camthink-ai/ne302/Docs/images/README.md

# Image Assets for README

Place the following images in this directory. See [../README.md](../README.md) for usage context.

## Required Images (12 files)

| # | Filename | README Section | Content |
|---|---|---|---|
| 1 | `mini_all_board_1.png` | Hero / Top | Product overview — Main Board + Interface Board |
| 2 | `mini_all_board_2.png` | Hardware Features | Two boards shown side-by-side |
| 3 | `mini_main_board_1.png` | Main Board | Main Board front |
| 4 | `mini_main_board_2.png` | Main Board | Main Board back |
| 5 | `mini_main_board_labeling_1.png` | Main Board | Main Board front with component callouts |
| 6 | `mini_main_board_labeling_2.png` | Main Board | Main Board back with component callouts |
| 7 | `mini_interface_board_1.png` | Interface Board | Interface Board front |
| 8 | `mini_interface_board_2.png` | Interface Board | Interface Board back |
| 9 | `mini_interface_board_labeling_1.png` | Development Interfaces | Interface Board pinout labels (N6-STLINK, U0-STLINK, U6-UART, N6-BOOT, U0-BOOT) |
| 10 | `mini_interface_board_labeling_2.png` | Storage | Interface Board TF Card, USB-C, Board Connector callouts |
| 11 | `mini_all_board_connect_3.png` | Board Assembly | Stacked boards — top view |
| 12 | `mini_all_board_connect_4.png` | Board Assembly | Stacked boards — 45° view |
