camthink-ai/ne302/Docs/NE302_v4.3.1_HTTP_API.md

# NE302 HTTP API Reference

| Item | Value |
|---|---|
| **Firmware version (APP)** | **v4.3.1.x** (build number increments per commit) |
| Document date | 2026-09-14 |
| Source | Verified against `Custom/Services/Web/` and related implementation in the current workspace; examples and latency figures taken from a reference device |

> If the firmware differs from this description, the firmware implementation prevails.

## 0. Software Version Information

| Component | Version | Notes |
|---|---|---|
| APP (main firmware) | 4.3.1.x | auto-generated in `Custom/Common/Inc/version.h` (build number = commit count since the `v4.3.1-base` tag) |
| FSBL (first-stage bootloader) | 1.0.3.1 (expected) | `EXPECTED_FSBL_VERSION_STRING`; actual compared at runtime |
| WiFi / Si91x firmware | 2.16.5.108 (expected) | `EXPECTED_WIFI_VERSION_STRING`; actual compared at runtime |
| Web assets (frontend) | 1.5.0.8 | shipped with the release bundle; query at runtime via `/device/firmware-versions` |
| AI model package | 4.0.0.0 | same |
| WakeCore | 0.2.7.5 | same |

At runtime, `GET /api/v1/device/firmware-versions` returns the **actual running versions** of every component, and `GET /api/v1/device/version-check` reports whether FSBL/WiFi firmware match what the APP expects.

---

## 1. General Conventions

### 1.1 Service & Base URL

| Item | Value |
|---|---|
| HTTP service | Mongoose, listening on **TCP port 80** |
| HTTPS | Disabled (`IS_HTTPS=0`) |
| API base path | **`/api/v1`** |
| Max request body | 5 MB (normal requests through the router) |
| Connection | `Connection: close`, one request per connection |
| Static assets | Web UI served from `/` (ETag/304/gzip supported) |

Device address:
- STA / Ethernet mode: the IP obtained by the device (check the router/AP)
- AP mode: the device hotspot gateway address (default `192.168.10.10`, subnet `192.168.10.0/24`; the built-in DHCP server allocates from `192.168.10.100`–`192.168.10.250`. Subject to actual device configuration)

**Typical latency** (reference values, reference unit at rest): ordinary read-only GETs **13–40 ms**; heavier endpoints such as `capture/queue` ≈ 0.4 s, `system/logs/export` ≈ 1.2 s (354 KB), `device/config/export` ≈ 0.1 s. The first request after an idle period may take several hundred milliseconds.

### 1.2 Authentication

- **HTTP Basic auth** per request; no sessions/cookies.
- Username is fixed to **`admin`** (`auth_mgr.h: AUTH_ADMIN_USERNAME`); the password is the device access password.
- The password can be verified via `POST /api/v1/login` and changed via `POST /api/v1/change-password`.

**Unauthenticated endpoints** (route table `require_auth=false`):

| Endpoint | Purpose |
|---|---|
| `POST /api/v1/login` | password verification |
| `POST /api/v1/preview/start` | start preview |
| `POST /api/v1/preview/stop` | stop preview |

> Note: `POST /api/v1/system/ota/upload` is intercepted by the stream processor before route dispatch and handles auth itself — see §16.2.

**Auth failure response** (normal endpoints): HTTP status is still **200** with envelope `error_code: "UNAUTHORIZED"`, `message: "Authentication required"`. The stream upload endpoints (`files/upload`, `ota/upload`) are exceptions and return a real `401`.

### 1.3 Unified Response Envelope

All endpoints routed through the router return **HTTP 200 regardless of success or failure**, with a JSON envelope:

```jsonc
// success
{
  "success": true,
  "message": "Device information retrieved successfully",   // optional
  "data": { ... }                                            // optional
}

// failure
{
  "success": false,
  "error_code": "INVALID_PASSWORD",   // present only on failure
  "message": "Invalid password"
}
```

| Field | Type | Notes |
|---|---|---|
| success | bool | business outcome |
| error_code | string | present only on failure; upper-snake-case name (see 1.5). The streamed endpoints (`files/upload`) also carry `"error_code": "NONE"` on success |
| message | string | human-readable description; may appear on success too |
| data | object/array/null | business payload; may be absent |

> **Clients must branch on the `success` field — never on the HTTP status code.**

### 1.4 Envelope Exceptions (real HTTP statuses / non-JSON)

| Endpoint | Response form |
|---|---|
| `GET /api/v1/files/download` | raw file bytes + `Content-Disposition: attachment; filename="…"`; missing file returns envelope JSON (`NOT_FOUND`) with HTTP 200 |
| `GET /api/v1/files/preview` | raw bytes for images (≤2 MB); any other file type returns a JSON envelope with the content embedded — there is no extension whitelist on preview (the whitelist applies only to `files/edit`) |
| `POST /api/v1/files/upload` | streamed; auth failure **401**, missing params 400, internal 500/503 (real statuses) |
| `POST /api/v1/system/ota/upload` | streamed; real statuses 400/401/500 |
| `POST /api/v1/system/ota/export` | raw firmware bytes + `Content-Disposition` |
| `/` static assets | SPA fallback: unknown paths return **200 + `index.html`** (no 404); re-request with the correct `ETag` returns 304 |
| `OPTIONS` preflight | 200 + CORS headers |

### 1.5 Error Codes

#### 1.5.1 Framework codes (web_server.h `api_error_code_t`)

| HTTP semantic | error_code string | Trigger |
|---|---|---|
| 400 | `INVALID_REQUEST` | missing/invalid parameters, JSON parse failure, wrong Content-Type |
| 401 | `UNAUTHORIZED` | Basic auth failure |
| 404 | `NOT_FOUND` | path not registered |
| 405 | `METHOD_NOT_ALLOWED` | method mismatch (method match is case-insensitive) |
| 500 | `INTERNAL_ERROR` | internal error |
| 503 | `SERVICE_UNAVAILABLE` | required service not running (e.g. `fs=sd` without an SD card, cellular endpoints without a modem) |

#### 1.5.2 Business codes (api_business_error.h, from 1001)

| Code | error_code string | Meaning |
|---|---|---|
| 1001 | `INVALID_PASSWORD` | invalid password |
| 1002 | `INVALID_CREDENTIALS` | invalid username or password |
| 1003 | `UNAUTHORIZED` | unauthorized |
| 1004 | `SESSION_EXPIRED` | session expired |
| 1005 | `TOKEN_INVALID` | invalid token |
| 1007 | `PERMISSION_DENIED` | permission denied |
| 1101 | `INVALID_PARAM` | invalid parameter |
| 1102 | `MISSING_PARAM` | missing required parameter |
| 1103 | `PARAM_OUT_OF_RANGE` | parameter out of range |
| 1104 | `INVALID_FORMAT` | invalid data format |
| 1201 | `DEVICE_OFFLINE` | device offline |
| 1202 | `DEVICE_BUSY` | device busy |
| 1204 | `CAMERA_ERROR` | camera error |
| 1206 | `HARDWARE_ERROR` | hardware error |
| 1301 | `NETWORK_ERROR` | network error |
| 1302 | `NETWORK_TIMEOUT` | network timeout |
| 1304 | `MQTT_NOT_CONNECTED` | MQTT not connected |
| 1305 | `WIFI_NOT_CONNECTED` | WiFi not connected |
| 1401 | `STORAGE_FULL` | storage full |
| 1403 | `FILE_NOT_FOUND` | file not found |
| 1407 | `INSUFFICIENT_SPACE` | insufficient storage space |
| 1408 | `DIR_NOT_EMPTY` | directory not empty (cannot delete) |
| 1501 | `MODEL_NOT_LOADED` | AI model not loaded |
| 1502 | `MODEL_INVALID` | invalid AI model |
| 1503 | `MODEL_RELOAD_FAILED` | model reload failed |
| 1505 | `INFERENCE_TIMEOUT` | inference timeout |
| 1601 | `CONFIG_INVALID` | invalid configuration |
| 1602 | `CONFIG_NOT_FOUND` | configuration not found |
| 1604 | `CONFIG_UPDATE_FAILED` | configuration update failed |
| 1701 | `OPERATION_TIMEOUT` | operation timeout |
| 1702 | `OPERATION_FAILED` | operation failed |
| 1705 | `OPERATION_IN_PROGRESS` | operation already in progress (busy) |
| 1706 | `AT_COMMAND_FAILED` | AT command failed (cellular modem) |
| 1801 | `FIRMWARE_INVALID` | invalid firmware |
| 1804 | `OTA_IN_PROGRESS` | OTA upgrade in progress |
| 1805 | `OTA_FAILED` | OTA upgrade failed |
| 1806 | `OTA_HEADER_VALIDATION_FAILED` | OTA/bundle header validation failed |
| 1901 | `RESOURCE_NOT_FOUND` | resource not found |
| 1902 | `RESOURCE_BUSY` | resource busy |
| 2001–2008 | `ISP_*` (see §17) | ISP business errors (2001 not initialized / 2002 invalid param / 2003 out of range / 2004 dependency / 2005 HAL / 2006 sensor / 2007 algorithm / 2008 busy) |
| 9999 | `UNKNOWN` | unknown error |

### 1.6 CORS & Preflight

All responses carry CORS headers; `OPTIONS` preflight is answered directly with 200 without entering business routing:

```
Access-Control-Allow-Origin: *
Access-Control-Allow-Methods: GET, POST, PUT, DELETE, OPTIONS
Access-Control-Allow-Headers: Content-Type, Authorization
Access-Control-Max-Age: 86400
```

### 1.7 Live Preview Stream (WebSocket, not part of the HTTP API)

The preview stream runs on a separate WebSocket service: **`ws://<device-ip>:8081/stream`** (default port 8081, path `/stream`). See [Appendix B](#appendix-b-websocket-preview-stream).

---

## 2. Endpoint Overview

15 modules, ~140 endpoints, all under `/api/v1`. All require Basic auth unless marked "no auth". All network-management endpoints are registered under the **`/api/v1/system/network/…`** prefix.

| # | Module | Prefix | Endpoints |
|---|---|---|---|
| 3 | Authentication | `/login`, `/change-password` | 2 |
| 4 | Device & system | `/device/*`, `/system/*` | 21 |
| 5 | Network | `/system/network/*` (wifi / halow / comm / cellular / poe) | 44 |
| 6 | Capture & upload | `/capture/*` | 6 |
| 7 | Live preview | `/preview/*` (no auth) | 2 |
| 8 | File management | `/files/*` | 8 |
| 9 | AI detection | `/ai/*` | 4 |
| 10 | Model management | `/model/*` | 2 |
| 11 | Work mode / power mode | `/work-mode/*`, `/power-mode/*` | 8 |
| 12 | MQTT | `/apps/mqtt/*`, `/device/capture` | 5 |
| 13 | RTMP streaming | `/apps/rtmp/*` | 5 |
| 14 | RTSP service | `/apps/rtsp/*` | 5 |
| 15 | Webhook | `/apps/webhook/*` | 6 |
| 16 | Firmware upgrade (OTA) | `/system/ota/*` | 7 |
| 17 | ISP image quality | `/isp/*` | 27 |
| — | Static assets / Web UI | `/` | — |

> The 12 HaLow endpoints are registered only when the firmware is built with HaLow enabled (`NETIF_WIFI_HALOW_IS_ENABLE`); this build has it enabled.

---

## 3. Authentication Module (auth)

### 3.1 POST /api/v1/login — verify device password

**No auth.** Used by the login page to verify the password (username is fixed `admin` and not sent).

**Request body**

| Field | Type | Required | Description |
|---|---|---|---|
| password | string | yes | device access password |

**Responses**

```jsonc
// correct password
{"success": true, "message": "Login successful"}
// wrong password, missing field or wrong JSON type
{"success": false, "error_code": "INVALID_PASSWORD", "message": "Login failed, invalid password"}
// wrong Content-Type
{"success": false, "error_code": "INVALID_REQUEST", "message": "Invalid Content-Type"}
```

### 3.2 POST /api/v1/change-password — change device password

**Request body**

| Field | Type | Required | Description |
|---|---|---|---|
| password | string | yes | new password, **8–32 characters** |

**Response data**: `null`, `message: "Password changed successfully"`.

**Notes**: takes effect immediately — subsequent requests (both login and Basic auth) must use the new password; the old password fails at once.

**Errors**: `INVALID_REQUEST` ("Invalid password length" for out-of-range length, "Missing required parameters" when absent).

---

## 4. Device & System Module (device / system)

### 4.1 GET /api/v1/device/info — device information

**Response data**

| Field | Type | Description |
|---|---|---|
| device_name | string | device name (1–63 characters, see 4.6) |
| mac_address | string | MAC address |
| serial_number | string | serial number |
| hardware_version | string | hardware version |
| software_version | string | software version (the APP firmware version) |
| camera_module | string | camera module |
| extension_modules | string | extension modules |
| power_supply_type | string | power supply type |
| battery_percent | number | battery percentage |
| communication_type | string | current communication type |
| storage_card_info | string | storage card info |
| storage_usage_percent | number | storage usage (%) |

**Example**

```json
{"success":true,"message":"Device information retrieved successfully","data":{
  "device_name":"NE302-278C51","mac_address":"44:9f:da:27:8c:51","serial_number":"SN202500001",
  "hardware_version":"1.3.0","software_version":"4.3.1.107","camera_module":"CMW_OS04C10",
  "extension_modules":"None","power_supply_type":"external_power","battery_percent":0,
  "communication_type":"wifi","storage_card_info":"No SD Card","storage_usage_percent":9}}
```

### 4.2 GET /api/v1/device/firmware-versions — component firmware versions

**Response data**

| Field | Type | Description |
|---|---|---|
| fsbl | string | actual running FSBL version |
| app | string | actual running APP version |
| web | string | web asset version |
| model | string | AI model package version |
| wakecore | string | WakeCore version |
| wifi | string | Si91x WiFi/HaLow firmware version |
| wifi_running | string | WiFi firmware running-state marker |
| expected_fsbl | string | FSBL version expected by the APP |
| expected_wifi | string | WiFi firmware version expected by the APP |

**Example**

```json
{"fsbl":"1.0.3.1","app":"4.3.1.107","web":"1.5.0.8","model":"4.0.0.0","wakecore":"0.2.7.5",
 "wifi":"2.16.5.108","wifi_running":"2.16.5.108","expected_fsbl":"1.0.3.1","expected_wifi":"2.16.5.108"}
```

### 4.3 GET /api/v1/device/version-check — FSBL/WiFi version consistency

**Response data**

| Field | Type | Description |
|---|---|---|
| fsbl_mismatch | bool | FSBL actual ≠ expected |
| wifi_mismatch | bool | WiFi firmware actual ≠ expected |
| expected_fsbl / current_fsbl | string | expected / actual FSBL version |
| expected_wifi / current_wifi | string | expected / actual WiFi firmware version |

### 4.4 GET /api/v1/device/storage — storage information

**Response data** (SD card + flash partitions)

| Field | Type | Description |
|---|---|---|
| sd_card_connected | bool | SD card present |
| total_capacity_mb / available_capacity_mb / used_capacity_mb | number | SD capacity (MB) |
| usage_percent | number | SD usage (%) |
| total_capacity_gb / available_capacity_gb / used_capacity_gb | number | SD capacity (GB) |
| cyclic_overwrite_enabled | bool | cyclic overwrite switch |
| overwrite_threshold_percent | number | overwrite threshold (%) |
| flash_fs_mounted | bool | flash filesystem mounted |
| flash_fs_error | bool | flash filesystem error |
| flash_error | string | flash error description |
| flash_total_capacity_mb / flash_available_capacity_mb / flash_used_capacity_mb | number | flash capacity (MB) |
| flash_usage_percent | number | flash usage (%) |
| flash_total_capacity_gb / flash_available_capacity_gb / flash_used_capacity_gb | number | flash capacity (GB) |
| flash_fs_type | string | flash filesystem type (littlefs) |
| status | string | storage status summary |
| primary_storage | string | primary storage (sd / flash) |

**Example** (no SD card):

```json
{"sd_card_connected":false,"total_capacity_mb":0,"available_capacity_mb":0,"used_capacity_mb":0,
 "usage_percent":0,"total_capacity_gb":0,"available_capacity_gb":0,"used_capacity_gb":0,
 "cyclic_overwrite_enabled":true,"overwrite_threshold_percent":80,"flash_fs_mounted":true,
 "flash_fs_error":false,"flash_error":"","flash_total_capacity_mb":32,"flash_available_capacity_mb":28,
 "flash_used_capacity_mb":4,"flash_usage_percent":12.5,"flash_total_capacity_gb":0.03,
 "flash_available_capacity_gb":0.03,"flash_used_capacity_gb":0.004,"flash_fs_type":"littlefs",
 "status":"normal","primary_storage":"flash"}
```

### 4.5 POST /api/v1/device/storage/format — format internal flash

**Request body**: none (any body is ignored; there is no target selection — the endpoint **always formats the internal flash LittleFS volume**).

**Response data**: `{success}` with message `"Flash formatted"` — the operation is synchronous (a few hundred ms). Formatting erases all flash files (logs, captures, uploaded assets); NVS device configuration is stored in a separate partition and is **not** affected. Afterwards the captures tree is rebuilt and record counters are reset; re-fetch `/device/storage` and `/capture/queue`.

### 4.6 POST /api/v1/device/name — rename device

**Request body**: `{device_name: string}` (**1–63 characters**; empty or oversized → `INVALID_REQUEST`).

**Response data**: `{message, device_name}`.

### 4.7 GET / POST /api/v1/device/image/config — image configuration

GET returns the current config; POST is a partial update (send only changed fields).

**Fields** (GET returns / POST optional)

| Field | Type | Range/values | Description |
|---|---|---|---|
| brightness | number | 0–100 | ⚠ **Deprecated** — accepted but not applied (see note below) |
| contrast | number | 0–100 | ⚠ **Deprecated** — accepted but not applied (see note below) |
| horizontal_flip | bool | — | horizontal flip |
| vertical_flip | bool | — | vertical flip |
| aec | number | 0–100 | ⚠ **Deprecated** — accepted but not applied (see note below) |
| isp_mode | number | 0 (outdoor) / 1 (indoor) / 255 (custom) | ISP scene mode |
| grayscale | bool | — | grayscale output |
| fast_capture_skip_frames | number | 0–300 | fast-capture skip frames |
| fast_capture_resolution | number | 0 (1280×720) / 1 (1920×1080) / 2 (2688×1520) | fast-capture resolution |
| fast_capture_jpeg_quality | number | 1–100 | fast-capture JPEG quality |
| capture_disable_comm | bool | — | pause communication during capture |
| capture_storage_ai | bool | — | store AI-overlay capture images |

**⚠ Deprecated fields**: `brightness`, `contrast` and `aec` are deprecated. Requests carrying them still succeed (the values are range-checked and echoed in the response), but the settings are **not applied and not retained** — adjusting them has no effect on the image. Use the ISP module (§17) to control exposure/contrast instead.

**Notes**: POST of `horizontal_flip`/`vertical_flip` automatically restarts the AI pipeline (stop then start); POST-then-GET to confirm the applied values is recommended.

### 4.8 GET / POST /api/v1/device/sys-clk/config — CPU clock profile

Persisted by FSBL; **takes effect after reboot**.

**GET response data**

| Field | Type | Description |
|---|---|---|
| valid | bool | whether the config read out validly |
| sys_clk_profile | number | current clock profile |

**POST request body**

| Field | Type | Required | Description |
|---|---|---|---|
| sys_clk_profile | number | yes | 1=HSE 200 MHz, 2=HSE 400 MHz, 3=HSI 800 MHz, 4=HSE 800 MHz (integer only) |

### 4.9 GET / POST /api/v1/device/light/config — fill light configuration

**GET response data**

| Field | Type | Description |
|---|---|---|
| connected | bool | fill light connected |
| mode | string | `off` / `on` / `auto` / `custom` |
| brightness_level | number | brightness 0–100 |
| fill_light_while_streaming | bool | work-time fill light mode (light on unconditionally per config while the device runs) |
| custom_schedule | object | timed-on schedule `{start_hour, start_minute, end_hour, end_minute}` |

**POST request body** (all optional)

| Field | Type | Description |
|---|---|---|
| mode | string | `off`/`on`/`auto`/`custom` |
| brightness_level | number | 0–100 |
| fill_light_while_streaming | bool | as above |
| custom_schedule | object | same as GET |

**Response data**: echoes the applied configuration.

### 4.10 POST /api/v1/system/time — set system time

**Request body**

| Field | Type | Required | Description |
|---|---|---|---|
| timestamp | number | no | UTC epoch seconds; when omitted, the current system time is retained |
| timezone | string | no | timezone name (`Asia/Shanghai`, `America/New_York`, `America/Los_Angeles`, `Europe/London`, `Europe/Paris`, `Asia/Tokyo`) or `UTC±N` |

**Response data**: `{message, utc_timestamp, local_timestamp, timezone_offset_hours, utc_time, local_time}`

**Example**

```json
{"message":"System time updated successfully","utc_timestamp":1789394898,
 "local_timestamp":1789423698,"timezone_offset_hours":8,
 "utc_time":"2026-09-14 14:08:18 UTC","local_time":"2026-09-14 22:08:18"}
```

**Notes**: the device also syncs time via SNTP/U0; the web path goes through the RTC scheduler (with step guards). Unsupported timezone names are rejected with `INVALID_REQUEST`. There is no GET on this path.

### 4.11 GET /api/v1/system/logs — read logs

**Query params**: `file` (log file name, optional, default main log `aicam.log`)

**Response data**: `{content (log text), size}`; for the file-level list see 4.12.

### 4.12 GET /api/v1/system/logs/export — export logs

**Response data**: `{log_files: [{filename, size, content}], total_files, total_size}` — the rotated set `aicam.log`, `aicam.log.1` … is returned in full (a multi-hundred-KB response; allow several seconds).

### 4.13 POST /api/v1/system/restart — restart device

**Request body**: `{delay_seconds?: number}` (default 3)

**Response data**: `{delay_seconds}` (executed asynchronously by a background task). The web service typically answers again **~25 s** after the restart (bootloader ~1 s, system bring-up ~5 s, service start thereafter).

### 4.14 GET /api/v1/device/config/export — export device configuration

**Response data**

| Field | Type | Description |
|---|---|---|
| export_version | string | export format version |
| export_timestamp | number | export timestamp |
| config | object | structured config (per module: network_service, mqtt_service, work_mode_config, power_mode_config, auth_mgr, …) |
| config_raw | string | raw config text |

`config.sys_clk_profile` (work frequency, 1–4) is attached only when the device has a real selection; a never-modified device (profile 0) omits the key.

**Example** (structure overview; `config` contains one section per service):

```json
{"export_version":"1.0","export_timestamp":1789440008,
 "config":{"config_version":1,"magic_number":"...","checksum":"...","timestamp":"...",
           "log_config":{...},"ai_debug":{...},"power_mode_config":{...},"device_info":{...}, ...}}
```

### 4.15 POST /api/v1/device/config/import — import device configuration

**Request body**: the `data` exported by 4.14 as-is (or just the `config` object).

**Response data**: `{message, config_version, timestamp, checksum, saved_to_file}` — applying and persisting a full config takes a few seconds.

**Errors**: body without `config`/`config_raw` → `INVALID_REQUEST`; `sys_clk_profile` present with anything other than an integer 0–4 (negative, fractional, out of range, or non-numeric) → `INVALID_REQUEST`.

`config.sys_clk_profile` absent or 0 keeps the device's current work frequency; 1–4 is applied through the same FSBL path as the dedicated setter (effective on next boot).

### 4.16 GET / POST /api/v1/device/preference/stream_tab — Web UI preference

**GET response data**: `{stream_tab: string}` (the stream tab remembered by the frontend)
**POST request body**: `{stream_tab: string}` — the POST response `data` is empty; verify via GET.

---

## 5. Network Module (network)

All endpoints are registered under **`/api/v1/system/network/…`**. The WiFi configuration endpoint additionally accepts the short alias `POST /system/network/wifi`.

### 5.1 GET /api/v1/system/network/status — communication overview

**Response data**

| Field | Type | Description |
|---|---|---|
| service_state | string | communication service state |
| service_version | string | service version |
| active_type | string | currently active comm type (wifi/cellular/poe/halow…) |
| selected_type | string | selected type |
| current_comm_type | string | current comm type |
| has_connection | bool | any usable connection |
| active_display_name / selected_display_name / current_comm_display_name | string | display names |
| available_comm_types | array | `[{type, display_name, is_selected, is_active, is_connected, is_current}]` |
| available_comm_count | number | number of available types |
| preferred_type | string | preferred type |
| auto_priority | bool | automatic priority selection |
| is_auto_selection | bool | automatic selection mode |
| selection_mode | string | selection mode |
| current_comm_info | object | `{status, ip_address, signal_strength, ssid?, isp?, message}` |

**Example** (abridged):

```json
{"service_state":"running","service_version":"1.0.0","active_type":"wifi","selected_type":"wifi",
 "current_comm_type":"wifi","has_connection":true,"active_display_name":"WiFi",
 "available_comm_types":[{"type":"wifi","display_name":"WiFi","is_selected":true,"is_active":true,
   "is_connected":true,"is_current":true},
  {"type":"halow","display_name":"Wi-Fi HaLow","is_selected":false,"is_active":false,
   "is_connected":false,"is_current":false}],
 "available_comm_count":2,"preferred_type":"none","auto_priority":true,"is_auto_selection":true,
 "selection_mode":"auto","current_comm_info":{"status":"Connected","ip_address":"192.168.93.95",
 "signal_strength":-45}}
```

### 5.2 GET /api/v1/system/network/wifi/sta — WiFi STA status

**Response data**: `{connected, ssid, bssid, rssi, channel, ip_address, mac_address, state, scan_results, scan_in_progress}` — the last two embed scan data with the same shape as 5.6.

**Example** (STA down): `{"connected":false,"ssid":"CAMTHINK_DEV","bssid":"00:00:00:00:00:00","rssi":0,"channel":0,"ip_address":"0.0.0.0","mac_address":"44:9F:DA:27:8C:50","state":"down","scan_results":{"known_networks":[],"known_count":0,"unknown_networks":[],"unknown_count":0},"scan_in_progress":false}`

### 5.3 GET /api/v1/system/network/wifi/info — WiFi STA link and IP details

Live link-layer data plus the full IP configuration, mirroring the PoE / cellular info endpoints. Link info comes from the wireless driver; IP values are read from the lwIP netif and resolver.

**Response data**

| Field | Type | Description |
|---|---|---|
| connected | bool | STA link up |
| ssid / bssid | string | current AP name / BSSID (`AA:BB:CC:DD:EE:FF`) |
| rssi | number | signal strength, dBm |
| channel | number | operating channel |
| security | string | e.g. `wpa2_psk` |
| ip_mode | string | `dhcp` / `static` |
| ip_address / netmask / gateway | string | live lwIP netif values |
| dns_primary / dns_secondary | string | resolver DNS servers (empty string when unset) |
| mac_address | string | STA MAC address |

> When the driver query fails only `{connected: false, error}` is returned.

**Example** (STA down): `{"connected":false,"ssid":"CAMTHINK_DEV","bssid":"00:00:00:00:00:00","rssi":0,"channel":0,"security":"wpa_wpa2_mixed","ip_mode":"dhcp","ip_address":"0.0.0.0","netmask":"0.0.0.0","gateway":"0.0.0.0","mac_address":"44:9F:DA:27:8C:50","dns_primary":"8.8.8.8","dns_secondary":"8.8.4.4"}`

### 5.4 GET /api/v1/system/network/wifi/ap — WiFi AP status

**Response data**: `{enabled, state, ip_address, mac_address, channel, ssid, password, ap_sleep_time, security}`

| Field | Description |
|---|---|
| enabled / state | AP switch / interface state (`up` / `down`) |
| ip_address | AP gateway address (default `192.168.10.10`) |
| channel | operating channel |
| ssid / password | hotspot name / password (a stored password is reported but **not applied** — see note) |
| ap_sleep_time | idle sleep time (seconds; fixed choices 0/600/1200/1800) |
| security | security type — always `open` in this firmware version |

**Example**: `{"enabled":true,"state":"up","ip_address":"192.168.10.10","mac_address":"44:9F:DA:27:8C:51","channel":6,"ssid":"NE302_278C51","password":"","ap_sleep_time":0,"security":"open"}`

> The AP password is returned in clear text (no masking on the device side).
>
> **The hotspot no longer supports a password in this firmware version** — it always runs open (WiFi-chip firmware limitation: with a password set on the AP, the STA can no longer connect to networks). A password saved on an older firmware is still stored and echoed here, but it is not applied; the web UI no longer exposes a hotspot password field.

### 5.5 POST /api/v1/system/network/wifi/config — configure and connect WiFi

Alias: `POST /system/network/wifi`.

**Request body**

| Field | Type | Required | Description |
|---|---|---|---|
| interface | string | no | `ap` (configure the hotspot) / `wl` (connect as STA), default STA |
| ssid | string | yes | SSID, 1–31 chars |
| password | string | yes | password, 8–63 chars. STA: connection credential. AP: accepted and stored but **not applied** — the hotspot always runs open in this firmware version |
| bssid | string | no | pin a specific BSSID |
| ap_sleep_time | number | no | AP idle sleep time: only 0 (never) / 600 / 1200 / 1800 s allowed (when interface=ap) |
| use_saved_password | bool | no | connect with the saved password |

**Response data**: `{message, interface, ssid, ap_sleep_time}` (connection is async; poll 5.1/5.2)

**Measured**: connecting to a router with an explicit password takes ~3.5 s and **saves the network**; afterwards `{ssid, use_saved_password: true}` reconnects directly (~3.5 s) without sending the password again.

**Errors**: when the STA cannot be brought up (e.g. no usable saved credential for that SSID) the call fails after ~6–7 s with `NETWORK_TIMEOUT` ("Failed to configure WiFi interface"). Connecting to another NE302's hotspot is discouraged — both devices default their AP subnet to `192.168.10.0/24` and will conflict.

### 5.6 POST /api/v1/system/network/wifi/scan — scan WiFi

**Request body**: empty JSON or `{}` (may include `force`)

**Response data**: acknowledgment of the scan trigger (message only). Scan results are **not** returned by this endpoint — poll `GET /system/network/wifi/sta` (5.2) and read its `scan_results` / `scan_in_progress` fields (complete a few seconds after the trigger).

| Field | Type | Description |
|---|---|---|
| scan_results | object | in the `wifi/sta` response: `{known_networks[], unknown_networks[], known_count, unknown_count}` |
| scan_in_progress | bool | in the `wifi/sta` response: scan running |

Scan entry fields:

| Field | Description |
|---|---|
| ssid / bssid | SSID / BSSID |
| rssi | signal strength |
| channel | channel |
| security | security type (open/wpa2…) |
| connected | currently connected |
| is_known / quick_connect | saved / quick-connect capable |
| last_connected_time | last connected timestamp |

### 5.7 POST /api/v1/system/network/wifi/disconnect — disconnect WiFi

**Request body**: `{interface: "wl"}`. Response `data:{message, interface, if_name, status}`

**Example**: `{"message":"WiFi interface disconnected successfully","interface":"wl","if_name":"wl","status":"disconnected"}`

### 5.8 POST /api/v1/system/network/wifi/delete — delete a saved network

**Request body**: `{ssid}` (interface optional). Response `data:{status, message}`

### 5.9 GET /api/v1/system/network/wifi/region — WiFi region code

**Response data**: `{region, active_region, supported_regions[]}` (only us/eu/jp/kr/cn are valid)

**Example**: `{"region":"us","active_region":"us","supported_regions":["us","eu","jp","kr","cn"]}`

### 5.10 PUT /api/v1/system/network/wifi/region — set WiFi region code

**Request body**: `{region}`. **Response data**: `{region, restart_required, message}`

**Example**: `{"region":"us","restart_required":true,"message":"WiFi region saved, applies on next restart"}`

### 5.11 HaLow group (`/api/v1/system/network/halow/*`, 12 endpoints)

| Endpoint | Method | Description |
|---|---|---|
| /api/v1/system/network/halow/sta | GET | HaLow STA state: `{connected, ssid, bssid, rssi, channel, ip_address, netmask, gateway, ip_mode, mac_address, state, region, supported_regions[], scan_results, scan_in_progress}` |
| /api/v1/system/network/halow/info | GET | link/IP details (as 5.3) |
| /api/v1/system/network/halow/region | GET | `{region, supported_regions[]}` |
| /api/v1/system/network/halow/region | PUT | `{region}` → `{region, message, scan_required}` |
| /api/v1/system/network/halow/scan | POST | trigger a scan — message `"HaLow scan started"`, async; results appear in the `scan_results` of `GET halow/sta`. Note: by design HaLow and PoE are mutually exclusive — bringing up the HaLow radio (even for a scan) deactivates the PoE data interface; after disconnecting HaLow, reboot the device to re-create the PoE interface |
| /api/v1/system/network/halow | POST | connect: `{ssid, password?, bssid?, security?, region?, use_saved_password?}` → `{message:"HaLow connected successfully", interface, ssid}` (~7 s measured; DHCP address, e.g. 192.168.12.x). With the password supplied the credentials are **saved and auto-reconnected on every boot** (keeping PoE muxed away while the HaLow AP is reachable). Without a password or usable saved credentials → `INVALID_REQUEST "Saved credentials not available for this network"` |
| /api/v1/system/network/halow/disconnect | POST | `{message, interface: "halow", status: "disconnected"}` (idempotent while idle). Disconnecting does **not** by itself restore PoE — a reboot is required |
| /api/v1/system/network/halow/delete | POST | `{ssid}` delete a saved network → `{status: "deleted", message: "HaLow network cleared"}` (reports success even for unknown SSIDs). Deleting the last saved network leaves the HaLow interface unconfigured — the driver logs `invalid wireless cfg (ssid='')` at boot and the interface stays down until a new network is configured (other services are unaffected) |
| /api/v1/system/network/halow/ip | GET/POST | IP configuration: `{ip_mode(dhcp/static), ip_address, netmask, gateway}`; POST echoes the config + `"HaLow IP configuration updated"` |
| /api/v1/system/network/halow/radio | GET/PUT | radio parameters (below) |

**`sta` response fields**

| Field | Type | Description |
|---|---|---|
| connected | bool | HaLow STA link up |
| ssid / bssid | string | AP name / BSSID (last associated while down) |
| rssi | number | signal strength (dBm); 0 while disconnected |
| channel | number | operating channel |
| ip_address / netmask / gateway | string | live IP configuration |
| ip_mode | string | `dhcp` / `static` |
| mac_address | string | HaLow interface MAC |
| state | string | driver state, e.g. `disconnected` |
| region | string | current region code (`us`, `eu`, …) |
| supported_regions | string[] | valid region codes |
| scan_results | object | `{known_networks[], unknown_networks[], known_count, unknown_count}` — entry fields as in 5.6 |
| scan_in_progress | bool | scan running |

**`radio` fields** (GET returns / PUT accepts, PUT fields all optional)

| Field | Type | Range | Description |
|---|---|---|---|
| tx_power_dbm | number | 0–36 | transmit power (dBm) |
| scan_dwell_ms | number | 15–300 (default 30) | per-channel scan dwell time (ms) |
| rate_mcs | number | −1–9 | MCS rate index; −1 = auto |
| rate_bw_mhz | number | −1 / 1 / 2 / 4 / 8 | channel bandwidth (MHz); −1 = auto |
| rate_gi | number | −1–1 | guard interval; −1 = auto |
| ps_mode | number | 0 / 1 | power-save switch |
| limits | object | — | read-only bounds: `{tx_power_dbm:{min,max}, scan_dwell_ms:{min,max,default}}` |

**Example** (`GET sta`, link down):

```json
{"connected":false,"ssid":"halowlink1-0be3","bssid":"60:FF:9E:5F:C7:1A","rssi":0,"channel":0,
 "ip_address":"192.168.12.199","netmask":"255.255.255.0","gateway":"192.168.12.1","ip_mode":"dhcp",
 "mac_address":"00:00:00:00:00:00","state":"disconnected","region":"us",
 "supported_regions":["au_2020","au_2024","au_revmf","ca","eu","in","jp","kr","nz","us"],
 "scan_results":{"known_networks":[...],"unknown_networks":[],"known_count":1,"unknown_count":0},
 "scan_in_progress":false}
```

**`info` response** — same field set as `wifi/info` (5.3), carrying the **last association's** values while disconnected (e.g. `security`, `ip_address` of the previous link; live values once connected). `region` GET returns `{region, supported_regions[]}` (no `active_region`, unlike `wifi/region`).

> `ps_mode` is the power-save switch. HaLow and PoE are hardware-mutually-exclusive (EXTI15); switching is coordinated automatically by the communication service — no need to down the other side manually. Switching the comm type to HaLow while it is unavailable is rejected immediately, and a connect attempt without credentials returns before touching the radio (no impact on an active PoE link).

### 5.12 Communication type group (`/api/v1/system/network/comm/*`, 2 endpoints)

| Endpoint | Method | Description |
|---|---|---|
| /api/v1/system/network/comm/types | GET | full type list — response fields and example below |
| /api/v1/system/network/comm/switch | POST | `{type}` (wifi/cellular/poe/halow) switch, **blocking up to 30 s** → `{success, from_type, to_type, switch_time_ms, error?}`; switching to an unavailable type is rejected immediately. ⚠ Switching **away from the active comm type takes down the interface the request arrived on** — expect the HTTP request itself to time out; issue the switch from another interface (e.g. the AP) or simply poll `/system/network/status` afterwards |

Examples:

```json
// poe -> poe (no-op)
{"success":true,"from_type":"poe","to_type":"poe","switch_time_ms":1}
// cellular -> poe (recovery path, issued via the AP interface)
{"success":true,"from_type":"cellular","to_type":"poe","switch_time_ms":1110}
```

**`comm/types` response fields**

| Field | Type | Description |
|---|---|---|
| current_type | string | active comm type |
| preferred_type | string | preferred type (`none` when unset) |
| auto_priority | bool | automatic priority selection |
| types | array | one entry per comm type — see below |
| available_types | string[] | names of the currently available types |
| type_count | number | total entries in `types` |
| current_type_info | object | `{type, status, ip_address, signal_strength}` (+ `ssid`/`isp`/`network_type`/`csq`/`signal_level` where applicable) |

**`types[]` entry fields**

| Field | Type | Description |
|---|---|---|
| type | string | `wifi` / `cellular` / `poe` / `halow` |
| status | string | display status (`Connected` / `Disconnected` / `Unavailable`) |
| available / connected / is_current | bool | hardware available / link up / currently active |
| can_switch | bool | switching to this type currently allowed |
| ip_address | string | current IP (empty while down) |
| signal_strength | number | signal strength |
| priority | number | selection priority |
| display_name | string | UI display name |
| detail | object | type-specific extras: wifi/halow `{ssid?, rssi?, channel?, interface?}`, cellular `{imei?, apn?, isp?}` |

**Example** (abridged):

```json
{"current_type":"poe","preferred_type":"none","auto_priority":true,
 "types":[
   {"type":"wifi","status":"Disconnected","available":true,"connected":false,"can_switch":true,
    "is_current":false,"ip_address":"","signal_strength":0,"priority":1,"display_name":"WiFi",
    "detail":{"ssid":"CAMTHINK_DEV","rssi":0,"channel":0}},
   {"type":"poe","status":"Connected","available":true,"connected":true,"can_switch":false,
    "is_current":true,"ip_address":"192.168.93.95","signal_strength":0,"priority":4,
    "display_name":"PoE/Ethernet","detail":{"interface":"wn"}}],
 "available_types":["wifi","poe"],"type_count":4,
 "current_type_info":{"type":"poe","status":"Connected","ip_address":"192.168.93.95","signal_strength":0}}
```

### 5.13 Cellular group (`/api/v1/system/network/cellular/*`, 8 endpoints)

| Endpoint | Method | Description |
|---|---|---|
| /api/v1/system/network/cellular/status | GET | `{available, status, message}`; with a modem present also `imei` and the `settings` object below |
| /api/v1/system/network/cellular/info | GET | modem details — `{network_status, sim_status, model, version, imei, imsi, iccid, isp, network_type, register_status, plmn_id, lac, cell_id, signal_level, csq, csq_level, rssi, ipv4_address, ipv4_gateway, ipv4_dns, ipv6_address, ipv6_gateway, ipv6_dns, connection_duration_sec, error?}`; without a modem → `SERVICE_UNAVAILABLE` |
| /api/v1/system/network/cellular/settings | GET/POST | the `settings` object below; POST fields all optional |
| /api/v1/system/network/cellular/connect | POST | dial up → `{success, status}` (returns the current modem data-call state) |
| /api/v1/system/network/cellular/disconnect | POST | disconnect → `{success, status}` |
| /api/v1/system/network/cellular/refresh | POST | refresh modem state → `{success, status}` |
| /api/v1/system/network/cellular/at | POST | send a raw AT command: `{command}` → `{success, response}`; ~5 s per command. ⚠ Requires the data call to be **disconnected** first (`cellular/disconnect`) — while connected the command fails. Failure returns `AT_COMMAND_FAILED` (1706). The `command` echo field in the response is unreliable |

**Example**: `POST {"command":"AT+CSQ"}` (data call disconnected) → `data:{"success":true,"command":"AT+CSQ","response":"+CSQ: 19,99\nOK"}`

**`settings` fields** (returned in `status`, exchanged via `settings`; POST fields all optional)

| Field | Type | Description |
|---|---|---|
| apn | string | APN |
| username / password | string | PDP authentication credentials |
| pin_code | string | SIM PIN |
| authentication | string | authentication method |
| enable_roaming | bool | allow roaming |
| operator | string | pinned operator name |
| plmn | string | PLMN id |

**Notes**: the modem is initialized lazily — a freshly booted device may report `available:false` until `POST .../cellular/refresh` is called once; after refresh, `status`/`info`/`settings` return the full data (modem model, SIM, registration, signal and IP). Switching the comm type to cellular does not disturb an active PoE link.

**Example** (`info`, LTE registered):

```json
{"network_status":"Unavailable","sim_status":" READY","model":"EG915Q-NA",
 "version":"EG915NALCR01A07M04","imei":"867507069225825","imsi":"460115211251037",
 "iccid":" 89860324245920230993","isp":"CHN-CT","network_type":"FDD LTE",
 "register_status":"Registered (Home network)","plmn_id":"46011","lac":"5F0C","cell_id":"E6D915",
 "signal_level":2,"csq":18,"csq_level":2,"rssi":-77,"ipv4_address":"10.84.97.121",
 "ipv4_gateway":"10.64.64.64","ipv4_dns":"8.8.8.8","ipv6_address":"","ipv6_gateway":"",
 "ipv6_dns":"","connection_duration_sec":0}
```

### 5.14 PoE group (`/api/v1/system/network/poe/*`, 8 endpoints)

| Endpoint | Method | Description |
|---|---|---|
| /api/v1/system/network/poe/status | GET | `{available, status, ip_address, connected}` |
| /api/v1/system/network/poe/info | GET | link details — field table and example below |
| /api/v1/system/network/poe/config | GET | configuration — field table and example below |
| /api/v1/system/network/poe/config | POST | same fields, all optional → `{message, ip_mode}` |
| /api/v1/system/network/poe/connect | POST | `{success, status}` |
| /api/v1/system/network/poe/disconnect | POST | `{success, status}` |
| /api/v1/system/network/poe/validate | POST | validate the current network config: `{ip_conflict, gateway_reachable, valid, errors[], warnings[]}` — note the checker can report `valid:false` with a generic "Invalid IP address" error on a working static link; treat it as advisory |
| /api/v1/system/network/poe/apply · /save | POST | apply/save config → `{success, status, ip_mode}` |

**Example** (`validate`, working static link): `{"ip_conflict":false,"gateway_reachable":true,"valid":false,"errors":["Invalid IP address"],"warnings":[]}`

> `poe/disconnect` tears down the interface the request arrives on, so the HTTP call itself typically times out — the device stays reachable on the AP interface (or via `poe/connect`, which returns `{success, status:"Connected"}` and restores the link within seconds). `poe/config` POST with unchanged values is non-disruptive.

**`poe/info` response fields**

| Field | Type | Description |
|---|---|---|
| available | bool | PoE interface present |
| network_status | string | display status |
| status_code | number | numeric link status |
| status_message | string | status text |
| ip_mode | string | `dhcp` / `static` |
| ip_address / netmask / gateway | string | live IP configuration |
| dns_primary / dns_secondary | string | DNS servers |
| hostname | string | DHCP hostname |
| mac_address | string | interface MAC |
| interface_name | string | internal interface name (`wn`) |
| link_up / poe_powered | bool | link state / PoE power present |
| connection_duration_sec / connection_start_time | number | current connection timing |
| dhcp_lease_time / dhcp_lease_remaining | number | DHCP lease (seconds) |
| connect_count / disconnect_count / dhcp_fail_count | number | event counters |
| last_error_code | number | last driver error code |

**Example**

```json
{"available":true,"network_status":"Connected","status_code":3,"status_message":"connected",
 "ip_mode":"static","ip_address":"192.168.93.95","netmask":"255.255.255.0","gateway":"192.168.93.1",
 "dns_primary":"8.8.8.8","dns_secondary":"8.8.4.4","hostname":"","mac_address":"D8:7A:72:0D:E5:55",
 "interface_name":"wn","link_up":true,"poe_powered":true,"connection_duration_sec":0,
 "connection_start_time":0,"dhcp_lease_time":0,"dhcp_lease_remaining":0,"connect_count":0,
 "disconnect_count":0,"dhcp_fail_count":0,"last_error_code":0}
```

**`poe/config` fields** (GET returns / POST accepts, POST fields all optional)

| Field | Type | Description |
|---|---|---|
| ip_mode | string | `dhcp` / `static` |
| ip_address / netmask / gateway | string | static IP settings (used when `ip_mode=static`) |
| dns_primary / dns_secondary | string | DNS servers |
| hostname | string | DHCP hostname |
| dhcp_timeout_ms | number | DHCP timeout (ms) |
| dhcp_retry_count | number | DHCP retry count |
| dhcp_retry_interval_ms | number | DHCP retry interval (ms) |
| power_recovery_delay_ms | number | delay before reconnect after a power event (ms) |
| auto_reconnect | bool | automatic link recovery |
| persist_last_ip | bool | reuse the last obtained IP |
| validate_gateway | bool | gateway reachability check |
| detect_ip_conflict | bool | IP conflict detection |

---

## 6. Capture & Upload Module (capture)

### 6.1 GET / POST /api/v1/capture/upload-config — capture/upload configuration

**GET response data / POST request body** (POST fields all optional, partial update)

| Field | Type | Values | Description |
|---|---|---|---|
| version | number | — | config version (read-only) |
| mode | string | `instant` / `batch` / `scheduled` / `local_only` | upload mode |
| storage | string | `auto` / `flash` / `sd` / `none` | capture storage location (`auto` resolves by card presence; see `actual_fs` in 6.2) |
| policy | string | `wrap` (cyclic overwrite) / `stop` (stop writing) | full-disk policy |
| upload_protocol | string | `mqtt` / `webhook` | upload channel |
| retry_enable | bool | — | enable automatic retries; when disabled, the first failure becomes terminal |
| retry_max_attempts | number | ≥0 | max upload retries; `0` means unlimited when retries are enabled |
| batch_count | number | — | batch size |
| schedule_minutes | number[] | 0–1439 | scheduled upload times as minutes after midnight |
| keep_sent_hours | number | — | retention of sent records (hours) |
| max_pending_records | number | — | pending record cap (SD) |
| flash_max_records | number | — | flash record cap |
| upload_network | string | — | restrict upload network |

**Constraint**: `storage=none` requires `mode=instant` (otherwise `INVALID_REQUEST`).

**POST response data**: `{success}`.

**Example** (GET)

```json
{"version":1,"mode":"instant","storage":"auto","policy":"wrap","upload_protocol":"mqtt",
 "retry_enable":false,"retry_max_attempts":0,"batch_count":2,"schedule_minutes":[],
 "keep_sent_hours":0,"max_pending_records":200,"flash_max_records":32,"upload_network":"default"}
```

### 6.2 GET /api/v1/capture/queue — upload queue status

**Response data**

| Field | Type | Description |
|---|---|---|
| mode / storage | string | current mode/storage |
| initialized / running | bool | queue service state |
| storage_full | bool | capacity flag |
| actual_fs | string | actually active filesystem |
| pending_count | number | pending count |
| sent_count | number | sent count |
| failed_count | number | failed count |
| local_count | number | local-only count |
| bytes_used_kb / bytes_available_kb | number | capacity |
| next_scheduled_at | number | next scheduled upload timestamp |

**Example**

```json
{"mode":"instant","storage":"auto","initialized":true,"running":true,"storage_full":false,
 "actual_fs":"flash","pending_count":0,"sent_count":45,"failed_count":0,"local_count":0,
 "bytes_used_kb":3240,"bytes_available_kb":95064,"next_scheduled_at":0}
```

### 6.3 GET /api/v1/capture/records — query capture records

**Query params**

| Param | Description |
|---|---|
| state | filter by state (pending/sent/failed/local); **defaults to `pending` when omitted** |
| offset / limit | pagination, limit ≤ 200 (default 50) |
| from / to | timestamp range |
| sort | sort order |

**Response data**: `{state, offset, limit, total, records:[{id, state, timestamp, size, retry_count, trigger, last_error, has_inference}]}`

**Example record**

```json
{"id":"cap_1789395766_00002","state":"sent","timestamp":1789395766,"size":231867,
 "retry_count":0,"trigger":"web","last_error":"","has_inference":false}
```

`trigger` values include `web` (API-initiated) and `rtc` (scheduled/triggered).

`total` is a pagination **lower bound**, not always a full filtered count. The implementation fetches one lookahead record: on the last page, `total = offset + records.length` and is exact; if more records exist, `total = offset + records.length + 1`. Clients should use it only to decide whether another page may exist.

`has_inference` means the record metadata contains a non-empty `inference_image` path. It does **not** stat or validate that file, so `true` does not guarantee that the inference image still exists or can be opened.

### 6.4 POST /api/v1/capture/records/retry — retry failed records

**Request body**: `{id}` (single), `{ids:[...]}` (batch), or `{all:true}` (all failed records)

**Response data**: `{reset_count}`

### 6.5 POST /api/v1/capture/records/delete — batch-delete records

**Request body**: `{ids:[...]}`

**Response data**: `{deleted_count}`

### 6.6 POST /api/v1/device/capture — manual capture (MQTT upload)

Implemented by the MQTT module — see §12.5.

---

## 7. Live Preview Module (preview, no auth)

### 7.1 POST /api/v1/preview/start — start preview

**Request body**: empty. Starts the video pipeline (the AI pipeline is pulled up automatically).

**Response data**: `{success, status, pipeline_running, hub_subscribers}`

### 7.2 POST /api/v1/preview/stop — stop preview

**Request body**: empty (the stream actually stops only when there are no subscribers).

**Response data**: `{success, status, pipeline_running}`

> The preview frames themselves are consumed via WebSocket `ws://<ip>:8081/stream` — see [Appendix B](#appendix-b-websocket-preview-stream).

---

## 8. File Management Module (files)

Every endpoint takes the query parameter **`fs`** (`flash` / `sd`, default `flash`). Without an SD card, `fs=sd` calls return `SERVICE_UNAVAILABLE` ("SD card not available").

### 8.1 GET /api/v1/files/list — list a directory

**Query params**: `fs`, `path` (directory path)

**Response data**: `{fs, path, entries:[{name, type(file/dir), size, mtime}], count}` — `mtime` is always 0 (littlefs keeps no mtime). When the directory cannot be opened, `entries` is empty and an `error` string is included.

**Examples**

```json
// existing directory
{"fs":"flash","path":"/api_test","count":2,
 "entries":[{"name":"blob10k.bin","type":"file","size":10240,"mtime":0},
            {"name":"hello.txt","type":"file","size":0,"mtime":0}]}
// directory that cannot be opened (soft success)
{"fs":"flash","path":"/api_test","entries":[],"error":"Failed to open directory"}
```

### 8.2 GET /api/v1/files/download — download a file (envelope exception)

**Query params**: `fs`, `path` (path including the file name, required)

**Response**: raw file bytes (streamed in 8 KB chunks) with `Content-Type: application/octet-stream` and `Content-Disposition: attachment; filename="…"`. Missing files return envelope JSON (`NOT_FOUND`) with HTTP 200.

### 8.3 GET /api/v1/files/preview — preview a file

**Query params**: `fs`, `path`

**Response**:
- Image (≤2 MB): raw bytes with an image Content-Type
- Other files (≤ size cap): envelope JSON `data:{filename, mime_type, size, content}` (no extension whitelist)
- Too large: `data:{too_large: true, file_size, max_preview_size}`

### 8.4 POST /api/v1/files/upload — upload a file (streamed, envelope exception)

**Note: the request body is raw bytes (not multipart).**

| Item | Description |
|---|---|
| Query params | `fs`, **`path` (target directory, required)**, **`filename` (file name, required)** — the target is given as directory + file name, two separate params |
| Request body | raw file bytes |
| Size cap | 16 MB |
| Auth | verified by the stream interceptor itself; **failure returns a real 401** |
| Other errors | 400 (params) / 500 / 503, real HTTP statuses |

**Response**: envelope JSON (success carries `"error_code":"NONE"`), `data:{path, size}`.

### 8.5 POST /api/v1/files/create — create a file/directory

**Request body**: `{fs?, path (directory), name, type: "file"|"dir"}` — `path` and `name` are separate required fields; the created file is **empty** (write content afterwards with 8.8 `files/edit`).

**Response data**: `{fs, path (full path incl. name), name, type}`.

### 8.6 DELETE /api/v1/files — delete a file/directory

**Query params**: `fs`, `path`, `recursive?("true")` — `recursive=true` deletes a non-empty directory tree.

**Response data**: `{fs, path, filename, deleted}` (deleting a non-empty directory without `recursive` returns `DIR_NOT_EMPTY` 1408)

### 8.7 PUT /api/v1/files/rename — rename/move

**Request body**: `{fs?, old_path, new_path}`
**Response data**: `{fs, old_path, new_path}`

### 8.8 PUT /api/v1/files/edit — edit a text file

**Request body**: `{fs?, path, content}` (extension must be in the text whitelist — `.bin` and similar are rejected with `INVALID_REQUEST "Only text-based files can be edited"`)
**Response data**: `{fs, path, size}`

---

## 9. AI Detection Module (ai)

### 9.1 GET /api/v1/ai/status — AI status

**Response data**

| Field | Type | Description |
|---|---|---|
| ai_enabled | bool | AI master switch |
| model | object | model metadata: `{name, description, author, postprocess_type, input_data_type, output_data_type, color_format, version, created_at, stedgeai_version, input_width, input_height, input_channels, model_size, status(loaded/not_loaded)}` — the default YOLOv8-nano model takes a 256×256×3 RGB input |
| pipeline | object | `{status: "running"/"stopped"}` |

**Example** (abridged):

```json
{"ai_enabled":true,
 "model":{"name":"YOLOv8 Nano Object Detection Model","author":"CamThink",
          "postprocess_type":"pp_od_yolo_v8_u1","input_data_type":"uint8","output_data_type":"float32",
          "color_format":"RGB888_YUV444_1","version":"1.0.0","stedgeai_version":"v4.0.1",
          "input_width":256,"input_height":256,"input_channels":3,"model_size":3247208,
          "status":"loaded"},
 "pipeline":{"status":"stopped"}}
```

### 9.2 POST /api/v1/ai/toggle — AI on/off

**Request body**

| Field | Type | Required | Description |
|---|---|---|---|
| ai_enabled | bool | yes | **must be an explicit boolean**; a missing or non-boolean value is treated as `true` |

**Response data**: `null`, `message: "AI inference status updated successfully"`

### 9.3 GET / POST /api/v1/ai/params — AI parameters

**GET response data**: `{nms_threshold, confidence_threshold, overlay_results, inference_interval_ms, descriptions:{...per-field descriptions}}` — thresholds are integer percentages **0–100**.

**Example**

```json
{"nms_threshold":50,"confidence_threshold":50,"overlay_results":true,"inference_interval_ms":0,
 "descriptions":{"nms_threshold":"Non-Maximum Suppression threshold (0-100)",
                 "confidence_threshold":"AI confidence threshold (0-100)",
                 "overlay_results":"Draw AI results onto encoded video frames",
                 "inference_interval_ms":"AI inference pacing interval in ms (0 = every frame, or a positive value)"}}
```

**POST request body** (all optional)

| Field | Type | Description |
|---|---|---|
| nms_threshold | number | NMS threshold, 0–100 |
| confidence_threshold | number | confidence threshold, 0–100 |
| overlay_results | bool | overlay results onto captured images |
| inference_interval_ms | number | inference interval (ms); `0` is rejected while telemetry is enabled |

**POST response data**: per-field status `{<field>: "updated"/"invalid_range", current_<field>: <value>, errors:[], updated:[...]}`; range violations produce envelope `success:false, INVALID_REQUEST` with the per-field detail still in `data`.

---

## 10. Model Management Module (model)

### 10.1 POST /api/v1/model/validation/upload — model dry-run validation (multipart)

Runs one inference on uploaded images and returns the annotated result. The request is `multipart/form-data` with **8 parts** — two files plus their metadata:

| Part | Kind | Description |
|---|---|---|
| ai_image | file (JPEG) | image fed to the AI model — **must match the model input size exactly** (256×256 for the default model; see `model.input_width/input_height` in 9.1) |
| ai_image_width | text | its width in pixels |
| ai_image_height | text | its height in pixels |
| ai_image_quality | text | its JPEG quality |
| draw_image | file (JPEG) | base image for overlay drawing |
| draw_image_width | text | its width in pixels |
| draw_image_height | text | its height in pixels |
| draw_image_quality | text | its JPEG quality |

Missing metadata parts or an `ai_image` that does not match the model input size fail the hardware JPEG decode → `INTERNAL_ERROR "AI inference failed"`.

**Response data**

```jsonc
{
  "processing_time_ms": 431,
  "output_image_size": 43059,
  "ai_result": {"type":1, "detections":[], "detection_count":0, "poses":[], "pose_count":0, "type_name":"object_detection"},
  "output_image": "<base64 JPEG with detections drawn>"
}
```

### 10.2 POST /api/v1/model/reload — reload the AI model

**Request body**: empty. Restarts the pipeline only if the stream hub has subscribers.

**Response**: success `message: "Model reload completed successfully"`; failure `MODEL_RELOAD_FAILED` (1503)

---

## 11. Work Mode / Power Mode (work-mode / power-mode)

### 11.1 GET /api/v1/work-mode/status — work-mode status

**Response data**: `{current_mode, configuration:{image_mode:{enable}, video_stream_mode:{enable, rtsp_server_url}}}` — trigger settings are exposed separately via `/work-mode/triggers` (11.3).

**Example**: `{"current_mode":"image","configuration":{"image_mode":{"enable":true},"video_stream_mode":{"enable":false,"rtsp_server_url":"rtsp://server.example.com/live"}}}`

### 11.2 POST /api/v1/work-mode/switch — switch work mode

**Request body**: `{mode: "image" | "video_stream"}`

**Response**: `{"success": true, "message": "Work mode switched successfully"}` (message only, no `data`).

### 11.3 GET /api/v1/work-mode/triggers — full trigger configuration

**Response data** — top-level groups `timer_trigger`, `pir_trigger`, `remote_trigger`:

| Field | Type | Description |
|---|---|---|
| timer_trigger | object | see the field table below |
| pir_trigger | object | `{enable, pin_number, trigger_type(rising_edge/falling_edge/both_edges/high_level/low_level), sensitivity_level(10–255), ignore_time_s(0–15), pulse_count(1–4), window_time_s(0–3), disable_in_preview}` |
| remote_trigger | object | `{enable}` |

**Example**

```json
{"timer_trigger":{"enable":false,"capture_mode":"interval","interval_sec":60,"time_node_count":0,
                  "time_node":[],"weekdays":[],"interval_mode":"normal","start_time":"00:00","end_time":"00:00"},
 "pir_trigger":{"enable":false,"trigger_type":"rising_edge","sensitivity_level":30,"ignore_time_s":7,
                "pulse_count":2,"window_time_s":0,"disable_in_preview":true},
 "remote_trigger":{"enable":false}}
```

**timer_trigger fields**:

| Field | Type | Description |
|---|---|---|
| interval_mode | string | `normal` = plain interval; `scheduled` = daily timetable |
| interval_sec | number | lattice step, `1..86399` (strictly under 24 h) when `enable` + `capture_mode=interval`; otherwise `400` |
| start_time | string (GET); string or number (POST) | scheduled mode daily-window start. GET emits `HH:MM` at minute precision; POST accepts `HH:MM` or seconds since local midnight (`0..86399`), and omission preserves the stored value (start/end belong to the scheduled window; a normal-mode save must not reset them) |
| end_time | string (GET); string or number (POST) | scheduled mode daily-window end. GET emits `HH:MM` at minute precision; POST accepts `HH:MM` or seconds since local midnight (`0..86399`), and omission preserves the stored value. The window is `[start_time, end_time]` (**end time included**: a node landing exactly on the end fires — e.g. 08:00–08:10 with a 5min interval yields 08:00, 08:05 and 08:10). Must differ from `start_time` (the equal pair is reserved for the normal-mode lattice). **A full-day window is any start T with end T−1min** (the grid is anchored at T and restarts there daily — e.g. 00:00–23:59, 01:00–00:59). `00:00` (with start > `00:00`) ends the window at midnight; an end earlier than the start wraps past midnight (e.g. 20:00→06:00). The window must hold at least two nodes (i.e. be longer than `interval_sec`); otherwise `400`. After the day's last node the next capture is the next window start |
| anchor | string (GET); string or number (POST) | normal interval-mode time-of-day grid anchor (no date component). GET emits `HH:MM` at minute precision and omits it while unset; POST accepts `HH:MM` or seconds since local midnight (`0..86399`), and omission preserves the stored value (first enable stamps the current time-of-day if still unset). Rolling window `[anchor, anchor+24h)`: nodes are `anchor + n × interval_sec` **flowing continuously past midnight** (anchor 11:00, interval 5 h → 11:00 16:00 21:00 02:00 07:00, all one window); the grid **restarts only at the next anchor instant** (never 12:00), midnight does not reset it; wakes/reboots never re-base the grid. `00:00` cannot be stored explicitly (it is the unset sentinel) |
| next_capture_at | number | GET-only and omitted when no next node exists; next capture node as Unix seconds, from the same grid math the scheduler uses. A POST value is ignored |
| capture_mode | string | `none` / `interval` / `once` |
| time_node / time_node_count | array / number | up to 10 × `HH:MM` timetable nodes |
| weekdays | array | active weekdays |

### 11.4 POST /api/v1/work-mode/triggers — configure triggers

**Request body**: trigger objects (`timer_trigger`/`pir_trigger`/`remote_trigger`) all optional, fields as in 11.3.

**Semantics**:
- a present object is partially updated by the fields it carries; **a present object without an `enable` field is DISABLED**
- absent objects are untouched
- POST then GET again to confirm the actually applied values

### 11.5 POST /api/v1/work-mode/video-stream/config — video-stream mode config

**Request body**: `{enable: bool, rtsp_server_url: string}`

### 11.6 GET /api/v1/power-mode/status — power-mode status

**Response data**: `{current_mode, configuration:{current_mode, default_mode, low_power_timeout_ms, last_activity_time, mode_switch_count}}`

**Example**: `{"current_mode":"full_speed","configuration":{"current_mode":"full_speed","default_mode":"low_power","low_power_timeout_ms":60000,"last_activity_time":1789395991780,"mode_switch_count":5}}`

### 11.7 POST /api/v1/power-mode/switch — switch power mode

**Request body**: `{mode: "low_power" | "full_speed"}`

**Response**: `{"success": true, "message": "Power mode switched successfully"}` (message only, no `data`). Always confirm the resulting mode via `GET /power-mode/status` — the handler does not validate unknown mode strings.

---

## 12. MQTT Application Module (apps/mqtt)

### 12.1 GET /api/v1/apps/mqtt/config — full MQTT configuration

**Response data** (nested structure; groups not yet configured may be absent)

| Group | Fields |
|---|---|
| connection | `{hostname, port, client_id, protocol_type, protocol_version, clean_session, keepalive}` |
| authentication | `{username, password, ca_cert_path, client_cert_path, client_key_path, ca_data, client_cert_data, client_key_data, sni}` |
| last_will | `{topic, message, qos, retain}` |
| network | `{auto_reconnect, reconnect_interval_ms, connection_timeout_ms, buffer_size, outbox_limit, outbox_resend_interval_ms, outbox_expired_timeout_ms}` |
| task | `{priority, stack_size}` |
| topics | `{data_receive_topic, data_report_topic, status_topic, command_topic}` |
| qos | `{data_receive_qos, data_report_qos, status_qos, command_qos}` |
| top level | `{report_content, telemetry_enabled, telemetry_topic, telemetry_qos, telemetry_format}` |
| auto_subscribe | `{auto_subscribe_receive, auto_subscribe_command}` |
| message_config | `{enable_status_report, status_report_interval_ms, enable_heartbeat, heartbeat_interval_ms}` |
| status | `{running, connected, state (numeric), version}` |

**Example** (default configuration; groups not yet configured are absent):

```json
{"connection":{"hostname":"mqtt.example.com","port":1883,"client_id":"NE302-278C51","protocol_type":"mqtt"},
 "authentication":{"username":"","password":"","ca_cert_path":"","client_cert_path":"","client_key_path":"",
                   "ca_data":"","client_cert_data":"","client_key_data":"","sni":false},
 "topics":{"data_receive_topic":"ne302/278C51/down/control","data_report_topic":"ne302/278C51/upload/report"},
 "qos":{"data_receive_qos":0,"data_report_qos":0},
 "report_content":"full","telemetry_enabled":false,
 "telemetry_topic":"ne302/278C51/upload/telemetry","telemetry_qos":0,"telemetry_format":"json",
 "status":{"running":true,"connected":false,"state":9,"version":"1.0.0"}}
```

### 12.2 POST /api/v1/apps/mqtt/config — update MQTT configuration

**Request body**: same structure; top-level group objects and inner fields all optional.

**⚠ Clearing semantics**: if a group object is present but an inner field is **absent, that field is CLEARED** (emptied) — it does not keep its previous value. To keep a field, send its current value explicitly; when updating a group, send the complete group.

**Response data**: `{message, success, connection_config_changed, action_taken, next_step}` (prompts a reconnect when connection parameters changed)

### 12.3 POST /api/v1/apps/mqtt/connect — connect MQTT

**Request body**: empty (uses the current config). Blocks until connected or failed — successful connections to a reachable broker typically return within ~12 s; an unreachable broker returns `status:"timeout"` after ~5 s.

**Response data**: `{message, success, connected, status(connected/timeout/failed), error_code?, statistics:{...}}`

**`statistics` fields**

| Field | Type | Description |
|---|---|---|
| total_connections / successful_connections / failed_connections | number | connection counters |
| messages_published / messages_received | number | message counters |
| outbox_size | number | messages queued in the outbox |

**Example** (connected):

```json
{"message":"MQTT connection successful","success":true,"connected":true,"status":"connected",
 "statistics":{"total_connections":11,"successful_connections":1,"failed_connections":19,
               "messages_published":0,"messages_received":0,"outbox_size":0}}
```

### 12.4 POST /api/v1/apps/mqtt/disconnect — disconnect MQTT

**Request body**: empty. **Response data**: as in 12.3; idempotent (`status:"already_disconnected"` when idle).

**Example** (disconnect while connected): `{"message":"MQTT disconnection successful","success":true,"connected":false,"status":"disconnected","statistics":{...as 12.3}}`

### 12.5 POST /api/v1/device/capture — manual capture uploaded via MQTT

**Request body** (all optional)

| Field | Type | Description |
|---|---|---|
| enable_ai | bool | run AI on the captured frame |
| store_to_sd | bool | store to SD |
| chunk_size | number | chunk size |

**Response data**: `{success, code, result, message, enable_ai, store_to_sd, chunk_size, duration_ms}` — a full capture+upload cycle takes on the order of 20 s; `duration_ms` reports the actual value.

**Example**

```json
{"success":true,"code":0,"result":0,"message":"Capture and MQTT upload completed",
 "enable_ai":false,"store_to_sd":false,"chunk_size":0,"duration_ms":20725}
```

**Notes**: failed uploads are queued and re-sent automatically once a connection is available (record `retry_count`/`last_error` reflect this).

**Errors**: busy `OPERATION_IN_PROGRESS` (1705); MQTT down `MQTT_NOT_CONNECTED` (1304); timeout `OPERATION_TIMEOUT` (1701)

---

## 13. RTMP Streaming Module (apps/rtmp)

### 13.1 GET /api/v1/apps/rtmp/config — RTMP configuration

**Response data**: nested — a `config` object plus a `status` object:

**`config` fields**

| Field | Type | Description |
|---|---|---|
| enable | bool | RTMP switch |
| url | string | RTMP server URL (e.g. `rtmp://server/live`) |
| stream_key | string | stream key |

**`status` fields**

| Field | Type | Description |
|---|---|---|
| initialized | bool | service initialized |
| streaming | bool | currently streaming |
| state | string | `idle` / `connecting` / `streaming` / `reconnecting` / `stopping` / `error` |

**Example**

```json
{"config":{"enable":false,"url":"","stream_key":""},
 "status":{"initialized":true,"streaming":false,"state":"idle"}}
```

### 13.2 POST /api/v1/apps/rtmp/config — update configuration

**Request body**: `{enable?, url?, stream_key?}` (all optional)

**Response data**: `{success, message}`

### 13.3 POST /api/v1/apps/rtmp/start — start streaming

**Request body**: empty. Soft failure: when the stream cannot be established the envelope is still `success:true` with `data.success=false`:

```json
{"success": true, "data": {"success": false, "status": "failed", "error_code": -2, "state": "idle"}}
```

### 13.4 POST /api/v1/apps/rtmp/stop — stop streaming

**Request body**: empty. **Response data**: `{success, status}` (`status:"already_stopped"` when idle).

### 13.5 GET /api/v1/apps/rtmp/status — streaming status

**`status` fields**

| Field | Type | Description |
|---|---|---|
| streaming | bool | currently streaming |
| state | string | `idle` / `connecting` / `streaming` / `reconnecting` / `stopping` / `error` |

**`statistics` fields**

| Field | Type | Description |
|---|---|---|
| frames_sent | number | frames sent since start |
| bytes_sent | number | bytes sent |
| keyframes_sent | number | keyframes sent |
| dropped_frames | number | frames dropped |
| reconnect_count | number | reconnections |
| stream_duration_sec | number | streaming duration (seconds) |

**Example**

```json
{"status":{"streaming":false,"state":"idle"},
 "statistics":{"frames_sent":0,"bytes_sent":0,"keyframes_sent":0,"dropped_frames":0,
               "reconnect_count":0,"stream_duration_sec":0}}
```

---

## 14. RTSP Service Module (apps/rtsp)

### 14.1 GET /api/v1/apps/rtsp/config — RTSP configuration

**Response data**: `{enabled, port, auth_mode, username, password}`
> The password is returned **in clear text** (no masking).

**Example** (defaults): `{"enabled":false,"port":554,"auth_mode":"none","username":"","password":""}`

### 14.2 PUT /api/v1/apps/rtsp/config — update configuration

**Request body**: `{enabled?, port?, auth_mode?, username?, password?}`

- `password` = `"******"` means **keep unchanged** (mask sentinel)
- `enabled` is mutually exclusive with RTMP: enabling RTSP disables RTMP; the reverse is asymmetric
- **Response data**: `{enabled, port, auth_mode, message}`

### 14.3 GET /api/v1/apps/rtsp/status — service status

**Response data**

| Field | Type | Description |
|---|---|---|
| running | bool | RTSP server running |
| stream_url | string | playback URL (e.g. `rtsp://<device-ip>:554/stream`); empty while the server is disabled |

**Example**: `{"running": false, "stream_url": ""}`

### 14.4 GET /api/v1/apps/rtsp/clients — client list

**Response data**: array (empty when no clients), each entry:

| Field | Type | Description |
|---|---|---|
| id | string | session identifier (used by 14.5) |
| ip | string | client IP |
| port | number | client port |
| connected_duration | number | connection duration (seconds) |

### 14.5 DELETE /api/v1/apps/rtsp/clients/&lt;session-id&gt; — kick a client

**Path**: `/api/v1/apps/rtsp/clients/<session-id>` (wildcard route)
**Response data**: `{success, message}` (succeeds whether or not the session exists)

---

## 15. Webhook Module (apps/webhook)

### 15.1 GET /api/v1/apps/webhook/config — configuration

**Response data**

| Field | Type | Description |
|---|---|---|
| enable | bool | webhook switch |
| url | string | target URL (empty = unconfigured) |
| auth_type | string | `none` / `basic` / `bearer` |
| secret | string | authentication secret/token |
| has_custom_ca | bool | custom CA certificate installed (see 15.4) |

**Example**: `{"enable":false,"url":"","auth_type":"none","secret":"","has_custom_ca":false}`

### 15.2 POST /api/v1/apps/webhook/config — update configuration

**Request body**: `{enable?, url?, auth_type?, secret?}`
**Response data**: `{success, message}`

### 15.3 POST /api/v1/apps/webhook/test — test push

**Request body**: empty (sends a test message per the current config).
**Response data**: `{success, message}` (soft failure)

The push is an HTTP POST with a `multipart/form-data` body (`User-Agent: HttpClient/1.0`):

```
------NE302WebhookBoundary
Content-Disposition: form-data; name="metadata"
Content-Type: application/json

{"device_info":{"device_name":"NE302-278C51","serial_number":"SN202500001"},"ai_result":null}
------NE302WebhookBoundary
Content-Disposition: form-data; name="image"; filename="capture.jpg"
Content-Type: image/jpeg

<JPEG bytes: live camera frame>
------NE302WebhookBoundary--
```

### 15.4 GET / POST / DELETE /api/v1/apps/webhook/ca-cert — custom CA certificate

- **GET** `data`: `{ca_cert_data (PEM text), ca_cert_length}`; with no certificate configured → `INVALID_REQUEST` ("No CA certificate configured")
- **POST**: `{ca_cert_data}`; must start with `-----BEGIN`, **≤ 8 KB**; malformed → `INVALID_REQUEST` ("Invalid PEM format")
- **DELETE**: clears the custom CA, restoring the default (idempotent)

**Response data**: `{success, message}`

---

## 16. Firmware Upgrade Module (system/ota)

**Shared conventions**

- `firmwareType` values: `fsbl` / `app` / `web` / `ai_default` (AI slot 1) / `ai` (actually active AI slot) / `wifi` / `reserved2`; default `app`
- Package header is 1 KB (`ota_header_t`, magic `"UATO"`); AI types carry an extra 1 KB model header (2048 B total)
- Device-model stamp: a package/bundle stamped `device_model ≠ 0 and ≠ 0x3010` is rejected (0 = unstamped legacy, allowed)
- Timeouts: single-upload idle 3 min, bundle-session idle 10 min — auto-terminated, services restarted; late residual data after the timeout is discarded and the connection closed
- During upload the service automatically stops MQTT, the AI pipeline and the camera (waits ≤30 s for an in-flight capture) and restores them afterwards; **no path auto-reboots**

### 16.1 POST /api/v1/system/ota/precheck — firmware header precheck

**Request**: raw binary body = the first 1024 B of the package (2048 B for AI types); `Content-Type` not enforced.
**Query params**: `firmwareType` (default app), `contentLength` (full package size; if given it must equal the header's `total_package_size`)

**Response data**: `{valid: true, message, firmware_size, firmware_version, firmware_crc32, part_table_changed, device_table_crc, package_table_crc}`

**Example**

```json
{"success":true,"data":{"valid":true,"message":"Header validation passed","firmware_size":3846816,
 "firmware_version":"4.3.1.107","firmware_crc32":3559581218,"part_table_changed":false,
 "device_table_crc":1513948246,"package_table_crc":1513948246}}
```

**Failure**: `OTA_HEADER_VALIDATION_FAILED` (1806) with `data:{valid:false, reason:"Header validation failed"}` — corrupted magic, CRC mismatch, `contentLength` mismatch; an empty body returns `INVALID_REQUEST`.

### 16.2 POST /api/v1/system/ota/upload — streamed firmware upload

**⚠ Envelope exception**: this endpoint is intercepted by the stream processor before route dispatch (auth handled there; **real HTTP statuses** returned).

| Item | Description |
|---|---|
| Request body | **raw firmware bytes** (not multipart/JSON), 1 KB header + payload |
| Content-Length | **required**, 1024 B – 100 MB |
| Query params | `firmwareType` (default app) |
| Direct-burn mode | `direct=1&addr=0x<addr>`; valid only during a bundle session (`bundle/begin`); `addr` must exactly equal the device-resolved plan address |
| Mutual exclusion | normal upload and bundle sessions are mutually exclusive (an active one rejects the other) |

**Processing**: header verification (magic/CRC/model/type/size) → flash writes in 1 KB chunks with a running CRC32 → final whole-package CRC check. FSBL payloads are staged in PSRAM and flashed only after the CRC passes. WEB uploads reload the web assets immediately; AI uploads set the NVS active-slot flag; WiFi uploads stage the `.rps` at `WIFI_FW_BASE`, pushed at the next reboot.

**Response**: envelope JSON; success `message: "Upgrade successful"`. Reference throughput (real burns, same-version packages): **APP ≈ 3.8 MB in ≈ 31 s (≈ 125 KB/s)**; web assets ≈ 284 KB in ≈ 2.3 s. An upload issued immediately after a reboot may be refused with a connection reset — retry once the web service has fully initialized. Failures use real statuses 400 (header verification failed / OTA in progress / params) / 500 (memory/flash/CRC errors).

### 16.3 POST /api/v1/system/ota/upgrade-local — upgrade confirmation (arms WiFi push)

**Request body**: `{firmware_type: "wifi"}` (any other value or an empty body is a no-op)
**Behavior**: for `wifi`, sets the NVS update flag so the next reboot pushes the staged `.rps` to the 917 host.
**Response data**: `null`, `message: "OK"`

### 16.4 POST /api/v1/system/ota/export — export firmware (envelope exception)

**Request body** (JSON; Content-Type must be application/json)

| Field | Type | Required | Description |
|---|---|---|---|
| firmware_type | string | yes | `app` / `web` / `ai_default` / `ai` (exportable); `fsbl` / `wifi` are **not exportable** (`INTERNAL_ERROR "Firmware size is 0"`); any other value falls back to `app` |
| filename | string | yes | export file name (used in `Content-Disposition: attachment; filename="…"`) |

**Response**: raw firmware bytes (`application/octet-stream`), streamed in 1 KB chunks. Reference throughput ≈ 720 KB/s (APP ≈ 3.8 MB in ≈ 5 s; web assets ≈ 284 KB in ≈ 0.4 s; AI package ≈ 3.2 MB in ≈ 4.5 s).

### 16.5 POST /api/v1/system/ota/bundle/precheck — full-reflash bundle precheck

One-click full-reflash bundle (4 KB header + sub-packages). **Request body = the first 4096 bytes of the bundle file** (raw binary).

**Validation**: header magic/size/CRC; device-model stamp; entry table; partition layout physically valid (no overlap, within flash, FSBL must not move); legal types without duplicates; required partitions present; entries fit their partitions; a layout-changing bundle must contain FSBL.

**Response data**

```jsonc
{
  "layout_changed": false,
  "layout_diff": [ { "part": "...", "device_base": 0, "device_size": 0,
                     "bundle_base": 0, "bundle_size": 0 } ],   // only when layout_changed
  "total_bytes": 0,
  "entries": [ {
      "type": "app",            // fsbl|app|web|ai|wifi
      "fw_type": 2,             // raw code: 0x01 fsbl / 0x02 app / 0x03 web / 0x04,0x05 AI / 0x08 wifi
      "skippable": true,        // same version AND unmoved partition (FSBL additionally needs unchanged layout)
      "cur_version": "…", "new_version": "…",
      "size": 0,                // sub-package bytes
      "offset": 4096,           // byte offset within the bundle file
      "addr": 0                 // device-resolved absolute flash burn address
  } ]
}
```

**Side effects**: the validated header + plan is stored as the global bundle session (`prechecked=true`); expires after 10 idle minutes.

**Failure**: invalid header → `OTA_HEADER_VALIDATION_FAILED` ("Invalid bundle header (magic/size/CRC)").

### 16.6 POST /api/v1/system/ota/bundle/begin — start the bundle forced-reflash session

**Request body**: `{skip?: ["wifi", "fsbl", ...]}` — skip list; names must be in the plan and `skippable=true`; **skipping everything is rejected**.

**Response data**: `{burn_count}`, `message: "Bundle session started"`. Without a prior successful `bundle/precheck`: `INVALID_REQUEST "No prechecked bundle (POST bundle/precheck first)"`.

**⚠ Side effect**: every begin **erases the OTA info partition**; the next boot rebuilds SystemState from the new layout (slot A / APP1 / AI_1 active). Skipping `wifi` clears the pending-WiFi-push flag.

### 16.7 POST /api/v1/system/ota/bundle/finish — finish/abort the bundle session

**Request body**: `{result: "ok" | "abort"}` (anything other than "ok" is treated as abort)
**Behavior**: on `"ok"` with a WiFi update still in the plan, calls `wifi_mark_update_pending()`; the session is cleared either way, **no auto-reboot** (the frontend then calls `/system/restart`). Already-burned firmware is not rolled back; abort is idempotent.
**Response data**: `{wifi_pending}`, `message: "Bundle finished"/"Bundle aborted"`. Without an active session: `INVALID_REQUEST "No bundle session to finish"`.

---

## 17. ISP Image Quality Module (isp)

**Shared error codes** (business codes 2001–2008, see 1.5.2): 2001 not initialized / 2002 invalid param (JSON) / 2003 out of range / 2004 dependency / 2005 HAL / 2006 sensor / 2007 algorithm / 2008 busy.

**General semantics**: GET returns current values; PUT **applies live to the ISP hardware** and updates the IQ-parameter cache but **does not write NVS by itself** — persist via `POST /isp/config/save`. GETs additionally carry `_meta` (field metadata).

**`_meta` structure** — one entry per settable field:

| Key | Description |
|---|---|
| type | `bool` / `number` / `enum` / … |
| unit | unit string where applicable |
| min / max / default | numeric bounds and factory default |
| values / labels | for `enum` fields: allowed values and their display labels |
| dependencies | fields that must be in a given state for this one to apply (e.g. manual exposure requires AEC disabled) |
| description | human-readable field description |

```json
// _meta excerpt from GET /isp/aec
"_meta": {
  "exposure_compensation": {"type":"enum","values":[-4,-3,-2,-1,0,1,2,3,4],
    "labels":["-2.0EV","-1.5EV","-1.0EV","-0.5EV","0EV","+0.5EV","+1.0EV","+1.5EV","+2.0EV"],
    "default":0,"description":"Exposure compensation in EV"},
  "anti_flicker_freq": {"type":"enum","values":[0,50,60],
    "description":"Anti-flicker frequency (0=Off, 50=50Hz, 60=60Hz)"}
}
```

### 17.1 GET /api/v1/isp/params — all parameters

**Response data**: `{sensor_info:{name,bayer_pattern,color_depth,width,height}, aec, awb, demosaicing, stat_removal, black_level, bad_pixel, isp_gain, color_conv, contrast, gamma, stat_area, sensor_delay}` (group fields as in the corresponding endpoints below)

### 17.2 GET /api/v1/isp/sensor — sensor information

**Response data**: `{name, bayer_pattern(RGGB/GRBG/GBRG/BGGR/MONO), color_depth, width, height, gain_range:{min,max}, exposure_range:{min,max}}` (gain in mB, exposure in µs)

**Example**: `{"name":"OS04C10","bayer_pattern":"RGGB","color_depth":10,"width":2688,"height":1520,"gain_range":{"min":0,"max":72000},"exposure_range":{"min":0,"max":33266}}`

### 17.3 GET /api/v1/isp/statistics — ISP statistics

**Response data**: `{down:{average_r,average_g,average_b,average_l,histogram[12]}, up:{average_r,average_g,average_b,average_l}, estimated_lux, frame_id}` (down = after ISP processing, up = before)

**Example**: `{"down":{"average_r":57,"average_g":59,"average_b":61,"average_l":58,"histogram":[0,0,0,0,0,0,0,0,0,0,0,0]},"up":{"average_r":0,"average_g":0,"average_b":0,"average_l":0},"estimated_lux":83,"frame_id":1318670}`

### 17.4 GET / PUT /api/v1/isp/aec — auto exposure

**Example** (live values + `_meta` excerpt):

```json
{"enable":true,"exposure_compensation":0,"exposure_target":56,"anti_flicker_freq":50,
 "current_state":{"sensor_gain":13480,"sensor_exposure":30000,"estimated_lux":83},
 "_meta":{...}}
```

| Field | Type | Range | PUT |
|---|---|---|---|
| enable | bool | — | ✅ |
| exposure_compensation | number | −4…+4 (0.5 EV steps, i.e. ±2.0 EV) | ✅ |
| exposure_target | number | 0–100 | ✅ |
| anti_flicker_freq | number | 0 / 50 / 60 | ❌ (read-only here; settable only via import) |

GET also carries `current_state:{sensor_gain, sensor_exposure, estimated_lux}`.

### 17.5 GET / PUT /api/v1/isp/aec/manual — manual exposure

| Field | Type | Range | Description |
|---|---|---|---|
| gain | number | sensor.gain_min…max | unit mB |
| exposure | number | sensor.exposure_min…max | unit µs |

> Manual exposure takes effect only while AEC is **disabled** (see GET `_meta.dependencies`).

### 17.6 GET / PUT /api/v1/isp/awb — auto white balance

| Field | Type | Description |
|---|---|---|
| enable | bool | AWB switch |
| mode | string | `auto` (profile by scene) / `manual` (by color_temp) |
| color_temp | number | manual-mode color temp (PUT consumes it together with `mode`) |
| profiles | array | exactly 5: `{index(0–4), label(≤31 chars), reference_color_temp, isp_gain:{r,g,b}, ccm[3][3](±4.0×), reference_rgb:{r,g,b}}` |

GET also carries `current_color_temp, current_gains:{r,g,b}, current_ccm:{enable, matrix}`. Profile numbers have no range validation and are written straight into the IQ cache.

### 17.7 GET / PUT /api/v1/isp/demosaicing — demosaicing

`{enable, peak, line_v, line_h, edge}` (strengths all 0–7, default 4); `bayer_type` read-only (sensor-determined).

### 17.8 GET / PUT /api/v1/isp/stat_removal — statistics line removal

`{enable, head_lines(0–7), valid_lines(0–4094)}`

### 17.9 GET / PUT /api/v1/isp/black_level — black level

`{enable, r, g, b}` (each 0–255, default 12)

### 17.10 GET / PUT /api/v1/isp/bad_pixel — bad-pixel correction

`{enable, strength(0–7), detected_count(read-only, runtime-detected), algo_enable, algo_threshold(≥0)}`

### 17.11 GET / PUT /api/v1/isp/gain — ISP digital gain

`{enable, r, g, b}`, unit **100000000 = 1.0×**, max 16.0× (1,600,000,000).
> ISP gain is auto-controlled while AWB is enabled.

### 17.12 GET / PUT /api/v1/isp/color_conv — color conversion matrix

`{enable, matrix[3][3]}`, coefficients ±399,000,000 (1e8 = 1.0×); must be exactly 3×3.

### 17.13 GET / PUT /api/v1/isp/contrast — contrast LUT

`{enable, lut[9]}`, each 0–394 (luma anchors [0,32,…,256], 100 = 1.0×); must be exactly 9 items.

### 17.14 GET / PUT /api/v1/isp/gamma — gamma correction

`{enable}` (the only field)

### 17.15 GET / PUT /api/v1/isp/stat_area — statistics window

`{x, y, width, height}`, width/height ≥ 4 and ≤ 4094; must satisfy `x+width ≤ sensor_width`, `y+height ≤ sensor_height`. PUT merges with current values.

### 17.16 GET / PUT /api/v1/isp/lux_ref — lux reference (AEC estimation input)

`{high_lux:{lux_ref,expo1,lum1,expo2,lum2}, low_lux:{…same…}, calib_factor(float)}`; lum1/lum2 are 0–255. IQ cache only.

### 17.17 GET / PUT /api/v1/isp/sensor_delay — sensor delay

`{delay}` (int ≥ 0, stored as uint8). IQ cache only.

### 17.18 POST /api/v1/isp/config/save — persist IQ parameters to NVS

**Request body**: empty. Saves all current live IQ parameters. **Response**: `message: "ISP configuration saved successfully"`.

### 17.19 POST /api/v1/isp/config/load — load from NVS

**Request body**: empty. Without a saved config returns 2001 (`No saved ISP configuration found`).

### 17.20 GET /api/v1/isp/config/export — export IQ configuration

**Response data**: `{export_version:"1.0", export_timestamp, config:{stat_removal, demosaicing{+type}, contrast, stat_area, bad_pixel{algo_*, static_*}, black_level, aec, awb{profiles[{label,color_temp,gain_r,gain_g,gain_b,ccm[9 flat]}]}, isp_gain, color_conv{matrix[9 flat]}, gamma, sensor{gain,exposure,delay}, lux_ref{hl_*,ll_*,calib_factor}}}`

> Export field names differ slightly from the per-parameter API (`color_temp`/`gain_r|g|b`/flat 9-element arrays).

### 17.21 POST /api/v1/isp/config/import — import IQ configuration

**Request body**: `{config: {…same structure as export…}}` (`config` required; inner sections optional; `ccm`/`matrix` accept flat arrays of ≥9 items)

**Behavior**: applies live + persists to NVS + refreshes the device cache. **No range validation** (unlike the individual PUTs).
**Response**: `message: "ISP configuration imported and applied successfully"`

---

## Appendix A. curl Quick Start

```bash
# Every request carries Basic auth (username admin)
curl -u admin:<password> http://<device-ip>/api/v1/device/info

# Branch on the success field, not the HTTP status
curl -s -u admin:<password> http://<device-ip>/api/v1/ai/status | jq .success

# File upload (raw byte stream, not multipart): path = target DIRECTORY, filename = file name
curl -u admin:<password> -X POST --data-binary @frame.jpg \
  "http://<device-ip>/api/v1/files/upload?fs=flash&path=/photos&filename=frame.jpg"

# Model validation: 8 multipart parts (2 files + 6 metadata text fields);
# ai_image must match the model input size (256x256 for the default model)
curl -u admin:<password> -X POST \
  -F "ai_image=@a256.jpg" -F "ai_image_width=256" -F "ai_image_height=256" -F "ai_image_quality=85" \
  -F "draw_image=@d256.jpg" -F "draw_image_width=256" -F "draw_image_height=256" -F "draw_image_quality=85" \
  "http://<device-ip>/api/v1/model/validation/upload"

# OTA precheck: first 1024 bytes of the package + full size
curl -u admin:<password> -X POST --data-binary @header.bin \
  "http://<device-ip>/api/v1/system/ota/precheck?firmwareType=app&contentLength=3846816"

# OTA upload (streamed, real status codes)
curl -u admin:<password> -X POST --data-binary @app_v4.3.1.x.bin \
  "http://<device-ip>/api/v1/system/ota/upload?firmwareType=app"
```

## Appendix B. WebSocket Preview Stream

| Item | Value |
|---|---|
| URL | `ws://<device-ip>:8081/stream` (separate listener, default port 8081) |
| Payload | H.264 video frames; GOP ≈ 1 s |
| Typical throughput | ≈ 190 KB/s sustained, fps ≈ 28 |
| Frame sizes | keyframe ≈ 14 KB, P-frames ≈ 7.4–8.3 KB |
| Keyframe sync | the server performs per-subscriber keyframe join-sync: on each keyframe it sends a single `[SPS][PPS][IDR]` composite frame, so late-joining clients never see a black screen |
| Lifecycle | `POST /api/v1/preview/start` starts the pipeline; after the last client disconnects, `POST /api/v1/preview/stop` actually stops the stream |

> Players should use a decoder that accepts Annex-B start codes (e.g. jmuxer); the first frame already includes the parameter sets — no separate SPS/PPS request is needed.

## Appendix C. Version & Document Maintenance

- The APP firmware version is **4.3.1.x** (build number = commit count since the `v4.3.1-base` tag); version macros live in `Custom/Common/Inc/version.h` (auto-generated at build time); expected companion versions in `EXPECTED_FSBL_VERSION_STRING` and `EXPECTED_WIFI_VERSION_STRING`.
- Module routes are registered in `Custom/Services/Web/web_service.c`; route tables and error codes are in `web_server.h`, `api_business_error.h` and `api_isp_module.h`.
- After a firmware upgrade, re-check the API surface against `git diff` and update this document accordingly.
