camthink-ai/ne302/Docs/NE302_v4.3.1_Config_File_Reference.md

# NE302 Device Configuration File Reference (v4.3.1 / Config Schema v2)

> Applies to the device configuration JSON downloaded from the web page "Firmware Upgrade → Export" (endpoints: `GET /api/v1/device/config/export` and `POST /api/v1/device/config/import`).
> Field meanings, defaults, and ranges follow the firmware code (structs in `Custom/Core/System/json_config_mgr.h`, defaults and normalization in `json_config_mgr.c`, enums in the service layers); web page entries follow the actual frontend.

## Import semantics (read this first)

- **Merge, not rebuild**: import overlays only the keys actually present in the file; keys missing (or deliberately deleted) keep the **device's current values** — they do not revert to factory defaults.
- **Version gate**: files whose `config_version` is newer than the firmware's current version (2) are rejected wholesale; v1 files still import, and the persisted version marker is pinned back to 2 after import.
- **Network params always persist**: importing network fields writes RAM+NVS immediately, whether or not the device is connected — no field is skipped or rejected because a link is up. Each field then takes effect when its consumer next reads it (mostly at next restart / next connect — see the note under `network_service`).
- Import column markers used in the tables:
  - ✅ imported and applied
  - 📄 export-only documentation, **ignored on import** (device-bound info or source-device runtime snapshot)
  - 🔧 imported, but normalized/clamped first (see each table)
- Sensitive data: the file carries the WiFi password, MQTT password, RTSP password, RTMP stream key, webhook secret, and admin password **in plaintext** — handle with care.

## ⚠️ Fields not actually used by the current firmware

The following fields are **stored, exported, and round-tripped on import**, but **nothing in the firmware reads them** — setting them changes no behavior (importing them is harmless too). Most are legacy or reserved; verified by grepping the v4.3.1 code:

| Field | Notes |
|---|---|
| `device_service.image_config.brightness` / `contrast` | No consumer (the web UI does not expose them in this release either) |
| `device_service.image_config.aec` | Auto-exposure switch: no consumer |
| `device_service.image_config.capture_disable_comm` | Copied/logged inside the device service only; the capture-upload path never reads it — no effect observed |
| `work_mode_config.work_mode` / `image_mode.enable` | The firmware has a single work mode (image/capture); neither field is consumed |
| `work_mode_config.video_stream_mode.enable` | Legacy work-mode parent switch: streaming is gated by rtmp_enable / rtsp_enable independently — this switch has no consumer |
| `work_mode_config.io_trigger[]` entire group (`pin_number`/`enable`/`input_enable`/`output_enable`/`input_trigger_type`/`output_trigger_type`) | The registration API exists but has no callers; the web serialization code is commented out — not wired up |
| `capture_upload_config.max_pending_records` | Stored and shown on the web only; the upload pipeline never reads this cap |
| `network_service.poe.dhcp_retry_interval_ms` | Not read by the PoE driver |
| `network_service.cellular.authentication` / `operator` | Not used by the cellular modem configuration |
| `auth_mgr.session_timeout_ms` / `enable_session_timeout` | No session-timeout logic on login — not consumed |

For contrast, fields that look unused but **are** used: the whole `ai_debug` group (`ai_enabled`/`ai_1_active`/`confidence_threshold`/`nms_threshold`/`overlay_results`/`inference_interval_ms` are pushed through the AI service into the video nodes and model post-processing; `ai_1_active` also selects the model slot for wake captures), `light_config.light_threshold` (light-control check on the wake path), and the MQTT buffer/timeout parameters (`tx_buf_size`/`rx_buf_size`/`outbox_expired_timeout_ms` etc. are consumed by the MQTT client library).

---

## Top-level wrapper

| Field | Type | Description |
|---|---|---|
| `export_version` | string | Export format version, currently `"1.0"` |
| `export_timestamp` | number | Unix timestamp (seconds) at export time |
| `config` | object | The actual configuration body; all sections below describe fields inside `config` |

## config metadata

| Field | Default | Description | Import |
|---|---|---|---|
| `config_version` | 2 | Config schema version. Files with a newer value are rejected; the firmware pins it back to 2 on import | 📄 (gate only) |
| `magic_number` | 0x41494341 | Magic `"AICA"` (1095320385), integrity marker | 📄 |
| `checksum` / `timestamp` | — | Checksum and last-save time; the device recomputes both on import | 📄 |

## log_config (logging)

Web entry: System Settings.

| Field | Default | Description | Range/enum | Import |
|---|---|---|---|---|
| `log_level` | 2 | File log level | 0=DEBUG, 1=INFO, 2=WARNING, 3=ERROR, 4=FATAL, 5=SIMPLE (factory comment says "INFO" but per the enum 2 maps to WARNING; the enum wins) | ✅ |
| `log_file_size_kb` | 60 | Per-file log size cap (KB) | positive integer | ✅ |
| `log_file_count` | 5 | Number of rotated log files kept | positive integer | ✅ |

## ai_debug (AI inference)

Web entry: Function Debug.

| Field | Default | Description | Range | Import |
|---|---|---|---|---|
| `ai_enabled` | false | AI inference master switch | bool | ✅ |
| `ai_1_active` | false | AI_1 (current model slot) enabled; also selects the model slot for wake-time captures | bool | ✅ |
| `confidence_threshold` | 50 | Confidence threshold; lower-scoring detections are dropped | 0–100 | ✅ |
| `nms_threshold` | 50 | NMS threshold | 0–100 | ✅ |
| `overlay_results` | true | Draw inference results onto encoded frames / captures | bool | ✅ |
| `inference_interval_ms` | 0 | Inference pacing interval; 0 = every frame | ≥0, ms | ✅ |

## power_mode_config (power mode)

Web entry: Function Debug (power mode); `current_mode` is switched via `POST /api/v1/power-mode/switch`.

| Field | Default | Description | Range/enum | Import |
|---|---|---|---|---|
| `current_mode` | 0 | Current power mode. The switch API persists it and **boot runs in it**, so it round-trips; applied on next boot (a running device does not switch immediately) | 0=low power, 1=full speed; out-of-domain values are ignored (device value kept) | ✅ |
| `default_mode` | 0 | Default power mode (fallback when no valid current_mode) | 0/1; out-of-domain ignored | ✅ |
| `low_power_timeout_ms` | 60000 | Idle time before entering low power | ms | ✅ |
| `last_activity_time` | 0 | Last-activity timestamp (ms) | — | 📄 **re-stamped with the local time on import** (prevents a foreign stale stamp from causing a bogus timeout) |
| `mode_switch_count` | 0 | Mode switch counter | — | 📄 |

## device_info (device information) — export-only section

Web entry: Device Information. **Every field is ignored on import**: these are device-bound or runtime-derived values; importing another unit's file never overwrites this device's identity.

| Field | Description |
|---|---|
| `device_name` | Device name. Generated from the MAC as `NE302-XXXXXX` (last 3 bytes) by default; follows the burned factory MAC when present |
| `mac_address` | Device MAC (burned value when a factory MAC is burned, else the chip-reported one) |
| `serial_number` | Serial number (factory-written, default `SN202500001`) |
| `hardware_version` / `software_version` | Hardware/software versions (software version updates with the firmware; import has no effect) |
| `camera_module` / `extension_modules` | Camera module / extension module descriptions |
| `storage_card_info` / `storage_usage_percent` | SD card status and usage (runtime snapshot) |
| `power_supply_type` / `battery_percent` | Power supply type and battery level (runtime snapshot) |
| `communication_type` | The live active link (runtime snapshot) |

## device_service (device service)

### image_config (image & capture parameters)

Web entries: Image Settings / Capture Settings (part of the parameters).

| Field | Default | Description | Range/enum | Import |
|---|---|---|---|---|
| `brightness` / `contrast` | 50 | Brightness / contrast | 0–100 | ✅ ⚠️ unused |
| `horizontal_flip` / `vertical_flip` | false | Horizontal / vertical flip | bool | ✅ |
| `aec` | 1 | Auto exposure control | 0=manual, 1=auto | ✅ ⚠️ unused |
| `isp_mode` | 0 | ISP scene mode | 0=outdoor, 1=indoor, 255=custom (custom uses the `isp_config` below) | ✅ |
| `grayscale` | false | Grayscale mode | bool | ✅ |
| `fast_capture_skip_frames` | 10 | Frames skipped before a fast capture (exposure settling) | 1–300 | ✅ |
| `fast_capture_resolution` | 0 | Fast capture resolution | 0=1280×720, 1=1920×1080, 2=2688×1520 | ✅ |
| `fast_capture_jpeg_quality` | 60 | Fast capture JPEG quality | 0–100 | ✅ |
| `capture_disable_comm` | false | Store locally only after capture (no comm upload) | bool | ✅ ⚠️ unused (no effect path found) |
| `capture_storage_ai` | false | Additionally save a capture with the AI results drawn | bool | ✅ |

### light_config (fill light)

Web entry: Hardware Management → Light.

| Field | Default | Description | Range/enum | Import |
|---|---|---|---|---|
| `connected` | false | Light-hardware presence probe result (runtime state) | — | 📄 |
| `mode` | 0 | Work mode | 0=off, 1=on, 2=auto, 3=custom schedule | ✅ |
| `start_hour`/`start_minute`/`end_hour`/`end_minute` | 18:00–06:00 | Custom schedule start/end (may cross midnight) | hour 0–23, minute 0–59 | ✅ |
| `brightness_level` | 50 | Brightness | 0–100 | ✅ |
| `auto_trigger_enabled` | true | Auto mode triggers on ambient light | bool | ✅ |
| `light_threshold` | 30 | Auto-trigger light threshold | 0–100 | ✅ |
| `fill_light_while_streaming` | false | Light stays on for the whole runtime (wake captures still use the flash behavior) | bool | ✅ |

### isp_config (custom ISP IQ parameters)

Machine-generated parameter block mapping the STM32 ISP library IQ structure 1:1. **Effective only when `image_config.isp_mode=255` and this section's `valid=true`**; maintained by the web ISP custom-mode export/import — **hand-editing is not recommended**. Round-trips with the config file. Field list (`valid` is the section validity flag):

| Group | Fields | Description / range |
|---|---|---|
| Stat removal | `stat_removal_enable`, `stat_removal_head_lines`(0–7), `stat_removal_valid_lines`(0–4094) | Trim invalid statistics rows at the top of the frame |
| Demosaicing | `demosaic_enable`, `demosaic_type`(Bayer pattern 0–4), `demosaic_peak`/`demosaic_line_v`/`demosaic_line_h`/`demosaic_edge`(0–7) | Interpolation parameters |
| Contrast | `contrast_enable`, `contrast_lut[9]` | LUT (LUM_0–LUM_256, each 0–394) |
| Stat area | `stat_area_x/y/width/height` | AEC/AWB statistics window (pixels) |
| Manual sensor gain/exposure | `sensor_gain`(mdB), `sensor_exposure`(µs) | Static values when AEC is off |
| Bad-pixel algorithm | `bad_pixel_algo_enable`, `bad_pixel_algo_threshold` | Dynamic bad-pixel detection |
| Bad-pixel static strength | `bad_pixel_enable`, `bad_pixel_strength`(0–7) | Static bad-pixel correction strength |
| Black level | `black_level_enable`, `black_level_r/g/b`(0–255) | Per-channel black level |
| AEC | `aec_enable`, `aec_exposure_compensation`(−4~+4 EV), `aec_anti_flicker_freq`(0=off, 50, 60) | Auto-exposure algorithm |
| AWB (5 profiles) | `awb_enable`, `awb_label[5]`, `awb_ref_color_temp[5]`, `awb_gain_r/g/b[5]`, `awb_ccm[5][3][3]`, `awb_ref_rgb[5][3]` | White-balance profiles: label / reference color temperature / gains / color matrix / reference RGB |
| Manual ISP gain | `isp_gain_enable`, `isp_gain_r/g/b` | Static gain when AWB is off (100000000 = 1.0×) |
| Static color conversion | `color_conv_enable`, `color_conv_matrix[3][3]` | Matrix elements, 100000000 = 1.0 |
| Gamma | `gamma_enable` | Gamma enable |
| Sensor delay | `sensor_delay` | Frames |
| Lux calibration | `lux_hl_ref`/`lux_hl_expo1`/`lux_hl_lum1`/`lux_hl_expo2`/`lux_hl_lum2` (high-light reference), `lux_ll_*` (low-light reference), `lux_calib_factor` | Ambient-light estimation calibration |

## network_service (network)

Web entries: System Settings (comm type / WiFi / hotspot), Hardware Management.

| Field | Default | Description | Range/enum | Import |
|---|---|---|---|---|
| `ap_sleep_time` | 0 | Hotspot idle sleep time | seconds; only 0 (never) / 600 / 1200 / 1800 (10/20/30 min) — out-of-set values are treated as absent and keep the device's own setting (the web setter rejects them explicitly) | 🔧 |
| `ssid` / `password` | `"AICAM-AP"` / empty | This device's hotspot name and password. When empty/default, the runtime generates `NE302_XXXXXX` (from the identity MAC). ⚠️ The password is stored on import but **not applied** — the hotspot always runs open in this firmware version (chip limitation: with a password set on the AP, the STA cannot connect to networks) | string | ✅ |
| `wifi_country_code` | empty | WiFi country code (case-insensitive, stored canonical lowercase; unsupported values are treated as absent and keep the device's own setting) | empty=firmware default region; us/eu/jp/kr/cn | ✅ |
| `known_network_count` | 0 | Known-network entry count | 0–16; clamped to the actual array length on import | 🔧 |
| `known_networks[]` | [] | Known WiFi list. **Only credentials are imported**: `ssid`/`bssid`/`password`/`security`; `rssi`/`channel`/`connected`/`is_known`/`last_connected_time` are the source device's scan cache — exported for documentation, ignored on import | `security`: see the wireless security enum below | 🔧 |
| `preferred_comm_type` | 0 | Preferred comm type | 0=auto (no preference), 1=WiFi, 2=HaLow, 3=4G cellular, 4=PoE | ✅ |
| `enable_auto_priority` | true | Auto-select by link quality when no preference is set | bool | ✅ |

`security` (wireless security type, also used by the HaLow `security` field): 0=OPEN, 1=WPA, 2=WPA2, 3=WEP, 4=WPA Enterprise, 5=WPA2 Enterprise, 6=WPA/WPA2 Mixed, 7=WPA3, 8=WPA3 Transition, 9=WPA3 Enterprise, 10=WPA3 Transition Enterprise, 11=OWE, 12=SAE, 0xFFFF=Unknown.

### cellular (4G)

| Field | Default | Description | Import |
|---|---|---|---|
| `apn`/`username`/`password`/`pin_code` | empty | APN and auth credentials | ✅ |
| `authentication` | 0 | Auth method (0=none) | ✅ ⚠️ unused |
| `enable_roaming` | false | Allow roaming | ✅ |
| `operator` | 0 | Operator selection | ✅ ⚠️ unused |

### poe (PoE / Ethernet)

| Field | Default | Description | Range | Import |
|---|---|---|---|---|
| `ip_mode` | 0 | Addressing mode | 0=DHCP, 1=static | ✅ |
| `ip_addr`/`netmask`/`gateway`/`dns_primary`/`dns_secondary` | 192.168.1.100/24, gateway .1, DNS 8.8.8.8/8.8.4.4 | Static-mode network parameters (4-byte arrays) | — | ✅ |
| `hostname` | empty | DHCP hostname | — | ✅ |
| `dhcp_timeout_ms` / `dhcp_retry_count` / `dhcp_retry_interval_ms` | 30000 / 3 / 5000 | DHCP timeout and retries | — | ✅ (`dhcp_retry_interval_ms` ⚠️ unused) |
| `power_recovery_delay_ms` | 5000 | Wait after PoE power-up for stability | — | ✅ |
| `auto_reconnect` | true | Auto-reconnect on link loss | bool | ✅ |
| `persist_last_ip` | true | Remember the last IP (faster reconnect) | bool | ✅ |
| `validate_gateway` / `detect_ip_conflict` | false | Gateway reachability check / IP conflict detection | bool | ✅ |

Import semantics for network parameters: importing **always writes RAM+NVS immediately, regardless of whether the device is connected** — no network field is skipped or rejected because a link is up (the PoE config page reflects the imported values right after import, before any restart). What differs per field is when its consumer re-reads it:

| Field group | Takes effect at |
|---|---|
| `poe.*` | Next restart (boot applies the config while bringing the interface up), the next connect attempt, or a web re-save; a link already up at import time is not reconfigured live |
| `wifi_country_code` | Next restart (applied during comm init) |
| `ap_sleep_time` | Next restart (read when the web server starts) |
| `ssid` / `password` | Next hotspot start (incl. restart) |
| `halow.*` | Next connection attempt (incl. boot auto-join) |
| `known_networks[]` | Next join attempt |
| `preferred_comm_type` / `enable_auto_priority` | Subsequent link-selection decisions (incl. boot auto-start) |

### halow (HaLow 802.11ah)

| Field | Default | Description | Range | Import |
|---|---|---|---|---|
| `ssid`/`password`/`security`/`country_code`/`bssid` | empty | HaLow join parameters | security: see the enum above | ✅ |
| `ip_mode`/`ip_addr`/`netmask`/`gateway` | DHCP, 192.168.12.199/24 | Static network parameters | — | ✅ |
| `tx_power_dbm` | 0 | TX power (0=default) | dBm | ✅ |
| `scan_dwell_ms` | 30 | Scan dwell time | ms | ✅ |
| `rc_mcs` / `rc_bw_mhz` / `rc_gi` | -1 | Rate-control MCS / bandwidth / guard interval, **-1=auto** | — | ✅ |
| `ps_mode` | 0 | HaLow chip power save | 0=off, 1=on | ✅ |

## mqtt_service (MQTT)

Web entry: Application Management → MQTT.

### base_config

| Field | Default | Description | Range | Import |
|---|---|---|---|---|
| `protocol_ver` | 4 | Protocol version | 3=MQTT 3.1, 4=3.1.1 | ✅ |
| `hostname` / `port` | mqtt.example.com / 1883 | Server address and port | port 1–65535 | ✅ |
| `client_id` | `AICAM-000000` | Client ID. The default sentinel is rewritten to `NE302-XXXXXX` (MAC suffix) at connection build time | ≤64 chars | ✅ |
| `clean_session` | 1 | Clean session flag | 0/1 | ✅ |
| `keepalive` | 180 | Keepalive interval | seconds | ✅ |
| `username` / `password` | empty | Login credentials (stored in plaintext) | — | ✅ |
| `ca_cert_path`/`client_cert_path`/`client_key_path` + `*_len` | empty/0 | Certificate file paths and lengths | — | ✅ |
| `ca_cert_data`/`client_cert_data`/`client_key_data` | null | Embedded certificate contents. **The Flash certificate files are rewritten only when the file carries these keys**; missing/null keys keep the device's existing certificates | — | 🔧 |
| `verify_hostname` | 0 | TLS hostname verification | 0/1 | ✅ |
| `lwt_topic`/`lwt_message`/`lwt_msg_len` | aicam/status/offline, "offline" | Last will and testament | — | ✅ |
| `lwt_qos` / `lwt_retain` | 1 / 1 | Will QoS / retain | QoS 0–2 | ✅ |
| `task_priority` / `task_stack_size` | 32 / 4096 | MQTT task priority / stack size | — | ✅ |
| `disable_auto_reconnect` | 0 | Disable auto reconnect | 0/1 | ✅ |
| `outbox_limit` / `outbox_resend_interval_ms` / `outbox_expired_timeout_ms` | 10 / 1000 / 30000 | Outbox capacity / resend interval / expiry timeout | — | ✅ |
| `reconnect_interval_ms` / `timeout_ms` | 10000 / 3000 | Reconnect interval / network timeout | — | ✅ |
| `buffer_size` / `tx_buf_size` / `rx_buf_size` | 0 / 1572864 / 102400 | Buffer sizes (0 = use buffer_size) | bytes | ✅ |

### Topics & reporting

| Field | Default | Description | Import |
|---|---|---|---|
| `data_receive_topic` | `ne302/XXXXXX/down/control` | Downlink control topic (MAC-derived, editable) | ✅ |
| `data_report_topic` | `ne302/XXXXXX/upload/report` | Data report topic | ✅ |
| `status_topic` | `aicam/status` | Status topic | ✅ |
| `command_topic` | `aicam/command` | Command topic | ✅ |
| `data_receive_qos` / `data_report_qos` / `status_qos` / `command_qos` | 0 | Per-topic QoS (0–2) | ✅ |
| `auto_subscribe_receive` / `auto_subscribe_command` | true | Auto-subscribe after connect | ✅ |
| `enable_status_report` / `status_report_interval_ms` | true / 60000 | Status reporting | ✅ |
| `enable_heartbeat` / `heartbeat_interval_ms` | true / 30000 | Heartbeat | ✅ |
| `report_content` | 0 | Report content: 0=image+metadata+AI result, 1=metadata+AI result only | ✅ |
| `telemetry_enabled` / `telemetry_topic` / `telemetry_qos` | false / MAC-derived / 0 | Telemetry | ✅ |
| `telemetry_format` | 0 | Telemetry format: 0=JSON, 1=CBOR | ✅ |

## work_mode_config (work mode & triggers)

Web entries: Function Debug (trigger config), streaming panel.

| Field | Default | Description | Enum | Import |
|---|---|---|---|---|
| `work_mode` | 0 | Work mode | 0=image mode | ✅ ⚠️ unused (image is the only mode) |
| `image_mode.enable` | true | Image mode (capture) enable | bool | ✅ ⚠️ unused |

### video_stream_mode (streaming)

| Field | Default | Description | Range | Import |
|---|---|---|---|---|
| `enable` | false | Video stream mode master switch | bool | ✅ ⚠️ unused (RTMP/RTSP are each gated by their own rtmp_enable / rtsp_enable; this parent switch has no consumer) |
| `rtmp_enable` | false | RTMP push switch | bool | ✅ |
| `rtmp_url` / `rtmp_stream_key` | empty | RTMP URL and stream key (stored in plaintext) | — | ✅ |
| `rtsp_enable` | false | RTSP server switch | bool | ✅ |
| `rtsp_port` | 554 | RTSP port | 1–65535 | ✅ |
| `rtsp_auth_mode` | "none" | RTSP authentication | none / digest (any other value is treated as no auth) | ✅ |
| `rtsp_username` / `rtsp_password` | empty | RTSP credentials (stored in plaintext) | — | ✅ |

### pir_trigger (PIR motion)

| Field | Default | Description | Range | Import |
|---|---|---|---|---|
| `enable` | false | PIR trigger switch | bool | ✅ |
| `pin_number` | 2 | PIR pin number | — | ✅ |
| `trigger_type` | 0 | Trigger edge | 0=rising, 1=falling, 2=both edges, 3=high level, 4=low level | ✅ |
| `sensitivity_level` | 30 | Sensitivity — **smaller is more sensitive** (recommended >30) | 0–255 | ✅ |
| `ignore_time_s` | 7 | Post-trigger ignore time; actual seconds = 0.5 + 0.5×value | 0–15 | ✅ |
| `pulse_count` | 1 | Qualifying pulse count; actual count = value + 1 | 1–4 | ✅ |
| `window_time_s` | 0 | Qualification window; actual seconds = 2 + 2×value | 0–3 | ✅ |
| `disable_in_preview` | true | Pause PIR captures during preview | bool | ✅ |

### timer_trigger (timer capture)

| Field | Default | Description | Range/enum | Import |
|---|---|---|---|---|
| `enable` | false | Timer trigger switch | bool | ✅ |
| `capture_mode` | 1 | Capture mode | 0=off, 1=interval, 2=absolute times | ✅ |
| `interval_sec` | 60 | Interval-mode capture interval | seconds | ✅ |
| `time_node_count` | 0 | Time-node count | 0–10; clamped on import (>10 or beyond the array length) | 🔧 |
| `time_node[10]` | 0 | Absolute-mode time points, **seconds since midnight** (e.g. 7:30 = 27000) | 0–86399 | ✅ |
| `weekdays[10]` | 0 | Weekday filter: 0=every day, 1–7=Mon…Sun; multiple entries allowed | 0–7 | ✅ |
| `interval_mode` | 0 | Interval-grid alignment | 0=normal (starts immediately), 1=scheduled (from daily start_time); out-of-domain ignored | 🔧 |
| `start_time` / `end_time` | 0 | Daily window start/end, seconds since midnight; the window **may cross midnight** (end < start wraps past 00:00); values ≥86400 are ignored | 0–86399 | 🔧 |
| `anchor_time` | 0 | Interval-grid anchor (seconds since midnight). The rolling window flows continuously across midnight; **0 = not-yet-stamped sentinel** (apply stamps it with the current time of day) and round-trips as-is | 0–86399 | 🔧 |

### io_trigger[] (IO triggers, fixed 2 entries)

⚠️ **The whole group is not wired up**: the registration API exists but has no callers — no effect in the current firmware. Each entry: `pin_number` (0/1), `enable`, `input_enable`, `output_enable`, `input_trigger_type`, `output_trigger_type` (enum same as the PIR `trigger_type`). Fields round-trip on export/import.

### remote_trigger

`enable`: remote-wake trigger switch, ✅ imported. Available only when the device is online via its own WiFi (the WiFi chip keeps the MQTT connection alive during sleep).

## webhook_config (webhook notifications)

Web entry: Application Management → Webhook.

| Field | Default | Description | Enum | Import |
|---|---|---|---|---|
| `enable` | false | Webhook switch | bool | ✅ |
| `url` | empty | Callback URL | — | ✅ |
| `auth_type` | empty | Auth method | empty=none, bearer, basic, custom | ✅ |
| `secret` | empty | Auth secret (stored in plaintext) | — | ✅ |

Note: the webhook **custom CA certificate is a separate file and does not round-trip** with the config — re-upload it on the target device.

## capture_upload_config (capture upload policy)

Web entry: Capture Settings. **The whole section passes through the same normalization as the web setter on import** (the "Import" column below lists the applied rules).

| Field | Default | Description | Range/enum | Import |
|---|---|---|---|---|
| `version` | 1 | Policy structure version | — | 🔧 0 → 1 |
| `mode` | 0 | Upload mode | 0=instant, 1=batch, 2=scheduled, 3=local-only | 🔧 out-of-range → 0 |
| `storage` | 0 | Storage target | 0=auto (SD preferred, flash fallback), 1=internal flash, 2=SD card, 3=none (instant mode only) | 🔧 out-of-range → 0; downgraded to 0 when =3 with mode≠0 |
| `policy` | 0 | Full-storage policy | 0=wrap (delete oldest), 1=stop | 🔧 out-of-range → 0 |
| `upload_protocol` | 0 | Upload protocol | 0=MQTT, 1=webhook | 🔧 out-of-range → 0 |
| `retry_enable` | true | Retry on failure | bool | 🔧 forced false when mode=3 or storage=3 |
| `retry_max_attempts` | 5 | Max retries per record | 0=unlimited, 1–20 | 🔧 >20 clamped to 20 |
| `batch_count` | 10 | Batch-mode records per flush | 2–20 | 🔧 <2 → 2, >20 → 20 |
| `schedule_node_count` | 0 | Scheduled-upload time count | 0–8 | 🔧 clamped to 8; shrinks when the array shrinks |
| `schedule_minutes[]` | [] | Scheduled upload times (**minutes of the day**, e.g. 7:30 = 450) | 0–1439 | 🔧 >1439 → 0 |
| `keep_sent_hours` | 72000 | Sent-record retention | hours; 72000 (≈8.2 years) = forever (deleted only on full/count cap) | 🔧 >72000 clamped to 72000 |
| `max_pending_records` | 200 | Pending-upload queue cap | 200–1000 | 🔧 0→200, >1000→1000; ⚠️ unused (the pipeline never reads this cap) |
| `flash_max_records` | 32 | Total flash record cap across all states | 16–256 | 🔧 0/out-of-range → 32, <16 → 16 |
| `upload_comm_type` | 0 | Upload network (**effective only for wake-time captures**) | 0=default logic, 1=WiFi, 2=HaLow, 3=4G, 4=PoE | ✅ |

## auth_mgr (login & sessions)

| Field | Default | Description | Import |
|---|---|---|---|
| `session_timeout_ms` | 3600000 | Session timeout (1 hour) | ✅ ⚠️ unused |
| `enable_session_timeout` | false | Enable session timeout | ✅ ⚠️ unused |
| `admin_password` | hicamthink | Admin password (**plaintext** in the file) | ✅ |

## sys_clk_profile (work frequency)

Web entry: Function Debug (work frequency). Stored in the FSBL config area, outside the json_config structure; attached separately by the export/import endpoints.

| Field | Default | Description | Range/enum | Import |
|---|---|---|---|---|
| `sys_clk_profile` | 4 (HSE 800) | Work frequency profile | 1=HSE 200MHz, 2=HSE 400MHz, 3=HSI 800MHz, 4=HSE 800MHz | 🔧 invalid values (0/5/non-numeric) reject the whole import; **an absent key keeps the current profile**; effective after reboot; factory reset clears it to the default; profile 3 is the FSBL boot clock, so storing 3 produces no switching action by design |

---

## Appendix: import behavior quick reference

| Category | Fields |
|---|---|
| Never imported (export-only) | The whole `device_info`; `light_config.connected`; `power_mode_config.last_activity_time / mode_switch_count`; the known-networks `rssi / channel / connected / is_known / last_connected_time`; `checksum / timestamp` (recomputed by the device) |
| Imported with special handling | `current_mode / default_mode` (out-of-domain ignored); `last_activity_time` (re-stamped locally); MQTT `*_cert_data` (Flash rewritten only when carried); the count fields (clamped); `capture_upload_config` normalized as a whole; `ap_sleep_time / wifi_country_code` out-of-set → treated as absent, device value kept; `sys_clk_profile` (validated, reboot-applied); `config_version` (gated + pinned) |
| Hand-edited file protection | Counts shrink when arrays shrink (time nodes / known networks / upload schedule); `time_node_count` capped at 10; `interval_mode / start_time / end_time / anchor_time` out-of-domain ignored; files with a version newer than the firmware rejected wholesale |
