camthink-ai/ne302/docs/web-api/endpoints/device.md

---
title: Device Management Endpoints
---

<!-- GENERATED FILE - do not edit manually. Regenerate with Script/gen_web_api_docs.py -->

# Device Management Endpoints

Device info, time, logs and maintenance

Source: [`Custom/Services/Web/api/api_device_module.c`](https://github.com/camthink-ai/ne302/blob/main/Custom/Services/Web/api/api_device_module.c)

**24** endpoints. The ✅ marker in the Auth column means the request must carry [credentials](../authentication.md).

| Method | Path | Auth | Handler |
|---|---|:----:|---|
| `GET` | `/api/v1/device/info` | ✅ | `device_info_handler` |
| `GET` | `/api/v1/device/firmware-versions` | ✅ | `firmware_versions_handler` |
| `GET` | `/api/v1/device/version-check` | ✅ | `version_check_handler` |
| `GET` | `/api/v1/device/storage` | ✅ | `device_storage_handler` |
| `POST` | `/api/v1/device/storage/config` | ✅ | `device_storage_config_handler` |
| `POST` | `/api/v1/device/storage/format` | ✅ | `device_storage_format_handler` |
| `GET` | `/api/v1/device/image/config` | ✅ | `device_image_config_handler` |
| `POST` | `/api/v1/device/image/config` | ✅ | `device_image_config_handler` |
| `GET` | `/api/v1/device/sys-clk/config` | ✅ | `device_sys_clk_config_handler` |
| `POST` | `/api/v1/device/sys-clk/config` | ✅ | `device_sys_clk_config_handler` |
| `GET` | `/api/v1/device/light/config` | ✅ | `device_light_config_handler` |
| `POST` | `/api/v1/device/light/config` | ✅ | `device_light_config_handler` |
| `GET` | `/api/v1/device/camera/config` | ✅ | `device_camera_config_handler` |
| `POST` | `/api/v1/device/camera/config` | ✅ | `device_camera_config_handler` |
| `POST` | `/api/v1/system/time` | ✅ | `system_time_handler` |
| `POST` | `/api/v1/device/name` | ✅ | `device_name_handler` |
| `GET` | `/api/v1/system/logs` | ✅ | `system_logs_handler` |
| `GET` | `/api/v1/system/logs/export` | ✅ | `system_logs_export_handler` |
| `POST` | `/api/v1/system/restart` | ✅ | `system_restart_handler` |
| `POST` | `/api/v1/system/factory-reset` | ✅ | `system_factory_reset_handler` |
| `GET` | `/api/v1/device/config/export` | ✅ | `device_config_export_handler` |
| `POST` | `/api/v1/device/config/import` | ✅ | `device_config_import_handler` |
| `GET` | `/api/v1/device/preference/stream_tab` | ✅ | `device_pref_stream_tab_handler` |
| `POST` | `/api/v1/device/preference/stream_tab` | ✅ | `device_pref_stream_tab_handler` |
