camthink-ai/ne302/Docs/NE302_v4.3.1_HTTP_API_cn.md

# NE302 HTTP API 参考文档

| 项目 | 内容 |
|---|---|
| **适用固件版本(APP)** | **v4.3.1.x**(BUILD 号随提交递增) |
| 文档日期 | 2026-09-14 |
| 文档来源 | 已按当前工作区 `Custom/Services/Web/` 及相关实现核对;示例与耗时数据取自参考设备 |

> 若固件与本文描述不一致,以固件实现为准。

## 0. 软件版本信息

| 组件 | 版本 | 说明 |
|---|---|---|
| APP(主应用固件) | 4.3.1.x | `Custom/Common/Inc/version.h` 自动生成(BUILD 号 = 自 `v4.3.1-base` 标签的提交计数) |
| FSBL(一级引导) | 1.0.3.1(期望值) | `EXPECTED_FSBL_VERSION_STRING`,实际版本运行时比对 |
| WiFi/Si91x 固件 | 2.16.5.108(期望值) | `EXPECTED_WIFI_VERSION_STRING`,实际版本运行时比对 |
| Web 资源(前端) | 1.5.0.8 | 随版本包发布,运行时经 `/device/firmware-versions` 查询 |
| AI 模型包 | 4.0.0.0 | 同上 |
| WakeCore | 0.2.7.5 | 同上 |

运行时通过 `GET /api/v1/device/firmware-versions` 可查询各组件**实际运行版本**,通过 `GET /api/v1/device/version-check` 可比对 FSBL/WiFi 固件是否与 APP 期望一致。

---

## 1. 通用约定

### 1.1 服务与基础地址

| 项目 | 值 |
|---|---|
| HTTP 服务 | Mongoose,监听 **TCP 80** 端口 |
| HTTPS | 未启用(`IS_HTTPS=0`) |
| API 基础路径 | **`/api/v1`** |
| 单请求体上限 | 5 MB(经路由器的普通请求) |
| 连接模式 | `Connection: close`,一连接一请求 |
| 静态资源 | Web UI 由根路径 `/` 直接提供(支持 ETag/304/gzip) |

设备地址:
- STA/以太网模式:设备获得的 IP(见路由器/AP,或经配置工具查询)
- AP 模式:设备热点网关地址(默认 `192.168.10.10`,网段 `192.168.10.0/24`;内置 DHCP 服务器自 `192.168.10.100`–`192.168.10.250` 分配地址。以设备实际配置为准)

**典型耗时**(参考值,参考设备静置状态):常规只读 GET **13–40 ms**;较重端点如 `capture/queue` ≈ 0.4 s、`system/logs/export` ≈ 1.2 s(354 KB)、`device/config/export` ≈ 0.1 s。空闲一段时间后的首个请求可能达数百毫秒。

### 1.2 认证

- 采用 **HTTP Basic 认证**,每个请求独立校验,无会话/Cookie。
- 用户名固定 **`admin`**(`auth_mgr.h: AUTH_ADMIN_USERNAME`),密码为设备访问密码。
- 密码可经 `POST /api/v1/login` 校验、经 `POST /api/v1/change-password` 修改。

**免认证端点**(路由表中 `require_auth=false`):

| 端点 | 说明 |
|---|---|
| `POST /api/v1/login` | 密码校验 |
| `POST /api/v1/preview/start` | 启动预览 |
| `POST /api/v1/preview/stop` | 停止预览 |

> 注:`POST /api/v1/system/ota/upload` 在路由分发之前被流式拦截器接管,自行校验,详见 16.2 节。

**认证失败响应**(普通接口):HTTP 状态码仍为 **200**,信封内 `error_code: "UNAUTHORIZED"`、`message: "Authentication required"`。流式上传接口(`files/upload`、`ota/upload`)例外,返回真实 `401`。

### 1.3 统一响应信封

所有经路由器的接口,无论成功失败,**HTTP 状态码恒为 200**,正文为 JSON 信封:

```jsonc
// 成功
{
  "success": true,
  "message": "Device information retrieved successfully",   // 可选
  "data": { ... }                                            // 可选
}

// 失败
{
  "success": false,
  "error_code": "INVALID_PASSWORD",   // 仅失败时出现,字符串名
  "message": "Invalid password"
}
```

| 字段 | 类型 | 说明 |
|---|---|---|
| success | bool | 业务成败 |
| error_code | string | 仅失败时出现,大写下划线字符串(见 1.5);流式端点(`files/upload`)成功时带 `"error_code":"NONE"` |
| message | string | 人读描述,成功/失败均可能出现 |
| data | object/array/null | 业务数据,可能缺省 |

> **客户端务必以 `success` 字段判错,不能依赖 HTTP 状态码。**

### 1.4 信封例外(返回真实 HTTP 状态码/非 JSON 的接口)

| 接口 | 响应形式 |
|---|---|
| `GET /api/v1/files/download` | 原始文件字节流 + `Content-Disposition: attachment; filename="…"`;文件不存在时为信封 JSON(`NOT_FOUND`,HTTP 200) |
| `GET /api/v1/files/preview` | 图片(≤2 MB)返回原始字节;**其余任意类型文件**返回内嵌 content 的 JSON 信封——preview **无扩展名白名单**(白名单只约束 `files/edit`) |
| `POST /api/v1/files/upload` | 流式直写,认证失败 **401**、缺参数 400、内部错 500/503(真实状态码) |
| `POST /api/v1/system/ota/upload` | 流式直写,真实状态码 400/401/500 |
| `POST /api/v1/system/ota/export` | 原始固件字节流 + `Content-Disposition` |
| `GET /` 静态资源 | SPA 回退:未知路径一律 **200 + `index.html`**(不存在 404);带正确 `ETag` 重发返回 304 |
| `OPTIONS` 预检 | 200 + CORS 头 |

### 1.5 错误码

#### 1.5.1 框架错误码(web_server.h `api_error_code_t`)

| HTTP 语义 | error_code 字符串 | 触发场景 |
|---|---|---|
| 400 | `INVALID_REQUEST` | 参数缺失/非法、JSON 解析失败、Content-Type 错 |
| 401 | `UNAUTHORIZED` | Basic 认证失败 |
| 404 | `NOT_FOUND` | 路径未注册 |
| 405 | `METHOD_NOT_ALLOWED` | 方法不匹配(方法匹配不区分大小写) |
| 500 | `INTERNAL_ERROR` | 内部错误 |
| 503 | `SERVICE_UNAVAILABLE` | 依赖服务未运行(如无 SD 卡时的 `fs=sd`、无蜂窝模组时的 cellular 查询) |

#### 1.5.2 业务错误码(api_business_error.h,1001 起)

| 码 | error_code 字符串 | 含义 |
|---|---|---|
| 1001 | `INVALID_PASSWORD` | 密码错误 |
| 1002 | `INVALID_CREDENTIALS` | 用户名或密码错误 |
| 1003 | `UNAUTHORIZED` | 未授权 |
| 1004 | `SESSION_EXPIRED` | 会话过期 |
| 1005 | `TOKEN_INVALID` | 令牌无效 |
| 1007 | `PERMISSION_DENIED` | 权限不足 |
| 1101 | `INVALID_PARAM` | 参数无效 |
| 1102 | `MISSING_PARAM` | 缺少必填参数 |
| 1103 | `PARAM_OUT_OF_RANGE` | 参数超范围 |
| 1104 | `INVALID_FORMAT` | 数据格式错误 |
| 1201 | `DEVICE_OFFLINE` | 设备离线 |
| 1202 | `DEVICE_BUSY` | 设备忙 |
| 1204 | `CAMERA_ERROR` | 相机错误 |
| 1206 | `HARDWARE_ERROR` | 硬件错误 |
| 1301 | `NETWORK_ERROR` | 网络错误 |
| 1302 | `NETWORK_TIMEOUT` | 网络超时 |
| 1304 | `MQTT_NOT_CONNECTED` | MQTT 未连接 |
| 1305 | `WIFI_NOT_CONNECTED` | WiFi 未连接 |
| 1401 | `STORAGE_FULL` | 存储已满 |
| 1403 | `FILE_NOT_FOUND` | 文件未找到 |
| 1407 | `INSUFFICIENT_SPACE` | 存储空间不足 |
| 1408 | `DIR_NOT_EMPTY` | 目录非空不可删 |
| 1501 | `MODEL_NOT_LOADED` | AI 模型未加载 |
| 1502 | `MODEL_INVALID` | AI 模型无效 |
| 1503 | `MODEL_RELOAD_FAILED` | 模型重载失败 |
| 1505 | `INFERENCE_TIMEOUT` | 推理超时 |
| 1601 | `CONFIG_INVALID` | 配置无效 |
| 1602 | `CONFIG_NOT_FOUND` | 配置未找到 |
| 1604 | `CONFIG_UPDATE_FAILED` | 配置更新失败 |
| 1701 | `OPERATION_TIMEOUT` | 操作超时 |
| 1702 | `OPERATION_FAILED` | 操作失败 |
| 1705 | `OPERATION_IN_PROGRESS` | 操作进行中(忙) |
| 1706 | `AT_COMMAND_FAILED` | AT 命令失败(蜂窝模组) |
| 1801 | `FIRMWARE_INVALID` | 固件无效 |
| 1804 | `OTA_IN_PROGRESS` | OTA 升级进行中 |
| 1805 | `OTA_FAILED` | OTA 升级失败 |
| 1806 | `OTA_HEADER_VALIDATION_FAILED` | OTA/捆绑包头校验失败 |
| 1901 | `RESOURCE_NOT_FOUND` | 资源未找到 |
| 1902 | `RESOURCE_BUSY` | 资源忙 |
| 2001–2008 | `ISP_*`(见 17 节) | ISP 业务错(2001 未初始化 / 2002 参数错 / 2003 超范围 / 2004 依赖 / 2005 HAL / 2006 传感器 / 2007 算法 / 2008 忙) |
| 9999 | `UNKNOWN` | 未知错误 |

### 1.6 CORS 与预检

所有响应带 CORS 头;`OPTIONS` 预检直接以 200 应答,不进业务路由:

```
Access-Control-Allow-Origin: *
Access-Control-Allow-Methods: GET, POST, PUT, DELETE, OPTIONS
Access-Control-Allow-Headers: Content-Type, Authorization
Access-Control-Max-Age: 86400
```

### 1.7 实时预览流(WebSocket,不属于 HTTP API)

预览流运行在独立 WebSocket 服务:**`ws://<设备IP>:8081/stream`**(默认端口 8081,路径 `/stream`)。详见[附录 B](#附录-bwebsocket-预览流)。

---

## 2. 端点总览

15 个模块、约 140 个端点,全部位于 `/api/v1` 下,除标注「免认证」外均需 Basic 认证。**所有网络管理端点注册于 `/api/v1/system/network/…` 前缀下。**

| # | 模块 | 前缀 | 端点数 |
|---|---|---|---|
| 3 | 认证 | `/login`、`/change-password` | 2 |
| 4 | 设备与系统 | `/device/*`、`/system/*` | 21 |
| 5 | 网络 | `/system/network/*`(wifi / halow / comm / cellular / poe) | 44 |
| 6 | 抓拍与上传 | `/capture/*` | 6 |
| 7 | 实时预览 | `/preview/*`(免认证) | 2 |
| 8 | 文件管理 | `/files/*` | 8 |
| 9 | AI 检测 | `/ai/*` | 4 |
| 10 | 模型管理 | `/model/*` | 2 |
| 11 | 工作模式/电源模式 | `/work-mode/*`、`/power-mode/*` | 8 |
| 12 | MQTT | `/apps/mqtt/*`、`/device/capture` | 5 |
| 13 | RTMP 推流 | `/apps/rtmp/*` | 5 |
| 14 | RTSP 服务 | `/apps/rtsp/*` | 5 |
| 15 | Webhook | `/apps/webhook/*` | 6 |
| 16 | 固件升级(OTA) | `/system/ota/*` | 7 |
| 17 | ISP 图像质量 | `/isp/*` | 27 |
| — | 静态资源/Web UI | `/` | — |

> 12 个 HaLow 端点仅在固件启用 HaLow 时注册(`NETIF_WIFI_HALOW_IS_ENABLE`),本构建已启用。

---

## 3. 认证模块(auth)

### 3.1 POST /api/v1/login — 校验设备密码

**免认证。** 供登录页校验密码(用户名固定 `admin`,不上送)。

**请求体**

| 字段 | 类型 | 必填 | 说明 |
|---|---|---|---|
| password | string | 是 | 设备访问密码 |

**响应示例**

```jsonc
// 密码正确
{"success": true, "message": "Login successful"}
// 密码错误、缺字段或 JSON 类型错
{"success": false, "error_code": "INVALID_PASSWORD", "message": "Login failed, invalid password"}
// Content-Type 错
{"success": false, "error_code": "INVALID_REQUEST", "message": "Invalid Content-Type"}
```

### 3.2 POST /api/v1/change-password — 修改设备密码

**请求体**

| 字段 | 类型 | 必填 | 说明 |
|---|---|---|---|
| password | string | 是 | 新密码,**8–32 字符** |

**响应 data**:`null`,`message: "Password changed successfully"`。

**说明**:立即生效——之后的请求(login 与 Basic 认证同步)必须用新密码,旧密码立刻失效。

**错误**:长度越界 → `INVALID_REQUEST`("Invalid password length");缺字段 → `INVALID_REQUEST`("Missing required parameters")。

---

## 4. 设备与系统模块(device / system)

### 4.1 GET /api/v1/device/info — 设备信息

**响应 data**

| 字段 | 类型 | 说明 |
|---|---|---|
| device_name | string | 设备名(1–63 字符,见 4.6) |
| mac_address | string | MAC 地址 |
| serial_number | string | 序列号 |
| hardware_version | string | 硬件版本 |
| software_version | string | 软件版本(APP 固件版本) |
| camera_module | string | 相机模组 |
| extension_modules | string | 扩展模块 |
| power_supply_type | string | 供电类型 |
| battery_percent | number | 电池百分比 |
| communication_type | string | 当前通信方式 |
| storage_card_info | string | 存储卡信息 |
| storage_usage_percent | number | 存储使用率(%) |

**示例**

```json
{"success":true,"message":"Device information retrieved successfully","data":{
  "device_name":"NE302-278C51","mac_address":"44:9f:da:27:8c:51","serial_number":"SN202500001",
  "hardware_version":"1.3.0","software_version":"4.3.1.107","camera_module":"CMW_OS04C10",
  "extension_modules":"None","power_supply_type":"external_power","battery_percent":0,
  "communication_type":"wifi","storage_card_info":"No SD Card","storage_usage_percent":9}}
```

### 4.2 GET /api/v1/device/firmware-versions — 各组件固件版本

**响应 data**

| 字段 | 类型 | 说明 |
|---|---|---|
| fsbl | string | 实际运行 FSBL 版本 |
| app | string | 实际运行 APP 版本 |
| web | string | Web 资源版本 |
| model | string | AI 模型包版本 |
| wakecore | string | WakeCore 版本 |
| wifi | string | Si91x WiFi/HaLow 固件版本 |
| wifi_running | string | WiFi 固件运行态标记 |
| expected_fsbl | string | APP 期望的 FSBL 版本 |
| expected_wifi | string | APP 期望的 WiFi 固件版本 |

**示例**

```json
{"fsbl":"1.0.3.1","app":"4.3.1.107","web":"1.5.0.8","model":"4.0.0.0","wakecore":"0.2.7.5",
 "wifi":"2.16.5.108","wifi_running":"2.16.5.108","expected_fsbl":"1.0.3.1","expected_wifi":"2.16.5.108"}
```

### 4.3 GET /api/v1/device/version-check — FSBL/WiFi 版本一致性

**响应 data**

| 字段 | 类型 | 说明 |
|---|---|---|
| fsbl_mismatch | bool | FSBL 实际 ≠ 期望 |
| wifi_mismatch | bool | WiFi 固件实际 ≠ 期望 |
| expected_fsbl / current_fsbl | string | 期望 / 实际 FSBL 版本 |
| expected_wifi / current_wifi | string | 期望 / 实际 WiFi 固件版本 |

### 4.4 GET /api/v1/device/storage — 存储信息

**响应 data**(SD 卡 + flash 分区)

| 字段 | 类型 | 说明 |
|---|---|---|
| sd_card_connected | bool | 是否插有 SD 卡 |
| total_capacity_mb / available_capacity_mb / used_capacity_mb | number | SD 容量(MB) |
| usage_percent | number | SD 使用率(%) |
| total_capacity_gb / available_capacity_gb / used_capacity_gb | number | SD 容量(GB) |
| cyclic_overwrite_enabled | bool | 循环覆盖开关 |
| overwrite_threshold_percent | number | 覆盖阈值(%) |
| flash_fs_mounted | bool | flash 文件系统已挂载 |
| flash_fs_error | bool | flash 文件系统错误 |
| flash_error | string | flash 错误描述 |
| flash_total_capacity_mb / flash_available_capacity_mb / flash_used_capacity_mb | number | flash 容量(MB) |
| flash_usage_percent | number | flash 使用率(%) |
| flash_total_capacity_gb / flash_available_capacity_gb / flash_used_capacity_gb | number | flash 容量(GB) |
| flash_fs_type | string | flash 文件系统类型(littlefs) |
| status | string | 存储状态概述 |
| primary_storage | string | 主存储(sd / flash) |

**示例**(无 SD 卡):

```json
{"sd_card_connected":false,"total_capacity_mb":0,"available_capacity_mb":0,"used_capacity_mb":0,
 "usage_percent":0,"total_capacity_gb":0,"available_capacity_gb":0,"used_capacity_gb":0,
 "cyclic_overwrite_enabled":true,"overwrite_threshold_percent":80,"flash_fs_mounted":true,
 "flash_fs_error":false,"flash_error":"","flash_total_capacity_mb":32,"flash_available_capacity_mb":28,
 "flash_used_capacity_mb":4,"flash_usage_percent":12.5,"flash_total_capacity_gb":0.03,
 "flash_available_capacity_gb":0.03,"flash_used_capacity_gb":0.004,"flash_fs_type":"littlefs",
 "status":"normal","primary_storage":"flash"}
```

### 4.5 POST /api/v1/device/storage/format — 格式化内部 flash

**请求体**:无(任何 body 均被忽略;没有目标选择——该端点**一律格式化内部 flash LittleFS 卷**)。

**响应 data**:`{success}`,message `"Flash formatted"`——操作为同步完成(数百毫秒)。格式化会清除 flash 上全部文件(日志、抓拍、上传资源);NVS 设备配置在独立分区,**不受影响**。完成后抓拍目录树重建、记录计数清零;请重新获取 `/device/storage` 与 `/capture/queue`。

### 4.6 POST /api/v1/device/name — 设备改名

**请求体**:`{device_name: string}`(**1–63 字符**;空串或超长 → `INVALID_REQUEST`)。

**响应 data**:`{message, device_name}`。

### 4.7 GET / POST /api/v1/device/image/config — 图像配置

GET 返回当前配置;POST 为部分更新(只发需要变更的字段)。

**字段**(GET 返回 / POST 可选)

| 字段 | 类型 | 取值 | 说明 |
|---|---|---|---|
| brightness | number | 0–100 | ⚠ **已废弃**——接受但不生效(见下文说明) |
| contrast | number | 0–100 | ⚠ **已废弃**——接受但不生效(见下文说明) |
| horizontal_flip | bool | — | 水平翻转 |
| vertical_flip | bool | — | 垂直翻转 |
| aec | number | 0–100 | ⚠ **已废弃**——接受但不生效(见下文说明) |
| isp_mode | number | 0(室外)/ 1(室内)/ 255(自定义) | ISP 场景模式 |
| grayscale | bool | — | 灰度输出 |
| fast_capture_skip_frames | number | 0–300 | 快拍跳帧 |
| fast_capture_resolution | number | 0(1280×720)/ 1(1920×1080)/ 2(2688×1520) | 快拍分辨率 |
| fast_capture_jpeg_quality | number | 1–100 | 快拍 JPEG 质量 |
| capture_disable_comm | bool | — | 抓拍期间暂停通信 |
| capture_storage_ai | bool | — | 存储 AI 叠加图 |

**⚠ 废弃字段**:`brightness`、`contrast`、`aec` 已废弃。携带这些字段的请求仍会成功(值会被范围校验并在响应中回显),但设置**不生效、不保留**——调整它们对图像没有任何影响。曝光/对比度等图像质量请改经 ISP 模块(见 17 节)控制。

**说明**:POST `horizontal_flip`/`vertical_flip` 会自动重启 AI 流水线(先停后启);建议 POST 后再 GET 复核生效值。

### 4.8 GET / POST /api/v1/device/sys-clk/config — CPU 主频配置

由 FSBL 持久化,**重启后生效**。

**GET 响应 data**

| 字段 | 类型 | 说明 |
|---|---|---|
| valid | bool | 配置读取是否有效 |
| sys_clk_profile | number | 当前主频档位 |

**POST 请求体**

| 字段 | 类型 | 必填 | 说明 |
|---|---|---|---|
| sys_clk_profile | number | 是 | 1=HSE 200 MHz,2=HSE 400 MHz,3=HSI 800 MHz,4=HSE 800 MHz(仅接受整数) |

### 4.9 GET / POST /api/v1/device/light/config — 补光灯配置

**GET 响应 data**

| 字段 | 类型 | 说明 |
|---|---|---|
| connected | bool | 补光灯已连接 |
| mode | string | `off` / `on` / `auto` / `custom` |
| brightness_level | number | 亮度 0–100 |
| fill_light_while_streaming | bool | 工作期间补光模式(设备运行期间按配置无条件开灯) |
| custom_schedule | object | 定时开灯计划 `{start_hour, start_minute, end_hour, end_minute}` |

**POST 请求体**(全部可选)

| 字段 | 类型 | 说明 |
|---|---|---|
| mode | string | `off`/`on`/`auto`/`custom` |
| brightness_level | number | 0–100 |
| fill_light_while_streaming | bool | 同上 |
| custom_schedule | object | 同 GET |

**响应 data**:回显生效配置。

### 4.10 POST /api/v1/system/time — 设置系统时间

**请求体**

| 字段 | 类型 | 必填 | 说明 |
|---|---|---|---|
| timestamp | number | 否 | UTC epoch 秒;缺省时保留当前系统时间 |
| timezone | string | 否 | 时区名(`Asia/Shanghai`、`America/New_York`、`America/Los_Angeles`、`Europe/London`、`Europe/Paris`、`Asia/Tokyo`)或 `UTC±N` |

**响应 data**:`{message, utc_timestamp, local_timestamp, timezone_offset_hours, utc_time, local_time}`

**示例**

```json
{"message":"System time updated successfully","utc_timestamp":1789394898,
 "local_timestamp":1789423698,"timezone_offset_hours":8,
 "utc_time":"2026-09-14 14:08:18 UTC","local_time":"2026-09-14 22:08:18"}
```

**说明**:设备也会经 SNTP/U0 对时;web 路径走 RTC 调度器(带步进保护)。不支持的时区名 → `INVALID_REQUEST`。该路径无 GET。

### 4.11 GET /api/v1/system/logs — 读取日志

**查询参数**:`file`(日志文件名,可选,默认主日志 `aicam.log`)

**响应 data**:`{content(日志文本), size}`;文件级清单见 4.12。

### 4.12 GET /api/v1/system/logs/export — 导出日志

**响应 data**:`{log_files: [{filename, size, content}], total_files, total_size}`——完整返回 `aicam.log`、`aicam.log.1`… 轮转集(数百 KB 响应,需数秒)。

### 4.13 POST /api/v1/system/restart — 重启设备

**请求体**:`{delay_seconds?: number}`(默认 3)

**响应 data**:`{delay_seconds}`(由后台任务异步执行)。重启后 web 服务一般在 **约 25 秒**内恢复应答(引导 ~1 s、系统拉起 ~5 s、随后服务启动)。

### 4.14 GET /api/v1/device/config/export — 导出设备配置

**响应 data**

| 字段 | 类型 | 说明 |
|---|---|---|
| export_version | string | 导出格式版本 |
| export_timestamp | number | 导出时间戳 |
| config | object | 结构化配置(按模块:network_service、mqtt_service、work_mode_config、power_mode_config、auth_mgr…) |
| config_raw | string | 原始配置文本 |

`config.sys_clk_profile`(工作主频,1–4)仅在设备有实际档位时挂接;从未修改过的设备(档位 0)省略该键。

**示例**(结构概览;`config` 内每个服务一段):

```json
{"export_version":"1.0","export_timestamp":1789440008,
 "config":{"config_version":1,"magic_number":"...","checksum":"...","timestamp":"...",
           "log_config":{...},"ai_debug":{...},"power_mode_config":{...},"device_info":{...}, ...}}
```

### 4.15 POST /api/v1/device/config/import — 导入设备配置

**请求体**:4.14 导出的 `data` 原样(或仅其中的 `config` 对象)。

**响应 data**:`{message, config_version, timestamp, checksum, saved_to_file}`——全量配置的应用与持久化需数秒。

**错误**:缺 `config`/`config_raw` → `INVALID_REQUEST`;`sys_clk_profile` 携带且不是 0–4 的整数(负数/小数/超范围/非数字)→ `INVALID_REQUEST`。

`config.sys_clk_profile` 缺失或为 0 时保持设备当前工作主频;1–4 经与专用设置接口相同的 FSBL 路径应用(重启后生效)。

### 4.16 GET / POST /api/v1/device/preference/stream_tab — Web UI 偏好

**GET 响应 data**:`{stream_tab: string}`(前端记忆的流标签页)
**POST 请求体**:`{stream_tab: string}`——POST 响应 `data` 为空,请经 GET 复核。

---

## 5. 网络模块(network)

所有端点注册于 **`/api/v1/system/network/…`** 前缀下。WiFi 配置端点另接受短别名 `POST /system/network/wifi`。

### 5.1 GET /api/v1/system/network/status — 通信总览

**响应 data**

| 字段 | 类型 | 说明 |
|---|---|---|
| service_state | string | 通信服务状态 |
| service_version | string | 服务版本 |
| active_type | string | 当前激活通信方式(wifi/cellular/poe/halow…) |
| selected_type | string | 选定方式 |
| current_comm_type | string | 当前通信方式 |
| has_connection | bool | 是否有可用连接 |
| active_display_name / selected_display_name / current_comm_display_name | string | 显示名 |
| available_comm_types | array | `[{type, display_name, is_selected, is_active, is_connected, is_current}]` |
| available_comm_count | number | 可用方式数 |
| preferred_type | string | 优选方式 |
| auto_priority | bool | 自动优先级选择 |
| is_auto_selection | bool | 自动选择模式 |
| selection_mode | string | 选择模式 |
| current_comm_info | object | `{status, ip_address, signal_strength, ssid?, isp?, message}` |

**示例**(节选):

```json
{"service_state":"running","service_version":"1.0.0","active_type":"wifi","selected_type":"wifi",
 "current_comm_type":"wifi","has_connection":true,"active_display_name":"WiFi",
 "available_comm_types":[{"type":"wifi","display_name":"WiFi","is_selected":true,"is_active":true,
   "is_connected":true,"is_current":true},
  {"type":"halow","display_name":"Wi-Fi HaLow","is_selected":false,"is_active":false,
   "is_connected":false,"is_current":false}],
 "available_comm_count":2,"preferred_type":"none","auto_priority":true,"is_auto_selection":true,
 "selection_mode":"auto","current_comm_info":{"status":"Connected","ip_address":"192.168.93.95",
 "signal_strength":-45}}
```

### 5.2 GET /api/v1/system/network/wifi/sta — WiFi STA 状态

**响应 data**:`{connected, ssid, bssid, rssi, channel, ip_address, mac_address, state, scan_results, scan_in_progress}`——末两个字段内嵌扫描数据,结构同 5.6。

**示例**(STA 未连接):`{"connected":false,"ssid":"CAMTHINK_DEV","bssid":"00:00:00:00:00:00","rssi":0,"channel":0,"ip_address":"0.0.0.0","mac_address":"44:9F:DA:27:8C:50","state":"down","scan_results":{"known_networks":[],"known_count":0,"unknown_networks":[],"unknown_count":0},"scan_in_progress":false}`

### 5.3 GET /api/v1/system/network/wifi/info — WiFi STA 链路与 IP 详情

实时链路层数据 + 完整 IP 配置,与 PoE / cellular 的 info 端点对齐。链路信息来自无线驱动;IP 值取自 lwIP netif 与解析器。

**响应 data**

| 字段 | 类型 | 说明 |
|---|---|---|
| connected | bool | STA 链路已连接 |
| ssid / bssid | string | 当前 AP 名 / BSSID(`AA:BB:CC:DD:EE:FF`) |
| rssi | number | 信号强度,dBm |
| channel | number | 工作信道 |
| security | string | 如 `wpa2_psk` |
| ip_mode | string | `dhcp` / `static` |
| ip_address / netmask / gateway | string | 实时 lwIP netif 值 |
| dns_primary / dns_secondary | string | 解析器 DNS(未设置时为空串) |
| mac_address | string | STA MAC 地址 |

> 驱动查询失败时仅返回 `{connected: false, error}`。

**示例**(STA 未连接):`{"connected":false,"ssid":"CAMTHINK_DEV","bssid":"00:00:00:00:00:00","rssi":0,"channel":0,"security":"wpa_wpa2_mixed","ip_mode":"dhcp","ip_address":"0.0.0.0","netmask":"0.0.0.0","gateway":"0.0.0.0","mac_address":"44:9F:DA:27:8C:50","dns_primary":"8.8.8.8","dns_secondary":"8.8.4.4"}`

### 5.4 GET /api/v1/system/network/wifi/ap — WiFi AP 状态

**响应 data**:`{enabled, state, ip_address, mac_address, channel, ssid, password, ap_sleep_time, security}`

| 字段 | 说明 |
|---|---|
| enabled / state | AP 开关 / 接口状态(`up` / `down`) |
| ip_address | AP 网关地址(默认 `192.168.10.10`) |
| channel | 工作信道 |
| ssid / password | 热点名 / 密码（存有密码时会回显但**不生效**——见下方说明） |
| ap_sleep_time | 空闲休眠时间(秒；固定档 0/600/1200/1800) |
| security | 安全类型——本固件版本恒为 `open` |

**示例**:`{"enabled":true,"state":"up","ip_address":"192.168.10.10","mac_address":"44:9F:DA:27:8C:51","channel":6,"ssid":"NE302_278C51","password":"","ap_sleep_time":0,"security":"open"}`

> AP 密码**明文返回**(设备端不掩码)。
>
> **本固件版本热点不再支持设置密码**——始终以开放方式运行（WiFi 芯片固件限制：AP 设置密码后，STA 无法连接网络）。旧固件上保存过的密码仍会存储并在此回显，但不会生效；网页端已隐藏热点密码输入框。

### 5.5 POST /api/v1/system/network/wifi/config — 配置并连接 WiFi

别名:`POST /system/network/wifi`。

**请求体**

| 字段 | 类型 | 必填 | 说明 |
|---|---|---|---|
| interface | string | 否 | `ap`(配置热点)/ `wl`(以 STA 连接),默认 STA |
| ssid | string | 是 | SSID,1–31 字符 |
| password | string | 是 | 密码,8–63 字符。STA：连接凭据。AP：接受并存储但**不生效**——本固件版本热点始终以开放方式运行 |
| bssid | string | 否 | 锁定特定 BSSID |
| ap_sleep_time | number | 否 | AP 空闲休眠时间：仅允许 0（永不）/ 600 / 1200 / 1800 s（interface=ap 时） |
| use_saved_password | bool | 否 | 用已保存密码连接 |

**响应 data**:`{message, interface, ssid, ap_sleep_time}`(连接为异步;轮询 5.1/5.2)

**实测**:带显式密码连接路由器约 3.5 秒成功,并**保存该网络**;此后 `{ssid, use_saved_password: true}` 可**不送密码直接重连**(约 3.5 秒)。

**错误**:STA 无法拉起时(如该 SSID 无可用保存凭据)约 6–7 秒后失败,`NETWORK_TIMEOUT`("Failed to configure WiFi interface")。**不建议连接另一台 NE302 的热点**——两台设备的 AP 网段默认均为 `192.168.10.0/24`,会互相冲突。

### 5.6 POST /api/v1/system/network/wifi/scan — 扫描 WiFi

**请求体**:空 JSON 或 `{}`(可含 `force`)

**响应 data**:扫描触发的确认(仅 message)。**扫描结果不在本端点返回**——请轮询 `GET /system/network/wifi/sta`(5.2),读取其 `scan_results` / `scan_in_progress` 字段(触发数秒后填充完整)。

| 字段 | 类型 | 说明 |
|---|---|---|
| scan_results | object | 位于 `wifi/sta` 响应中:`{known_networks[], unknown_networks[], known_count, unknown_count}` |
| scan_in_progress | bool | 位于 `wifi/sta` 响应中:扫描进行中 |

扫描条目字段:

| 字段 | 说明 |
|---|---|
| ssid / bssid | SSID / BSSID |
| rssi | 信号强度 |
| channel | 信道 |
| security | 安全类型(open/wpa2…) |
| connected | 当前已连接 |
| is_known / quick_connect | 已保存 / 支持快连 |
| last_connected_time | 上次连接时间戳 |

### 5.7 POST /api/v1/system/network/wifi/disconnect — 断开 WiFi

**请求体**:`{interface: "wl"}`。响应 `data:{message, interface, if_name, status}`

**示例**:`{"message":"WiFi interface disconnected successfully","interface":"wl","if_name":"wl","status":"disconnected"}`

### 5.8 POST /api/v1/system/network/wifi/delete — 删除已保存网络

**请求体**:`{ssid}`(interface 可选)。响应 `data:{status, message}`

### 5.9 GET /api/v1/system/network/wifi/region — WiFi 区域码

**响应 data**:`{region, active_region, supported_regions[]}`(仅 us/eu/jp/kr/cn 合法)

**示例**:`{"region":"us","active_region":"us","supported_regions":["us","eu","jp","kr","cn"]}`

### 5.10 PUT /api/v1/system/network/wifi/region — 设置 WiFi 区域码

**请求体**:`{region}`。**响应 data**:`{region, restart_required, message}`

**示例**:`{"region":"us","restart_required":true,"message":"WiFi region saved, applies on next restart"}`

### 5.11 HaLow 组(`/api/v1/system/network/halow/*`,12 个端点)

| 端点 | 方法 | 说明 |
|---|---|---|
| /api/v1/system/network/halow/sta | GET | HaLow STA 状态:`{connected, ssid, bssid, rssi, channel, ip_address, netmask, gateway, ip_mode, mac_address, state, region, supported_regions[], scan_results, scan_in_progress}` |
| /api/v1/system/network/halow/info | GET | 链路/IP 详情(同 5.3) |
| /api/v1/system/network/halow/region | GET | `{region, supported_regions[]}` |
| /api/v1/system/network/halow/region | PUT | `{region}` → `{region, message, scan_required}` |
| /api/v1/system/network/halow/scan | POST | 触发扫描——message `"HaLow scan started"`,异步;结果出现在 `GET halow/sta` 的 `scan_results` 中。注:HaLow 与 PoE 互斥为**设计行为**——拉起 HaLow 射频(仅为扫描也算)会使 PoE 数据接口失效;断开 HaLow 后需重启设备以重建 PoE 接口 |
| /api/v1/system/network/halow | POST | 连接:`{ssid, password?, bssid?, security?, region?, use_saved_password?}` → `{message:"HaLow connected successfully", interface, ssid}`(实测约 7 s;DHCP 取址,如 192.168.12.x)。携带密码时凭据**被保存并在每次开机自动重连**(只要 HaLow 基站在覆盖内,PoE 将一直被复用挤占)。无密码且无可用保存凭据 → `INVALID_REQUEST "Saved credentials not available for this network"` |
| /api/v1/system/network/halow/disconnect | POST | `{message, interface: "halow", status: "disconnected"}`(空闲时幂等)。断开**不会**自动恢复 PoE——需要重启设备 |
| /api/v1/system/network/halow/delete | POST | `{ssid}` 删除已保存网络 → `{status: "deleted", message: "HaLow network cleared"}`(未知 SSID 也报成功)。删除最后一个保存网络后 HaLow 接口处于未配置状态——开机时驱动记录 `invalid wireless cfg (ssid='')`,接口保持 down 直到配置新网络(其他服务不受影响) |
| /api/v1/system/network/halow/ip | GET/POST | IP 配置:`{ip_mode(dhcp/static), ip_address, netmask, gateway}`;POST 回显配置 + `"HaLow IP configuration updated"` |
| /api/v1/system/network/halow/radio | GET/PUT | 射频参数(见下) |

**`sta` 响应字段**

| 字段 | 类型 | 说明 |
|---|---|---|
| connected | bool | HaLow STA 链路已连接 |
| ssid / bssid | string | AP 名 / BSSID(未连接时为最近关联值) |
| rssi | number | 信号强度(dBm);未连接时为 0 |
| channel | number | 工作信道 |
| ip_address / netmask / gateway | string | 实时 IP 配置 |
| ip_mode | string | `dhcp` / `static` |
| mac_address | string | HaLow 接口 MAC |
| state | string | 驱动状态,如 `disconnected` |
| region | string | 当前区域码(`us`、`eu`…) |
| supported_regions | string[] | 合法区域码 |
| scan_results | object | `{known_networks[], unknown_networks[], known_count, unknown_count}`——条目字段同 5.6 |
| scan_in_progress | bool | 扫描进行中 |

**`radio` 字段**(GET 返回 / PUT 可选)

| 字段 | 类型 | 范围 | 说明 |
|---|---|---|---|
| tx_power_dbm | number | 0–36 | 发射功率(dBm) |
| scan_dwell_ms | number | 15–300(默认 30) | 单信道扫描驻留时间(ms) |
| rate_mcs | number | −1–9 | MCS 速率索引;−1 = 自动 |
| rate_bw_mhz | number | −1 / 1 / 2 / 4 / 8 | 信道带宽(MHz);−1 = 自动 |
| rate_gi | number | −1–1 | 保护间隔;−1 = 自动 |
| ps_mode | number | 0 / 1 | 省电开关 |
| limits | object | — | 只读边界:`{tx_power_dbm:{min,max}, scan_dwell_ms:{min,max,default}}` |

**示例**(`GET sta`,链路断开):

```json
{"connected":false,"ssid":"halowlink1-0be3","bssid":"60:FF:9E:5F:C7:1A","rssi":0,"channel":0,
 "ip_address":"192.168.12.199","netmask":"255.255.255.0","gateway":"192.168.12.1","ip_mode":"dhcp",
 "mac_address":"00:00:00:00:00:00","state":"disconnected","region":"us",
 "supported_regions":["au_2020","au_2024","au_revmf","ca","eu","in","jp","kr","nz","us"],
 "scan_results":{"known_networks":[...],"unknown_networks":[],"known_count":1,"unknown_count":0},
 "scan_in_progress":false}
```

**`info` 响应**——字段集与 `wifi/info`(5.3)相同,未连接时携带的是**上次关联**的值(如 `security`、上次链路的 `ip_address`;连接后为实时值)。`region` GET 返回 `{region, supported_regions[]}`(无 `active_region`,区别于 `wifi/region`)。

> `ps_mode` 为省电开关。HaLow 与 PoE 硬件互斥(EXTI15),切换由通信服务自动协调——无需手动先断另一侧。HaLow 不可用时 comm 切换到它会即时拒绝;无凭据的连接请求在触碰射频前即返回(不影响进行中的 PoE 链路)。

### 5.12 通信方式组(`/api/v1/system/network/comm/*`,2 个端点)

| 端点 | 方法 | 说明 |
|---|---|---|
| /api/v1/system/network/comm/types | GET | 类型全表——响应字段与示例见下 |
| /api/v1/system/network/comm/switch | POST | `{type}`(wifi/cellular/poe/halow)切换,**阻塞至 30 s** → `{success, from_type, to_type, switch_time_ms, error?}`;切换到不可用类型立即拒绝。⚠ **从当前激活方式切走会断掉请求所经接口**——HTTP 请求本身往往超时;请改从另一接口(如 AP)下发切换,或事后轮询 `/system/network/status` 确认 |

示例:

```json
// poe -> poe(空切换)
{"success":true,"from_type":"poe","to_type":"poe","switch_time_ms":1}
// cellular -> poe(恢复路径,经 AP 接口下发)
{"success":true,"from_type":"cellular","to_type":"poe","switch_time_ms":1110}
```

**`comm/types` 响应字段**

| 字段 | 类型 | 说明 |
|---|---|---|
| current_type | string | 当前激活通信方式 |
| preferred_type | string | 优选方式(未设置时为 `none`) |
| auto_priority | bool | 自动优先级选择 |
| types | array | 每种通信方式一条——见下表 |
| available_types | string[] | 当前可用方式名列表 |
| type_count | number | `types` 总条数 |
| current_type_info | object | `{type, status, ip_address, signal_strength}`(按方式另含 `ssid`/`isp`/`network_type`/`csq`/`signal_level`) |

**`types[]` 条目字段**

| 字段 | 类型 | 说明 |
|---|---|---|
| type | string | `wifi` / `cellular` / `poe` / `halow` |
| status | string | 显示状态(`Connected` / `Disconnected` / `Unavailable`) |
| available / connected / is_current | bool | 硬件可用 / 链路已连接 / 当前激活 |
| can_switch | bool | 当前是否允许切换到该方式 |
| ip_address | string | 当前 IP(未连接时为空) |
| signal_strength | number | 信号强度 |
| priority | number | 选择优先级 |
| display_name | string | UI 显示名 |
| detail | object | 按方式补充:wifi/halow `{ssid?, rssi?, channel?, interface?}`,cellular `{imei?, apn?, isp?}` |

**示例**(节选):

```json
{"current_type":"poe","preferred_type":"none","auto_priority":true,
 "types":[
   {"type":"wifi","status":"Disconnected","available":true,"connected":false,"can_switch":true,
    "is_current":false,"ip_address":"","signal_strength":0,"priority":1,"display_name":"WiFi",
    "detail":{"ssid":"CAMTHINK_DEV","rssi":0,"channel":0}},
   {"type":"poe","status":"Connected","available":true,"connected":true,"can_switch":false,
    "is_current":true,"ip_address":"192.168.93.95","signal_strength":0,"priority":4,
    "display_name":"PoE/Ethernet","detail":{"interface":"wn"}}],
 "available_types":["wifi","poe"],"type_count":4,
 "current_type_info":{"type":"poe","status":"Connected","ip_address":"192.168.93.95","signal_strength":0}}
```

### 5.13 蜂窝组(`/api/v1/system/network/cellular/*`,8 个端点)

| 端点 | 方法 | 说明 |
|---|---|---|
| /api/v1/system/network/cellular/status | GET | `{available, status, message}`;有模组时另含 `imei` 与下列 `settings` 对象 |
| /api/v1/system/network/cellular/info | GET | 模组详情——`{network_status, sim_status, model, version, imei, imsi, iccid, isp, network_type, register_status, plmn_id, lac, cell_id, signal_level, csq, csq_level, rssi, ipv4_address, ipv4_gateway, ipv4_dns, ipv6_address, ipv6_gateway, ipv6_dns, connection_duration_sec, error?}`;无模组 → `SERVICE_UNAVAILABLE` |
| /api/v1/system/network/cellular/settings | GET/POST | 下列 `settings` 对象;POST 字段全部可选 |
| /api/v1/system/network/cellular/connect | POST | 拨号 → `{success, status}`(返回模组数据业务的当前状态) |
| /api/v1/system/network/cellular/disconnect | POST | 挂断 → `{success, status}` |
| /api/v1/system/network/cellular/refresh | POST | 刷新模组状态 → `{success, status}` |
| /api/v1/system/network/cellular/at | POST | 发送原始 AT 命令:`{command}` → `{success, response}`;单条约 5 s。⚠ 须先**断开数据业务**(`cellular/disconnect`)——连接态下命令会失败。失败返回 `AT_COMMAND_FAILED`(1706)。响应中的 `command` 回显字段不可靠 |

**示例**:数据业务断开时 `POST {"command":"AT+CSQ"}` → `data:{"success":true,"command":"AT+CSQ","response":"+CSQ: 19,99\nOK"}`

**`settings` 字段**(status 中返回、settings 端点交换;POST 字段全部可选)

| 字段 | 类型 | 说明 |
|---|---|---|
| apn | string | APN |
| username / password | string | PDP 认证凭据 |
| pin_code | string | SIM PIN 码 |
| authentication | string | 认证方式 |
| enable_roaming | bool | 允许漫游 |
| operator | string | 锁定运营商名 |
| plmn | string | PLMN id |

**说明**:模组为惰性初始化——刚开机的设备在调用一次 `POST .../cellular/refresh` 之前可能报 `available:false`;refresh 之后 `status`/`info`/`settings` 返回完整数据(模组型号、SIM、注册状态、信号与 IP)。将通信方式切到 cellular 不会影响进行中的 PoE 链路。

**示例**(`info`,LTE 已注册):

```json
{"network_status":"Unavailable","sim_status":" READY","model":"EG915Q-NA",
 "version":"EG915NALCR01A07M04","imei":"867507069225825","imsi":"460115211251037",
 "iccid":" 89860324245920230993","isp":"CHN-CT","network_type":"FDD LTE",
 "register_status":"Registered (Home network)","plmn_id":"46011","lac":"5F0C","cell_id":"E6D915",
 "signal_level":2,"csq":18,"csq_level":2,"rssi":-77,"ipv4_address":"10.84.97.121",
 "ipv4_gateway":"10.64.64.64","ipv4_dns":"8.8.8.8","ipv6_address":"","ipv6_gateway":"",
 "ipv6_dns":"","connection_duration_sec":0}
```

### 5.14 PoE 组(`/api/v1/system/network/poe/*`,8 个端点)

| 端点 | 方法 | 说明 |
|---|---|---|
| /api/v1/system/network/poe/status | GET | `{available, status, ip_address, connected}` |
| /api/v1/system/network/poe/info | GET | 链路详情——字段表与示例见下 |
| /api/v1/system/network/poe/config | GET | 配置——字段表与示例见下 |
| /api/v1/system/network/poe/config | POST | 同字段,全部可选 → `{message, ip_mode}` |
| /api/v1/system/network/poe/connect | POST | `{success, status}` |
| /api/v1/system/network/poe/disconnect | POST | `{success, status}` |
| /api/v1/system/network/poe/validate | POST | 校验当前网络配置:`{ip_conflict, gateway_reachable, valid, errors[], warnings[]}`——注意校验器在静态链路正常工作时也可能报 `valid:false` 附笼统的 "Invalid IP address",结果仅供参考 |
| /api/v1/system/network/poe/apply · /save | POST | 应用/保存配置 → `{success, status, ip_mode}` |

**示例**(`validate`,静态链路正常):`{"ip_conflict":false,"gateway_reachable":true,"valid":false,"errors":["Invalid IP address"],"warnings":[]}`

> `poe/disconnect` 会断掉请求所经接口,HTTP 调用本身通常超时——设备仍可经 AP 接口访问(或用 `poe/connect`,返回 `{success, status:"Connected"}` 并在数秒内恢复链路)。`poe/config` 以原值回写不会中断链路。

**`poe/info` 响应字段**

| 字段 | 类型 | 说明 |
|---|---|---|
| available | bool | PoE 接口存在 |
| network_status | string | 显示状态 |
| status_code | number | 数值链路状态 |
| status_message | string | 状态文本 |
| ip_mode | string | `dhcp` / `static` |
| ip_address / netmask / gateway | string | 实时 IP 配置 |
| dns_primary / dns_secondary | string | DNS 服务器 |
| hostname | string | DHCP 主机名 |
| mac_address | string | 接口 MAC |
| interface_name | string | 内部接口名(`wn`) |
| link_up / poe_powered | bool | 链路状态 / PoE 供电在场 |
| connection_duration_sec / connection_start_time | number | 当前连接计时 |
| dhcp_lease_time / dhcp_lease_remaining | number | DHCP 租约(秒) |
| connect_count / disconnect_count / dhcp_fail_count | number | 事件计数器 |
| last_error_code | number | 最近驱动错误码 |

**示例**

```json
{"available":true,"network_status":"Connected","status_code":3,"status_message":"connected",
 "ip_mode":"static","ip_address":"192.168.93.95","netmask":"255.255.255.0","gateway":"192.168.93.1",
 "dns_primary":"8.8.8.8","dns_secondary":"8.8.4.4","hostname":"","mac_address":"D8:7A:72:0D:E5:55",
 "interface_name":"wn","link_up":true,"poe_powered":true,"connection_duration_sec":0,
 "connection_start_time":0,"dhcp_lease_time":0,"dhcp_lease_remaining":0,"connect_count":0,
 "disconnect_count":0,"dhcp_fail_count":0,"last_error_code":0}
```

**`poe/config` 字段**(GET 返回 / POST 可选)

| 字段 | 类型 | 说明 |
|---|---|---|
| ip_mode | string | `dhcp` / `static` |
| ip_address / netmask / gateway | string | 静态 IP 设置(`ip_mode=static` 时使用) |
| dns_primary / dns_secondary | string | DNS 服务器 |
| hostname | string | DHCP 主机名 |
| dhcp_timeout_ms | number | DHCP 超时(ms) |
| dhcp_retry_count | number | DHCP 重试次数 |
| dhcp_retry_interval_ms | number | DHCP 重试间隔(ms) |
| power_recovery_delay_ms | number | 供电事件后重连前延时(ms) |
| auto_reconnect | bool | 自动链路恢复 |
| persist_last_ip | bool | 复用上次获取的 IP |
| validate_gateway | bool | 网关可达性检查 |
| detect_ip_conflict | bool | IP 冲突检测 |

---

## 6. 抓拍与上传模块(capture)

### 6.1 GET / POST /api/v1/capture/upload-config — 抓拍/上传配置

**GET 响应 data / POST 请求体**(POST 字段全部可选,部分更新)

| 字段 | 类型 | 取值 | 说明 |
|---|---|---|---|
| version | number | — | 配置版本(只读) |
| mode | string | `instant` / `batch` / `scheduled` / `local_only` | 上传模式 |
| storage | string | `auto` / `flash` / `sd` / `none` | 抓拍存储位置(`auto` 按卡有无解析,见 6.2 的 `actual_fs`) |
| policy | string | `wrap`(循环覆盖)/ `stop`(停写) | 满盘策略 |
| upload_protocol | string | `mqtt` / `webhook` | 上传通道 |
| retry_enable | bool | — | 启用自动重试;关闭时首次失败即终止 |
| retry_max_attempts | number | ≥0 | 最大重试次数;启用时 `0` 表示不限 |
| batch_count | number | — | 批量大小 |
| schedule_minutes | number[] | 0–1439 | 定时上传时刻(午夜后分钟数) |
| keep_sent_hours | number | — | 已发送记录保留时长(小时) |
| max_pending_records | number | — | 待传记录上限(SD) |
| flash_max_records | number | — | flash 记录上限 |
| upload_network | string | — | 限制上传网络 |

**约束**:`storage=none` 须搭配 `mode=instant`(否则 `INVALID_REQUEST`)。

**POST 响应 data**:`{success}`。

**示例**(GET)

```json
{"version":1,"mode":"instant","storage":"auto","policy":"wrap","upload_protocol":"mqtt",
 "retry_enable":false,"retry_max_attempts":0,"batch_count":2,"schedule_minutes":[],
 "keep_sent_hours":0,"max_pending_records":200,"flash_max_records":32,"upload_network":"default"}
```

### 6.2 GET /api/v1/capture/queue — 上传队列状态

**响应 data**

| 字段 | 类型 | 说明 |
|---|---|---|
| mode / storage | string | 当前模式/存储 |
| initialized / running | bool | 队列服务状态 |
| storage_full | bool | 容量标志 |
| actual_fs | string | 实际生效文件系统 |
| pending_count | number | 待传数 |
| sent_count | number | 已发送数 |
| failed_count | number | 失败数 |
| local_count | number | 仅本地数 |
| bytes_used_kb / bytes_available_kb | number | 容量 |
| next_scheduled_at | number | 下次定时上传时间戳 |

**示例**

```json
{"mode":"instant","storage":"auto","initialized":true,"running":true,"storage_full":false,
 "actual_fs":"flash","pending_count":0,"sent_count":45,"failed_count":0,"local_count":0,
 "bytes_used_kb":3240,"bytes_available_kb":95064,"next_scheduled_at":0}
```

### 6.3 GET /api/v1/capture/records — 查询抓拍记录

**查询参数**

| 参数 | 说明 |
|---|---|
| state | 状态过滤(pending/sent/failed/local);**缺省时默认按 `pending` 过滤** |
| offset / limit | 分页,limit ≤ 200(默认 50) |
| from / to | 时间戳范围 |
| sort | 排序 |

**响应 data**:`{state, offset, limit, total, records:[{id, state, timestamp, size, retry_count, trigger, last_error, has_inference}]}`

**记录示例**

```json
{"id":"cap_1789395766_00002","state":"sent","timestamp":1789395766,"size":231867,
 "retry_count":0,"trigger":"web","last_error":"","has_inference":false}
```

`trigger` 取值含 `web`(API 发起)与 `rtc`(定时/触发)。

`total` 为分页**下界**,不一定是过滤后的完整计数。实现向前多取一条:末页 `total = offset + records.length`(精确);还有更多记录时 `total = offset + records.length + 1`。客户端只应据此判断是否可能还有下一页。

`has_inference` 仅表示记录元数据含非空 `inference_image` 路径,**不会**校验该文件,`true` 不保证推理图仍存在或可打开。

### 6.4 POST /api/v1/capture/records/retry — 重试失败记录

**请求体**:`{id}`(单条)、`{ids:[…]}`(批量)或 `{all:true}`(全部失败记录)

**响应 data**:`{reset_count}`

### 6.5 POST /api/v1/capture/records/delete — 批量删除记录

**请求体**:`{ids:[…]}`

**响应 data**:`{deleted_count}`

### 6.6 POST /api/v1/device/capture — 手动抓拍(MQTT 上传)

由 MQTT 模块实现——见 12.5。

---

## 7. 实时预览模块(preview,免认证)

### 7.1 POST /api/v1/preview/start — 启动预览

**请求体**:空。启动视频流水线(AI 流水线自动拉起)。

**响应 data**:`{success, status, pipeline_running, hub_subscribers}`

### 7.2 POST /api/v1/preview/stop — 停止预览

**请求体**:空(仅当无订阅者时真正停流)。

**响应 data**:`{success, status, pipeline_running}`

> 预览帧经 WebSocket `ws://<设备IP>:8081/stream` 消费——见[附录 B](#附录-bwebsocket-预览流)。

---

## 8. 文件管理模块(files)

所有端点带查询参数 **`fs`**(`flash` / `sd`,默认 `flash`)。无 SD 卡时 `fs=sd` 调用返回 `SERVICE_UNAVAILABLE`("SD card not available")。

### 8.1 GET /api/v1/files/list — 列目录

**查询参数**:`fs`、`path`(目录路径)

**响应 data**:`{fs, path, entries:[{name, type(file/dir), size, mtime}], count}`——`mtime` 恒为 0(littlefs 不记录 mtime)。目录无法打开时 `entries` 为空并附 `error` 字符串。

**示例**

```json
// 目录存在
{"fs":"flash","path":"/api_test","count":2,
 "entries":[{"name":"blob10k.bin","type":"file","size":10240,"mtime":0},
            {"name":"hello.txt","type":"file","size":0,"mtime":0}]}
// 目录无法打开(软成功)
{"fs":"flash","path":"/api_test","entries":[],"error":"Failed to open directory"}
```

### 8.2 GET /api/v1/files/download — 下载文件(信封例外)

**查询参数**:`fs`、`path`(含文件名路径,必填)

**响应**:原始文件字节(8 KB 块流式),`Content-Type: application/octet-stream`、`Content-Disposition: attachment; filename="…"`。文件不存在时返回信封 JSON(`NOT_FOUND`,HTTP 200)。

### 8.3 GET /api/v1/files/preview — 预览文件

**查询参数**:`fs`、`path`

**响应**:
- 图片(≤2 MB):原始字节 + 图片 Content-Type
- 其他文件(≤上限):信封 JSON `data:{filename, mime_type, size, content}`(无扩展名白名单)
- 超限:`data:{too_large:true, file_size, max_preview_size}`

### 8.4 POST /api/v1/files/upload — 上传文件(流式,信封例外)

**注意:请求体为原始字节(非 multipart)。**

| 项目 | 说明 |
|---|---|
| 查询参数 | `fs`、**`path`(目标目录,必填)**、**`filename`(文件名,必填)**——目标位置由「目录 + 文件名」两个参数给出 |
| 请求体 | 原始文件字节 |
| 大小上限 | 16 MB |
| 认证 | 由流式拦截器自行校验;**失败返回真实 401** |
| 其他错误 | 400(参数)/ 500 / 503,真实 HTTP 状态码 |

**响应**:信封 JSON(成功时带 `"error_code":"NONE"`),`data:{path, size}`。

### 8.5 POST /api/v1/files/create — 创建文件/目录

**请求体**:`{fs?, path(目录), name, type: "file"|"dir"}`——`path` 与 `name` 是分开的必填字段;创建的文件为**空文件**(内容请随后用 8.8 `files/edit` 写入)。

**响应 data**:`{fs, path(含文件名的完整路径), name, type}`。

### 8.6 DELETE /api/v1/files — 删除文件/目录

**查询参数**:`fs`、`path`、`recursive?("true")`——`recursive=true` 递归删除非空目录树。

**响应 data**:`{fs, path, filename, deleted}`(不带 `recursive` 删非空目录 → `DIR_NOT_EMPTY` 1408)

### 8.7 PUT /api/v1/files/rename — 重命名/移动

**请求体**:`{fs?, old_path, new_path}`
**响应 data**:`{fs, old_path, new_path}`

### 8.8 PUT /api/v1/files/edit — 编辑文本文件

**请求体**:`{fs?, path, content}`(扩展名须在文本白名单内——`.bin` 等被拒:`INVALID_REQUEST "Only text-based files can be edited"`)
**响应 data**:`{fs, path, size}`

---

## 9. AI 检测模块(ai)

### 9.1 GET /api/v1/ai/status — AI 状态

**响应 data**

| 字段 | 类型 | 说明 |
|---|---|---|
| ai_enabled | bool | AI 总开关 |
| model | object | 模型元数据:`{name, description, author, postprocess_type, input_data_type, output_data_type, color_format, version, created_at, stedgeai_version, input_width, input_height, input_channels, model_size, status(loaded/not_loaded)}`——默认 YOLOv8-nano 模型输入为 256×256×3 RGB |
| pipeline | object | `{status: "running"/"stopped"}` |

**示例**(节选):

```json
{"ai_enabled":true,
 "model":{"name":"YOLOv8 Nano Object Detection Model","author":"CamThink",
          "postprocess_type":"pp_od_yolo_v8_u1","input_data_type":"uint8","output_data_type":"float32",
          "color_format":"RGB888_YUV444_1","version":"1.0.0","stedgeai_version":"v4.0.1",
          "input_width":256,"input_height":256,"input_channels":3,"model_size":3247208,
          "status":"loaded"},
 "pipeline":{"status":"stopped"}}
```

### 9.2 POST /api/v1/ai/toggle — AI 开关

**请求体**

| 字段 | 类型 | 必填 | 说明 |
|---|---|---|---|
| ai_enabled | bool | 是 | **必须为显式布尔值**;缺失或非布尔值按 `true` 处理 |

**响应 data**:`null`,`message: "AI inference status updated successfully"`

### 9.3 GET / POST /api/v1/ai/params — AI 参数

**GET 响应 data**:`{nms_threshold, confidence_threshold, overlay_results, inference_interval_ms, descriptions:{…逐字段描述}}`——阈值为 **0–100 整数百分比**。

**示例**

```json
{"nms_threshold":50,"confidence_threshold":50,"overlay_results":true,"inference_interval_ms":0,
 "descriptions":{"nms_threshold":"Non-Maximum Suppression threshold (0-100)",
                 "confidence_threshold":"AI confidence threshold (0-100)",
                 "overlay_results":"Draw AI results onto encoded video frames",
                 "inference_interval_ms":"AI inference pacing interval in ms (0 = every frame, or a positive value)"}}
```

**POST 请求体**(全部可选)

| 字段 | 类型 | 说明 |
|---|---|---|
| nms_threshold | number | NMS 阈值,0–100 |
| confidence_threshold | number | 置信度阈值,0–100 |
| overlay_results | bool | 叠加检测结果到抓拍图 |
| inference_interval_ms | number | 推理间隔(ms);**遥测开启时 0 被拒绝** |

**POST 响应 data**:按字段状态 `{<field>: "updated"/"invalid_range", current_<field>: <value>, errors:[], updated:[…]}`;范围违规时信封为 `success:false, INVALID_REQUEST`,data 内仍带逐字段详情。

---

## 10. 模型管理模块(model)

### 10.1 POST /api/v1/model/validation/upload — 模型试算验证(multipart)

对上传图片执行一次推理并返回标注结果。请求为 `multipart/form-data`,共 **8 个 part**——两个文件 + 各自元数据:

| Part | 类型 | 说明 |
|---|---|---|
| ai_image | 文件(JPEG) | 送入 AI 模型的图——**必须与模型输入尺寸完全一致**(默认模型 256×256;见 9.1 的 `model.input_width/input_height`) |
| ai_image_width | 文本 | 其宽度(像素) |
| ai_image_height | 文本 | 其高度(像素) |
| ai_image_quality | 文本 | 其 JPEG 质量 |
| draw_image | 文件(JPEG) | 叠加绘制的底图 |
| draw_image_width | 文本 | 其宽度(像素) |
| draw_image_height | 文本 | 其高度(像素) |
| draw_image_quality | 文本 | 其 JPEG 质量 |

缺失元数据 part 或 `ai_image` 与模型输入尺寸不符都会导致硬件 JPEG 解码失败 → `INTERNAL_ERROR "AI inference failed"`。

**响应 data**

```jsonc
{
  "processing_time_ms": 431,
  "output_image_size": 43059,
  "ai_result": {"type":1, "detections":[], "detection_count":0, "poses":[], "pose_count":0, "type_name":"object_detection"},
  "output_image": "<base64 JPEG,已绘制检测框>"
}
```

### 10.2 POST /api/v1/model/reload — 重载 AI 模型

**请求体**:空。仅在流 hub 有订阅者时重启流水线。

**响应**:成功 `message: "Model reload completed successfully"`;失败 `MODEL_RELOAD_FAILED`(1503)

---

## 11. 工作模式/电源模式(work-mode / power-mode)

### 11.1 GET /api/v1/work-mode/status — 工作模式状态

**响应 data**:`{current_mode, configuration:{image_mode:{enable}, video_stream_mode:{enable, rtsp_server_url}}}`——触发器配置经 `/work-mode/triggers` 单独提供(见 11.3)。

**示例**:`{"current_mode":"image","configuration":{"image_mode":{"enable":true},"video_stream_mode":{"enable":false,"rtsp_server_url":"rtsp://server.example.com/live"}}}`

### 11.2 POST /api/v1/work-mode/switch — 切换工作模式

**请求体**:`{mode: "image" | "video_stream"}`

**响应**:`{"success": true, "message": "Work mode switched successfully"}`(仅 message,无 `data`)。

### 11.3 GET /api/v1/work-mode/triggers — 触发器全量配置

**响应 data**——顶层分组 `timer_trigger`、`pir_trigger`、`remote_trigger`:

| 字段 | 类型 | 说明 |
|---|---|---|
| timer_trigger | object | 见下表 |
| pir_trigger | object | `{enable, pin_number, trigger_type(rising_edge/falling_edge/both_edges/high_level/low_level), sensitivity_level(10–255), ignore_time_s(0–15), pulse_count(1–4), window_time_s(0–3), disable_in_preview}` |
| remote_trigger | object | `{enable}` |

**示例**

```json
{"timer_trigger":{"enable":false,"capture_mode":"interval","interval_sec":60,"time_node_count":0,
                  "time_node":[],"weekdays":[],"interval_mode":"normal","start_time":"00:00","end_time":"00:00"},
 "pir_trigger":{"enable":false,"trigger_type":"rising_edge","sensitivity_level":30,"ignore_time_s":7,
                "pulse_count":2,"window_time_s":0,"disable_in_preview":true},
 "remote_trigger":{"enable":false}}
```

**timer_trigger 字段**:

| 字段 | 类型 | 说明 |
|---|---|---|
| interval_mode | string | `normal` = 纯间隔;`scheduled` = 每日时间表 |
| interval_sec | number | 栅格步长,`enable` + `capture_mode=interval` 时 `1..86399`(严格小于 24 h);否则 `400` |
| start_time | string(GET);string 或 number(POST) | scheduled 模式每日窗口起点。GET 以 `HH:MM` 分钟精度输出;POST 接受 `HH:MM` 或自本地午夜起的秒数(`0..86399`),缺省保留已存值(start/end 属于定时间隔的窗口配置,普通模式的保存不应重置它们) |
| end_time | string(GET);string 或 number(POST) | scheduled 模式每日窗口终点。GET 以 `HH:MM` 输出;POST 接受 `HH:MM` 或自本地午夜起的秒数(`0..86399`),缺省保留已存值。窗口为 `[start_time, end_time]`(**含端点**:恰落在终点的节点会触发——如 08:00–08:10、5 分钟间隔产生 08:00、08:05、08:10)。必须与 `start_time` 不同(相等值保留给 normal 模式栅格)。**全天窗口 = 任意起点 T 配终点 T−1min**(栅格锚定于 T 并每日重启——如 00:00–23:59、01:00–00:59)。`00:00`(且 start > `00:00`)表示窗口止于午夜;终点早于起点则跨午夜回绕(如 20:00→06:00)。窗口须容纳至少两个节点(即长于 `interval_sec`),否则 `400`。当日最后节点之后,下一次抓拍为次日窗口起点 |
| anchor | string(GET);string 或 number(POST) | normal 间隔模式的当日时间栅格锚点(无日期分量)。GET 以 `HH:MM` 输出,未设置时省略;POST 接受 `HH:MM` 或自本地午夜起的秒数(`0..86399`),缺省保留已存值(首次启用时若未设置则盖当前时刻)。滚动窗口 `[anchor, anchor+24h)`:节点为 `anchor + n × interval_sec`,**连续跨午夜**(锚 11:00、间隔 5 h → 11:00、16:00、21:00、02:00、07:00 同属一个窗口);栅格**仅在下一个 anchor 时刻重启**(绝不在 12:00),午夜不重置;唤醒/重启不重定栅格。`00:00` 无法显式存储(它是未设置哨兵) |
| next_capture_at | number | 仅 GET,无下一节点时省略;下一抓拍节点(Unix 秒),与调度器同一套栅格运算。POST 值被忽略 |
| capture_mode | string | `none` / `interval` / `once` |
| time_node / time_node_count | array / number | 最多 10 × `HH:MM` 时刻表节点 |
| weekdays | array | 生效星期 |

### 11.4 POST /api/v1/work-mode/triggers — 配置触发器

**请求体**:触发器对象(`timer_trigger`/`pir_trigger`/`remote_trigger`)全部可选,字段同 11.3。

**语义**:
- 传了的对象按携带字段部分更新;**传了对象但缺 `enable` 字段 = 禁用**
- 未传的对象不受影响
- POST 后再 GET 复核实际生效值

### 11.5 POST /api/v1/work-mode/video-stream/config — 视频流模式配置

**请求体**:`{enable: bool, rtsp_server_url: string}`

### 11.6 GET /api/v1/power-mode/status — 电源模式状态

**响应 data**:`{current_mode, configuration:{current_mode, default_mode, low_power_timeout_ms, last_activity_time, mode_switch_count}}`

**示例**:`{"current_mode":"full_speed","configuration":{"current_mode":"full_speed","default_mode":"low_power","low_power_timeout_ms":60000,"last_activity_time":1789395991780,"mode_switch_count":5}}`

### 11.7 POST /api/v1/power-mode/switch — 切换电源模式

**请求体**:`{mode: "low_power" | "full_speed"}`

**响应**:`{"success": true, "message": "Power mode switched successfully"}`(仅 message,无 `data`)。请务必经 `GET /power-mode/status` 复核结果模式——处理器不校验未知的 mode 字符串。

---

## 12. MQTT 应用模块(apps/mqtt)

### 12.1 GET /api/v1/apps/mqtt/config — MQTT 完整配置

**响应 data**(嵌套结构;未配置过的分组可能缺省)

| 分组 | 字段 |
|---|---|
| connection | `{hostname, port, client_id, protocol_type, protocol_version, clean_session, keepalive}` |
| authentication | `{username, password, ca_cert_path, client_cert_path, client_key_path, ca_data, client_cert_data, client_key_data, sni}` |
| last_will | `{topic, message, qos, retain}` |
| network | `{auto_reconnect, reconnect_interval_ms, connection_timeout_ms, buffer_size, outbox_limit, outbox_resend_interval_ms, outbox_expired_timeout_ms}` |
| task | `{priority, stack_size}` |
| topics | `{data_receive_topic, data_report_topic, status_topic, command_topic}` |
| qos | `{data_receive_qos, data_report_qos, status_qos, command_qos}` |
| 顶层 | `{report_content, telemetry_enabled, telemetry_topic, telemetry_qos, telemetry_format}` |
| auto_subscribe | `{auto_subscribe_receive, auto_subscribe_command}` |
| message_config | `{enable_status_report, status_report_interval_ms, enable_heartbeat, heartbeat_interval_ms}` |
| status | `{running, connected, state(数值), version}` |

**示例**(默认配置;未配置过的分组缺省):

```json
{"connection":{"hostname":"mqtt.example.com","port":1883,"client_id":"NE302-278C51","protocol_type":"mqtt"},
 "authentication":{"username":"","password":"","ca_cert_path":"","client_cert_path":"","client_key_path":"",
                   "ca_data":"","client_cert_data":"","client_key_data":"","sni":false},
 "topics":{"data_receive_topic":"ne302/278C51/down/control","data_report_topic":"ne302/278C51/upload/report"},
 "qos":{"data_receive_qos":0,"data_report_qos":0},
 "report_content":"full","telemetry_enabled":false,
 "telemetry_topic":"ne302/278C51/upload/telemetry","telemetry_qos":0,"telemetry_format":"json",
 "status":{"running":true,"connected":false,"state":9,"version":"1.0.0"}}
```

### 12.2 POST /api/v1/apps/mqtt/config — 更新 MQTT 配置

**请求体**:同结构;顶层分组对象与内部字段全部可选。

**⚠ 清空语义**:分组对象存在而内部字段**缺失时,该字段被清空**——不会保留旧值。想保留某字段,必须显式携带其当前值;更新一个分组时请发送完整分组。

**响应 data**:`{message, success, connection_config_changed, action_taken, next_step}`(连接参数变化时提示重连)

### 12.3 POST /api/v1/apps/mqtt/connect — 连接 MQTT

**请求体**:空(使用当前配置)。阻塞至连接成功或失败——可达 broker 的成功路径一般在 ~12 s 内返回;不可达 broker 约 5 s 后返回 `status:"timeout"`。

**响应 data**:`{message, success, connected, status(connected/timeout/failed), error_code?, statistics:{…}}`

**`statistics` 字段**

| 字段 | 类型 | 说明 |
|---|---|---|
| total_connections / successful_connections / failed_connections | number | 连接计数器 |
| messages_published / messages_received | number | 消息计数器 |
| outbox_size | number | 发件箱中排队的消息数 |

**示例**(已连接):

```json
{"message":"MQTT connection successful","success":true,"connected":true,"status":"connected",
 "statistics":{"total_connections":11,"successful_connections":1,"failed_connections":19,
               "messages_published":0,"messages_received":0,"outbox_size":0}}
```

### 12.4 POST /api/v1/apps/mqtt/disconnect — 断开 MQTT

**请求体**:空。**响应 data**:同 12.3;幂等(空闲时 `status:"already_disconnected"`)。

**示例**(已连接时断开):`{"message":"MQTT disconnection successful","success":true,"connected":false,"status":"disconnected","statistics":{…同 12.3}}`

### 12.5 POST /api/v1/device/capture — 手动抓拍并经 MQTT 上传

**请求体**(全部可选)

| 字段 | 类型 | 说明 |
|---|---|---|
| enable_ai | bool | 对抓拍帧执行 AI |
| store_to_sd | bool | 存 SD |
| chunk_size | number | 分块大小 |

**响应 data**:`{success, code, result, message, enable_ai, store_to_sd, chunk_size, duration_ms}`——完整抓拍+上传周期约 20 s 量级,`duration_ms` 返回实际值。

**示例**

```json
{"success":true,"code":0,"result":0,"message":"Capture and MQTT upload completed",
 "enable_ai":false,"store_to_sd":false,"chunk_size":0,"duration_ms":20725}
```

**说明**:上传失败的抓拍会入队,连接恢复后自动补发(记录的 `retry_count`/`last_error` 反映此事)。

**错误**:忙 `OPERATION_IN_PROGRESS`(1705);MQTT 未连接 `MQTT_NOT_CONNECTED`(1304);超时 `OPERATION_TIMEOUT`(1701)

---

## 13. RTMP 推流模块(apps/rtmp)

### 13.1 GET /api/v1/apps/rtmp/config — RTMP 配置

**响应 data**:嵌套结构——`config` 对象 + `status` 对象:

**`config` 字段**

| 字段 | 类型 | 说明 |
|---|---|---|
| enable | bool | RTMP 开关 |
| url | string | RTMP 服务器地址(如 `rtmp://server/live`) |
| stream_key | string | 推流密钥 |

**`status` 字段**

| 字段 | 类型 | 说明 |
|---|---|---|
| initialized | bool | 服务已初始化 |
| streaming | bool | 正在推流 |
| state | string | `idle` / `connecting` / `streaming` / `reconnecting` / `stopping` / `error` |

**示例**

```json
{"config":{"enable":false,"url":"","stream_key":""},
 "status":{"initialized":true,"streaming":false,"state":"idle"}}
```

### 13.2 POST /api/v1/apps/rtmp/config — 更新配置

**请求体**:`{enable?, url?, stream_key?}`(全部可选)

**响应 data**:`{success, message}`

### 13.3 POST /api/v1/apps/rtmp/start — 开始推流

**请求体**:空。软失败:推流无法建立时信封仍为 `success:true`、`data.success=false`:

```json
{"success": true, "data": {"success": false, "status": "failed", "error_code": -2, "state": "idle"}}
```

### 13.4 POST /api/v1/apps/rtmp/stop — 停止推流

**请求体**:空。**响应 data**:`{success, status}`(空闲时 `status:"already_stopped"`)。

### 13.5 GET /api/v1/apps/rtmp/status — 推流状态

**`status` 字段**

| 字段 | 类型 | 说明 |
|---|---|---|
| streaming | bool | 正在推流 |
| state | string | `idle` / `connecting` / `streaming` / `reconnecting` / `stopping` / `error` |

**`statistics` 字段**

| 字段 | 类型 | 说明 |
|---|---|---|
| frames_sent | number | 已发送帧数 |
| bytes_sent | number | 已发送字节数 |
| keyframes_sent | number | 已发送关键帧数 |
| dropped_frames | number | 丢帧数 |
| reconnect_count | number | 重连次数 |
| stream_duration_sec | number | 推流时长(秒) |

**示例**

```json
{"status":{"streaming":false,"state":"idle"},
 "statistics":{"frames_sent":0,"bytes_sent":0,"keyframes_sent":0,"dropped_frames":0,
               "reconnect_count":0,"stream_duration_sec":0}}
```

---

## 14. RTSP 服务模块(apps/rtsp)

### 14.1 GET /api/v1/apps/rtsp/config — RTSP 配置

**响应 data**:`{enabled, port, auth_mode, username, password}`
> 密码**明文返回**(无掩码)。

**示例**(默认值):`{"enabled":false,"port":554,"auth_mode":"none","username":"","password":""}`

### 14.2 PUT /api/v1/apps/rtsp/config — 更新配置

**请求体**:`{enabled?, port?, auth_mode?, username?, password?}`

- `password` = `"******"` 表示**保持不变**(掩码哨兵)
- `enabled` 与 RTMP 互斥:启用 RTSP 会关 RTMP;反向不对称
- **响应 data**:`{enabled, port, auth_mode, message}`

### 14.3 GET /api/v1/apps/rtsp/status — 服务状态

**响应 data**

| 字段 | 类型 | 说明 |
|---|---|---|
| running | bool | RTSP 服务运行中 |
| stream_url | string | 播放地址(如 `rtsp://<设备IP>:554/stream`);服务禁用时为空 |

**示例**:`{"running": false, "stream_url": ""}`

### 14.4 GET /api/v1/apps/rtsp/clients — 客户端列表

**响应 data**:数组(无客户端时为空),每个条目:

| 字段 | 类型 | 说明 |
|---|---|---|
| id | string | 会话标识(供 14.5 使用) |
| ip | string | 客户端 IP |
| port | number | 客户端端口 |
| connected_duration | number | 连接时长(秒) |

### 14.5 DELETE /api/v1/apps/rtsp/clients/&lt;会话id&gt; — 踢出客户端

**路径**:`/api/v1/apps/rtsp/clients/<session-id>`(通配路由)
**响应 data**:`{success, message}`(无论会话是否存在均成功)

---

## 15. Webhook 模块(apps/webhook)

### 15.1 GET /api/v1/apps/webhook/config — 配置

**响应 data**

| 字段 | 类型 | 说明 |
|---|---|---|
| enable | bool | webhook 开关 |
| url | string | 目标 URL(空 = 未配置) |
| auth_type | string | `none` / `basic` / `bearer` |
| secret | string | 认证密钥/令牌 |
| has_custom_ca | bool | 已安装自定义 CA 证书(见 15.4) |

**示例**:`{"enable":false,"url":"","auth_type":"none","secret":"","has_custom_ca":false}`

### 15.2 POST /api/v1/apps/webhook/config — 更新配置

**请求体**:`{enable?, url?, auth_type?, secret?}`
**响应 data**:`{success, message}`

### 15.3 POST /api/v1/apps/webhook/test — 测试推送

**请求体**:空(按当前配置发送一条测试消息)。
**响应 data**:`{success, message}`(软失败)

推送为 HTTP POST,`multipart/form-data` 正文(`User-Agent: HttpClient/1.0`):

```
------NE302WebhookBoundary
Content-Disposition: form-data; name="metadata"
Content-Type: application/json

{"device_info":{"device_name":"NE302-278C51","serial_number":"SN202500001"},"ai_result":null}
------NE302WebhookBoundary
Content-Disposition: form-data; name="image"; filename="capture.jpg"
Content-Type: image/jpeg

<JPEG 字节:相机实时画面>
------NE302WebhookBoundary--
```

### 15.4 GET / POST / DELETE /api/v1/apps/webhook/ca-cert — 自定义 CA 证书

- **GET** `data`:`{ca_cert_data(PEM 文本), ca_cert_length}`;未配置证书 → `INVALID_REQUEST`("No CA certificate configured")
- **POST**:`{ca_cert_data}`;须以 `-----BEGIN` 开头,**≤ 8 KB**;格式错 → `INVALID_REQUEST`("Invalid PEM format")
- **DELETE**:清除自定义 CA,恢复默认(幂等)

**响应 data**:`{success, message}`

---

## 16. 固件升级模块(system/ota)

**公共约定**

- `firmwareType` 取值:`fsbl` / `app` / `web` / `ai_default`(AI 槽 1)/ `ai`(实际激活 AI 槽)/ `wifi` / `reserved2`;默认 `app`
- 包头 1 KB(`ota_header_t`,魔数 `"UATO"`);AI 类型另有 1 KB 模型头(共 2048 B)
- 机型戳:包/捆绑包 `device_model ≠ 0 且 ≠ 0x3010` 时拒绝(0 = 无戳旧包,放行)
- 超时:单次上传空闲 3 分钟、捆绑会话空闲 10 分钟——自动终止并恢复服务;超时后迟到的残留数据会被丢弃并关闭连接
- 上传期间自动停 MQTT、AI 流水线与相机(在途抓拍最多等 30 s),完成后恢复;**任何路径都不自动重启**

### 16.1 POST /api/v1/system/ota/precheck — 固件头预检

**请求**:原始二进制 body = 包前 1024 B(AI 类型 2048 B);不强校验 Content-Type。
**查询参数**:`firmwareType`(默认 app)、`contentLength`(完整包大小;给出时必须等于头内 `total_package_size`)

**响应 data**:`{valid: true, message, firmware_size, firmware_version, firmware_crc32, part_table_changed, device_table_crc, package_table_crc}`

**示例**

```json
{"success":true,"data":{"valid":true,"message":"Header validation passed","firmware_size":3846816,
 "firmware_version":"4.3.1.107","firmware_crc32":3559581218,"part_table_changed":false,
 "device_table_crc":1513948246,"package_table_crc":1513948246}}
```

**失败**:`OTA_HEADER_VALIDATION_FAILED`(1806),`data:{valid:false, reason:"Header validation failed"}`——魔数损坏、CRC 不符、`contentLength` 不匹配;空 body 返回 `INVALID_REQUEST`。

### 16.2 POST /api/v1/system/ota/upload — 流式固件上传

**⚠ 信封例外**:该端点在路由分发之前被流式拦截器接管(自行认证;返回**真实 HTTP 状态码**)。

| 项目 | 说明 |
|---|---|
| 请求体 | **原始固件字节**(非 multipart/JSON),1 KB 头 + 载荷 |
| Content-Length | **必填**,1024 B – 100 MB |
| 查询参数 | `firmwareType`(默认 app) |
| 直烧模式 | `direct=1&addr=0x<addr>`;仅在捆绑会话(`bundle/begin`)中合法;`addr` 必须与设备解析的计划地址完全一致 |
| 互斥 | 普通上传与捆绑会话互斥(一方激活时拒绝另一方) |

**处理流程**:头校验(魔数/CRC/机型/类型/尺寸)→ 按 1 KB 块写 flash 并滚动 CRC32 → 整包 CRC 终检。FSBL 载荷先暂存 PSRAM、CRC 通过后才烧写。WEB 上传立即重载前端资源;AI 上传设置 NVS 激活槽标志;WiFi 上传将 `.rps` 暂存至 `WIFI_FW_BASE`,下次重启推送。

**响应**:信封 JSON;成功 `message: "Upgrade successful"`。参考吞吐(同版本固件真实烧写):**APP ≈ 3.8 MB / ≈ 31 s(≈ 125 KB/s)**;web 资源 ≈ 284 KB / ≈ 2.3 s。重启后立即发起上传可能被连接重置拒绝——待 web 服务完全初始化后重试。失败用真实状态码 400(头校验失败 / OTA 进行中 / 参数)/ 500(内存/flash/CRC 错误)。

### 16.3 POST /api/v1/system/ota/upgrade-local — 升级确认(布防 WiFi 推送)

**请求体**:`{firmware_type: "wifi"}`(其他值或空 body 均为空转)
**行为**:`wifi` 时设置 NVS 更新标志,下次重启把暂存的 `.rps` 推给 917 主机。
**响应 data**:`null`,`message: "OK"`

### 16.4 POST /api/v1/system/ota/export — 导出固件(信封例外)

**请求体**(JSON;Content-Type 须为 application/json)

| 字段 | 类型 | 必填 | 说明 |
|---|---|---|---|
| firmware_type | string | 是 | `app` / `web` / `ai_default` / `ai`(可导出);`fsbl` / `wifi` **不可导出**(`INTERNAL_ERROR "Firmware size is 0"`);其他值回落为 `app` |
| filename | string | 是 | 导出文件名(用于 `Content-Disposition: attachment; filename="…"`) |

**响应**:原始固件字节(`application/octet-stream`),按 1 KB 块流式。参考吞吐 ≈ 720 KB/s(APP ≈ 3.8 MB / ≈ 5 s;web 资源 ≈ 284 KB / ≈ 0.4 s;AI 包 ≈ 3.2 MB / ≈ 4.5 s)。

### 16.5 POST /api/v1/system/ota/bundle/precheck — 整机重刷捆绑包预检

一键整机重刷捆绑包(4 KB 头 + 子包)。**请求 body = 捆绑包文件前 4096 字节**(原始二进制)。

**校验**:头魔数/尺寸/CRC;机型戳;条目表;分区布局物理合法(无重叠、在 flash 内、FSBL 不可移动);类型合法且无重复;必需分区在场;条目不超所属分区;改布局的包必须含 FSBL。

**响应 data**

```jsonc
{
  "layout_changed": false,
  "layout_diff": [ { "part": "...", "device_base": 0, "device_size": 0,
                     "bundle_base": 0, "bundle_size": 0 } ],   // 仅 layout_changed 时
  "total_bytes": 0,
  "entries": [ {
      "type": "app",            // fsbl|app|web|ai|wifi
      "fw_type": 2,             // 原始码:0x01 fsbl / 0x02 app / 0x03 web / 0x04,0x05 AI / 0x08 wifi
      "skippable": true,        // 版本相同且分区未动(FSBL 另需布局未变)
      "cur_version": "…", "new_version": "…",
      "size": 0,                // 子包字节
      "offset": 4096,           // 捆绑包内字节偏移
      "addr": 0                 // 设备解析的绝对烧写地址
  } ]
}
```

**副作用**:校验通过的头 + 计划存为全局捆绑会话(`prechecked=true`);空闲 10 分钟后过期。

**失败**:头无效 → `OTA_HEADER_VALIDATION_FAILED`("Invalid bundle header (magic/size/CRC)")。

### 16.6 POST /api/v1/system/ota/bundle/begin — 启动捆绑强制重刷会话

**请求体**:`{skip?: ["wifi", "fsbl", …]}`——跳过清单;名称须在计划内且 `skippable=true`;**全部跳过被拒绝**。

**响应 data**:`{burn_count}`,`message: "Bundle session started"`。未先做 `bundle/precheck`:`INVALID_REQUEST "No prechecked bundle (POST bundle/precheck first)"`。

**⚠ 副作用**:每次 begin 都**擦除 OTA info 分区**;下次开机按新布局重建 SystemState(槽 A / APP1 / AI_1 激活)。跳过 `wifi` 会清除待推送 WiFi 标志。

### 16.7 POST /api/v1/system/ota/bundle/finish — 结束/中止捆绑会话

**请求体**:`{result: "ok" | "abort"}`(非 "ok" 一律视为 abort)
**行为**:`"ok"` 且计划中仍有 WiFi 更新时调用 `wifi_mark_update_pending()`;会话 Either way 清除,**不自动重启**(前端随后调用 `/system/restart`)。已烧写固件不回滚;abort 幂等。
**响应 data**:`{wifi_pending}`,`message: "Bundle finished"/"Bundle aborted"`。无活动会话:`INVALID_REQUEST "No bundle session to finish"`。

---

## 17. ISP 图像质量模块(isp)

**公共错误码**(业务码 2001–2008,见 1.5.2):2001 未初始化 / 2002 参数错(JSON)/ 2003 超范围 / 2004 依赖 / 2005 HAL / 2006 传感器 / 2007 算法 / 2008 忙。

**通用语义**:GET 返回当前值;PUT **实时作用于 ISP 硬件**并更新 IQ 参数缓存,但**本身不写 NVS**——经 `POST /isp/config/save` 持久化。GET 另带 `_meta`(字段元数据)。

**`_meta` 结构**——每个可设置字段一条:

| 键 | 说明 |
|---|---|
| type | `bool` / `number` / `enum` / … |
| unit | 适用时的单位字符串 |
| min / max / default | 数值边界与出厂默认 |
| values / labels | `enum` 字段的合法取值与显示标签 |
| dependencies | 该字段生效所依赖的其他字段状态(如手动曝光需 AEC 关闭) |
| description | 人读字段描述 |

```json
// GET /isp/aec 的 _meta 节选
"_meta": {
  "exposure_compensation": {"type":"enum","values":[-4,-3,-2,-1,0,1,2,3,4],
    "labels":["-2.0EV","-1.5EV","-1.0EV","-0.5EV","0EV","+0.5EV","+1.0EV","+1.5EV","+2.0EV"],
    "default":0,"description":"Exposure compensation in EV"},
  "anti_flicker_freq": {"type":"enum","values":[0,50,60],
    "description":"Anti-flicker frequency (0=Off, 50=50Hz, 60=60Hz)"}
}
```

### 17.1 GET /api/v1/isp/params — 全量参数

**响应 data**:`{sensor_info:{name,bayer_pattern,color_depth,width,height}, aec, awb, demosaicing, stat_removal, black_level, bad_pixel, isp_gain, color_conv, contrast, gamma, stat_area, sensor_delay}`(各分组字段同下列对应端点)

### 17.2 GET /api/v1/isp/sensor — 传感器信息

**响应 data**:`{name, bayer_pattern(RGGB/GRBG/GBRG/BGGR/MONO), color_depth, width, height, gain_range:{min,max}, exposure_range:{min,max}}`(增益 mB,曝光 µs)

**示例**:`{"name":"OS04C10","bayer_pattern":"RGGB","color_depth":10,"width":2688,"height":1520,"gain_range":{"min":0,"max":72000},"exposure_range":{"min":0,"max":33266}}`

### 17.3 GET /api/v1/isp/statistics — ISP 统计

**响应 data**:`{down:{average_r,average_g,average_b,average_l,histogram[12]}, up:{average_r,average_g,average_b,average_l}, estimated_lux, frame_id}`(down = ISP 处理后,up = 处理前)

**示例**:`{"down":{"average_r":57,"average_g":59,"average_b":61,"average_l":58,"histogram":[0,0,0,0,0,0,0,0,0,0,0,0]},"up":{"average_r":0,"average_g":0,"average_b":0,"average_l":0},"estimated_lux":83,"frame_id":1318670}`

### 17.4 GET / PUT /api/v1/isp/aec — 自动曝光

**示例**(实测值 + `_meta` 节选):

```json
{"enable":true,"exposure_compensation":0,"exposure_target":56,"anti_flicker_freq":50,
 "current_state":{"sensor_gain":13480,"sensor_exposure":30000,"estimated_lux":83},
 "_meta":{...}}
```

| 字段 | 类型 | 范围 | PUT |
|---|---|---|---|
| enable | bool | — | ✅ |
| exposure_compensation | number | −4…+4(0.5 EV 步进,即 ±2.0 EV) | ✅ |
| exposure_target | number | 0–100 | ✅ |
| anti_flicker_freq | number | 0 / 50 / 60 | ❌(此处只读;仅经 import 可改) |

GET 另带 `current_state:{sensor_gain, sensor_exposure, estimated_lux}`。

### 17.5 GET / PUT /api/v1/isp/aec/manual — 手动曝光

| 字段 | 类型 | 范围 | 说明 |
|---|---|---|---|
| gain | number | sensor.gain_min…max | 单位 mB |
| exposure | number | sensor.exposure_min…max | 单位 µs |

> 仅在 AEC **关闭**时生效(见 GET `_meta.dependencies`)。

### 17.6 GET / PUT /api/v1/isp/awb — 自动白平衡

| 字段 | 类型 | 说明 |
|---|---|---|
| enable | bool | AWB 开关 |
| mode | string | `auto`(按场景选 profile)/ `manual`(按 color_temp) |
| color_temp | number | 手动模式色温(PUT 与 `mode` 一起消费) |
| profiles | array | 恰好 5 个:`{index(0–4), label(≤31 字符), reference_color_temp, isp_gain:{r,g,b}, ccm[3][3](±4.0×), reference_rgb:{r,g,b}}` |

GET 另带 `current_color_temp, current_gains:{r,g,b}, current_ccm:{enable, matrix}`。profile 数值无范围校验,直接写入 IQ 缓存。

### 17.7 GET / PUT /api/v1/isp/demosaicing — 去马赛克

`{enable, peak, line_v, line_h, edge}`(强度均 0–7,默认 4);`bayer_type` 只读(由传感器决定)。

### 17.8 GET / PUT /api/v1/isp/stat_removal — 统计行剔除

`{enable, head_lines(0–7), valid_lines(0–4094)}`

### 17.9 GET / PUT /api/v1/isp/black_level — 黑电平

`{enable, r, g, b}`(各 0–255,默认 12)

### 17.10 GET / PUT /api/v1/isp/bad_pixel — 坏点校正

`{enable, strength(0–7), detected_count(只读,运行时检测), algo_enable, algo_threshold(≥0)}`

### 17.11 GET / PUT /api/v1/isp/gain — ISP 数字增益

`{enable, r, g, b}`,单位 **100000000 = 1.0×**,上限 16.0×(1,600,000,000)。
> AWB 开启时 ISP 增益自动控制。

### 17.12 GET / PUT /api/v1/isp/color_conv — 颜色转换矩阵

`{enable, matrix[3][3]}`,系数 ±399,000,000(1e8 = 1.0×);必须恰为 3×3。

### 17.13 GET / PUT /api/v1/isp/contrast — 对比度 LUT

`{enable, lut[9]}`,各项 0–394(亮度锚点 [0,32,…,256],100 = 1.0×);必须恰为 9 项。

### 17.14 GET / PUT /api/v1/isp/gamma — 伽马校正

`{enable}`(唯一字段)

### 17.15 GET / PUT /api/v1/isp/stat_area — 统计窗口

`{x, y, width, height}`,width/height ≥ 4 且 ≤ 4094;须满足 `x+width ≤ sensor_width`、`y+height ≤ sensor_height`。PUT 与当前值合并。

### 17.16 GET / PUT /api/v1/isp/lux_ref — 照度基准(AEC 估算输入)

`{high_lux:{lux_ref,expo1,lum1,expo2,lum2}, low_lux:{…同…}, calib_factor(float)}`;lum1/lum2 为 0–255。仅 IQ 缓存。

### 17.17 GET / PUT /api/v1/isp/sensor_delay — 传感器延时

`{delay}`(整数 ≥ 0,按 uint8 存储)。仅 IQ 缓存。

### 17.18 POST /api/v1/isp/config/save — IQ 参数持久化到 NVS

**请求体**:空。保存全部当前生效 IQ 参数。**响应**:`message: "ISP configuration saved successfully"`。

### 17.19 POST /api/v1/isp/config/load — 从 NVS 加载

**请求体**:空。无已存配置时返回 2001(`No saved ISP configuration found`)。

### 17.20 GET /api/v1/isp/config/export — 导出 IQ 配置

**响应 data**:`{export_version:"1.0", export_timestamp, config:{stat_removal, demosaicing{+type}, contrast, stat_area, bad_pixel{algo_*, static_*}, black_level, aec, awb{profiles[{label,color_temp,gain_r,gain_g,gain_b,ccm[9 扁平]}]}, isp_gain, color_conv{matrix[9 扁平]}, gamma, sensor{gain,exposure,delay}, lux_ref{hl_*,ll_*,calib_factor}}}`

> 导出字段命名与逐参数 API 略有差异(`color_temp`/`gain_r|g|b`/9 元扁平数组)。

### 17.21 POST /api/v1/isp/config/import — 导入 IQ 配置

**请求体**:`{config: {…同 export 结构…}}`(`config` 必填;内部分组可选;`ccm`/`matrix` 接受 ≥9 项扁平数组)

**行为**:实时生效 + 持久化到 NVS + 刷新设备缓存。**无范围校验**(不同于逐参数 PUT)。
**响应**:`message: "ISP configuration imported and applied successfully"`

---

## 附录 A. curl 速查

```bash
# 每个请求带 Basic 认证(用户名 admin)
curl -u admin:<password> http://<设备IP>/api/v1/device/info

# 以 success 字段判错,不看 HTTP 状态码
curl -s -u admin:<password> http://<设备IP>/api/v1/ai/status | jq .success

# 文件上传(原始字节流,非 multipart):path = 目标目录,filename = 文件名
curl -u admin:<password> -X POST --data-binary @frame.jpg \
  "http://<设备IP>/api/v1/files/upload?fs=flash&path=/photos&filename=frame.jpg"

# 模型验证:8 个 multipart part(2 个文件 + 6 个元数据文本字段);
# ai_image 必须与模型输入尺寸一致(默认模型 256×256)
curl -u admin:<password> -X POST \
  -F "ai_image=@a256.jpg" -F "ai_image_width=256" -F "ai_image_height=256" -F "ai_image_quality=85" \
  -F "draw_image=@d256.jpg" -F "draw_image_width=256" -F "draw_image_height=256" -F "draw_image_quality=85" \
  "http://<设备IP>/api/v1/model/validation/upload"

# OTA 预检:包前 1024 字节 + 完整大小
curl -u admin:<password> -X POST --data-binary @header.bin \
  "http://<设备IP>/api/v1/system/ota/precheck?firmwareType=app&contentLength=3846816"

# OTA 上传(流式,真实状态码)
curl -u admin:<password> -X POST --data-binary @app_v4.3.1.x.bin \
  "http://<设备IP>/api/v1/system/ota/upload?firmwareType=app"
```

## 附录 B. WebSocket 预览流

| 项目 | 值 |
|---|---|
| URL | `ws://<设备IP>:8081/stream`(独立监听,默认端口 8081) |
| 载荷 | H.264 视频帧;GOP ≈ 1 s |
| 典型吞吐 | 持续 ≈ 190 KB/s,fps ≈ 28 |
| 帧大小 | 关键帧 ≈ 14 KB,P 帧 ≈ 7.4–8.3 KB |
| 关键帧同步 | 服务端按订阅者做关键帧对齐:每个关键帧发送单个 `[SPS][PPS][IDR]` 合成帧,中途加入的客户端不会黑屏 |
| 生命周期 | `POST /api/v1/preview/start` 启动流水线;最后一个客户端断开后,`POST /api/v1/preview/stop` 才真正停流 |

> 播放器应使用支持 Annex-B 起始码的解码器(如 jmuxer);首帧已含参数集——无需单独请求 SPS/PPS。

## 附录 C. 版本与文档维护

- APP 固件版本为 **4.3.1.x**(BUILD 号 = 自 `v4.3.1-base` 标签的提交计数);版本宏位于 `Custom/Common/Inc/version.h`(构建时自动生成);期望伴随版本见 `EXPECTED_FSBL_VERSION_STRING` 与 `EXPECTED_WIFI_VERSION_STRING`。
- 模块路由注册于 `Custom/Services/Web/web_service.c`;路由表与错误码见 `web_server.h`、`api_business_error.h`、`api_isp_module.h`。
- 固件升级后请以 `git diff` 复核 API 面,并同步更新本文。
