camthink-ai/ne302/Docs/NE302_v4.3.1_Config_File_Reference_cn.md

# NE302 设备配置文件字段说明（v4.3.1 / 配置模式 v2）

> 适用对象：网页「固件升级 → 导出」下载的设备配置 JSON（对应接口 `GET /api/v1/device/config/export` 与导入接口 `POST /api/v1/device/config/import`）。
> 字段含义、默认值与取值范围以固件代码为准（`Custom/Core/System/json_config_mgr.h` 结构体定义、`json_config_mgr.c` 默认值与归一化、各服务枚举）；网页设置入口以实际页面为准。

## 导入语义（先读这个）

- **合并不是重建**：导入只叠加文件里实际存在的键；文件里缺失（或被你删掉）的键**保持设备当前值**，不会回退出厂默认。
- **版本门**：`config_version` 大于固件当前版本（现为 2）的文件被整份拒绝；v1 旧文件正常导入，导入后版本标记钉回 2。
- **网络参数恒写入**：导入网络字段会立即写入 RAM+NVS，与设备是否已连接无关——不会因链路在连而跳过或拒绝写入；生效点=各消费方下次读取的时机（多为下次重启/下次连接，详见 `network_service` 一节的说明）。
- 各字段「导入」列标记：
  - ✅ 随导入生效
  - 📄 仅导出留档，**导入时忽略**（设备绑定信息或源设备运行快照）
  - 🔧 随导入生效，但先经归一化/钳位（见各表）
- 敏感字段说明：文件**明文**携带 WiFi 密码、MQTT 密码、RTSP 密码、RTMP 流密钥、Webhook 密钥、管理密码，注意保管。

## ⚠️ 当前固件未实际使用的字段

以下字段会正常**存储、导出、随导入往返**，但固件里**没有任何功能读取**它们——设置后不会改变设备行为（导入它们也无副作用）。多数是历史遗留或为后续版本预留；标注以 v4.3.1 代码 grep 核查为准：

| 字段 | 说明 |
|---|---|
| `device_service.image_config.brightness` / `contrast` | 亮度/对比度：无消费方（网页本版也未开放调节） |
| `device_service.image_config.aec` | 自动曝光开关：无消费方 |
| `device_service.image_config.capture_disable_comm` | 仅在设备服务内拷贝/记日志，抓拍上传路径未读取，未见生效 |
| `work_mode_config.work_mode` / `image_mode.enable` | 固件只有图像（抓拍）一种工作模式，两个字段无消费方 |
| `work_mode_config.video_stream_mode.enable` | 遗留的工作模式父级开关：推/拉流由 rtmp_enable / rtsp_enable 各自独立控制，此开关无消费方 |
| `work_mode_config.io_trigger[]` 整组（`pin_number`/`enable`/`input_enable`/`output_enable`/`input_trigger_type`/`output_trigger_type`） | IO 触发注册 API 存在但无调用方，网页序列化代码也已注释——未接线 |
| `capture_upload_config.max_pending_records` | 仅存储与网页展示，上传管线未读取该上限 |
| `network_service.poe.dhcp_retry_interval_ms` | PoE 驱动未读取 |
| `network_service.cellular.authentication` / `operator` | 蜂窝模组配置未使用这两个字段 |
| `auth_mgr.session_timeout_ms` / `enable_session_timeout` | 登录会话无超时控制逻辑，未消费 |

对照：同段里容易误以为没用的字段**实际在用**——`ai_debug` 全组（`ai_enabled`/`ai_1_active`/`confidence_threshold`/`nms_threshold`/`overlay_results`/`inference_interval_ms` 经 AI 服务下发到视频节点与模型后处理，`ai_1_active` 还决定唤醒抓拍的模型槽）、`light_config.light_threshold`（唤醒路径的光控判定）、`mqtt_service` 的缓冲/超时参数（`tx_buf_size`/`rx_buf_size`/`outbox_expired_timeout_ms` 等由 MQTT 客户端库消费）。

---

## 顶层包装

| 字段 | 类型 | 说明 |
|---|---|---|
| `export_version` | string | 导出格式版本，当前 `"1.0"` |
| `export_timestamp` | number | 导出时刻的 Unix 时间戳（秒） |
| `config` | object | 实际配置体，以下各节均指 `config` 内部字段 |

## config 元数据

| 字段 | 默认 | 说明 | 导入 |
|---|---|---|---|
| `config_version` | 2 | 配置模式版本。大于固件版本的文件被拒；导入后固件将其钉回 2 | 📄（门控用，不落盘为文件值） |
| `magic_number` | 0x41494341 | 魔数 `"AICA"`（1095320385），完整性标识 | 📄 |
| `checksum` / `timestamp` | — | 校验和与最后保存时间；导入时设备会重新计算并盖上当前时间 | 📄 |

## log_config（日志）

网页入口：系统设置。

| 字段 | 默认 | 说明 | 范围/枚举 | 导入 |
|---|---|---|---|---|
| `log_level` | 2 | 文件日志级别 | 0=DEBUG, 1=INFO, 2=WARNING, 3=ERROR, 4=FATAL, 5=SIMPLE（出厂默认 2；代码注释标 "INFO"，按枚举 2 对应 WARNING，以枚举为准） | ✅ |
| `log_file_size_kb` | 60 | 单个日志文件大小上限（KB） | 正整数 | ✅ |
| `log_file_count` | 5 | 轮转保留的日志文件数 | 正整数 | ✅ |

## ai_debug（AI 识别）

网页入口：功能调试。

| 字段 | 默认 | 说明 | 范围 | 导入 |
|---|---|---|---|---|
| `ai_enabled` | false | AI 推理总开关 | bool | ✅ |
| `ai_1_active` | false | AI_1（当前模型槽位）启用 | bool | ✅ |
| `confidence_threshold` | 50 | 置信度阈值，低于该值的目标被丢弃 | 0–100 | ✅ |
| `nms_threshold` | 50 | NMS 非极大值抑制阈值 | 0–100 | ✅ |
| `overlay_results` | true | 把识别结果绘制到编码帧/抓拍图上 | bool | ✅ |
| `inference_interval_ms` | 0 | 推理节流间隔；0 = 每帧都推理 | ≥0，毫秒 | ✅ |

## power_mode_config（功耗模式）

网页入口：功能调试（功耗模式）；`current_mode` 由 `POST /api/v1/power-mode/switch` 切换。

| 字段 | 默认 | 说明 | 范围/枚举 | 导入 |
|---|---|---|---|---|
| `current_mode` | 0 | 当前功耗档。切换接口会持久化它，**开机按它运行**，所以随导入迁移；导入后重启生效（运行中不立即切档） | 0=低功耗, 1=全速；越界值忽略、保持设备现值 | ✅ |
| `default_mode` | 0 | 默认功耗档（如开机无有效 current_mode 时的落档） | 0/1，越界忽略 | ✅ |
| `low_power_timeout_ms` | 60000 | 空闲多久进入低功耗 | 毫秒 | ✅ |
| `last_activity_time` | 0 | 最近活动时间戳（毫秒） | — | 📄 导入时被**本机当前时间重盖**（防外来过期戳导致误超时） |
| `mode_switch_count` | 0 | 模式切换计数 | — | 📄 |

## device_info（设备信息）——整段仅导出

网页入口：设备信息页。**全部字段导入时忽略**：这些是设备绑定或运行派生值，导入他机文件不会覆盖本机身份。

| 字段 | 说明 |
|---|---|
| `device_name` | 设备名。默认按 MAC 生成 `NE302-XXXXXX`（后 3 字节）；出厂 MAC 烧录后跟随烧录值 |
| `mac_address` | 设备 MAC（烧录了出厂 MAC 时为烧录值，否则芯片报告值） |
| `serial_number` | 序列号（产线写入，默认 `SN202500001`） |
| `hardware_version` / `software_version` | 硬件/软件版本（软件版本随固件自动更新，导入无效） |
| `camera_module` / `extension_modules` | 摄像头模块 / 扩展模块描述 |
| `storage_card_info` / `storage_usage_percent` | 存储卡状态与占用（运行时快照） |
| `power_supply_type` / `battery_percent` | 供电类型与电量（运行时快照） |
| `communication_type` | 当前实际活跃链路（运行时快照） |

## device_service（设备服务）

### image_config（图像与抓拍参数）

网页入口：图像设置 / 抓拍设置（部分参数）。

| 字段 | 默认 | 说明 | 范围/枚举 | 导入 |
|---|---|---|---|---|
| `brightness` / `contrast` | 50 | 亮度/对比度 | 0–100 | ✅ ⚠️ 未使用 |
| `horizontal_flip` / `vertical_flip` | false | 水平/垂直翻转 | bool | ✅ |
| `aec` | 1 | 自动曝光 | 0=手动, 1=自动 | ✅ ⚠️ 未使用 |
| `isp_mode` | 0 | ISP 场景模式 | 0=室外, 1=室内, 255=自定义（自定义时使用下述 isp_config） | ✅ |
| `grayscale` | false | 灰度模式 | bool | ✅ |
| `fast_capture_skip_frames` | 10 | 快速抓拍前跳过的帧数（曝光稳定用） | 1–300 | ✅ |
| `fast_capture_resolution` | 0 | 快速抓拍分辨率 | 0=1280×720, 1=1920×1080, 2=2688×1520 | ✅ |
| `fast_capture_jpeg_quality` | 60 | 快速抓拍 JPEG 质量 | 0–100 | ✅ |
| `capture_disable_comm` | false | 抓拍后仅存本地、不走通信上传 | bool | ✅ ⚠️ 未使用（未见生效路径） |
| `capture_storage_ai` | false | 抓拍额外保存一张绘制了 AI 结果的图片 | bool | ✅ |

### light_config（补光灯）

网页入口：硬件管理 → 补光灯。

| 字段 | 默认 | 说明 | 范围/枚举 | 导入 |
|---|---|---|---|---|
| `connected` | false | 灯硬件在位探测结果（运行时状态） | — | 📄 |
| `mode` | 0 | 工作模式 | 0=关闭, 1=常亮, 2=自动, 3=自定义时段 | ✅ |
| `start_hour`/`start_minute`/`end_hour`/`end_minute` | 18:00–06:00 | 自定义时段起止（可跨午夜） | 时 0–23，分 0–59 | ✅ |
| `brightness_level` | 50 | 亮度 | 0–100 | ✅ |
| `auto_trigger_enabled` | true | 自动模式下按环境光触发 | bool | ✅ |
| `light_threshold` | 30 | 自动触发光敏阈值 | 0–100 | ✅ |
| `fill_light_while_streaming` | false | 运行期间补光灯常亮（唤醒抓拍仍走闪光逻辑） | bool | ✅ |

### isp_config（自定义 ISP IQ 参数）

机器生成的参数段，完整映射 STM32 ISP 库的 IQ 结构。**仅在 `image_config.isp_mode=255` 且本段 `valid=true` 时生效**；由网页 ISP 自定义模式的导出/导入功能维护，**不建议手工编辑**。随配置文件导出/导入。字段清单（`valid` 为整段有效性标志）：

| 分组 | 字段 | 说明 / 范围 |
|---|---|---|
| 统计行剔除 | `stat_removal_enable`, `stat_removal_head_lines`(0–7), `stat_removal_valid_lines`(0–4094) | 剔除图像顶部无效统计行 |
| 去马赛克 | `demosaic_enable`, `demosaic_type`(Bayer 图案 0–4), `demosaic_peak`/`demosaic_line_v`/`demosaic_line_h`/`demosaic_edge`(均 0–7) | 插值参数 |
| 对比度 | `contrast_enable`, `contrast_lut[9]` | LUT（LUM_0–LUM_256，各 0–394） |
| 统计区域 | `stat_area_x/y/width/height` | AEC/AWB 统计窗口（像素） |
| 传感器手动增益/曝光 | `sensor_gain`(mdB), `sensor_exposure`(µs) | AEC 关闭时的静态值 |
| 坏点算法 | `bad_pixel_algo_enable`, `bad_pixel_algo_threshold` | 动态坏点检测 |
| 坏点静态强度 | `bad_pixel_enable`, `bad_pixel_strength`(0–7) | 静态坏点修补强度 |
| 黑电平 | `black_level_enable`, `black_level_r/g/b`(各 0–255) | 逐通道黑电平 |
| AEC | `aec_enable`, `aec_exposure_compensation`(−4~+4 EV), `aec_anti_flicker_freq`(0=关, 50, 60) | 自动曝光算法 |
| AWB（5 组档案） | `awb_enable`, `awb_label[5]`, `awb_ref_color_temp[5]`, `awb_gain_r/g/b[5]`, `awb_ccm[5][3][3]`, `awb_ref_rgb[5][3]` | 白平衡档案：标签/参考色温/增益/色彩矩阵/参考 RGB |
| ISP 手动增益 | `isp_gain_enable`, `isp_gain_r/g/b` | AWB 关闭时静态增益（100000000 = 1.0×） |
| 静态色彩转换 | `color_conv_enable`, `color_conv_matrix[3][3]` | 矩阵元素 100000000 = 1.0 |
| Gamma | `gamma_enable` | Gamma 使能 |
| 传感器延迟 | `sensor_delay` | 帧数 |
| Lux 标定 | `lux_hl_ref`/`lux_hl_expo1`/`lux_hl_lum1`/`lux_hl_expo2`/`lux_hl_lum2`（高亮参考）, `lux_ll_*`（低亮参考）, `lux_calib_factor` | 环境光估计标定 |

## network_service（网络）

网页入口：系统设置（通讯方式 / WiFi / 热点）、硬件管理。

| 字段 | 默认 | 说明 | 范围/枚举 | 导入 |
|---|---|---|---|---|
| `ap_sleep_time` | 0 | 热点空闲休眠时间 | 秒；仅允许 0（永不）/ 600 / 1200 / 1800（10/20/30 分钟），非法值视为缺省、保留本机设置（网页设置接口则显式报错拒绝） | 🔧 |
| `ssid` / `password` | `"AICAM-AP"` / 空 | 设备自身热点的名称与密码。留空/默认时，运行期自动生成 `NE302_XXXXXX`（按身份 MAC）。⚠️ 密码随导入存储但**不生效**——本固件版本热点始终开放运行（芯片限制：AP 设置密码后 STA 无法连接网络） | 字符串 | ✅ |
| `wifi_country_code` | 空 | WiFi 国家码（大小写不敏感，入库统一为小写；不支持的取值视为缺省、保留本机设置） | 空=固件默认区域；us/eu/jp/kr/cn | ✅ |
| `known_network_count` | 0 | 已知网络条数 | 0–16；导入时钳位到数组实际长度 | 🔧 |
| `known_networks[]` | [] | 已知 WiFi 列表。**仅凭据随导入**：`ssid`/`bssid`/`password`/`security`；`rssi`/`channel`/`connected`/`is_known`/`last_connected_time` 是源设备扫描缓存，导出留档、导入忽略 | `security`：见下方无线安全枚举 | 🔧 |
| `preferred_comm_type` | 0 | 优先通讯方式 | 0=自动(无偏好), 1=WiFi, 2=HaLow, 3=4G蜂窝, 4=PoE | ✅ |
| `enable_auto_priority` | true | 无首选时按链路质量自动选网 | bool | ✅ |

`security`（无线安全类型，同样适用于 HaLow `security`）：0=OPEN, 1=WPA, 2=WPA2, 3=WEP, 4=WPA企业, 5=WPA2企业, 6=WPA/WPA2混合, 7=WPA3, 8=WPA3过渡, 9=WPA3企业, 10=WPA3过渡企业, 11=OWE, 12=SAE, 0xFFFF=未知。

### cellular（4G 蜂窝）

| 字段 | 默认 | 说明 | 导入 |
|---|---|---|---|
| `apn`/`username`/`password`/`pin_code` | 空 | 接入点与鉴权凭据 | ✅ |
| `authentication` | 0 | 鉴权方式（0=无） | ✅ ⚠️ 未使用 |
| `enable_roaming` | false | 允许漫游 | ✅ |
| `operator` | 0 | 运营商选择 | ✅ ⚠️ 未使用 |

### poe（PoE / 以太网）

| 字段 | 默认 | 说明 | 范围 | 导入 |
|---|---|---|---|---|
| `ip_mode` | 0 | 取址方式 | 0=DHCP, 1=静态 | ✅ |
| `ip_addr`/`netmask`/`gateway`/`dns_primary`/`dns_secondary` | 192.168.1.100/24, 网关 .1, DNS 8.8.8.8/8.8.4.4 | 静态模式网络参数（4 字节数组） | — | ✅ |
| `hostname` | 空 | DHCP 主机名 | — | ✅ |
| `dhcp_timeout_ms` / `dhcp_retry_count` / `dhcp_retry_interval_ms` | 30000 / 3 / 5000 | DHCP 超时与重试 | — | ✅（`dhcp_retry_interval_ms` ⚠️ 未使用） |
| `power_recovery_delay_ms` | 5000 | PoE 上电后等待稳定的时间 | — | ✅ |
| `auto_reconnect` | true | 断线自动重连 | bool | ✅ |
| `persist_last_ip` | true | 记住上次 IP（加速重连） | bool | ✅ |
| `validate_gateway` / `detect_ip_conflict` | false | 网关可达性检查 / IP 冲突检测 | bool | ✅ |

导入的 PoE 参数在**下次重启**（或下次发起连接/网页重新保存触发 `nm_set_netif_cfg`）时生效；导入时已建立的链路不会被在线重配——与 WiFi 区域码的"重启后生效"语义一致。

### halow（HaLow 802.11ah）

| 字段 | 默认 | 说明 | 范围 | 导入 |
|---|---|---|---|---|
| `ssid`/`password`/`security`/`country_code`/`bssid` | 空 | HaLow 连接参数 | security 同上表 | ✅ |
| `ip_mode`/`ip_addr`/`netmask`/`gateway` | DHCP, 192.168.12.199/24 | 静态网络参数 | — | ✅ |
| `tx_power_dbm` | 0 | 发射功率（0=默认） | dBm | ✅ |
| `scan_dwell_ms` | 30 | 扫描驻留时间 | 毫秒 | ✅ |
| `rc_mcs` / `rc_bw_mhz` / `rc_gi` | -1 | 速率控制 MCS / 带宽 / 保护间隔，**-1=自动** | — | ✅ |
| `ps_mode` | 0 | HaLow 芯片省电 | 0=关, 1=开 | ✅ |

## mqtt_service（MQTT）

网页入口：应用管理 → MQTT。

### base_config

| 字段 | 默认 | 说明 | 范围 | 导入 |
|---|---|---|---|---|
| `protocol_ver` | 4 | 协议版本 | 3=MQTT 3.1, 4=3.1.1 | ✅ |
| `hostname` / `port` | mqtt.example.com / 1883 | 服务器地址与端口 | 端口 1–65535 | ✅ |
| `client_id` | `AICAM-000000` | 客户端 ID。默认哨兵会在连接构建时按 MAC 改写为 `NE302-XXXXXX` | ≤64 字符 | ✅ |
| `clean_session` | 1 | 清除会话 | 0/1 | ✅ |
| `keepalive` | 180 | 保活间隔 | 秒 | ✅ |
| `username` / `password` | 空 | 登录凭据（明文存储） | — | ✅ |
| `ca_cert_path`/`client_cert_path`/`client_key_path` + `*_len` | 空/0 | 证书文件路径与长度 | — | ✅ |
| `ca_cert_data`/`client_cert_data`/`client_key_data` | null | 证书内容（内嵌）。**仅文件携带时才重写 Flash 里的证书文件**；键缺失/为 null 保留设备现有证书 | — | 🔧 |
| `verify_hostname` | 0 | TLS 校验主机名 | 0/1 | ✅ |
| `lwt_topic`/`lwt_message`/`lwt_msg_len` | aicam/status/offline, "offline" | 遗嘱消息 | — | ✅ |
| `lwt_qos` / `lwt_retain` | 1 / 1 | 遗嘱 QoS / 保留 | QoS 0–2 | ✅ |
| `task_priority` / `task_stack_size` | 32 / 4096 | MQTT 任务优先级 / 栈大小 | — | ✅ |
| `disable_auto_reconnect` | 0 | 关闭自动重连 | 0/1 | ✅ |
| `outbox_limit` / `outbox_resend_interval_ms` / `outbox_expired_timeout_ms` | 10 / 1000 / 30000 | 发件箱容量 / 重发间隔 / 过期时间 | — | ✅ |
| `reconnect_interval_ms` / `timeout_ms` | 10000 / 3000 | 重连间隔 / 网络超时 | — | ✅ |
| `buffer_size` / `tx_buf_size` / `rx_buf_size` | 0 / 1572864 / 102400 | 缓冲区大小（0=用 buffer_size） | 字节 | ✅ |

### 主题与上报

| 字段 | 默认 | 说明 | 导入 |
|---|---|---|---|
| `data_receive_topic` | `ne302/XXXXXX/down/control` | 下行控制主题（按设备 MAC 派生，可改） | ✅ |
| `data_report_topic` | `ne302/XXXXXX/upload/report` | 数据上报主题 | ✅ |
| `status_topic` | `aicam/status` | 状态主题 | ✅ |
| `command_topic` | `aicam/command` | 命令主题 | ✅ |
| `data_receive_qos` / `data_report_qos` / `status_qos` / `command_qos` | 0 | 各主题 QoS（0–2） | ✅ |
| `auto_subscribe_receive` / `auto_subscribe_command` | true | 连接后自动订阅 | ✅ |
| `enable_status_report` / `status_report_interval_ms` | true / 60000 | 状态上报 | ✅ |
| `enable_heartbeat` / `heartbeat_interval_ms` | true / 30000 | 心跳 | ✅ |
| `report_content` | 0 | 上报内容：0=图+元数据+AI 结果, 1=仅元数据+AI 结果 | ✅ |
| `telemetry_enabled` / `telemetry_topic` / `telemetry_qos` | false / 按 MAC 派生 / 0 | 遥测 | ✅ |
| `telemetry_format` | 0 | 遥测格式：0=JSON, 1=CBOR | ✅ |

## work_mode_config（工作模式与触发）

网页入口：功能调试（触发配置）、推流面板。

| 字段 | 默认 | 说明 | 枚举 | 导入 |
|---|---|---|---|---|
| `work_mode` | 0 | 工作模式 | 0=图像模式 | ✅ ⚠️ 未使用（固件仅图像模式） |
| `image_mode.enable` | true | 图像模式（抓拍）使能 | bool | ✅ ⚠️ 未使用 |

### video_stream_mode（推流）

| 字段 | 默认 | 说明 | 范围 | 导入 |
|---|---|---|---|---|
| `enable` | false | 视频流模式总开关 | bool | ✅ ⚠️ 未使用（推/拉流由 rtmp_enable / rtsp_enable 各自独立控制，此父级开关无消费方） |
| `rtmp_enable` | false | RTMP 推流开关 | bool | ✅ |
| `rtmp_url` / `rtmp_stream_key` | 空 | RTMP 地址与流密钥（明文存储） | — | ✅ |
| `rtsp_enable` | false | RTSP 服务开关 | bool | ✅ |
| `rtsp_port` | 554 | RTSP 端口 | 1–65535 | ✅ |
| `rtsp_auth_mode` | "none" | RTSP 鉴权 | none / digest（其他值按无鉴权处理） | ✅ |
| `rtsp_username` / `rtsp_password` | 空 | RTSP 账号（明文存储） | — | ✅ |

### pir_trigger（人体感应）

| 字段 | 默认 | 说明 | 范围 | 导入 |
|---|---|---|---|---|
| `enable` | false | PIR 触发开关 | bool | ✅ |
| `pin_number` | 2 | PIR 引脚号 | — | ✅ |
| `trigger_type` | 0 | 触发边沿 | 0=上升, 1=下降, 2=双沿, 3=高电平, 4=低电平 | ✅ |
| `sensitivity_level` | 30 | 灵敏度，**值越小越灵敏**（建议 >30） | 0–255 | ✅ |
| `ignore_time_s` | 7 | 触发后忽略时长；实际秒数 = 0.5 + 0.5×值 | 0–15 | ✅ |
| `pulse_count` | 1 | 判定脉冲数；实际个数 = 值 + 1 | 1–4 | ✅ |
| `window_time_s` | 0 | 判定窗口；实际秒数 = 2 + 2×值 | 0–3 | ✅ |
| `disable_in_preview` | true | 预览期间暂停 PIR 抓拍 | bool | ✅ |

### timer_trigger（定时抓拍）

| 字段 | 默认 | 说明 | 范围/枚举 | 导入 |
|---|---|---|---|---|
| `enable` | false | 定时触发开关 | bool | ✅ |
| `capture_mode` | 1 | 抓拍模式 | 0=关闭, 1=普通间隔, 2=绝对时刻 | ✅ |
| `interval_sec` | 60 | 普通间隔模式的抓拍间隔 | 秒 | ✅ |
| `time_node_count` | 0 | 时刻点个数 | 0–10；导入时钳位（>10 或大于数组实际长度都收缩） | 🔧 |
| `time_node[10]` | 0 | 绝对时刻模式的时刻点，**自午夜秒数**（如 7:30 = 27000） | 0–86399 | ✅ |
| `weekdays[10]` | 0 | 星期过滤：0=每天，1–7=周一…周日；可多选 | 0–7 | ✅ |
| `interval_mode` | 0 | 间隔模式：网格对齐方式 | 0=普通（保存即起算）, 1=定时间隔（每日窗口）；越界忽略 | 🔧 |
| `start_time` / `end_time` | 0 | 每日窗口起止，自午夜秒数；窗口**可跨午夜**（end < start 表示过零点）；越界（≥86400）忽略 | 0–86399 | 🔧 |
| `anchor_time` | 0 | 间隔网格锚点（自午夜秒数）。滚动窗口跨午夜连续流动；**0=未盖章哨兵**，应用时以当前时刻盖章，原样往返 | 0–86399 | 🔧 |

### io_trigger[]（IO 触发，固定 2 路）

⚠️ **整组未接线**：注册 API 存在但无调用方，当前固件不生效。每路含：`pin_number`（0/1）、`enable`、`input_enable`、`output_enable`、`input_trigger_type`、`output_trigger_type`（枚举同 PIR `trigger_type`）。字段随导出/导入往返。

### remote_trigger

`enable`：远程唤醒触发开关，✅ 导入。仅设备用本机 WiFi 联网时可用（休眠期间靠 WiFi 芯片保活 MQTT 连接）。

## webhook_config（Webhook 通知）

网页入口：应用管理 → Webhook。

| 字段 | 默认 | 说明 | 枚举 | 导入 |
|---|---|---|---|---|
| `enable` | false | Webhook 开关 | bool | ✅ |
| `url` | 空 | 回调地址 | — | ✅ |
| `auth_type` | 空 | 鉴权方式 | 留空=无, bearer, basic, custom | ✅ |
| `secret` | 空 | 鉴权密钥（明文存储） | — | ✅ |

注意：Webhook 的**自定义 CA 证书是独立文件，不随配置导出**，换机需在网页重新上传。

## capture_upload_config（抓拍上传策略）

网页入口：抓拍设置。**整段导入时走与网页相同的归一化**（下表「归一化」列即落盘前规则）。

| 字段 | 默认 | 说明 | 范围/枚举 | 导入 |
|---|---|---|---|---|
| `version` | 1 | 策略结构版本 | — | 🔧 0 自动补 1 |
| `mode` | 0 | 上传模式 | 0=即拍即传, 1=批量, 2=定时, 3=仅本地 | 🔧 越界回 0 |
| `storage` | 0 | 存储位置 | 0=自动(SD 优先回落机身), 1=机身 Flash, 2=SD 卡, 3=不落盘(仅即拍即传) | 🔧 越界回 0；=3 且 mode≠0 时降为 0 |
| `policy` | 0 | 存满策略 | 0=循环覆盖, 1=存满即停 | 🔧 越界回 0 |
| `upload_protocol` | 0 | 上传协议 | 0=MQTT, 1=Webhook | 🔧 越界回 0 |
| `retry_enable` | true | 失败重试 | bool | 🔧 mode=3 或 storage=3 时强制 false |
| `retry_max_attempts` | 5 | 单条最大重试次数 | 0=无限, 1–20 | 🔧 >20 钳 20 |
| `batch_count` | 10 | 批量模式每批条数 | 2–20 | 🔧 <2 钳 2，>20 钳 20 |
| `schedule_node_count` | 0 | 定时上传时刻个数 | 0–8 | 🔧 越界钳 8；数组缩短时同步收缩 |
| `schedule_minutes[]` | [] | 定时上传时刻（**当天分钟数**，如 7:30 = 450） | 0–1439 | 🔧 >1439 归 0 |
| `keep_sent_hours` | 72000 | 已发送记录保留时长 | 小时；72000（≈8.2 年）=永久（仅满/超条数时清理） | 🔧 >72000 钳 72000 |
| `max_pending_records` | 200 | 待上传队列上限 | 200–1000 | 🔧 0→200，>1000→1000；⚠️ 未使用（管线未读取该上限） |
| `flash_max_records` | 32 | 机身 Flash 记录总数上限 | 16–256 | 🔧 0/越界→32，<16→16 |
| `upload_comm_type` | 0 | 上传网络（**仅对休眠唤醒后的上传生效**） | 0=默认逻辑, 1=WiFi, 2=HaLow, 3=4G, 4=PoE | ✅ |

## auth_mgr（登录与会话）

| 字段 | 默认 | 说明 | 导入 |
|---|---|---|---|
| `session_timeout_ms` | 3600000 | 会话超时（1 小时） | ✅ ⚠️ 未使用 |
| `enable_session_timeout` | false | 启用会话超时 | ✅ ⚠️ 未使用 |
| `admin_password` | hicamthink | 管理密码（**明文**存储在文件里） | ✅ |

## sys_clk_profile（工作主频）

网页入口：功能调试（工作主频）。存于 FSBL 配置区，不属 json_config 结构，由导出/导入接口单独挂接。

| 字段 | 默认 | 说明 | 范围/枚举 | 导入 |
|---|---|---|---|---|
| `sys_clk_profile` | 4（HSE 800） | 工作主频档 | 1=HSE 200MHz, 2=HSE 400MHz, 3=HSI 800MHz, 4=HSE 800MHz | 🔧 非法值（负数/小数/超范围/非数字）整份导入被拒；**键缺失或 0（未修改设备导出）保持当前档**；重启后生效；恢复出厂清回默认档；档位 3 为 FSBL 启动时钟，存 3 无切换动作属正常 |

---

## 附：导入行为速查

| 类别 | 字段 |
|---|---|
| 完全不导入（仅导出留档） | 整个 `device_info`；`light_config.connected`；`power_mode_config.last_activity_time / mode_switch_count`；已知网络的 `rssi / channel / connected / is_known / last_connected_time`；`checksum / timestamp`（设备重算） |
| 导入但有特殊处理 | `current_mode / default_mode`（越界忽略）；`last_activity_time`（本机重盖）；MQTT `*_cert_data`（仅携带时重写 Flash）；各计数类（钳位）；`capture_upload_config` 整段归一化；`sys_clk_profile`（校验、缺失/0 保持当前、重启生效）；`config_version`（门控+钉回） |
| 手改文件防护 | 数组缩短时计数收缩（时间节点/已知网络/上传时刻）；`time_node_count` 上限 10；`interval_mode / start_time / end_time / anchor_time` 越界忽略；版本号大于固件拒收整份文件 |
