camthink-ai/ne302/docs/zh/index.md

---
layout: home

hero:
  name: NE302
  text: AI 摄像头固件与 Web API 文档
  tagline: STM32N6 边缘 AI 摄像头 · 固件构建、Web API 与前端集成参考
  actions:
    - theme: brand
      text: 浏览 Web API 文档
      link: /zh/web-api/
    - theme: alt
      text: GitHub
      link: https://github.com/camthink-ai/ne302

features:
  - icon: 📡
    title: RESTful Web API
    details: 网络、抓拍、推流、OTA、MQTT 等模块的完整端点参考由固件源码自动生成，与代码保持同步。
    link: /zh/web-api/
    linkText: 查看端点总览
  - icon: 🔐
    title: 统一认证与响应格式
    details: HTTP Basic Auth + 统一 { code, message, data } 响应结构与业务错误码。
    link: /zh/web-api/authentication
    linkText: 快速开始
  - icon: 🔄
    title: 文档随代码更新
    details: 修改 Custom/Services/Web 下的 API 代码后，CI 自动重新生成端点参考并部署到 GitHub Pages，PR 中强制检查文档同步。
    link: /zh/misc/
    linkText: 了解同步机制
---
