camthink-ai/ne302/docs/web-api/endpoints/network.md

---
title: Network Management Endpoints
---

<!-- GENERATED FILE - do not edit manually. Regenerate with Script/gen_web_api_docs.py -->

# Network Management Endpoints

WiFi / cellular / PoE configuration and status

Source: [`Custom/Services/Web/api/api_network_module.c`](https://github.com/camthink-ai/ne302/blob/main/Custom/Services/Web/api/api_network_module.c)

**49** endpoints. The ✅ marker in the Auth column means the request must carry [credentials](../authentication.md).

| Method | Path | Auth | Handler |
|---|---|:----:|---|
| `GET` | `/api/v1/system/network/status` | ✅ | `network_status_handler` |
| `GET` | `/api/v1/system/network/wifi/sta` | ✅ | `network_wifi_sta_handler` |
| `GET` | `/api/v1/system/network/wifi/info` | ✅ | `network_wifi_info_handler` |
| `GET` | `/api/v1/system/network/wifi/ap` | ✅ | `network_wifi_ap_handler` |
| `POST` | `/api/v1/system/network/wifi/config` | ✅ | `network_wifi_config_handler` |
| `POST` | `/api/v1/system/network/wifi/scan` | ✅ | `network_scan_refresh_handler` |
| `POST` | `/api/v1/system/network/wifi/disconnect` | ✅ | `network_disconnect_handler` |
| `POST` | `/api/v1/system/network/wifi/delete` | ✅ | `network_delete_known_handler` |
| `GET` | `/api/v1/system/network/wifi/region` | ✅ | `network_wifi_region_get_handler` |
| `PUT` | `/api/v1/system/network/wifi/region` | ✅ | `network_wifi_region_set_handler` |
| `GET` | `/api/v1/system/network/halow/sta` | ✅ | `network_halow_sta_handler` |
| `GET` | `/api/v1/system/network/halow/info` | ✅ | `network_halow_info_handler` |
| `GET` | `/api/v1/system/network/halow/region` | ✅ | `network_halow_region_get_handler` |
| `PUT` | `/api/v1/system/network/halow/region` | ✅ | `network_halow_region_set_handler` |
| `POST` | `/api/v1/system/network/halow/scan` | ✅ | `network_halow_scan_handler` |
| `POST` | `/api/v1/system/network/halow` | ✅ | `network_halow_connect_handler` |
| `POST` | `/api/v1/system/network/halow/disconnect` | ✅ | `network_halow_disconnect_handler` |
| `POST` | `/api/v1/system/network/halow/delete` | ✅ | `network_halow_delete_handler` |
| `GET` | `/api/v1/system/network/halow/ip` | ✅ | `network_halow_ip_handler` |
| `POST` | `/api/v1/system/network/halow/ip` | ✅ | `network_halow_ip_handler` |
| `GET` | `/api/v1/system/network/halow/radio` | ✅ | `network_halow_radio_handler` |
| `PUT` | `/api/v1/system/network/halow/radio` | ✅ | `network_halow_radio_handler` |
| `POST` | `/api/v1/system/network/wifi` | ✅ | `network_wifi_config_handler` |
| `POST` | `/api/v1/system/network/scan` | ✅ | `network_scan_refresh_handler` |
| `POST` | `/api/v1/system/network/disconnect` | ✅ | `network_disconnect_handler` |
| `POST` | `/api/v1/system/network/delete` | ✅ | `network_delete_known_handler` |
| `GET` | `/api/v1/system/network/comm/types` | ✅ | `network_comm_types_handler` |
| `POST` | `/api/v1/system/network/comm/switch` | ✅ | `network_comm_switch_handler` |
| `GET` | `/api/v1/system/network/comm/prefer` | ✅ | `network_comm_prefer_handler` |
| `POST` | `/api/v1/system/network/comm/prefer` | ✅ | `network_comm_prefer_handler` |
| `POST` | `/api/v1/system/network/comm/priority` | ✅ | `network_comm_priority_handler` |
| `GET` | `/api/v1/system/network/cellular/status` | ✅ | `network_cellular_status_handler` |
| `GET` | `/api/v1/system/network/cellular/settings` | ✅ | `network_cellular_settings_handler` |
| `POST` | `/api/v1/system/network/cellular/settings` | ✅ | `network_cellular_settings_handler` |
| `POST` | `/api/v1/system/network/cellular/save` | ✅ | `network_cellular_save_handler` |
| `POST` | `/api/v1/system/network/cellular/connect` | ✅ | `network_cellular_connect_handler` |
| `POST` | `/api/v1/system/network/cellular/disconnect` | ✅ | `network_cellular_disconnect_handler` |
| `GET` | `/api/v1/system/network/cellular/info` | ✅ | `network_cellular_info_handler` |
| `POST` | `/api/v1/system/network/cellular/refresh` | ✅ | `network_cellular_refresh_handler` |
| `POST` | `/api/v1/system/network/cellular/at` | ✅ | `network_cellular_at_handler` |
| `GET` | `/api/v1/system/network/poe/status` | ✅ | `network_poe_status_handler` |
| `POST` | `/api/v1/system/network/poe/connect` | ✅ | `network_poe_connect_handler` |
| `POST` | `/api/v1/system/network/poe/disconnect` | ✅ | `network_poe_disconnect_handler` |
| `GET` | `/api/v1/system/network/poe/info` | ✅ | `network_poe_info_handler` |
| `GET` | `/api/v1/system/network/poe/config` | ✅ | `network_poe_config_handler` |
| `POST` | `/api/v1/system/network/poe/config` | ✅ | `network_poe_config_handler` |
| `POST` | `/api/v1/system/network/poe/validate` | ✅ | `network_poe_validate_handler` |
| `POST` | `/api/v1/system/network/poe/apply` | ✅ | `network_poe_apply_handler` |
| `POST` | `/api/v1/system/network/poe/save` | ✅ | `network_poe_save_handler` |
