camthink-ai/ne302/Docs/images/mini_all_board_connect_4.png

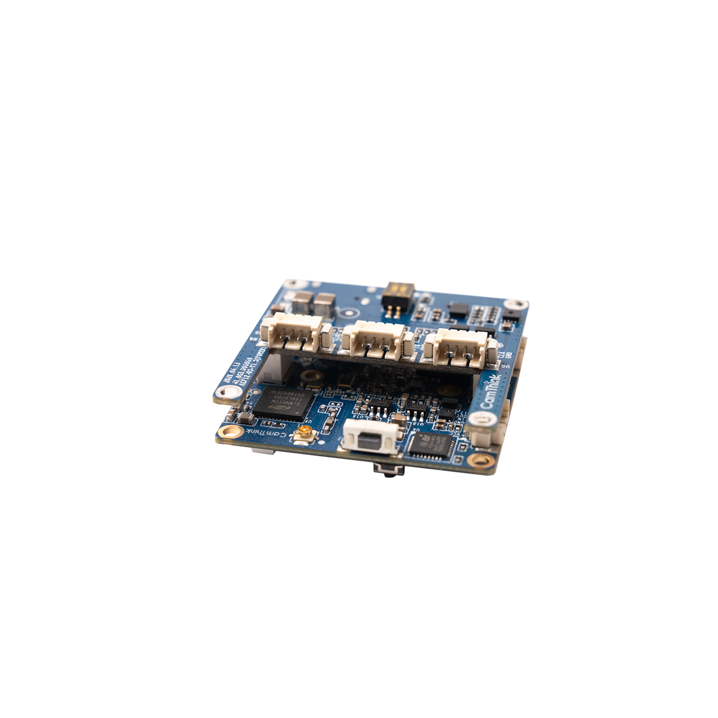
Docs/images/mini_all_board_connect_4.png
