camthink-ai/ne302/Docs/images/mini_interface_board_2.png

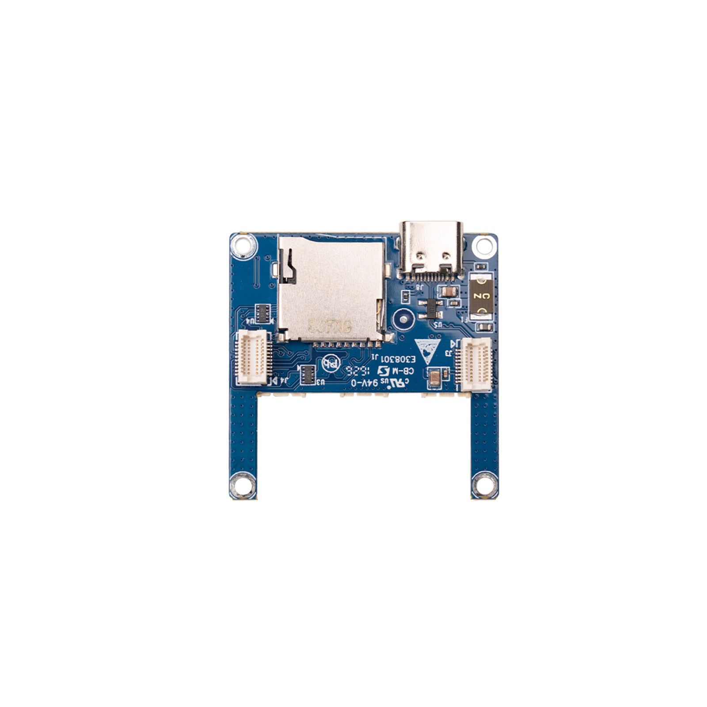
Docs/images/mini_interface_board_2.png
