camthink-ai/ne302/Docs/images/mini_interface_board_labeling_2.png

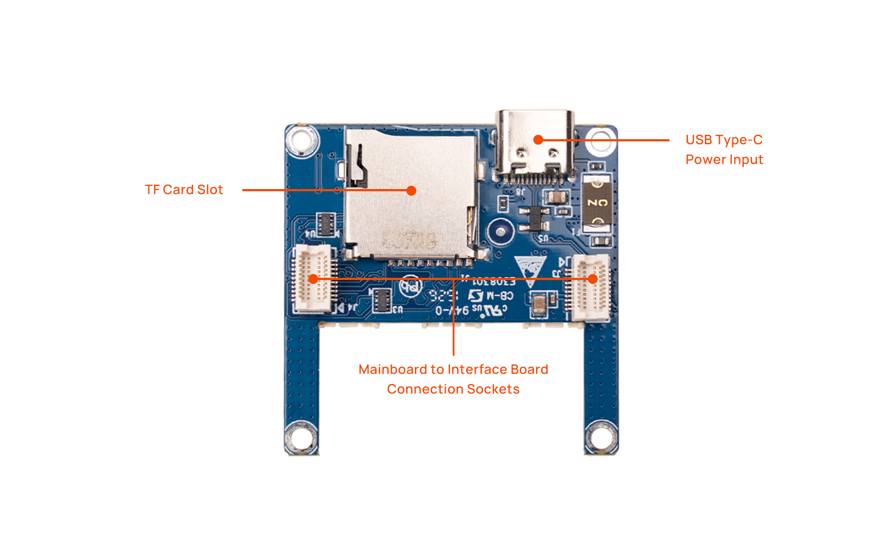
Docs/images/mini_interface_board_labeling_2.png
