camthink-ai/ne302/Docs/images/mini_main_board_1.png

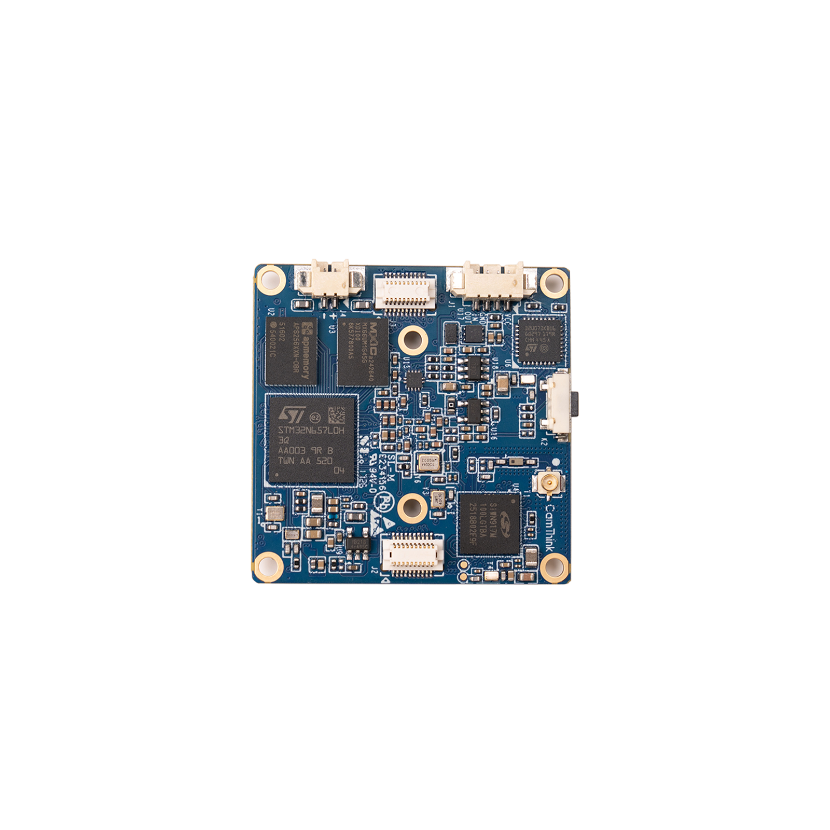
Docs/images/mini_main_board_1.png
