camthink-ai/ne302/Docs/images/mini_main_board_labeling_1.png

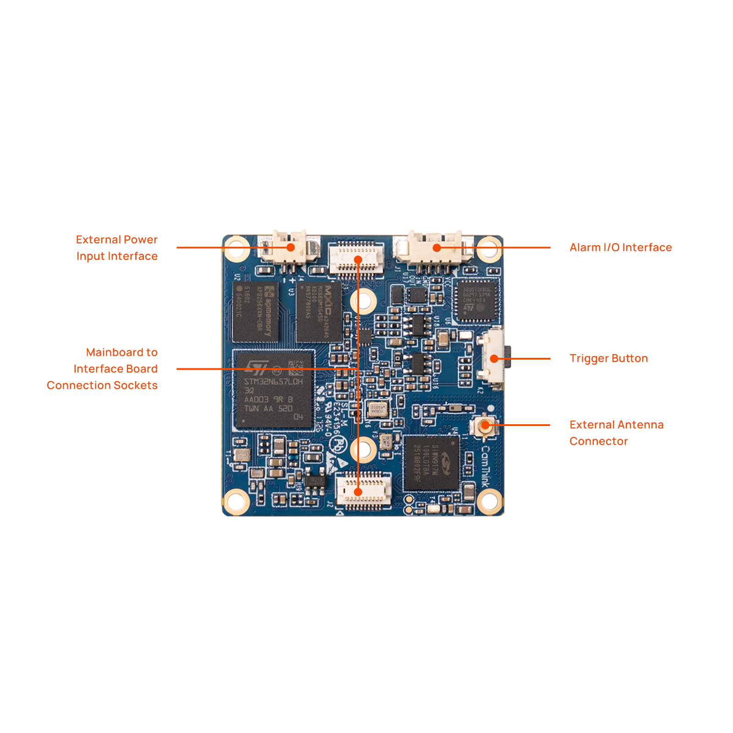
Docs/images/mini_main_board_labeling_1.png
