camthink-ai/ne302/Web/src/assets/images/camthink_Vision_AI_camera_small.webp

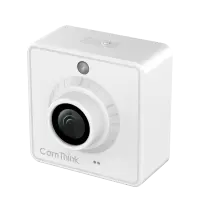
Web/src/assets/images/camthink_Vision_AI_camera_small.webp
