camthink-ai/ne302/Docs/NE302_v4.3.1_ChangeLog.md

# NE302 Firmware v4.3.1 Change Log

> **English** | [中文](./NE302_v4.3.1_ChangeLog_cn.md)

> **Release Range**: all changes since the previous release **v2.1.0** (commit `0198d97`)
> **Release Line**: STEdgeAI 4.x generation (APP major version 2 → 4)
> **HEAD**: `a4fb9fd` (2026-09-14)

---

## Version Information

| Component | Version | Notes |
|---|---|---|
| APP | 4.3.1.x | Main application (BUILD number varies per commit) |
| FSBL | 1.0.3.1 | First Stage Boot Loader (dual-chip NOR Flash auto-detection) |
| WEB | 1.5.0.8 | Web frontend assets |
| WiFi | 2.16.5.108  | SiWG917 wireless firmware (`SiWG917-B.2.16.5.1.0.8`) |
| Model | 4.0.0.0 | AI model package (STEdgeAI 4.x) |
| WakeCore | 0.2.7.5 | Co-processor firmware |

---

## Change Summary

v4.3.1 is the largest release since v2.1.0: the Flash partition and memory layouts were restructured, the WiFi host stack was fully migrated, and a new capture-upload pipeline plus one-click bundle upgrade were introduced, along with extensive field-stability fixes. The most important changes are listed below; see the later sections for details.

### Highlights — New Features

1. **One-click bundle upgrade (OTA Bundle)** — `make pkg-bundle` packs all firmware images into a single file that upgrades the whole device in one web upload: the bundle carries its own partition table (layout migration), same-version entries can be skipped by choice, cross-model packages are hard-rejected, and the FSBL payload is staged and verified before it is written. Future full-device upgrades (including partition-table changes) no longer require handling each firmware one by one.
2. **WiFi subsystem overhaul** — host driver ported to the WiseConnect 4.1.1 SDK; new WiFi firmware OTA upgrade (paired firmware `2.16.5.108` with automatic mismatch guidance); WiFi region code (us / eu / jp / kr / cn); host-side AP DHCP server with sticky leases; plus a series of Si91x SPI-bus and host-stack hardening fixes.
3. **Capture-upload pipeline** — a new end-to-end capture-upload system: four upload modes (instant / batch / scheduled / local-only), MQTT batch publishing and webhook delivery, power-aware wake scheduling, SD hot-plug auto-switching, and a web management UI.
4. **Full HaLow (802.11ah) support** — mm6108 / mm8108 build-time chip switch, web configuration for radio parameters and extended country codes, and a web power-save switch (default off, paired dynamic-PS timeout).
5. **Web management UI overhaul** — a dedicated Web partition with automatic fallback into the built-in Web Recovery; new file management (Flash / SD) and a firmware-upgrade center (APP / Web / Model / FSBL / WiFi / bundle + expected-version checks); a major connection & stream-stability rework.
6. **AI & models** — unified build-time selection of the STEdgeAI 2.2 / 3.0 / 4.0 runtimes (this release line is 4.x); AI partitions enlarged to 8MB A/B slots; new capabilities including pose estimation, pointer-meter reading, instance segmentation, and BlazeFace face detection.

### Highlights — Fixes

1. **Black screen for late-joining live-preview clients** — the encoder emits SPS/PPS only once per session, leaving late joiners permanently black; clients are now keyframe-synced individually.
2. **Video-pipeline stop deadlock** — `video_pipeline_stop()` waited unbounded for a blocked node thread while holding the mutex, wedging the HTTP task; now bounded by 3 s with force-termination.
3. **Web connection & stream-stability overhaul** — one-request connections, static-asset etag/304 caching, FIFO-copied video frames, and a per-client WS send-buffer cap, eliminating `err_network` popups and smearing on the phone link.
4. **Startup-decision timer-thread stack overflow** — the startup-timeout callback ran on the tiny ThreadX timer thread where any printf/LOG overflowed into a HardFault; the decision now runs on a dedicated large-stack thread.
5. **JPEG tail truncation** — fixed DMA padding / EOI truncation causing bottom-mosaic and incomplete rendering in browser previews.
6. **XSPI erase busy-poll watchdog starvation** — a 4K NOR erase spun 45–200 ms in a tight ready-poll with no yield; under the realtime-priority web task this starved the watchdog past its 16 s IWDG window — silent resets with no log. The ready-poll now yields periodically.
7. **RTMP last-NAL truncation** — a start-code scan bound left the final NAL of every pushed frame three bytes short (~0.4% of frames showed bottom-row macroblock errors); after the fix, 0 decoder errors vs 4,027 lines on the concurrent unpatched control.
8. **RTMP push never auto-started** — `rtmp_enable` was persisted but never acted on, so the push sat idle after every reboot until an external `start` call (~6 minutes of lost footage each time); the push now starts on its own once the station link comes up.
9. **Camera buffer races and the encoder's cold-start all-INTRA latch** — the DCMIPP could still be DMA-writing a published buffer (torn frames); an encoder failing its first frame forced every later frame to full INTRA until a costly escape (now automatic via a QP-floor step-up).

---

## ⚠️ BREAKING CHANGES

### 1. Flash Partition Table Redesign

The Flash partition layout has been restructured. **The new Web firmware must be re-uploaded**, and the system prompts when FSBL or WiFi firmware versions are mismatched.

| Partition  | Old (v2.1.0) | New (v4.3.1) | Change |
|---|---|---|---|
| AI_1 | 5MB @ 0x70E00000 | 8MB @ 0x70900000 | Address moved forward, size doubled (merged AI_DEFAULT) |
| AI_2 | 5MB @ 0x71300000 | 8MB @ 0x71100000 | Address moved forward, size doubled (merged AI_3) |
| AI_DEFAULT | 5MB @ 0x70900000 | — Removed — | Merged into AI_1 |
| AI_3 | 8MB @ 0x71800000 | — Removed — | Merged into AI_2 |
| WEB | — N/A — | 1MB @ 0x71900000 | **New** independent Web partition |
| WiFi FW | 4MB @ 0x77C00000 | 3MB @ 0x71A00000 | Address moved forward, size adjusted |
| LittleFS  | 64MB @ 0x72000000 | 32MB/96MB @ 0x71D00000  | Address changed for 64MB/128MB Flash support; first boot reformats it. Ordinary snapshots were not stored here, but MQTT TLS CA/client-certificate/private-key files are lost; NVS and SD data remain intact |
| Reserve2  | 28MB @ 0x76000000 | 3MB @ 0x73D00000/0x77D00000 | Address and size changed |

### 2. PSRAM Memory Layout Changes

- **APP PSRAM boot**: PSRAM execution is now the only mode (conditional compilation removed). APP available space increased from 4032K to 4096K.
- **PSRAM SWAP region removed**: the 64KB PSRAM SWAP region at `0x903F0000` has been removed.
- **New SRAM_POOL region**: `0x34000000-0x341B1FFF` (1736K). The former SRAM APP space is now a general-purpose memory pool.
- **UNCACHED region adjusted**: start address moved from `0x341A0000` to `0x341B2000`.

### 3. WiFi Firmware Upgrade (Required)

- SiWG917 wireless firmware upgraded to **`SiWG917-B.2.16.5.1.0.8`** (encoded `2.16.5.108`), bundled with the new SDK.
- Older WiFi firmware (e.g., `2.14.5.x`) remains functional, but the device shows an upgrade prompt until the expected version is reached.
- New `EXPECTED_WIFI_VERSION` / `EXPECTED_FSBL_VERSION` compile-time version-check mechanism.

---

## New Features (Details)

### One-Click Bundle Upgrade (OTA Bundle)

Upgrade the entire device in a single upload, explicitly covering the "partition table changed" scenario (where old firmware cannot burn new firmware at the new addresses).

- **Packaging**: `make pkg-bundle` produces `ne302_Full_v<version>_bundle.bin` — a 4KB outer header (sub-firmware manifest + new partition table) followed by the existing `_pkg.bin` files in burn order (Model → Web → WiFi → APP → FSBL). Inner package formats are unchanged; CI produces the bundle artifact as well.
- **Entry point**: System Settings → Firmware Upgrade → Import Firmware → Advanced Options → **Bundle Upgrade** (`/import-bundle`).
- **Precheck burn plan**: after the file is selected, the device parses the bundle header, compares its own partition table and versions, and returns a burn plan (type / version / target address). **Same-version entries on unmoved partitions can be skipped by choice** (re-validated on the device; not all entries may be skipped; skipping WiFi also withdraws the push flag so a stale `.rps` is not pushed). FSBL may additionally be skipped only when the layout is completely unchanged; a **layout-changing bundle must contain an FSBL entry**, otherwise precheck rejects it.
- **Unified forced direct burn**: entries burn directly at the addresses from the bundle's own partition table (no AB slots); the OTA info partition is erased when the session starts, and SystemState is rebuilt from the new layout on the next boot.
- **Partition-drift warning**: every single-firmware package records a CRC of its build-time partition table in the OTA header; on mismatch with the running firmware's table, all single-firmware upgrade pages show a warning dialog (continue anyway, or switch to the bundle path which migrates layouts).
- **Device model gate**: OTA headers carry a `device_model` field (NE302 = 0x3020; unstamped legacy packages are allowed through), checked at both precheck and upload — cross-model firmware (e.g., an NE301 package on an NE302) is hard-rejected. The root Makefile's `DEVICE_MODEL` is the single source of truth.
- **Burn protections**: the FSBL payload is staged in PSRAM and only written after its CRC verifies; OTA uploads refresh the AP sleep timer so low-power mode cannot sleep mid-burn.
- **Frontend burn shield**: route blocker + `beforeunload` + a full-viewport mask prevent accidentally leaving during the burn; a stall of >4s shows an "erasing partition" hint (an 8MB AI partition erase takes seconds); a completion screen follows, with `/upgrade-waiting` guidance when the device is unreachable.
- Design document: `Script/docs/NE302_OTA_Bundle_Design_EN.md`.

### WiFi Firmware OTA Upgrade

- New OTA upgrade support for the SiWG917 WiFi firmware via the Web UI or system settings.
- **Two-stage upgrade flow**:
  1. **Upload stage**: streaming write to Flash (`WIFI_FW_BASE`), writing `flash_header_t` + `.rps` firmware binary. The OTA header is used for Web-side validation only and is NOT written to Flash.
  2. **Confirm stage**: sets NVS `wifi_mode=update` flag. On next reboot, `firmware_upgrade_from_flash()` pushes the `.rps` to the SiWG917 chip.
- **WiFi version detection**: the system reads both the Flash-stored WiFi firmware version and the chip's current running version, displaying both on the firmware upgrade page with automatic mismatch detection.
- **Expected version check**: when the Flash and running versions match but differ from the expected version, the Web UI shows an upgrade prompt dialog.
- **Upgrade waiting page**: pushing the WiFi firmware to the chip takes ~1–3 minutes. The frontend polls the device after reboot and redirects to an LED-guided waiting page (`/upgrade-waiting`) on timeout.
- `firmware_upgrade_from_flash()` and the WiFi firmware flash-header reads all hold the storage lock, avoiding concurrent-filesystem conflicts (including the XIP memory-mapped disable window); all error paths release resources properly.
- Firmware source is selected by trigger: **Web OTA uses Flash, recovery/CLI uses the SD file** (so a stray firmware on the SD card can no longer hijack a Web-uploaded one).
- New `wifi_mark_update_pending()` / `wifi_get_running_version()` / `wifi_get_flash_version()` APIs.

### WiFi Host SDK Upgrade (WiseConnect 4.1.1)

- WiFi host driver ported to the vendor **WiseConnect 4.1.1 SDK** (`SiliconLabs_SDK_4_1_1`; the previous 4.0.2 tree is retained for rollback). The SiWG917 chip firmware is unchanged at `2.16.5.1.0.8` — this is a host-side API migration, not a firmware upgrade.
- HAL adapted to the new SDK: `sli_si91x_driver_send_command` → `sli_wifi_send_command`, `sli_si91x_host_free_buffer` → `sli_buffer_manager_free_buffer`; the NCP host moved to an `rx_irq`/`rx_done` bus model with plain GPIO wake-read (the old `sem_sta` acquire stalled every SPI transaction).
- **EXTENDED scan HardFault fixed**: the firmware delivers each AP as a beacon (`result != NULL`, auto-accumulated into the SDK DB); only the empty-payload event means scan-done. A guard now skips intermediate beacons so AP/STA restore runs once — previously mid-scan re-ups triggered `0x19` busy → HardFault.
- **TWT auto-select** via the public v2 API (sync + async AP-negotiation wait); `low_power_mode_ctrl` now takes a full config (profile/dtim/monitor/beacon-miss), with new CLI `twt` and `lpwr` commands.
- **Host-bus & driver-layer hardening** (done together with the migration): `ulp_wakeup_init` moved from an infinite loop to bounded retry, desynced polls yield via periodic `osDelay`, host SPI transfers all go through the mutex + DMA-safe static buffers, chip-select is driven by peripheral NSS, 30 consecutive 0x19 TX failures auto-escalate into firmware-error recovery, and SDK asserts feed fault-safe recovery paths — a bus desync or firmware pipe wedge no longer hangs the device silently.
- An empty AP SSID after a config reset now auto-generates a `NE302_<mac>` default.

### WiFi Region Code

- New `sl_net_wifi_set/get_region_code` plus index/count helper APIs, supporting **us / eu / jp / kr / cn**.
- Applied on the next `sl_wifi_init`; both netifs must be DEINIT before setting; `wifi_country_code` persists to NVS.
- Exposed via Web API + WiFi region settings UI.
- `WORLD_DOMAIN` explicitly excluded (it breaks AP init with 0xF in CONCURRENT_MODE).

### Host-side AP DHCP Server with Sticky Leases

- Replaced the Si91x firmware DHCP server with a host-side lwIP implementation, giving the AP stable addressing.
- **Sticky leases**: MAC→IP bindings are cached after a station disconnects, so the station regains its original address on reconnect; when the lease table is full the oldest entry is evicted by LRU, and active clients are never evicted.
- Lease table protected by a mutex (tcpip thread vs WiFi event context); robust option parsing (PAD handling, bounds checks), replies padded to the RFC 300-byte minimum.
- netif (dual stack): NWP firmware DHCP feature bit disabled, host dhcpserver started on AP up; registered/unregistered on station join/leave.
- **Old-firmware compatibility (< 2.16.5)**: a one-shot firmware-version check falls back to the firmware DHCP server when the old firmware lacks host DHCP and the `IP_ADDRESS_INFO` notify.

### HaLow (802.11ah) Support

- Full HaLow Wi-Fi integration: quick connect, runtime radio sync, reconnect IP fix.
- Extended RegDomain country code support (end-to-end); PKA crypto hardware offload; IP configuration persistence; SPI6 clock auto-adaptation, relaxed EU duty cycle.
- **mm6108 / mm8108 dual-chip support**: build-time `HALOW_CHIP` selects the target silicon (default `mm8108`): `make` (mm8108) or `make HALOW_CHIP=mm6108`. Chip structure, firmware blob, and BCF configuration are gated by macros; both firmware sets coexist, with the unselected one stripped by `--gc-sections`.
- **Hardware mutual exclusion with PoE / 4G**: PoE (W5500 INT=PD15) and HaLow (BUSY=PA15) share the EXTI15 interrupt line and are hardware-exclusive; HaLow also conflicts with 4G, while PoE and 4G can coexist. Software enforces the exclusion — switching to or starting a link automatically stops the conflicting ones, startup inits only one of PoE/HaLow (PoE wins unless HaLow is preferred), and deinit clears the shim IRQ handlers so edges don't leak into the other stack.
- **Web-configurable power save**: HaLow chip PS is exposed as a radio settings switch (**default off**), persisted to NVS, applied at boot, and covered by JSON export/import; every power-save setting pairs `mmwlan_set_dynamic_ps_timeout` (the timeout is a standalone firmware parameter — without pairing, enabling PS at runtime would appear not to work); the SDK side is back to official power-save defaults, with runtime behavior fully controlled by the app-layer config.
- Web UI HaLow network configuration (radio parameters / country code / power-save switch, zh/en).

### Web Recovery System

- New `web_recovery` module: automatically enters a built-in recovery page when the Web firmware partition is empty or corrupted.
- The recovery page is a self-contained HTML page compiled into the APP firmware (no external resource dependencies), providing Web firmware upload functionality.
- After a successful Web firmware upload, `web_recovery_reload_assets()` is called automatically to reload assets from Flash and exit recovery mode — **no device reboot required**.

### Web Firmware Version Management

- Firmware upgrade page overhaul:
  - Import firmware dialog supports APP / Web / AI Model / Device configuration files.
  - Advanced options menu provides dedicated FSBL upgrade, WiFi upgrade, and **bundle upgrade** entry points.
  - New dedicated WiFi firmware upgrade page (`/import-wifi`) and bundle upgrade page (`/import-bundle`).
  - Firmware info page displays all component versions: APP / Web / AI Model / FSBL / WakeCore / WiFi.
- **FSBL / WiFi expected version check**: set at compile time; Web UI auto-detects mismatches and offers guided upgrade.
- FSBL import & burn flow improvements, with reboot feedback once the burn completes.

### AI Partition Restructuring & STEdgeAI 4.x Runtime

- `FIRMWARE_DEFAULT_AI` renamed to `FIRMWARE_AI_2`, with `FIRMWARE_AI_1` retained for AI model A/B dual-slot switching; AI partition sizes increased from 5MB to 8MB.
- **Unified STEdgeAI 2.2 / 3.0 / 4.0 runtime selection at build time**: application code is shared; select the version via `STEDGEAI_VARIANT`. `stedgeai.mk` automatically picks the matching NPU runtime library, device, and extra sources. Firmware and model packages must use the same variant.
- **Generated `stedgeai_version.h`**: `MODEL_STEDGEAI_VERSION_SUPPORTED` is now a generated header instead of a `-D` compiler flag, so dependency tracking catches STEdgeAI variant changes — no `make clean` required when switching variants.

### AI & Models

- YOLOv8-Nano / YOLO11n-Nano human pose estimation (4 keypoints).
- Pointer meter reading: YOLOv8-pose 4 keypoints → percentage reading conversion.
- Instance Segmentation (ISEG): YOLOv8 model integration.
- BlazeFace face detection: 128×128 resolution.
- Configurable AI inference cadence.
- Continuous AI result telemetry: CBOR compact format and metadata-only mode.
- SPE result handling: `overlay_results` gating.

### Capture-Upload Pipeline

A new end-to-end capture-upload system with date-partitioned record storage (`/captures/{meta,data,index}/<date>/`) on Flash or SD card (auto / flash / sd / none selectable).
- **Four upload modes**:
  - **Instant** — snap and upload synchronously; on failure the record stays in `pending/` for automatic retry.
  - **Batch** — persist and flush when the pending count reaches a configurable threshold, or on the next wake tick.
  - **Scheduled** — flush at configured times of day.
  - **Local-only** — store locally and never upload.
- **Interval capture runs a config-anchored daily lattice**: capture nodes are `start + k × interval_sec` inside a **closed** `[start, end]` window (a node landing exactly on the end fires). The normal interval mode anchors the grid at a time-of-day anchor and covers the full day, flowing past midnight; the scheduled mode runs from `start_time` to `end_time` (an end earlier than the start wraps past midnight, a full day is any start `T` with end `T−1min`, and `end_time == start_time` is rejected). Wakes, upload flushes and reboots never re-base the grid, and sleep durations align exactly to the next node, so closed-window nights sleep through to the next day's start instead of waking every interval. Legacy configs that never stored an `end_time` are migrated once on the first boot to a full-day window (logged).
- **MQTT batch-publish pipeline + Webhook** delivery support; MQTT publish payloads over 1800 B are rejected outright, avoiding the chip-side CE_TX buffer overflow that corrupts the shared heap.
- **Retry with configurable max attempts**; failed records can be retried individually or all at once from the Web UI.
- **Storage policies (WRAP / STOP)** with automatic cleanup; the Flash record cap is user-configurable **16–256 records, default 32** (NVS `cu_fl_max`, surfaced through the web upload-config API; 0 / out-of-range falls back to the default) — the cap counts all states, and a lower default bounds the cold-boot full-tree scan latency and average power on fresh units. SD card has no count cap.
- **Power-aware wake scheduling**: capture and upload-flush share a single scheduler with alarm override; on wake only the configured upload netif is brought up (saves multi-second bring-up and battery); the sleep path waits for any in-progress upload to finish before cutting power.
- **Network fail-fast**: skips the full network stack entirely when a wake cycle won't upload anything.
- **Web management UI**: capture settings page (config + records tabs), batch select / delete / retry, time-range filter, newest/oldest sort, record image download (primary / inference), and an upload-network selector (default or a specific netif).
- **NVS-persisted settings** + REST API for upload configuration, queue status, record queries, deletion/retry, and batch operations.
- Storage-performance work to keep the capture/upload hot path fast: `lfs_fs_size` result cache, stat-before-mkdir, and a lightweight mount check.
- **SD hot-plug auto-switch (auto mode)**: the capture and status paths track SD insertion/removal in real time, so the storage target switches headless without any Web request; `storage_full` is now per-volume and reality-checked against live free space, so deleting files clears the stale storage-full banner.
- **`keep_sent_hours` keep-forever retention**: cap raised to **72000 (= keep forever)**, which is now the default — records are deleted only on storage-full or the record-count cap; `0` keeps its original meaning (delete on upload success).
- **Count cache + day-index compaction**: record counts share one RAM cache across count/status/flush-budget paths (invalidate-on-mutation, one sweep when cold); a day index with ≥64 raw entries and ≥4× dead weight is rewritten with only live entries on load (or removed when nothing is live), guarded by a dedicated idx mutex.
- **Large record-set correctness and records API pagination**: date enumeration now grows dynamically beyond 128 days; the per-day ID hash expands for manifests with more than 4096 unique records; state transitions replace metadata atomically and report failure if the manifest append fails, while malformed or mixed-format manifests are rejected rather than read as valid records; records pagination uses one-record lookahead. Consequently, `total` is exact on the last page but otherwise a lower bound of `offset + records.length + 1`, rather than an expensive full-tree count.
- **Batch needs-network is a pure threshold** (`pending+1 ≥ batch_count`): failed records never bring up the network on wake and are web-manual-retry only. `retry_enable`: off promotes the first failure straight to the terminal failed state; on with `retry_max_attempts = 0` retries indefinitely.

### Storage & File Management

- Web-based file management: browse, upload, and delete files on Flash and SD card.
- **The file browser is read-only inside the captures directory**: capture records under `/captures` are owned by the upload service — deleting or renaming them from the file browser corrupts the record/manifest tree. Upload / new-file / new-folder / batch-delete / format actions are hidden while browsing inside `/captures` (browse, preview and download stay available), the volume-root `captures` folder locks delete/rename too, and beyond the hidden controls the web UI's action handlers reject any remaining attempt with a toast (the device-side file APIs themselves are unchanged; manage records from the Capture Records page).
- **Unicode filenames on SD cards (FAT and exFAT)**: non-ASCII names (e.g. Chinese) are created through FileX's unicode API on FAT media, so entries carry a real UTF-16 long name readable on a PC; exFAT media bridge `char*` paths to on-disk UTF-16 (FileX patched: entry reads re-encode names to UTF-8, entry writes convert valid UTF-8 to UTF-16 and reject names too long to round-trip, directory search falls back to a UTF-16 compare). Rename no longer deletes the destination up front — an existing destination is parked under a backup name and restored if the swap fails; swapping the card makes the upload coordinator re-create the captures tree on the replacement.
- Recursive folder deletion (including non-empty folders); blocking overlay + progress during deletion.
- File operation registration decoupled from LFS mount for improved boot robustness.
- **Format Flash from the file browser**; record-count cap enforced.

### SD Card Speed Mode Tools & High-Speed Boot

- New speed query / set / benchmark interfaces and CLI commands `sdspeed`, `sdswitch`, `sdrwtest` for speed diagnostics and performance evaluation.
- **50 MHz high-speed boot by default**: `HAL_SD_Init` no longer leaves UHS cards (without a 1.8 V transceiver) running at the out-of-spec Default Speed (~100 MHz at CLKDIV=0); the 50 MHz cap + CMD6 HS is enforced on every (re)insertion.
- `sdswitch` provides an overclock test mode (~100 MHz); the card is first switched back to Default Speed because HS+100 MHz is unstable on UHS cards.
- `MEM_FAST` internal memory pool enlarged from 184 KB → **512 KB**.

### Oversized Image Preview (Web)

- Image size is validated against the backend preview limit (`MAX_PREVIEW_SIZE_IMAGE = 2MB`) before serving the preview — the backend returns a `too_large` JSON for over-limit images, which previously rendered as a broken image.
- File manager shows a hint in place of the preview button; capture records replace the main preview button with a hint and apply `too_large` detection to inference-result previews.

### Fill Light

- **Work-time fill light mode** (`fill_light_while_streaming`, NVS / JSON / API / web, default off): when enabled, the light follows the flash-light configuration for the whole runtime and runtime captures stop flashing it; wake captures keep the flash behavior. Driven by a dedicated 4 KB task (an osTimer callback would run on the 1 KB timer thread).
- The manual light-control service API and the `/device/light/control` endpoint were removed along with the web test switch.

### Crash & Camera Diagnostics

- **HardFault register dump**: on a hard fault the device prints CFSR/BFAR/MMFAR/HFSR plus PC/LR/SP to help triage crashes.
- **HardFault dump enhancements**: HardFault/MemManage now use naked-handler wrappers passing the real EXC_RETURN + entry SP (every after-the-fact C-level way of getting them was disproven); a shared `fault_dump_frames` dumps both the main frame and the other stack's `[alt]` frame, including R0–R3 registers and an OCTOSPI-region return-address BT walk so addr2line can resolve frames above the stacked PC/LR.
- **MPU MSP stack-overflow sentinel**: new MPU region 1 = a 256 B `PRIV_RO` guard at the stack bottom (`&_sstack`). An MSP overflow into the newlib heap below now trips MemManage instead of silently corrupting heap metadata; `MemManage_Handler` decodes CFSR/MMFAR and tags the guard-band trips.
- **`camdiag` CLI command**: reports camera pipe / buffer / frame state and DCMIPP error flags (pipe overflow, AXI transfer error) for camera debugging.
- **Full RCC reset-cause dump at boot**: the whole RSR (software / pin / BOR / POR / IWDG / WWDG / low-power / lockup) is printed before clearing — a silent spontaneous reset now identifies its source from the boot log alone (NRST also pulses internally on software and power-on resets, so PINRST is read in combination).
- **`wifi_ap_clients` debug command**: prints the firmware-associated stations and the DHCP lease table side by side.

### Hardware Support

- Auto-adaptive dual-chip NOR Flash driver: auto-detects MX66 (1Gb) and GD55 (1Gb/512Mb).
- 64MB and 128MB Flash capacity support (`BOARD_FLASH_SIZE`).
- ISP grayscale mode with live IQ hot-swap on mode/grayscale change (no reboot).

### Networking

- 4G manual PLMN operator selection.
- **Connected-station details for WiFi**: new `GET /api/v1/system/network/wifi/info` (mirroring the PoE / cellular info endpoints) returning live link info (SSID / BSSID / RSSI / channel / security) plus the full IP configuration (mode, address, netmask, gateway, DNS, MAC) read from the lwIP netif and resolver; the web connected-network menu gains a matching details dialog.
- **eth_wan default interface selection**: default-uplink selection when no cellular module is present.
- Netif DHCP / connect timeouts shortened (WiFi STA & PoE DHCP 30 s → 15 s; 4G connect 30 s → 20 s) for faster startup and failover.

---

## Bug Fixes (Details)

### Network / PoE

- **Startup connection decision moved to a dedicated thread**: the startup-timeout timer callback ran on the tiny ThreadX timer thread, where any printf/log overflowed the stack and caused a HardFault. The decision now runs on a dedicated large-stack thread; the timer only sets an event flag.
- **AP startup no longer gated on cellular**: dropped the cellular-active ap-skip branch so AP bring-up is not blocked by 4G state.
- **DNS servers reset when an uplink goes down**: the lwIP DHCP client (WiFi / PoE / HaLow) and the PoE static config write network-local DNS servers into the global resolver and never cleared them, so switching networks kept the previous network's DNS active — unreachable from the new one. Uplink teardown now restores the boot defaults; every uplink re-establishes DNS on connect (DHCP re-learns it, PoE re-applies its NVS config).
- **iperf hangs**: TCP blocking sends capped by `so_sndtimeo` so a vanished peer cannot wedge the task past `-t`/`-x`; ETIMEDOUT treated as retryable; the `-t` deadline enforced inside the partial-write loop; `-x` stop idempotent from any non-idle state.
- **Modem init & power management**: modem init now forces a full power cycle (off → delay → on) instead of relying on leftover module state; CME errors are logged and the QNWINFO timeout is raised to 1 s; the power manager tolerates a release when ref_count is already 0.

### Wireless (WiFi)

- **Hotspot no longer supports a password** (always open): a WiFi-chip firmware limitation — with a password set on the AP, the STA can no longer connect to networks. The stored password and the API field are kept (round-trip unchanged) but not applied; the web UI hides the hotspot password field. A password saved on older firmware stops taking effect after the upgrade.
- **Hotspot idle sleep reduced to fixed choices** (never / 10 / 20 / 30 min): the web setter rejects other values; a config import carrying an out-of-set value keeps the device's own setting.
- **AP boot-state race**: `device_service_start` previously set a blind ap-off that raced with the async ap-on on the netif thread. It now sets the startup indicator based on the actual AP state and no longer overrides an already-up AP.
- The MQTT client-id sentinel `AICAM-000000` is rewritten with a MAC suffix in `mqtt_build_topics` (the old timestamp scheme was unreliable).
- Per-interface netif flags: AP no longer sets `NETIF_FLAG_IGMP`.

### File Management / Storage

- **XSPI erase busy-poll starvation**: a 4K erase spun 45–200 ms with no yield; under realtime-priority web API callers this starved the watchdog task past the 16 s IWDG window — silent resets. The ready-poll now yields after 64 tight polls (`osDelay(1)` once the kernel runs, `HAL_Delay` before start; FSBL stays bare-metal).
- **Web log view followed a hot-plugged SD card**: the log read endpoints (`/api/v1/system/logs`, `/logs/export`) opened `aicam.log` through the generic file layer, whose "current" backend is switched to the SD card on insertion (and back to Flash on removal) — while the log writer is permanently bound to the internal-flash LittleFS. With a card inserted, the web log page looked for the log on the SD card, found nothing and returned an empty "No log files" payload; removing the card made it work again. The log reads are now bound to the internal-flash LittleFS, same as the writer.

### Configuration Import / Export

- **Config import merges onto the device's current config**: import previously rebuilt the whole config from factory defaults and then NVS-overwrote everything — any key missing from the file (including ones the user deliberately deleted from an exported file) reverted to defaults, and device-bound info (MAC / serial number / hardware version — all of `device_info`) was overwritten by the source device. Import now overlays only the keys the JSON actually contains; everything else keeps the device's own value, and `device_info` is export-only documentation, never imported.
- **Export/import round-trips the recently added settings** (previously silently dropped): the timer-capture daily lattice (interval mode / start / end / anchor times), RTMP & RTSP stream settings, webhook, the capture-upload policy (mode / storage / retry / batch / schedule / retention / Flash record cap / upload network), and the work frequency (`sys_clk_profile`, applied through the same FSBL path as the dedicated setter, effective on next boot; an absent key or 0 — an unmodified source device — keeps the current profile). Imported capture-upload values pass through the same normalization as the web API.
- **Absent-key parse writes fixed**: narrowed MQTT fields inherited the stale value of the previously parsed key — or stack garbage (light mode, timer capture mode, IO trigger types) — whenever a key was absent; MQTT certificate files were rewritten with zeros when the JSON omitted the cert payload. Absent keys now keep the existing value, and certs are rewritten only when the JSON carries them.
- **Runtime state no longer imported**: light `connected`, power-mode `last_activity_time` / `mode_switch_count`, and the known-networks scan cache (`rssi` / `channel` / `connected` / `is_known` / `last_connected_time`) are snapshots of the source device — still exported for documentation, but skipped on import so a foreign runtime stamp cannot skew the local power manager or auto-join preference. The power-mode `current_mode` does round-trip (the switch API persists it and boot runs in it): the activity stamp is re-stamped locally on import and out-of-domain mode values are ignored. Only network credentials (ssid / bssid / password / security) are imported.
- **Hand-edited array counts clamped**: deleting entries from an exported array while leaving its companion count behind no longer resurrects the device's old entries past the file's list (time nodes, known networks, upload schedule minutes); a `time_node_count` above the array bound is clamped instead of over-read.
- **Config schema version bumped to 2**: the import version gate only rejects files newer than the firmware, so v1 exports (and hand-edited files) still import; importing an older file no longer downgrades the persisted version marker (pinned to this firmware's schema after validation), and a persisted v1 marker is forward-migrated to 2 on NVS load so exports carry the current schema version. Files exported by this firmware are declined by older firmware (v2.1.0-era, gate `> 1`) — protective, since that import path would have rebuilt the config from defaults.

### Image / Preview

- **JPEG buffer aliasing**: fixed buffer aliasing in capture and JPEG encoder.
- **JPEG tail fix**: `jpegc` trims DMA-padded `0x00` after EOI and re-appends EOI when the final `D9` byte is truncated. Fixes mosaic at the bottom of the browser preview and incomplete rendering.

### Camera / Encoder / RTMP

- **Torn frames from a still-writing buffer**: when no buffer was free, the frame event re-pointed the DCMIPP at a buffer it had just marked ready, and the newest-frame-id selection then fed the encoder a raster the DCMIPP was concurrently DMA-writing. The recycled buffer is demoted to `BUFFER_PROCESSING` first so it cannot be selected while rewritten — both the main pipe and the ancillary pipe (which feeds inference and snapshots) are fixed.
- **Pipe-stop error paths re-armed**: a failed `HAL_DCMIPP_CSI_PIPE_Stop` returned with the frame/vsync interrupts off, buffers unreset and the state stuck at `PIPE_START`, so no frame event ever ran again and `camera_start` short-circuited on the unchanged state. Interrupts are restored before returning the error, and since the HAL stop clears CPTREQ, the capture request is re-asserted when the pipe is still enabled so a caller's retry actually resumes capture. A pipe buffer count below two is now rejected.
- **Buffer-owner tracking repaired**: `buffer_reset` indexed the owner list with the outer loop counter (only the diagonal entry cleared, writing out of bounds past `CAMERA_BUF_MAX_OWNERS`); owners joining an already-in-use buffer were never recorded, so the duplicate scan compared against stale entries — one thread could double-acquire or be falsely rejected; `camera_deinit` released the power handle twice.
- **Encoder cold-start all-INTRA latch**: `H264EncStrmStart` leaves a status under which `H264EncStrmEncode` overrides the requested coding type to INTRA; if the first frame after init fails its HW timeout, every later frame is forced to a full INTRA and re-initializing returns to the same state — rebooting did not clear it. Escape: a run of consecutive `H264ENC_OUTPUT_BUFFER_OVERFLOW` failures steps the rate controller's QP floor up (qpMin/qpHdr/qpMax raised alongside, clamped at the encoder maximum; only an overflow is a size problem — other error codes neither advance nor reset the run, so a transient fault cannot pin a recovered stream at a raised floor), and the raised floor is held for the rest of the session instead of dropping back into the configuration that just failed.
- **RTMP last-NAL truncation**: the start-code scan bound left three bytes unexamined, and the final NAL of a buffer has no next start code — every pushed frame lost the last three bytes of its slice (always the coded slice), with both conversion passes agreeing so the packet looked well-formed on the wire. Measured: 0.35–0.46% of frames with macroblock errors concentrated in the last row; after the fix 0/17,197 corrupted final bytes and 0 decoder-error lines vs 4,027 on the concurrent unpatched control.
- **Quick snapshot pipe2 frame loss**: the just-published pipe2 frame is no longer dropped into the boot skip-frames window (third pipe2 buffer), and the NVS `capture_storage_ai` toggle is honored instead of being overridden by card-detect.

### Streaming (RTMP/RTSP)

- **RTMP push auto-start at boot**: `rtmp_enable` is now read — the service hands off to a task that waits for the station link and starts the push (previously the flag was persisted but never acted on; the sibling RTSP service already auto-started). The wait is sliced 30 s at a time within a 15-minute budget and re-checks the running flags, so a slow-associating camera still gets its push (observed: one boot without STA for 10+ minutes); the task stands down if the API started a stream first, retries failed attempts, and is retired by `rtmp_service_stop` so it cannot resurrect a stream. Its control block is reaped after exit (one-per-cycle leak fixed).
- **Web enable switches with autostart notes**: the RTMP tab gains an enable switch gating url/key editing and the connect button (connect no longer implicitly enables the service; toggling off stops a live push); both RTMP and RTSP pages state the autostart scope — starts on power-on including long-press config mode, not on capture-only wakes, off by default. The remote-control wake-source hint now states it needs the built-in WiFi configured and online.
- **Config persistence hardened**: the config API accepts both `enable` / `enabled` spellings (the web UI posted the RTSP-style name, silently dropping the boot auto-start flag before it reached NVS); the streaming guard rejects only url/stream-key changes while streaming, so the enable toggle stays usable mid-stream; RAM copies of the stream config are kept in sync so the pre-sleep config save no longer reverts RTMP/RTSP settings to boot-time values; the boot auto-start task re-reads `rtmp_enable` before each attempt so switching the service off during the wait is honored; URL joining no longer doubles the path separator (`rtmp://host/live//key`).

### Web Frontend

- **Black screen for late-joining preview clients fixed**: the encoder emits SPS/PPS only once per session, so clients connecting afterwards never received the parameter sets — jmuxer's `readyToDecode` never set, frames silently dropped, and each frontend watchdog `hardRestart` built a fresh jmuxer → permanently black with an infinite loading loop. Each client now tracks `sps_synced`: late joiners skip delta frames and receive a composed `[SPS][PPS][IDR]` frame (annexB start codes re-inserted from the hub cache) at the next keyframe; join latency is at most one GOP (~1 s).
- **Connection & stream-stability overhaul**:
  - **One-request connections**: every response path sends `Connection: close` + drain so the browser never reuses a socket — fixes the `err_network` popups on the phone WiFi link during rapid tab switches.
  - **Static-asset etag / 304 caching**: CRC32-based etag + `if-none-match` → 304, shrinking the per-mount worker/importScripts re-fetch from ~273 KB to nothing.
  - **Video frames copied into a FIFO before the async web-task send**: fixes smearing from the send buffer being reused mid-flight.
  - **Per-client WS send-buffer cap**: dead connections no longer accumulate memory without bound.
  - **iOS MSE hardening + stream diagnostics**: sourcebuffer detach guards; a net-failure viewer + toast markers behind the `NET_DIAG` flag.
  - Silent `err_network` GET retry (1 s / 8 s backoff) to cross ~10 s radio holes.
- **WiFi scan dialog waits for scan completion**: the STA endpoint now exposes `scan_in_progress`, which the frontend polls until the background scan actually finishes — previously the reload mask closed on the first STA response and showed stale/empty results.
- WiFi reconnect changed from retry to **STA polling**.
- Stabilized MSE live preview, recovered stuck streams; improved iOS playback frame-following, added media tests; fixed black preview after a model upload.
- Fixed garbled error message display.
- Mobile layout fixes: select rows / the RTSP URL no longer stretch the page width; the RTMP and webhook URL rows stack the label above the input on phones, so the dim example-URL hints no longer get cut off; the device-tool skeleton aligns with the real layout; a stale `sourceopen` after a watchdog restart is ignored.
- **Number inputs commit on blur**: a new NumberField component holds the typed draft and only parses, clamps and commits on blur or enter (escape reverts) — intermediate values are typeable, so a leading "2" in a min-16 field no longer snaps to 16 mid-edit. Migrated inputs: fast-capture skip frames, JPEG quality, light brightness (which now fires one network call per committed change and snaps back to the persisted config on failure).
- **h264player cleanup**: the stats interval leaked and orphaned players were left behind on page leave.

### Video Pipeline

- **`video_pipeline_stop()` deadlock**: stop waited unbounded for node threads; a node whose `process()` blocked indefinitely (capture/encoder/AI) wedged the HTTP task holding `pipeline->mutex` forever. Now bounded by a 3 s deadline, after which stragglers are force-terminated via `osThreadTerminate()`.

### Other

- **Fill light PWM brightness**: fixed brightness scaling.
- **PIR register zero values**: the "default if not configured" guards treated 0 as an unset sentinel, but 0 is a legal web-selectable value (ignore_time_s 0 = 0.5 s window, pulse_count 0 = 1 pulse, web stores value−1) — the override silently rewrote those levels to 4.0 s / 2 pulses and made GET responses diverge from what was actually written to U0. Guards removed (the NVS load path already guarantees defaults for never-configured devices).
- **Web error toasts localized & detailed**: business error codes resolve to a localized headline with the backend's specific detail appended; the full error-code catalogue ships in both languages, and unknown codes fall back to the raw code instead of leaking a lookup key.

---

## Improvements

- APP PSRAM boot is now the only mode (removed `BOOT_IN_PSRAM` conditional compilation); APP available space increased to 4096K.
- Flash SWAP region relocated from Flash to the start of the PSRAM region.
- CRC32 calculation switched from hardware CRC to software implementation, avoiding the hardware CRC peripheral endianness issue.
- **XSPI NOR flash read power-save (~5 mA)**: `storage_power_save()` toggles XSPI back into memory-mapped mode after each read, and a new `storage_lock_ext/unlock_ext` runs the same toggle on unlock. Applied across the storage, Web-asset, AI-model, and WiFi-firmware read paths so flash returns to its low-power state between accesses.
- Web firmware auto-reloads after OTA upload (no reboot needed), providing a smoother upgrade experience.
- APP version moved to the **4.3.1 release line** (STEdgeAI 4.x generation; major version overridden by `STEDGEAI_BIT` in `stedgeai.mk`). Web → **1.5.0.8**.
- RTC scheduler task stack enlarged 8K → 32K to cover the deep call frames of the HaLow connect + upload path.
- **DHCP address acquisition 6–8 s faster**: lwIP 2.2 renamed `DHCP_DOES_ARP_CHECK` to `LWIP_DHCP_DOES_ACD_CHECK`, so the stale option name in lwipopts.h was silently ignored and RFC 5227 ACD probing stayed on — the post-ACK probe/announce sequence delayed `dhcp_bind()` by 6–8 s on every acquire while the DHCP exchange itself completes in ~130 ms. Disabled (the address comes from the router's managed pool and a missed conflict self-corrects via ARP at first use): link DOWN→UP after association now 33–125 ms.
- **AI pipe2 frame ring deepened to 3 buffers** between DCMIPP capture and NN consumption, aligning with the pipe1 depth and the driver default `NN_BUFFER_NB=3`.
- **Model batch build script** (`Script/build_all_models.sh`): compiles every buildable model in `Model/weights` and wraps each into an OTA model package stamped with the same model version as `make pkg-model`; supports `--list` / `--dry-run` / explicit selection, skips config-only or unregistered-postprocess models, logs per model into `Model/build`.
- Bilingual VitePress docs site (English + `/zh/`) deployed via GitHub Pages, with a generated Web-API endpoint reference (176 endpoints / 15 modules) and a PR staleness check; v4.3.1 HTTP API reference published in English and Chinese (`Docs/NE302_v4.3.1_HTTP_API*.md`).
- **Crypto cleanup**: removed unused si91x PSA crypto components; tidied mbedtls PKA port.
- `communication_type` reports the live active link, refreshed on every cached_info get.

---

## Known Issues

- WiFi firmware OTA upgrade push stage takes ~1–3 minutes. Do not power off during this process.
- Bundle burns do not use AB slots (forced direct burn). Do not close the browser page or power off during a bundle burn.
- Upgrading from v2.1.0 requires updating **in sequence**: APP → Web Recovery → Web → FSBL → WiFi → Model. See the [OTA Update Guide](./NE302_v4.3.1_OTA_Update_Guide.md).

---

## Upgrade Notes

1. **Upgrading from v2.1.0**: the Flash partition table was redesigned — a **new independent Web partition** was added and the WiFi FW / AI partitions moved. Old Web assets become inaccessible after the APP upgrade, so the device enters Web Recovery and the upgrade **must follow the sequence** in the **[OTA Update Guide](./NE302_v4.3.1_OTA_Update_Guide.md)**: APP → Web Recovery → Web → FSBL → WiFi → Model. Skipping or reordering steps leaves the Web interface inaccessible. Once on this release, future full-device upgrades can use the one-click bundle.
2. **WiFi firmware must be upgraded** to `SiWG917-B.2.16.5.1.0.8` (encoded `2.16.5.108`). The device compares the Flash-stored version against the chip's running version and guides the upgrade in the Web UI on mismatch.
3. **STEdgeAI moved to the 4.x generation**: APP major version = 4, so the model package prefix must be 4.x. A prefix mismatch triggers a version-check warning.
4. **FSBL must be upgraded to 1.0.3.1** (dual-chip NOR Flash auto-detection support; the APP carries a compile-time expected-version check).
5. **Firmware package model gate**: OTA headers carry the device model; cross-model packages (e.g., another product line's package) are rejected by the device. Unstamped legacy packages still work.
6. **Internal Flash is reformatted on the first boot after upgrading from v2.1.0** because the LittleFS partition moved. Ordinary v2.1.0 snapshots were not stored on internal Flash, but **MQTT TLS CA, client-certificate, and private-key files are stored in LittleFS and will be lost**. If MQTTS is enabled, preserve the original certificate/key files **before Step 1** and upload them again after the upgrade. Configuration, WiFi credentials and other NVS data, and all SD-card data, are preserved. The 4.x model package upload is mandatory for v2.1.0 upgraders (the AI partitions moved).

---

## Related Links

- [NE302 v4.3.1 OTA Update Guide](./NE302_v4.3.1_OTA_Update_Guide.md)
- OTA bundle design document (`Script/docs/NE302_OTA_Bundle_Design_EN.md`)
