camthink-ai/ne302/Hardware/NE302_Schematic_IFBoard_20260716.pdf

D | D
C | C
B | B
A | A
Type-C | TF-CARD
IR-CUT | R&H%+T

# STM32N6 Debug

# STM32U0 Debug B

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
Title

Size A3 | Project Name ACF12-08-V1.1 | Rev
Date: Tuesday, June 30, 2026 Tuesday, June 30, 2026 Tuesday, June 30, 2026 | Sheet 1 1 1 of 5 5 5

## https://www.camthink.ai

# Diagram

Title

## https://www.camthink.ai

# Diagram

Title

## https://www.camthink.ai

# Diagram

D | D
C | C
B | B
A | A

# Revision

REV. CODE | DATE | Description
V1_0 | 2026/04/02 | New Design
V1_1 | 2026/06/30 | 1. Remove Gyro circuit 2. Add IR-CUT circuit 3. Add Choke for USB-Signal

# Revision History

Title

## https://www.camthink.ai

# Revision

Tuesday, June 30, 2026 | 2 | 5

Title

## https://www.camthink.ai

# Revision

Tuesday, June 30, 2026 | 2 | 5

Title

## https://www.camthink.ai

# Revision

Tuesday, June 30, 2026 | 2 | 5

D | D

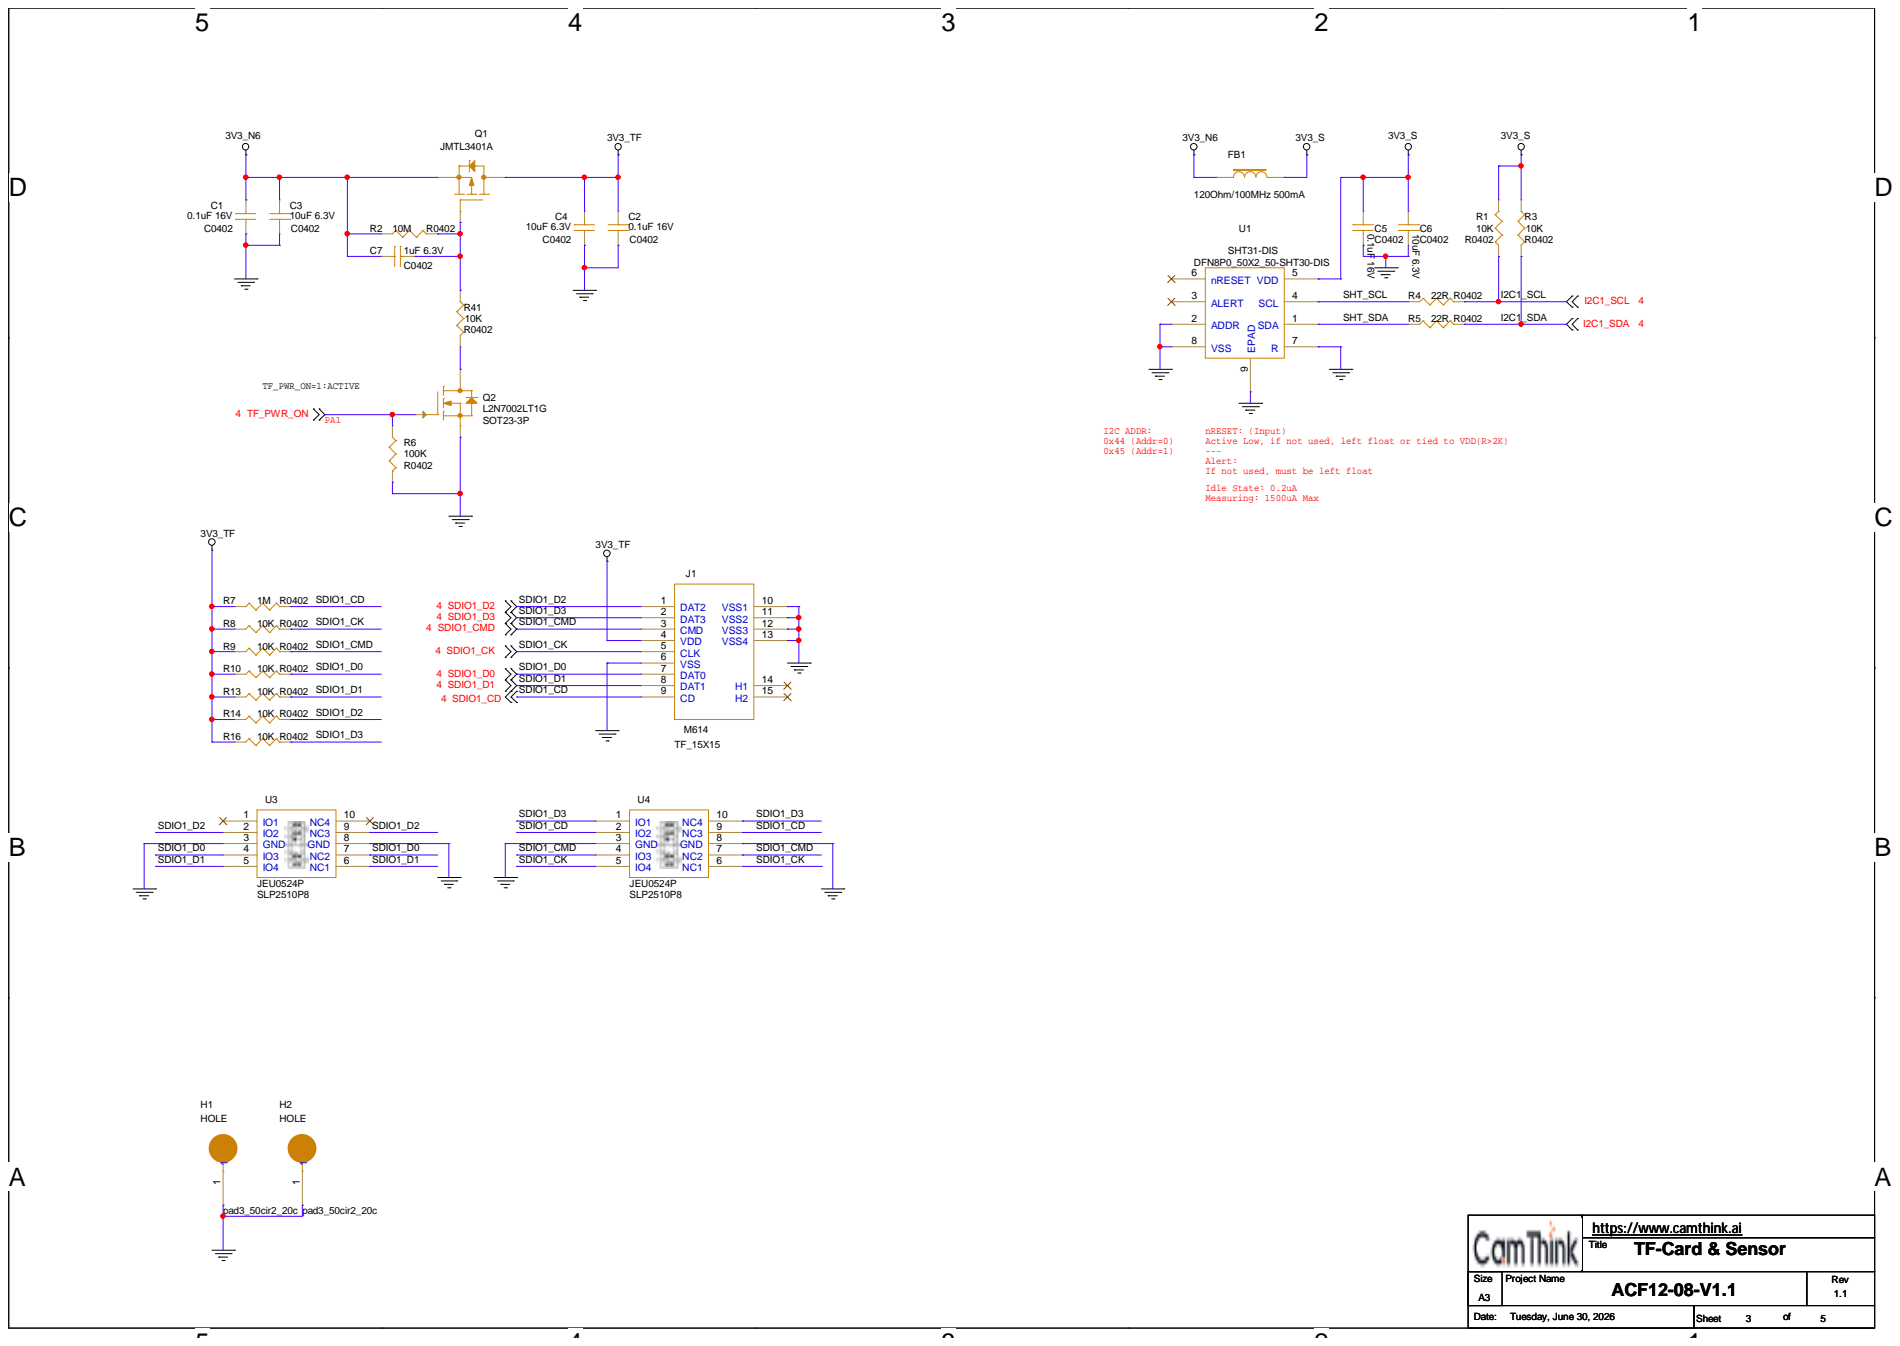
[picture p13: page 3]

nRESET: (Input)
Active Low, if not used, left float or tied to VDD(R>2K)
Alert:
If not used, must be left float
Idle State: 0.2uA
Measuring: 1500uA Max

https://www.camthink.ai
Title
TF-Card & Sensor

D | D

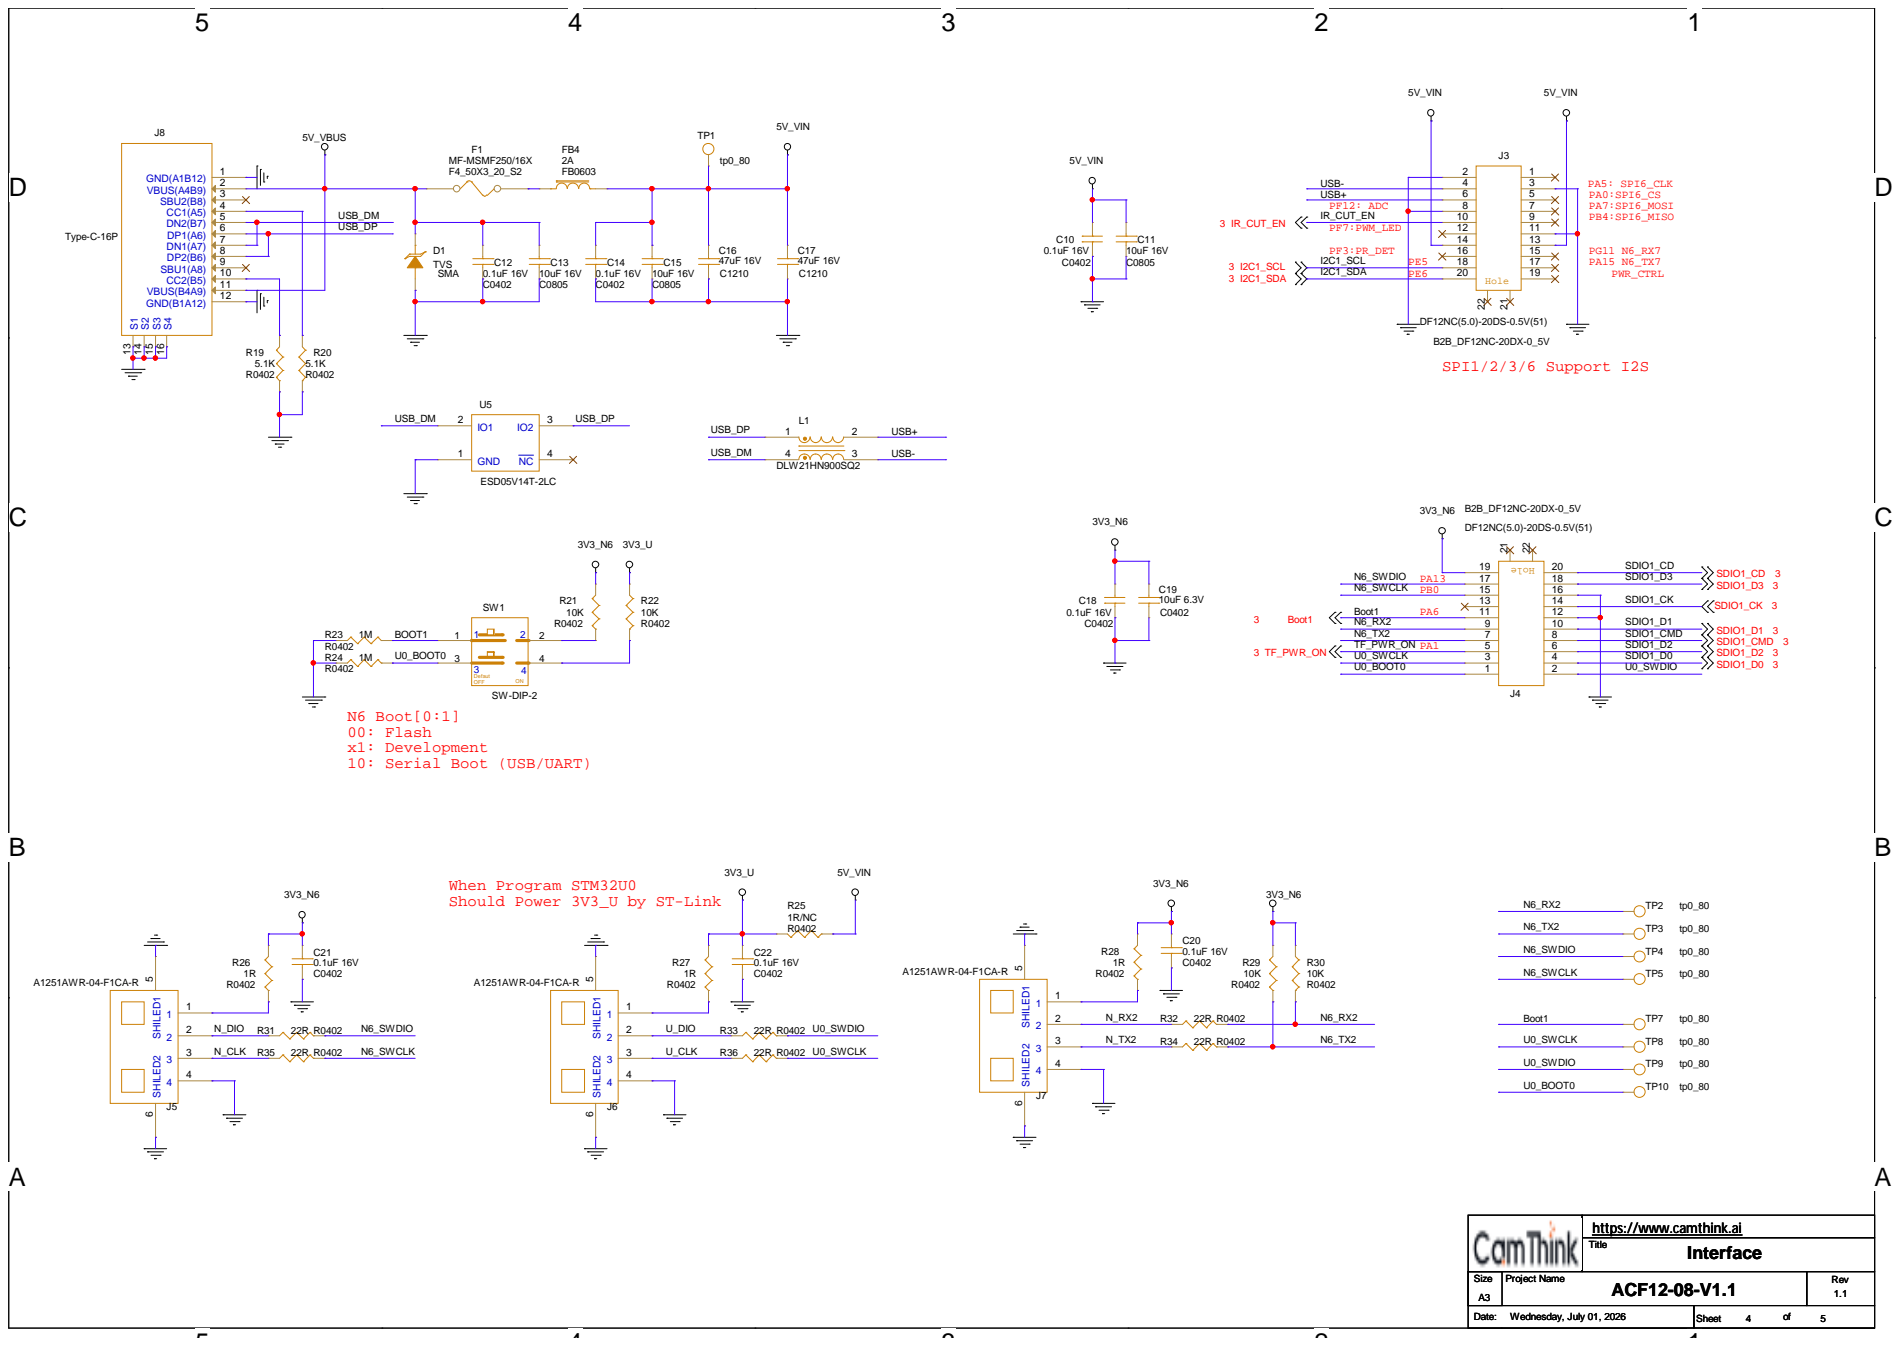
[picture p14: page 4]

When Program STM32U0
Should Power 3V3_U by ST-Link

https://www.camthink.ai
Title

# IR-CUT Driver

5V_VIN | 5V_IR

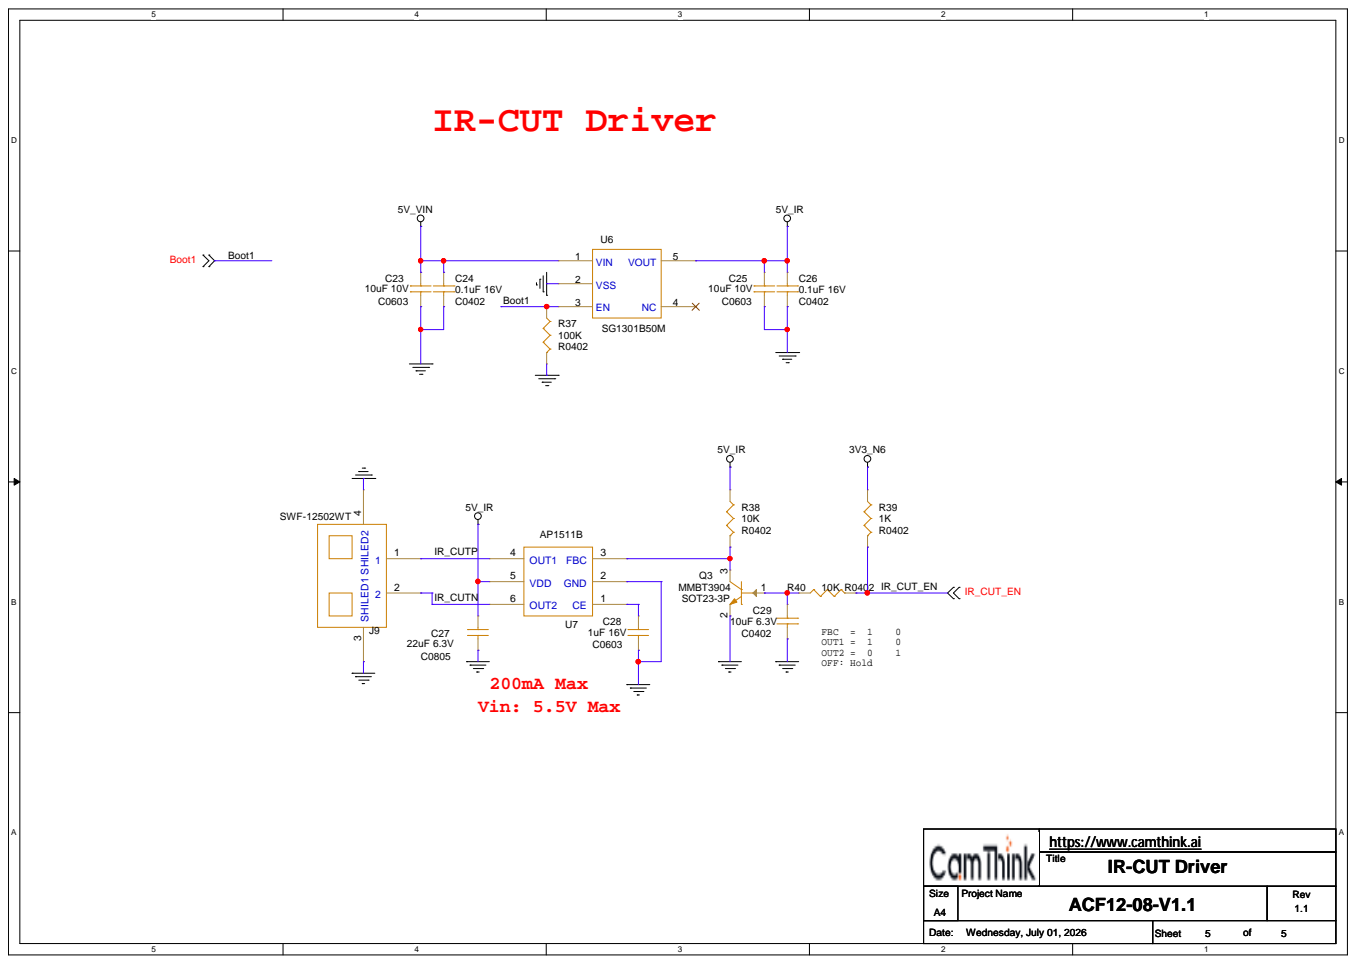
[picture p15: page 5]

https://www.camthink.ai
Title

IR-CUT Driver
ACF12-08-V1.1
