camthink-ai/ne302/Hardware/NE302_Schematic_V1.1_Open_20260716.pdf

D | D
C | C
B | B
A | A
| Tino DESIGNED

# REVISER

REV | V1_1

# MAIN PAGE

# 05. MCU-N6

# 03. BLOCK DIAGRAM

# INDEX

# 06. NOR-FLASH&PSRAM

# 02. CHANGE LIST

# 01. MAIN PAGE

# 04. POWER TREE

# 07. WIFI SIWN917 08. STM32U0 09. MISC 10. POWER 11. OS04C10

## Title

Size Project Name | Rev
Date: | Sheet | of

# https://www.camthink.ai

V1.1

# MainPage

A3

Thursday, July 16, 2026 | 1 | 11

# ACM12-03-V1.1

## Title

# https://www.camthink.ai

# MainPage

Thursday, July 16, 2026 | 1 | 11

## Title

# https://www.camthink.ai

# MainPage

Thursday, July 16, 2026 | 1 | 11

D | D
C | C
B | B
A | A

# CHANGE LIST

REV. CODE | DATE | Description
V1_0 | 2026/03/25 | New Design
| | Ref: U7 change to K2 C119: 0402 change to 0201 0.1uF/6.3V C114: Del USB: Change to USB1
| 2026-06-26 | 1. Add soft-startup res: R88/R89/R90/R92 10K 0402 5% 2. Add R91 100K for PWM_LED (Pull down) 3. OS04C10 CLK source change to Y6: remove R76 0R, add R86 4. Optical Diode:Set to 200Lux Max R52-->12.7K 1%, R55-->15K 1% 5. J3 Pin7 change to PB0 from Boot0

# Revision History

## Title

# https://www.camthink.ai

# ChangeList

Monday, June 29, 2026 | 2 | 11

## Title

# https://www.camthink.ai

# ChangeList

Monday, June 29, 2026 | 2 | 11

## Title

# https://www.camthink.ai

# ChangeList

Monday, June 29, 2026 | 2 | 11

D | D

# BLOCK DIAGRAM

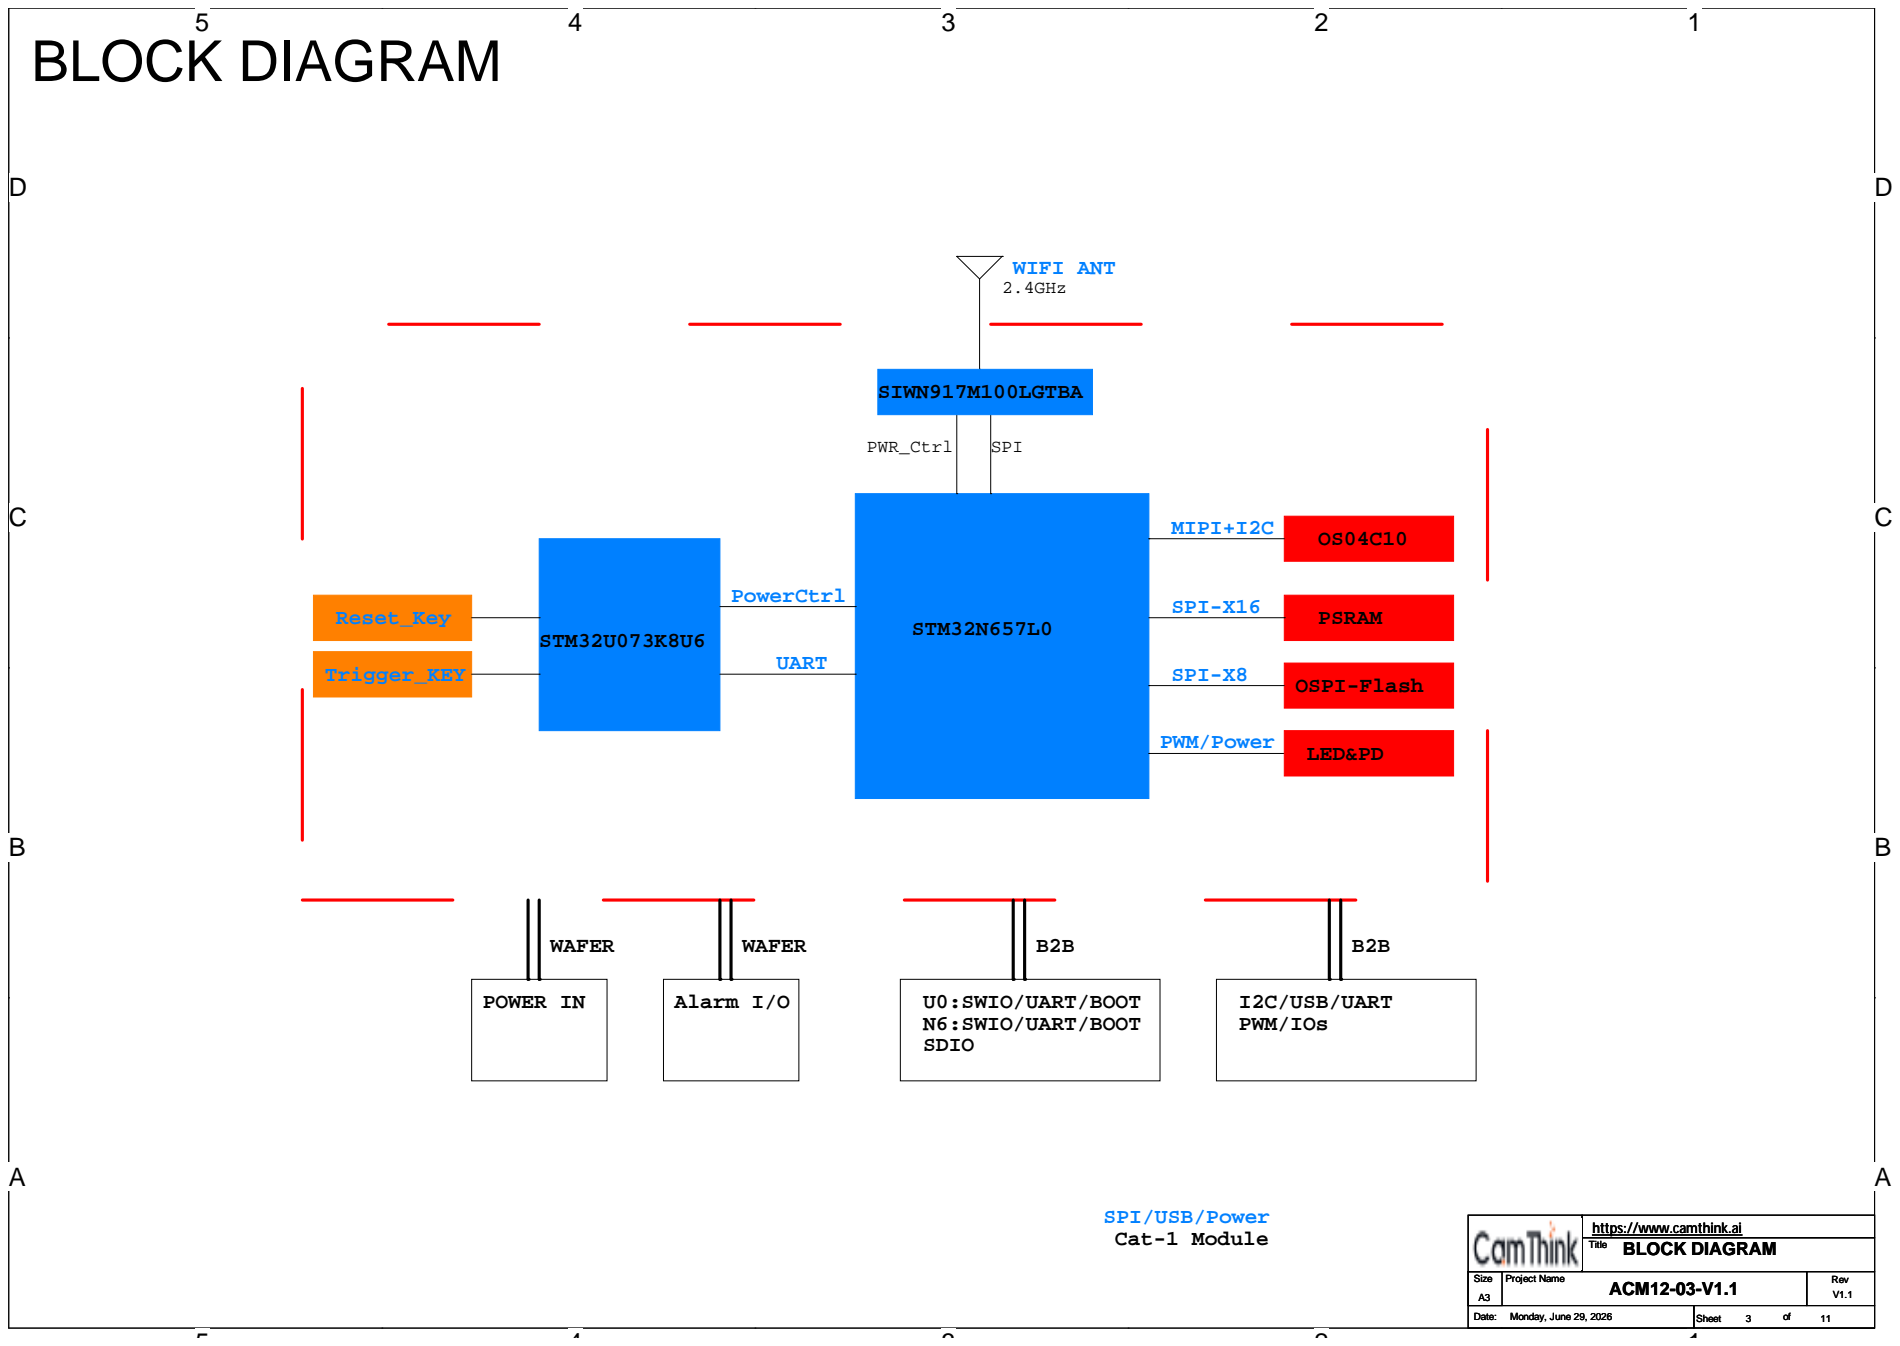
[picture p16: page 3]
PWR_Ctrl; SIWN917M100LGTBA; SPI; WIFI ANT 2.4GHz; PSRAM SPI-X16; SPI-X8; OSPI-Flash; MIPI+I2C; STM32U073K8U6; STM32N657L0; UART Trigger_KEY; Reset_Key; PowerCtrl; PWM/Power; LED&PD; I2C/USB/UART PWM/IOs; Alarm I/O; WAFER; POWER IN; Monday, June 29, 2026

U0:SWIO/UART/BOOT
N6:SWIO/UART/BOOT
SDIO

SPI/USB/Power
Cat-1 Module

https://www.camthink.ai
Title
BLOCK DIAGRAM

# POWER TREE

# MP1462GD-Z

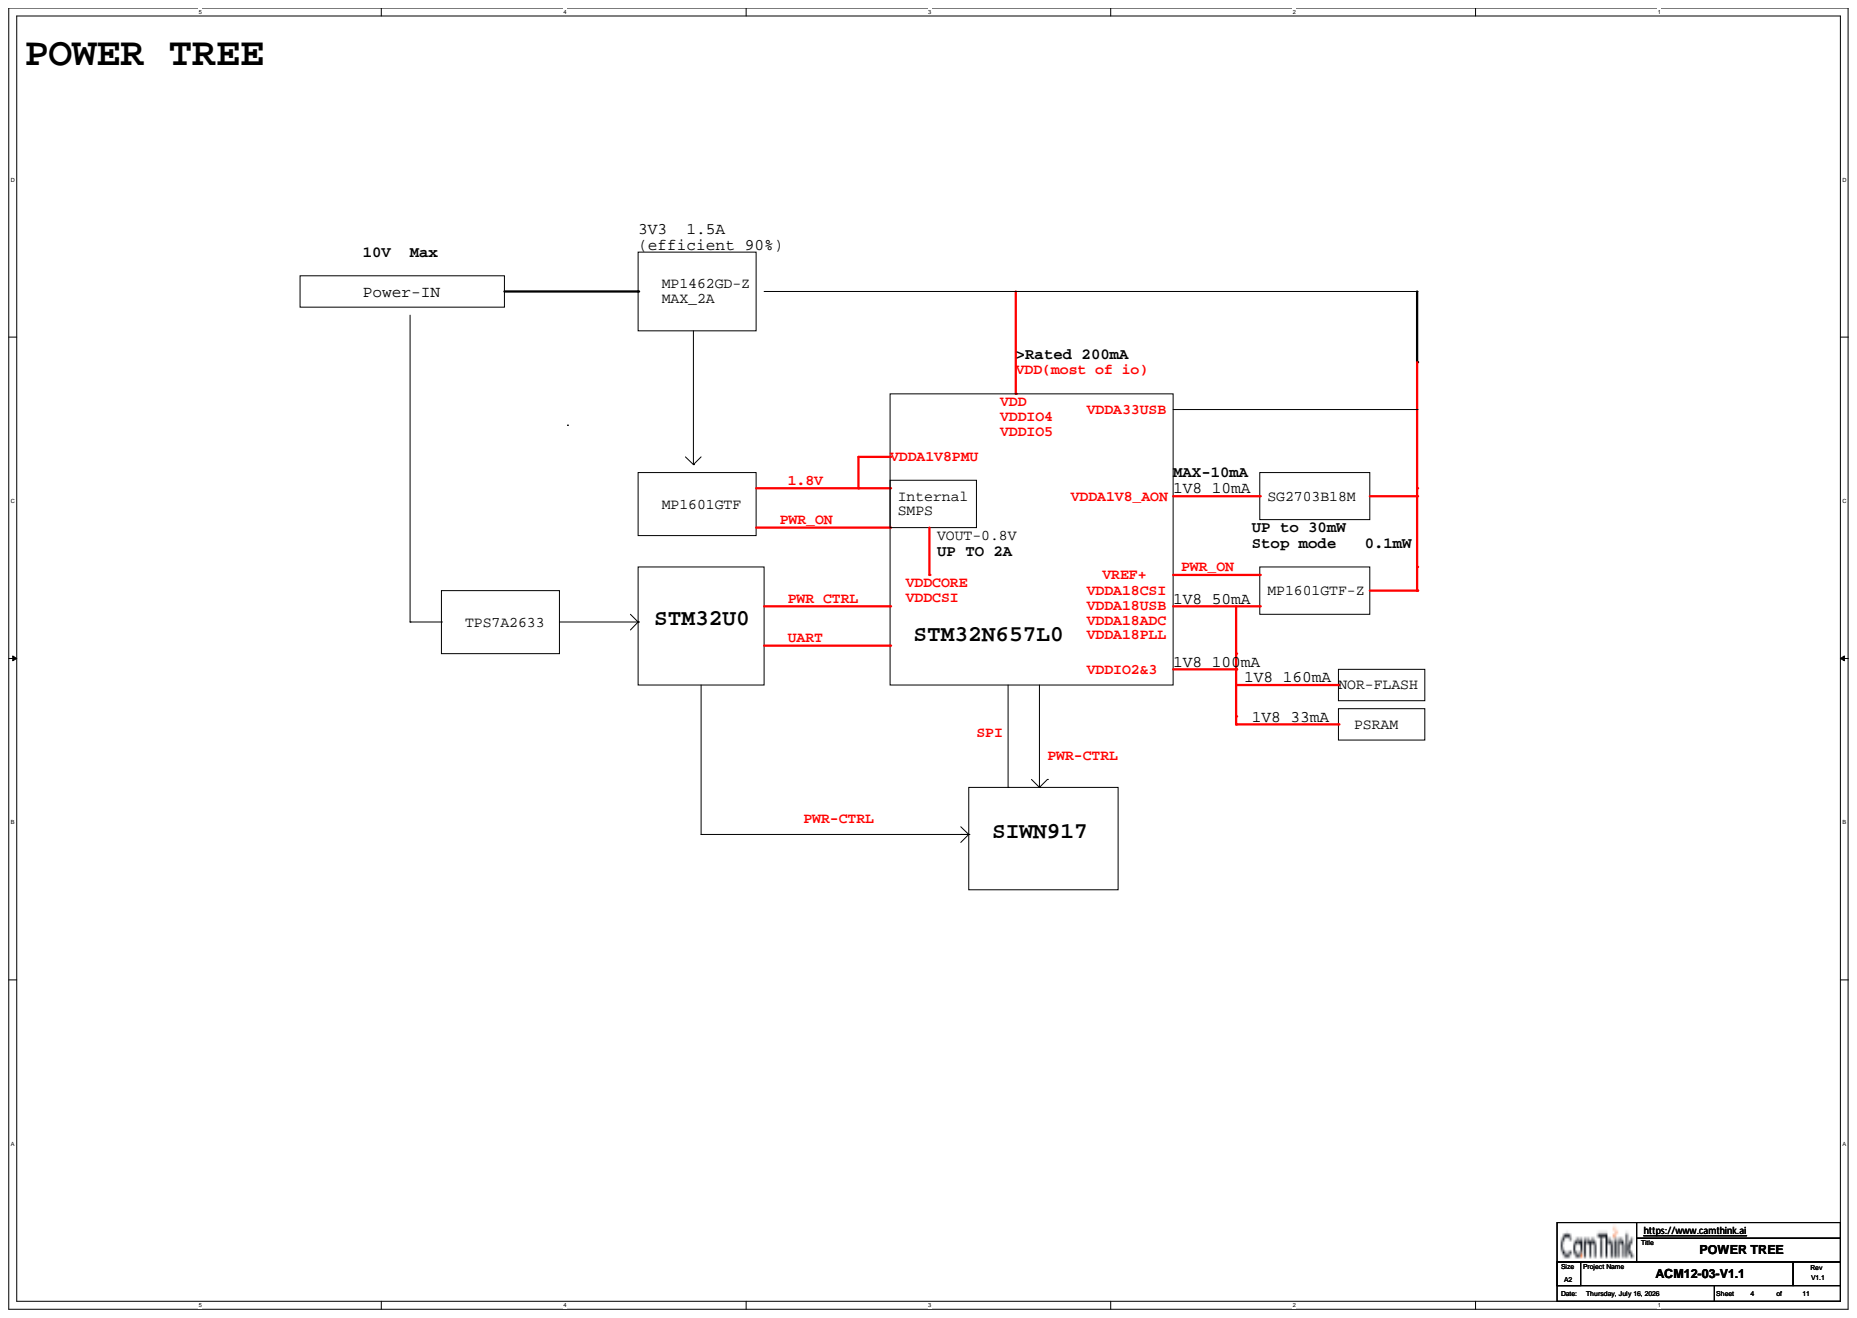
[picture p17: page 4]
MAX_2A Power-IN; 3V3 1.5A (efficient 90%); VDDA1V8_AON; STM32N657L0; VDDA33USB; VDDA18CSI VDDA18USB VDDA18ADC VDDA18PLL; VDD VDDIO4 VDDIO5; VREF+; PWR_ON; VDDCORE VDDCSI; MAX-10mA; Stop mode; MP1601GTF; Internal; SMPS; VOUT-0.8V; NOR-FLASH; PSRAM; VDDA1V8PMU; MP1601GTF-Z; VDDIO2&3 1V8 100mA; STM32U0; 10V Max; TPS7A2633; PWR CTRL; UART; SIWN917; PWR-CTRL; SPI; Title; POWER TREE; Thursday, July 16, 2026

>Rated 200mA
VDD(most of io)

https://www.camthink.ai

# STM32N657 Poewr Domains

3 of 4

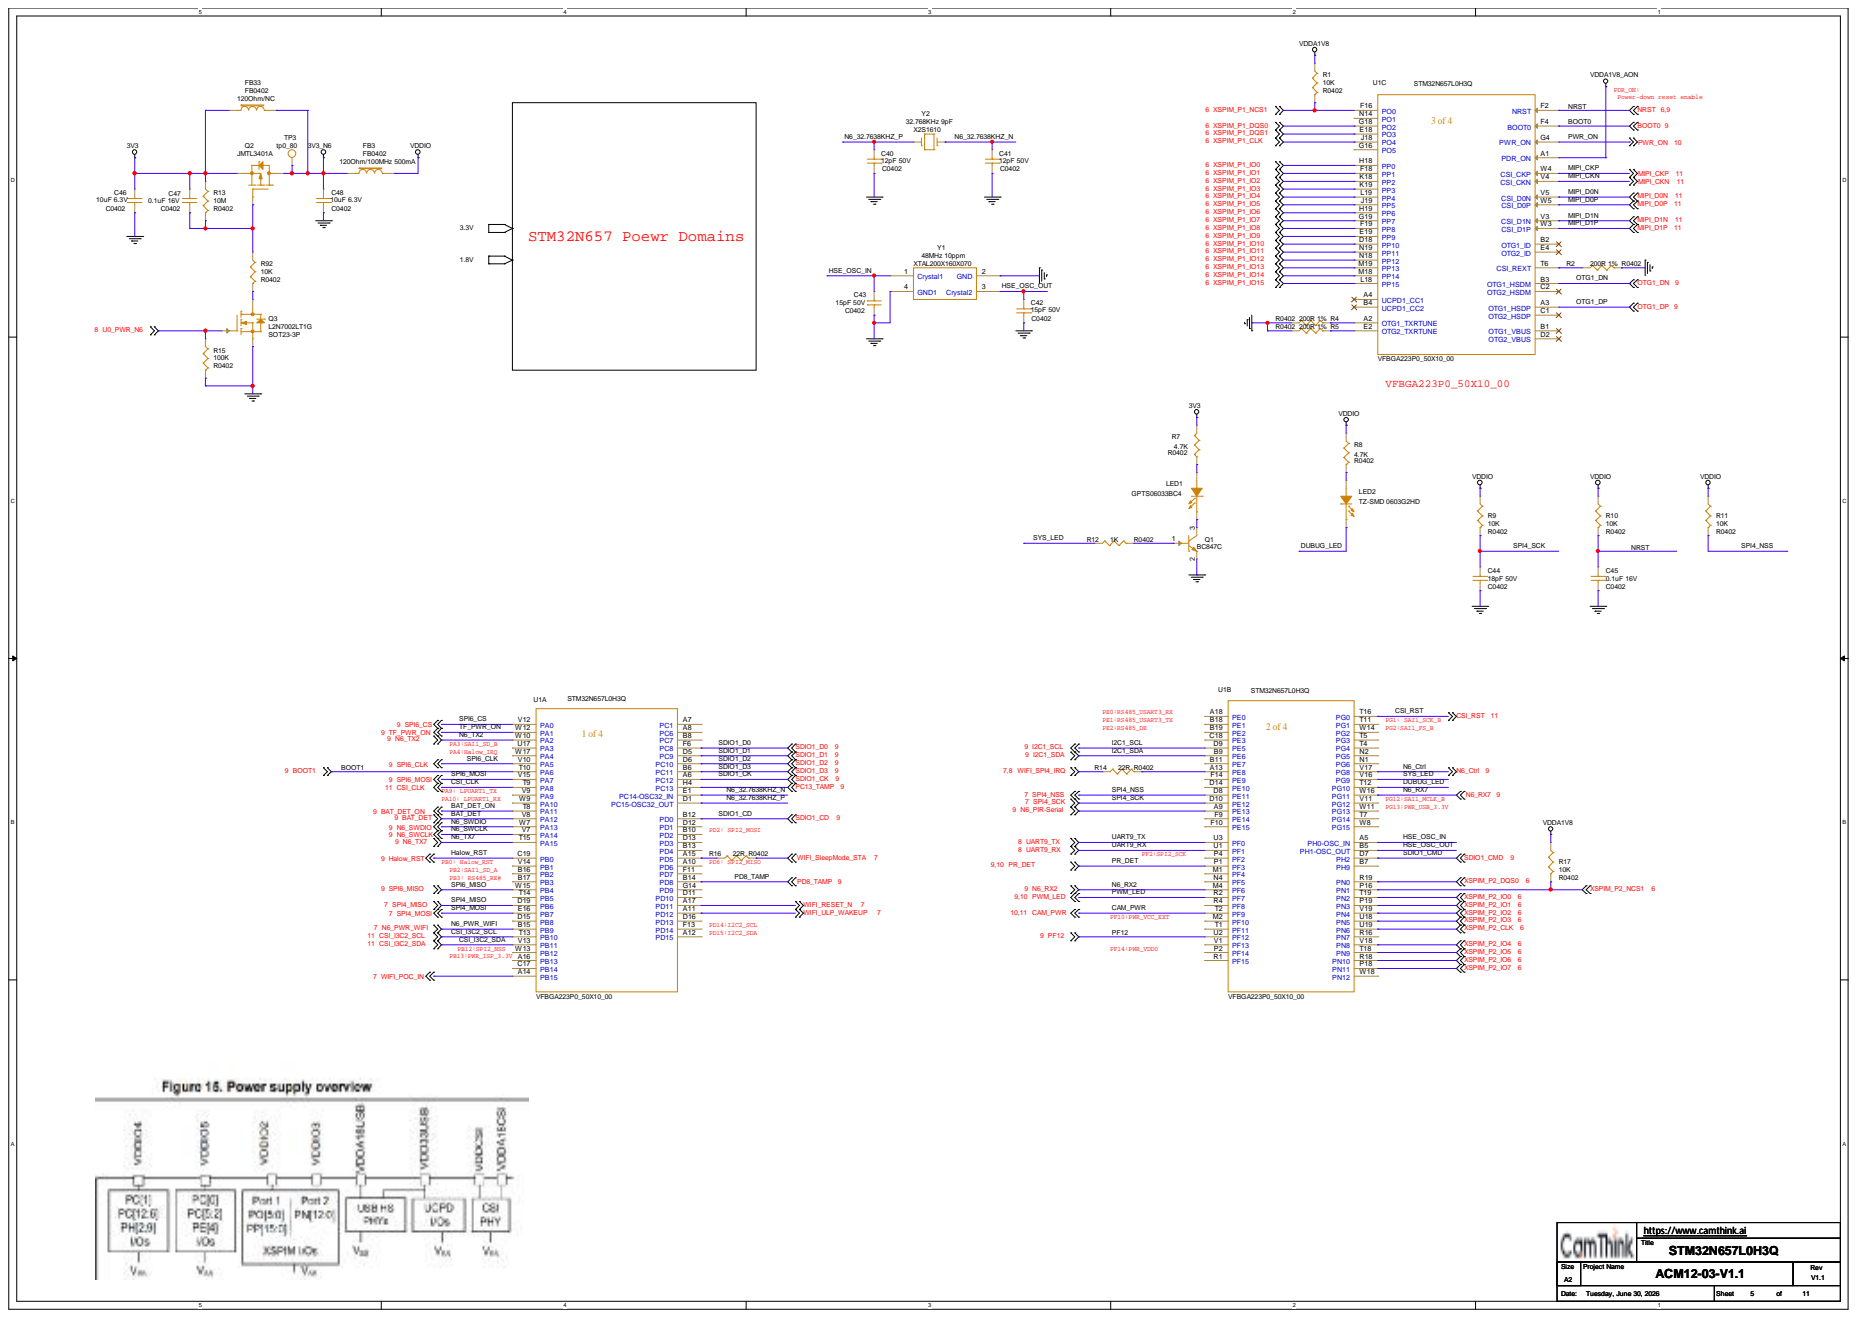
[picture p18: page 5]

https://www.camthink.ai
STM32N657L0H3Q

D | D

# PSRAM

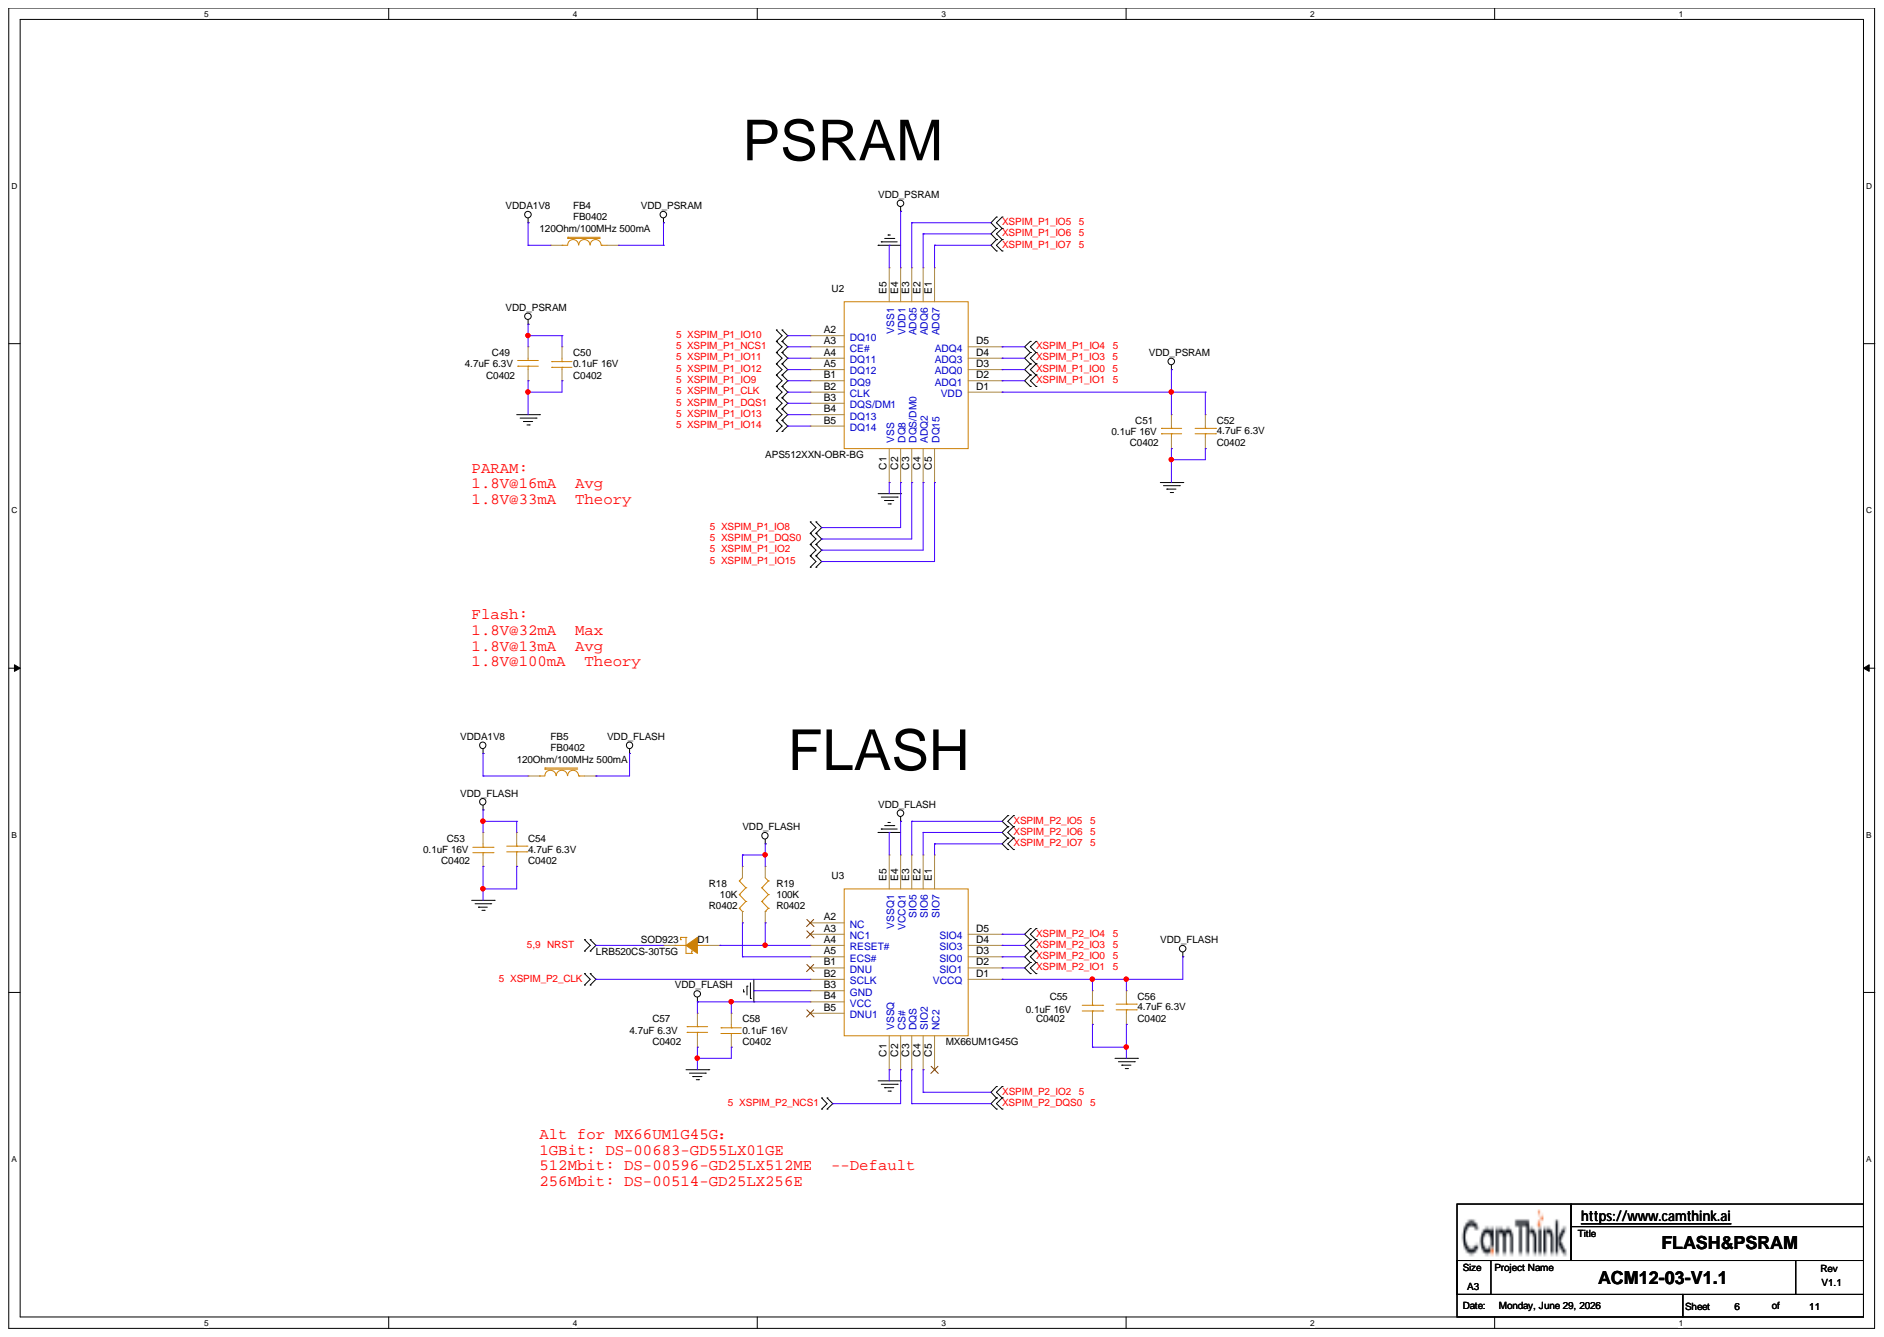
[picture p19: page 6]

D1 ADQ1 D2 ADQ0 D3 ADQ3 D4 ADQ4 D5 ADQ⁷ E¹ ADQ⁶ E² ADQ⁵ E³ VDD¹

https://www.camthink.ai
Title

## Fliter

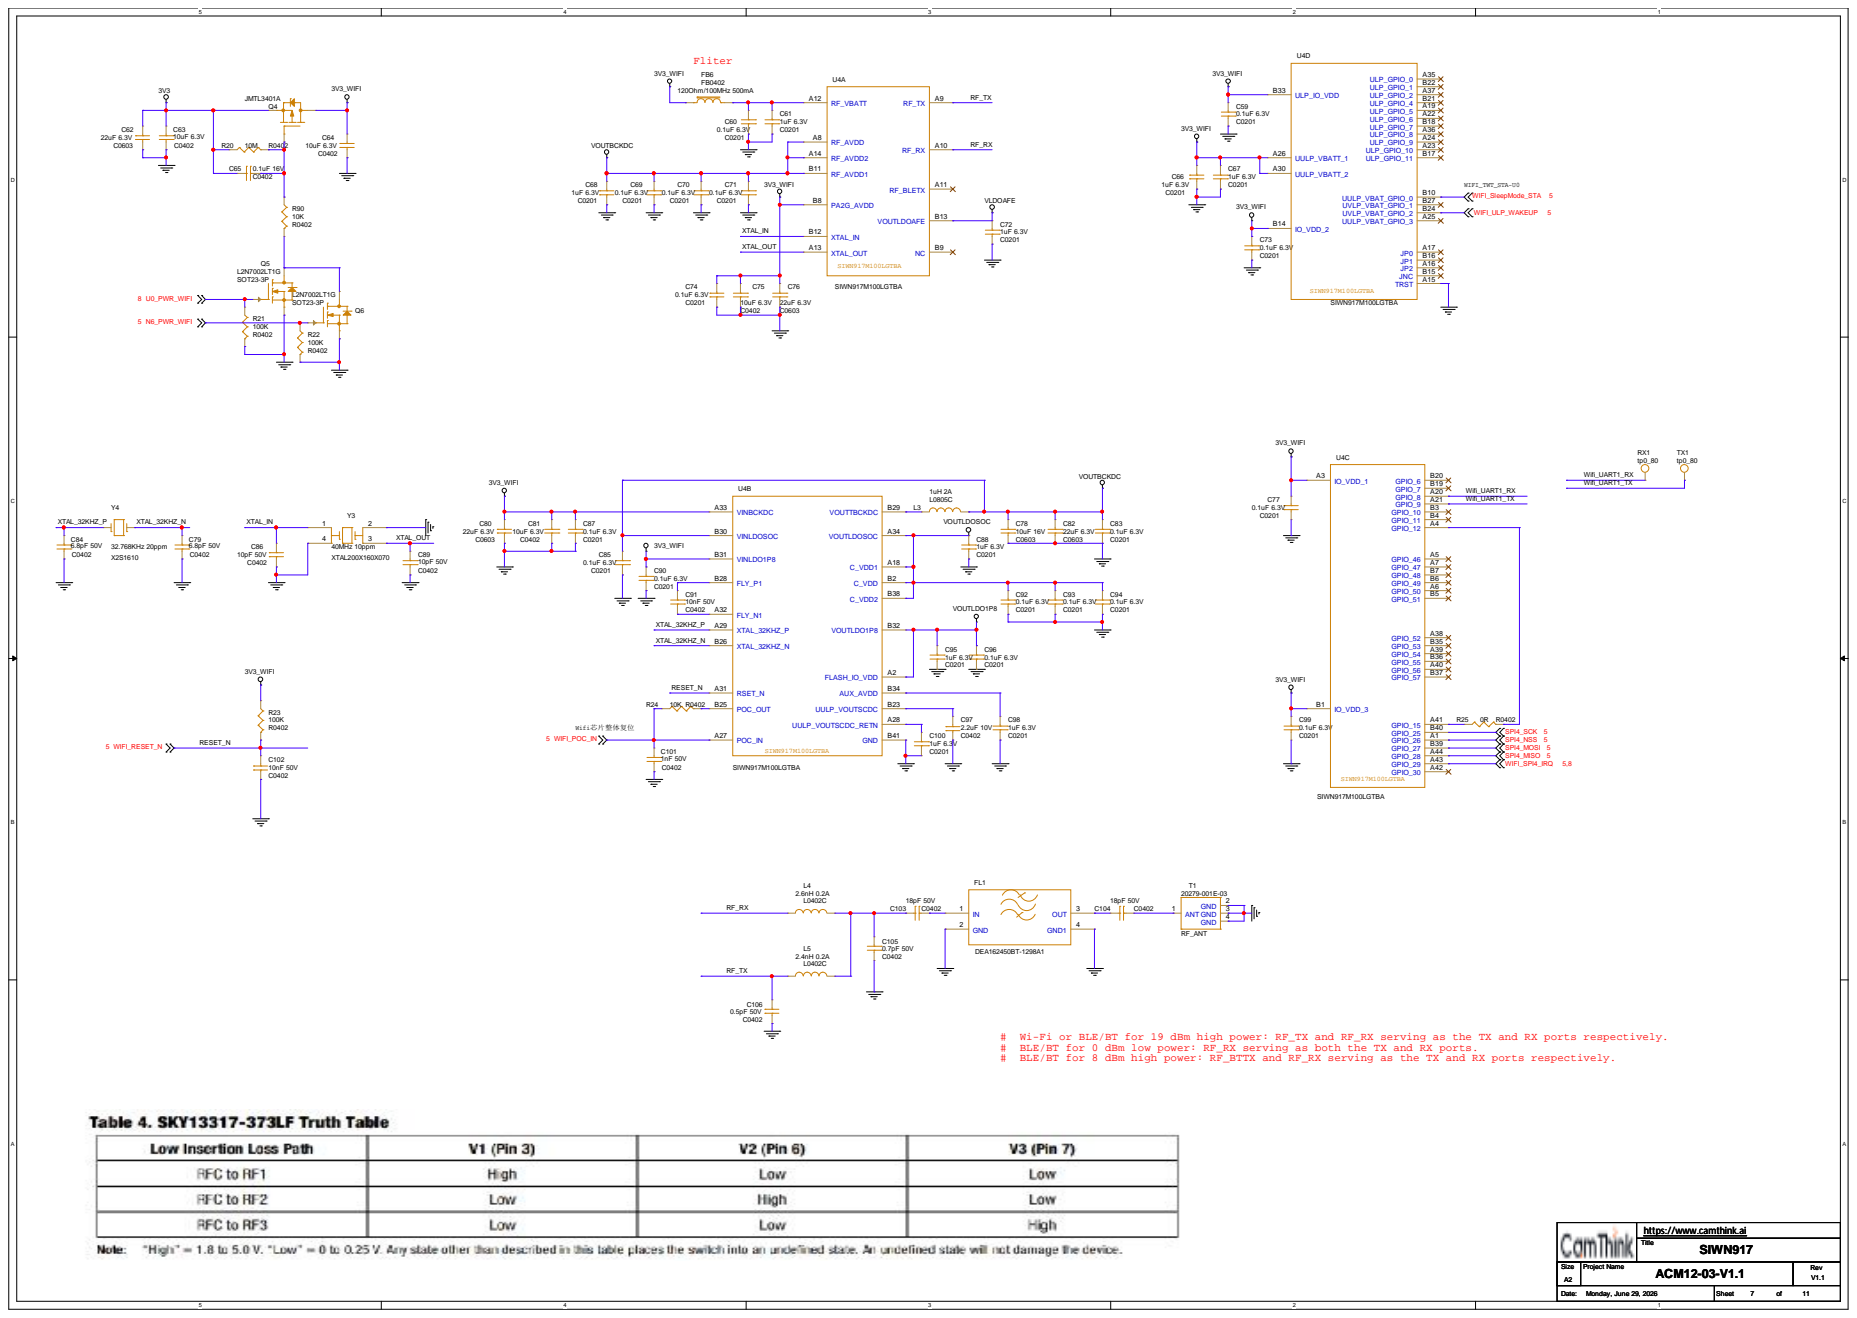
[picture p20: page 7]

# Wi-Fi or BLE/BT for 19 dBm high power: RF_TX and RF_RX serving as the TX and RX ports respectively.
# BLE/BT for 0 dBm low power: RF_RX serving as both the TX and RX ports.
# BLE/BT for 8 dBm high power: RF_BTTX and RF_RX serving as the TX and RX ports respectively.

https://www.camthink.ai

D | D

## 3V3_U0

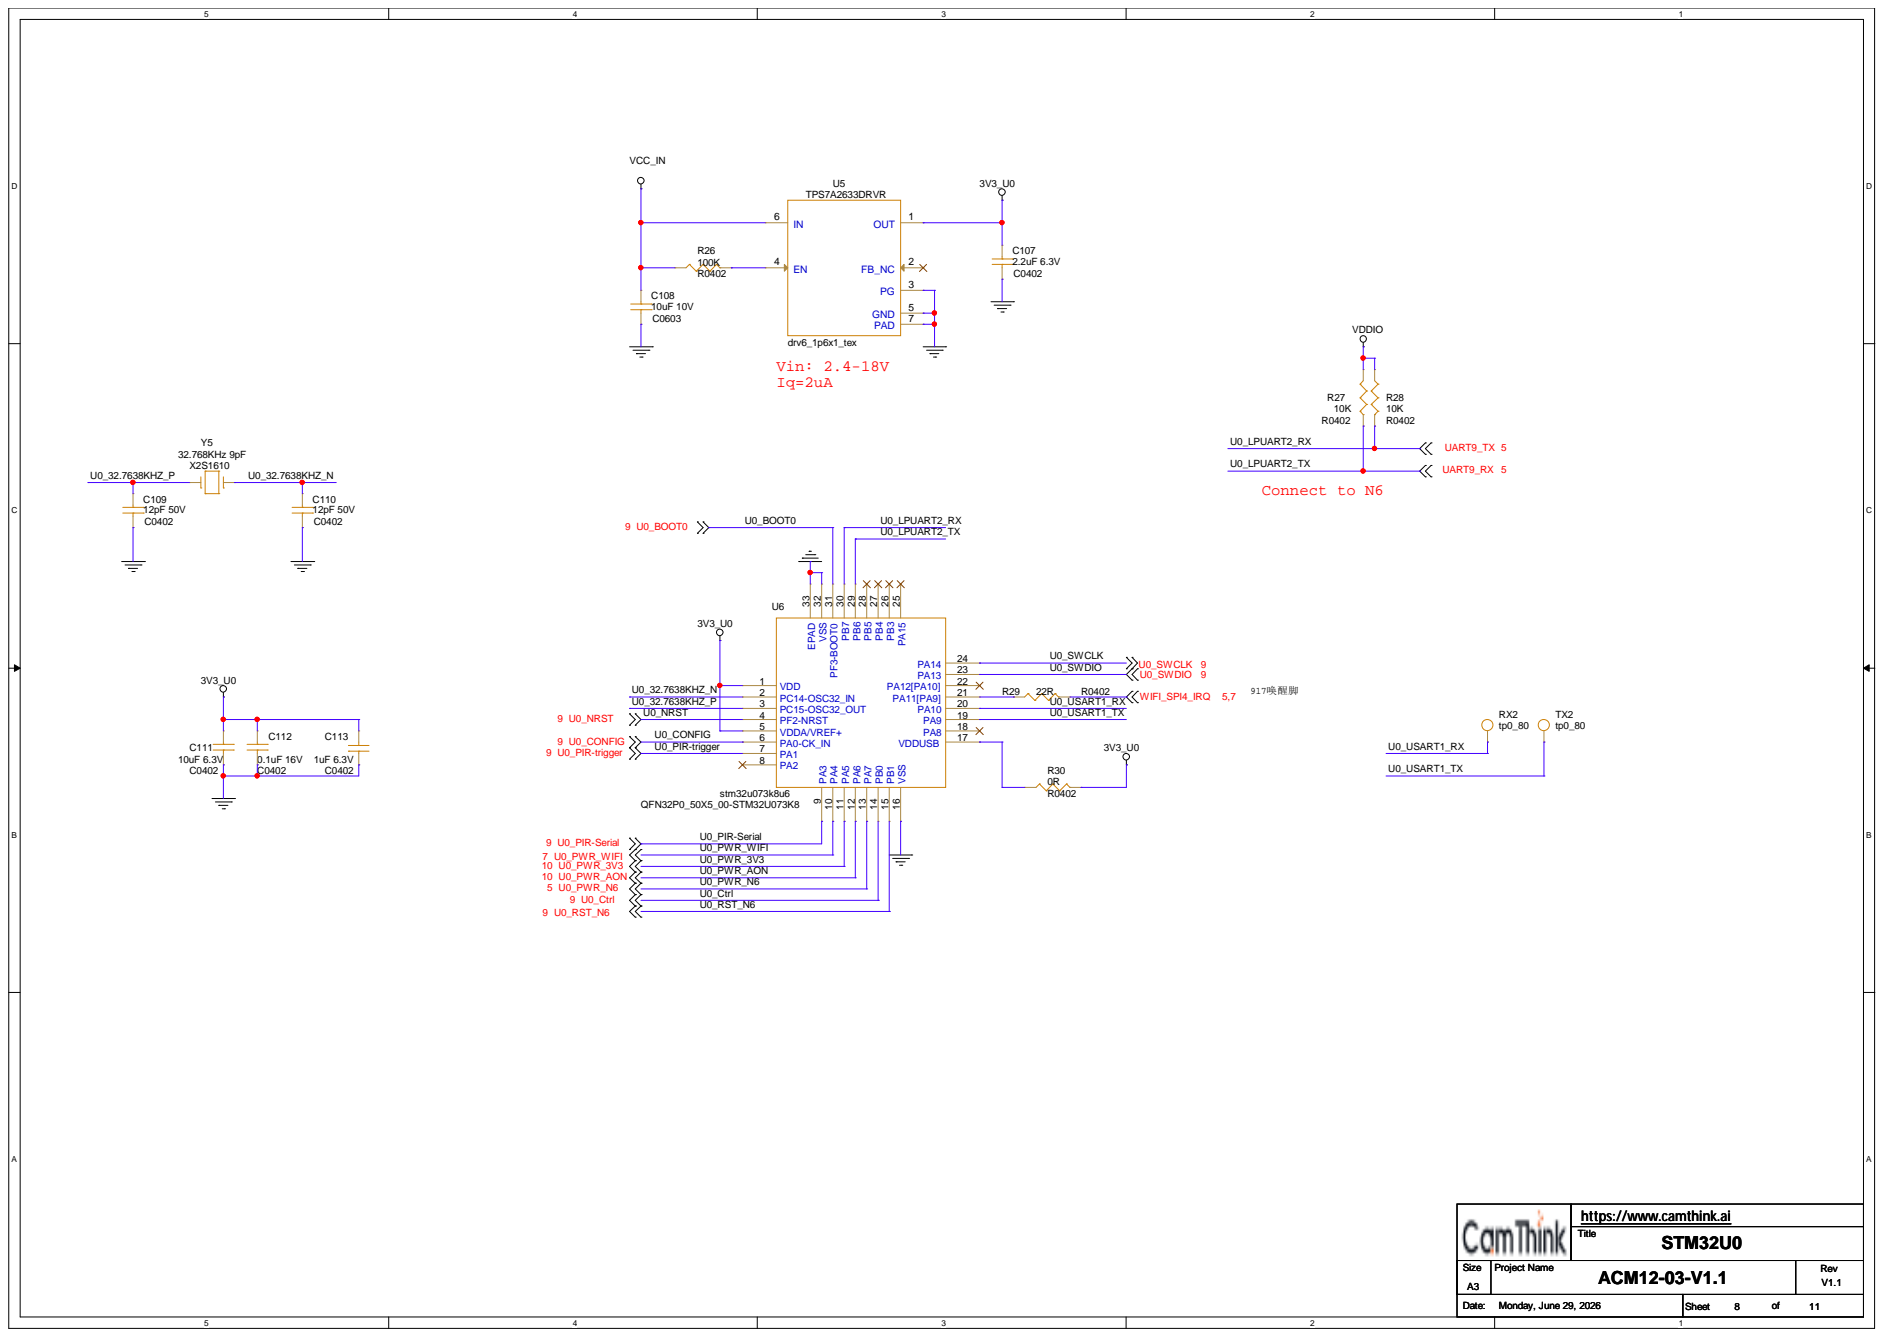
[picture p21: page 8]

https://www.camthink.ai
Title

D | D

PF3

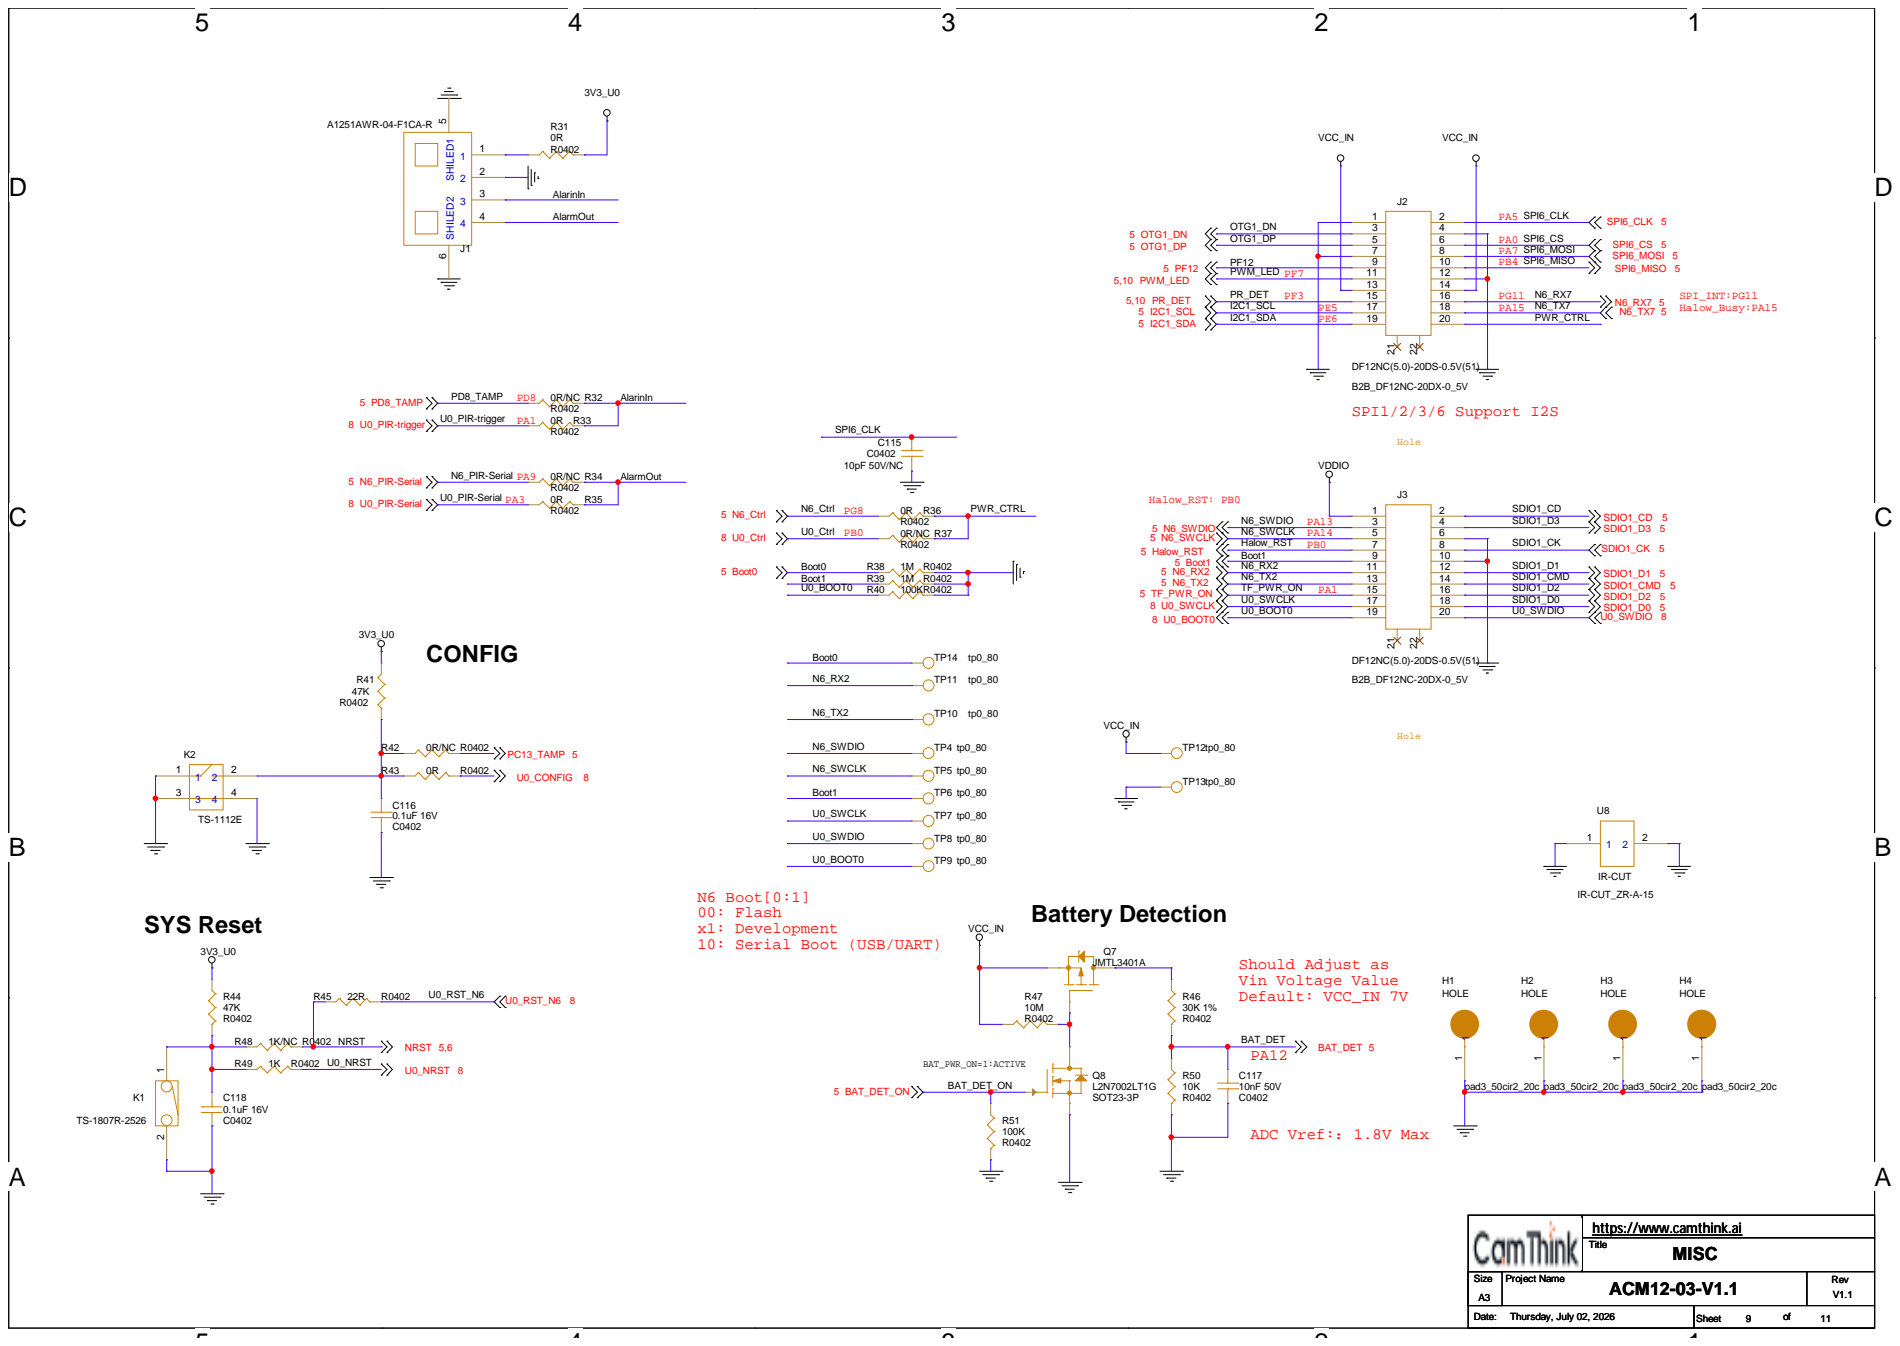
[picture p22: page 9]

https://www.camthink.ai
Title

## VDDA1V8_AON Avg=1mA

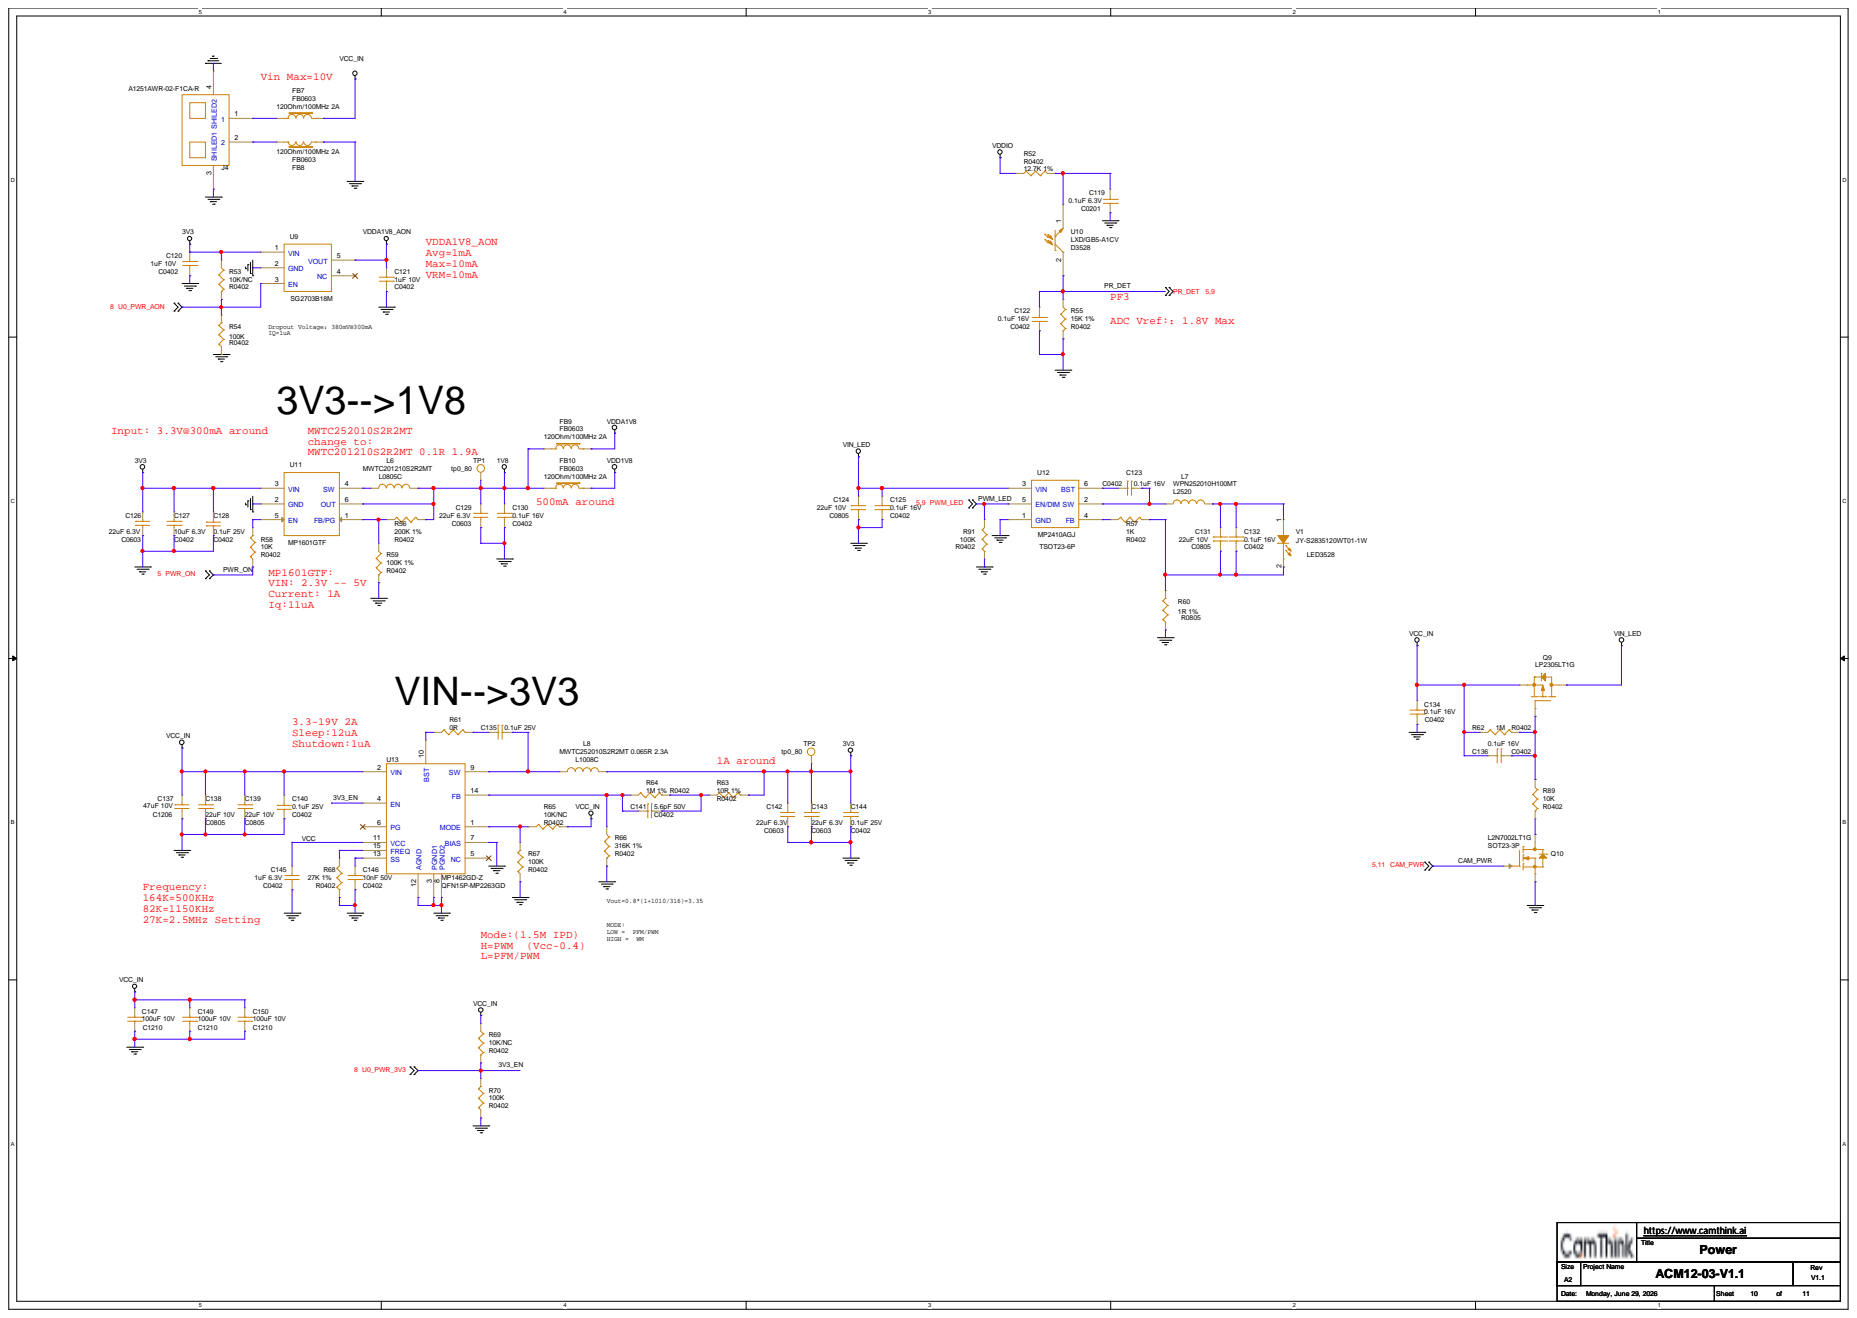
[picture p23: page 10]

https://www.camthink.ai

# Sensor

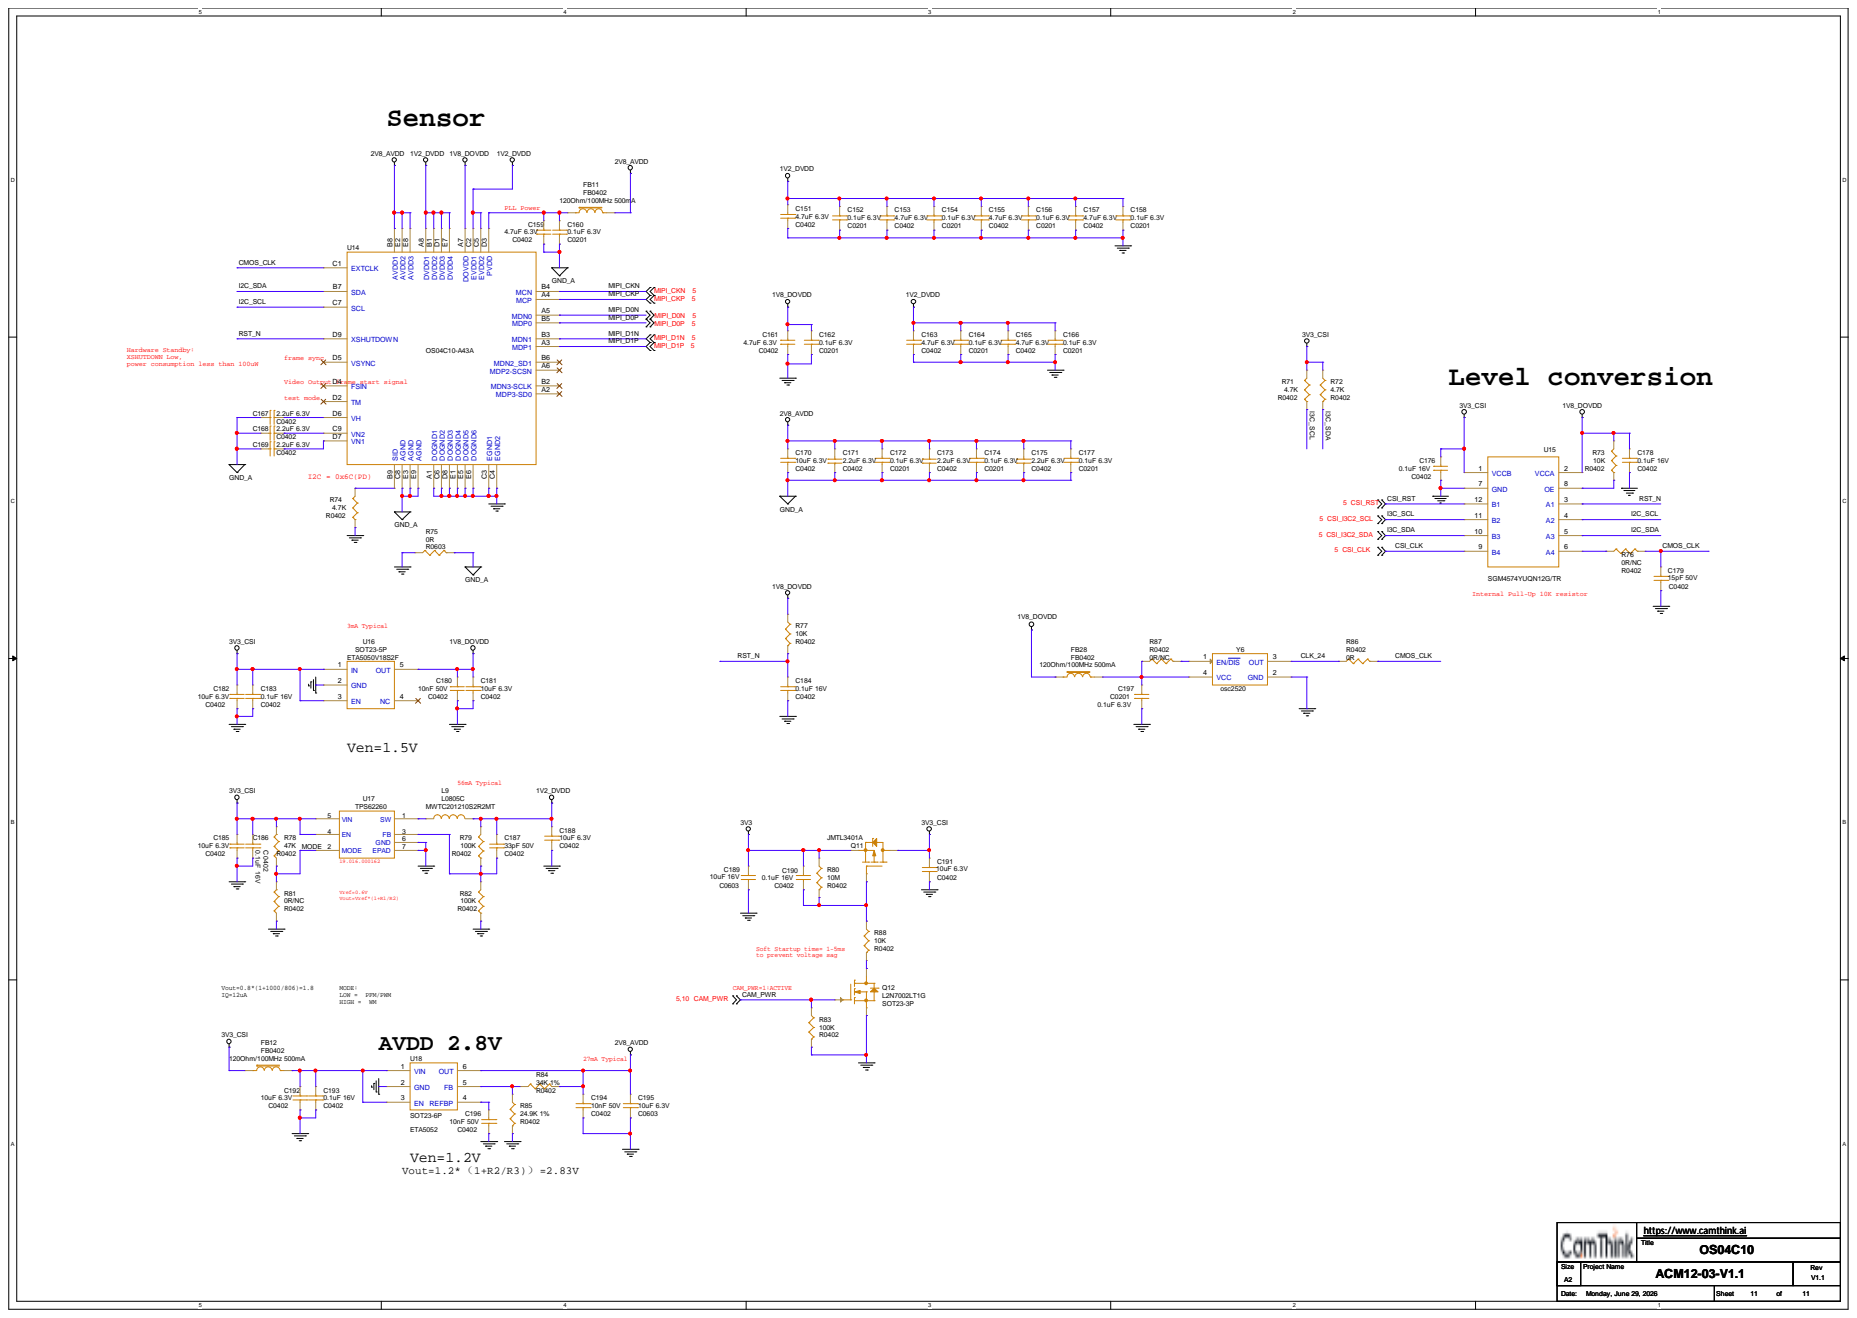
[picture p24: page 11]

Hardware Standby:
XSHUTDOWN Low,
power consumption less than 100uW

Video Output frame start signal
test mode

Internal Pull-Up 10K resistor

Soft Startup time= 1-5ms
to prevent voltage sag

https://www.camthink.ai
