camthink-ai/ne302/Hardware/NE302_IFBoard_V1.1_Open_20260716.pdf

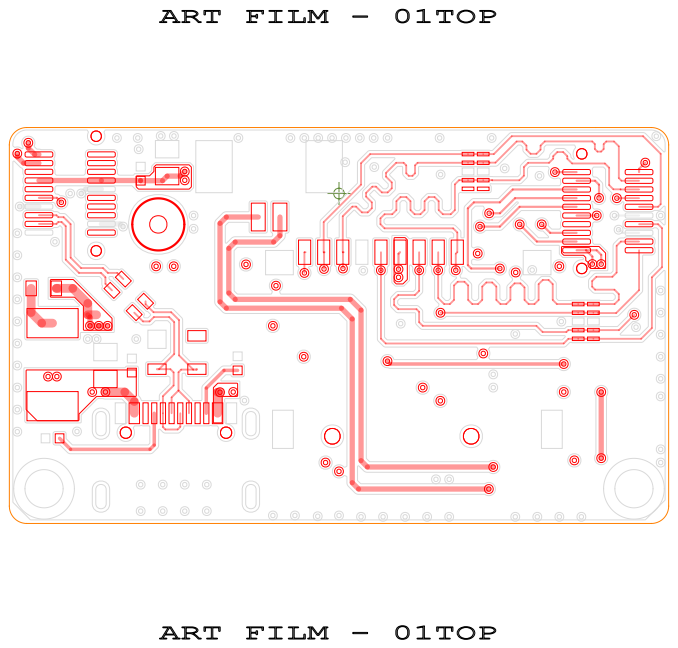
[picture p25: page 1]
ART FILM - 01TOP

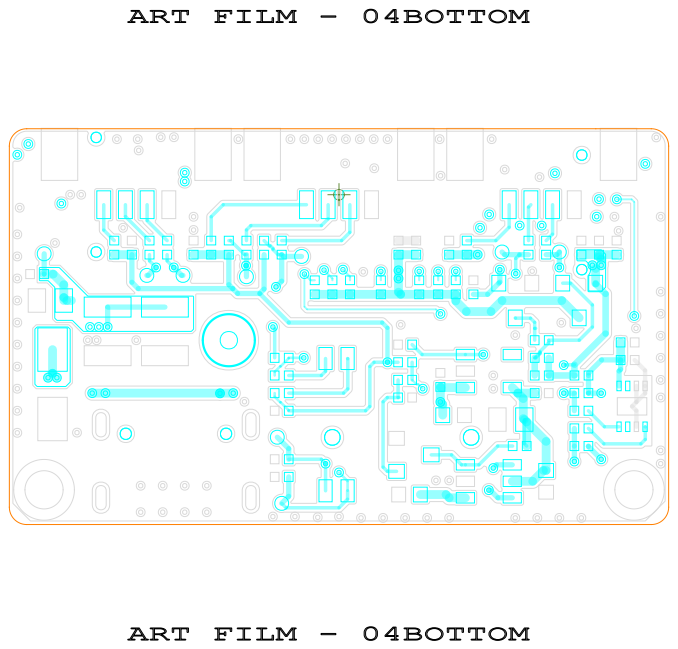
[picture p26: page 2]
ART FILM - 04BOTTOM

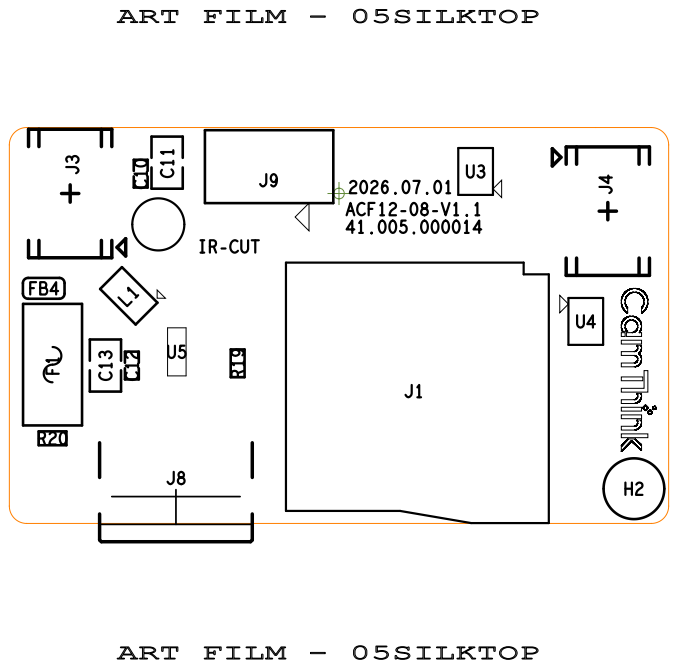
[picture p27: page 3]

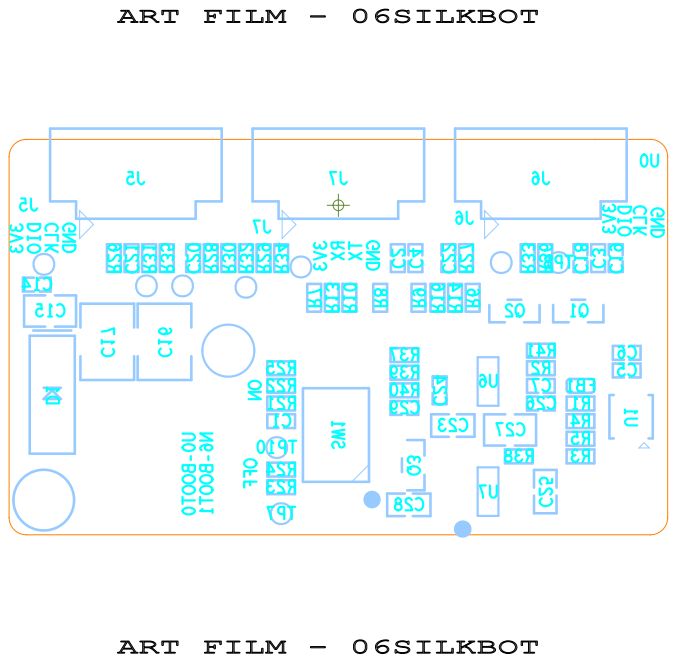
[picture p28: page 4]
