camthink-ai/ne302/Hardware/NE302_MainBoard_V1.1_Open_20260716.pdf

# ART FILM - 08BOT

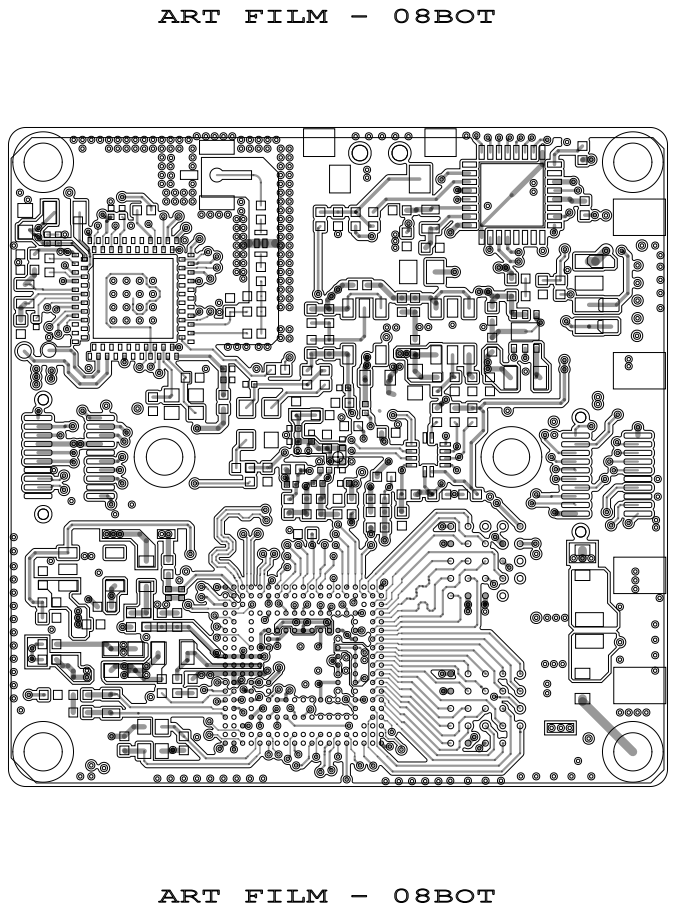
[picture p29: page 1]
ART FILM - 08BOT

# ART FILM - 01TOP

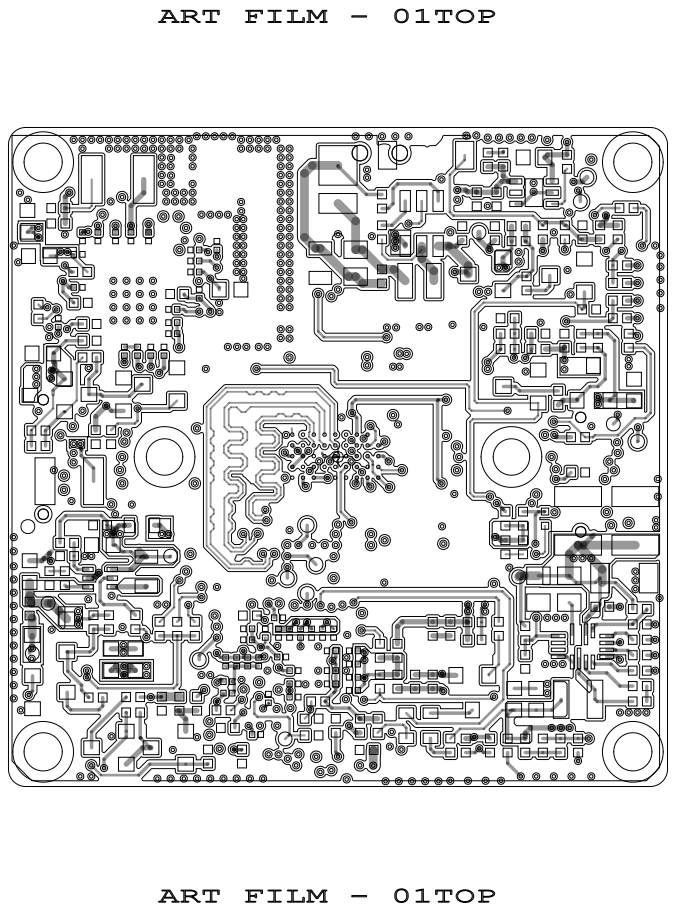
[picture p30: page 2]
ART FILM - 01TOP

# ART FILM - 09SILKTOP

# TP9C112

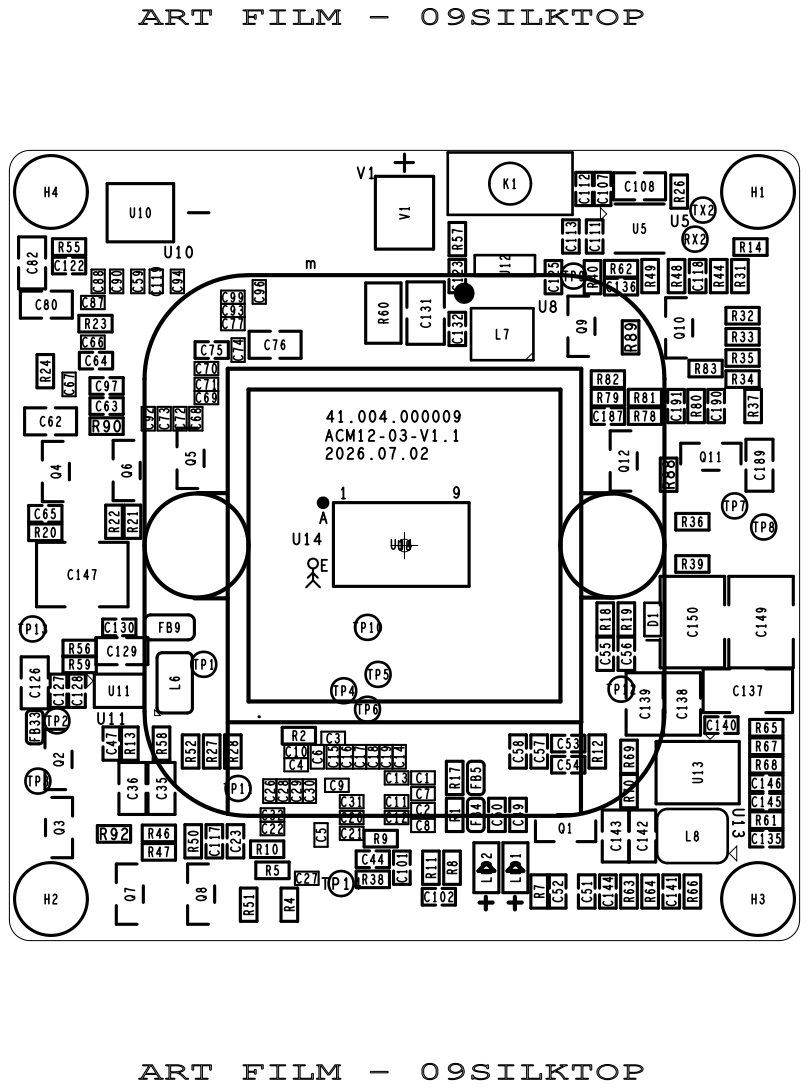
[picture p31: page 3]

# ART FILM - 10SILKBOT

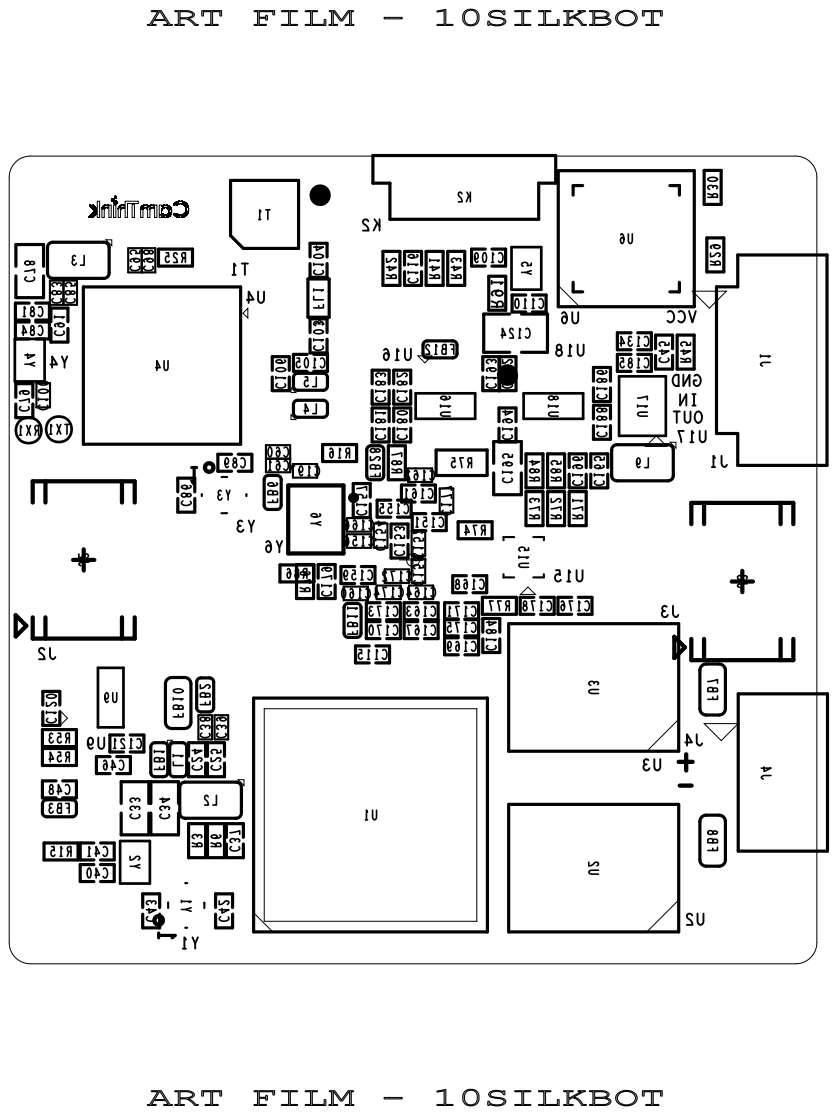
[picture p32: page 4]
