camthink-ai/ne302/Appli/Core/Inc/main.h

#define PWR_PIR_ON_Pin GPIO_PIN_6
#define PWR_PIR_ON_GPIO_Port GPIOC
#define WIFI_ULP_WAKEUP_Pin GPIO_PIN_12
#define WIFI_ULP_WAKEUP_GPIO_Port GPIOD
#define WIFI_IRQ_Pin GPIO_PIN_8
#define WIFI_IRQ_GPIO_Port GPIOE
#define WIFI_POC_IN_Pin GPIO_PIN_15
#define WIFI_POC_IN_GPIO_Port GPIOB
#define WIFI_STA_Pin GPIO_PIN_5
#define WIFI_STA_GPIO_Port GPIOD
#define PWR_WIFI_ON_Pin GPIO_PIN_9
#define PWR_WIFI_ON_GPIO_Port GPIOB
#define WIFI_RESET_N_Pin GPIO_PIN_11
#define WIFI_RESET_N_GPIO_Port GPIOD
#define TF_INT_Pin GPIO_PIN_0
#define TF_INT_GPIO_Port GPIOD
#define PIR_INT_OUT_Pin GPIO_PIN_8
#define PIR_INT_OUT_GPIO_Port GPIOD
#define PWR_USB_Pin GPIO_PIN_13
#define PWR_USB_GPIO_Port GPIOB
#define PIR_Serial_IN_Pin GPIO_PIN_13
#define PIR_Serial_IN_GPIO_Port GPIOE
#define PWR_SENSOR_ON_Pin GPIO_PIN_9
#define PWR_SENSOR_ON_GPIO_Port GPIOF
#define LED_Pin GPIO_PIN_9
#define LED_GPIO_Port GPIOG
#define LED1_Pin GPIO_PIN_3
#define LED1_GPIO_Port GPIOF
#define LED2_Pin GPIO_PIN_10
#define LED2_GPIO_Port GPIOG
#define PWR_CAT1_ON_Pin GPIO_PIN_8
#define PWR_CAT1_ON_GPIO_Port GPIOG
#define PWR_COEDC_Pin GPIO_PIN_15
#define PWR_COEDC_GPIO_Port GPIOG
#define PWR_BAT_DET_ON_Pin GPIO_PIN_11
#define PWR_BAT_DET_ON_GPIO_Port GPIOA
#define PWR_TF_ON_Pin GPIO_PIN_1
#define PWR_TF_ON_GPIO_Port GPIOA
#define ALA_IN_Pin GPIO_PIN_12
#define ALA_IN_GPIO_Port GPIOB
#define KEY_Pin GPIO_PIN_13
#define KEY_GPIO_Port GPIOC
#define TFT_BL_Pin GPIO_PIN_2
#define TFT_BL_GPIO_Port GPIOB
#define TFT_RST_Pin GPIO_PIN_0
#define TFT_RST_GPIO_Port GPIOB
#define TFT_CLK_Pin GPIO_PIN_5
#define TFT_CLK_GPIO_Port GPIOA
#define TFT_CS_Pin GPIO_PIN_0
#define TFT_CS_GPIO_Port GPIOA
#define TFT_MOSI_Pin GPIO_PIN_7
#define TFT_MOSI_GPIO_Port GPIOA
#define TFT_DC_Pin GPIO_PIN_4
#define TFT_DC_GPIO_Port GPIOB
#define PWR_USB_3V3_Pin GPIO_PIN_13
#define PWR_USB_3V3_GPIO_Port GPIOG
#define MM_HALOW_SPI_CLK_Pin GPIO_PIN_5
#define MM_HALOW_SPI_CLK_GPIO_Port GPIOA
#define MM_HALOW_SPI_CS_Pin GPIO_PIN_0
#define MM_HALOW_SPI_CS_GPIO_Port GPIOA
#define MM_HALOW_SPI_MOSI_Pin GPIO_PIN_7
#define MM_HALOW_SPI_MOSI_GPIO_Port GPIOA
#define MM_HALOW_SPI_MISO_Pin GPIO_PIN_4
#define MM_HALOW_SPI_MISO_GPIO_Port GPIOB
#define MM_HALOW_SPI_IRQ_Pin GPIO_PIN_11
#define MM_HALOW_SPI_IRQ_GPIO_Port GPIOG
#define MM_HALOW_BUSY_Pin GPIO_PIN_15
#define MM_HALOW_BUSY_GPIO_Port GPIOA
#define MM_HALOW_RESET_Pin GPIO_PIN_0
#define MM_HALOW_RESET_GPIO_Port GPIOB
#define MM_HALOW_WAKE_Pin GPIO_PIN_13
#define MM_HALOW_WAKE_GPIO_Port GPIOA
#define MM_HALOW_SPI_IRQn            (EXTI11_IRQn)
#define MM_HALOW_SPI_IRQ_HANDLER     EXTI11_IRQHandler
#define MM_HALOW_BUSY_IRQn           (EXTI15_IRQn)
#define MM_HALOW_BUSY_IRQ_HANDLER    EXTI15_IRQHandler
