camthink-ai/ne302/Custom/Hal/Network/netif_manager/sl_net_netif.c

#include <stdio.h>
#include <string.h>
#include "lwip/etharp.h"
#include "lwip/dhcp.h"
#include "lwip/netifapi.h"
#include "lwip/ethip6.h"
#include "lwip/ip6_addr.h"
#include "lwip/apps/mdns.h"
#include "sl_wifi_callback_framework.h"
#include "sl_net_wifi_types.h"
#include "sl_wifi.h"
#include "sl_net.h"
#include "wifi.h"
#include "sl_rsi_utility.h"
#include "sli_net_utility.h"
#include "sli_net_constants.h"
#include "sli_wifi_constants.h"
#include "sli_wifi_utility.h"
#include "sli_wifi_power_profile.h"
#include "sli_wifi.h"
#include "sli_buffer_manager.h"
#include "sl_net_dns.h"
#include "Log/debug.h"
#include "dhcpserver.h"
#include "sl_net_netif.h"
#include "factory_test.h"

#define IS_TCP_IP_DUAL_MODE         1
#define IS_ENABLE_NWP_DEBUG_PRINTS  0
#if IS_TCP_IP_DUAL_MODE 
#define IS_SELF_DHCP_SERVER         1
#endif
#ifdef SLI_SI91X_ENABLE_BLE
#define IS_ENABLE_BLE               1
#else
#define IS_ENABLE_BLE               0
#endif

#if IS_ENABLE_BLE
#include "ble_config.h"
#include "sl_rsi_ble.h"
#include "rsi_bt_common_apis.h"
#include "rsi_common_apis.h"
#endif

#if IS_TCP_IP_DUAL_MODE
extern sl_status_t sl_si91x_configure_ip_address(sl_net_ip_configuration_t *address, uint8_t virtual_ap_id);
#endif

/* Used by SDK event handler for dual-stack raw-data routing (sl_net_for_dual_stack.c not linked). */
bool bypass_mode_enabled = false;
bool dual_mode_enabled   = false;

/// @brief Default wireless network interface configuration
/// @note Non-const so region_code can be configured before init via
///       sl_net_wifi_set_region_code() (only effective when both netifs DEINIT).
static sl_wifi_device_configuration_t device_configuration = {
  .boot_option = LOAD_NWP_FW,
  .mac_address = NULL,
  .band        = SL_SI91X_WIFI_BAND_2_4GHZ,
  .region_code = SL_WIFI_REGION_US,
  .boot_config = { .oper_mode = SL_SI91X_CONCURRENT_MODE,
#if IS_ENABLE_BLE
                   .coex_mode = SL_SI91X_WLAN_BLE_MODE,
#else
                   .coex_mode = SL_SI91X_WLAN_ONLY_MODE,
#endif
                   .feature_bit_map = SL_SI91X_FEAT_AGGREGATION,
                   .tcp_ip_feature_bit_map     = (
#if IS_TCP_IP_DUAL_MODE
                        SL_SI91X_TCP_IP_FEAT_DHCPV4_CLIENT | SL_SI91X_TCP_IP_FEAT_ICMP | SL_SI91X_TCP_IP_FEAT_SSL
                        | SL_SI91X_TCP_IP_FEAT_DNS_CLIENT |
#if (IS_SELF_DHCP_SERVER == 0)
                        SL_SI91X_TCP_IP_FEAT_DHCPV4_SERVER |
#endif
#else
                        SL_SI91X_TCP_IP_FEAT_BYPASS | 
#endif
                        SL_SI91X_TCP_IP_FEAT_EXTENSION_VALID),
                   .custom_feature_bit_map     = SL_SI91X_CUSTOM_FEAT_EXTENTION_VALID,
                   .ext_custom_feature_bit_map = (SL_SI91X_EXT_FEAT_XTAL_CLK | MEMORY_CONFIG
#if IS_ENABLE_NWP_DEBUG_PRINTS
                    | SL_SI91X_EXT_FEAT_UART_SEL_FOR_DEBUG_PRINTS
#else
                    | SL_SI91X_EXT_FEAT_DISABLE_DEBUG_PRINTS
#endif
#if defined(SLI_SI917) || defined(SLI_SI915)
                                                  | SL_SI91X_EXT_FEAT_FRONT_END_INTERNAL_SWITCH  
#endif

#if IS_ENABLE_BLE
                                                  | SL_SI91X_EXT_FEAT_BT_CUSTOM_FEAT_ENABLE
#endif
                                                  ),
#if IS_ENABLE_BLE
                    .bt_feature_bit_map        = (SL_SI91X_BT_RF_TYPE | SL_SI91X_ENABLE_BLE_PROTOCOL),
#else
                   .bt_feature_bit_map         = 0,
#endif
                   .ext_tcp_ip_feature_bit_map = (
#if IS_TCP_IP_DUAL_MODE
                        SL_SI91X_EXT_TCP_IP_DUAL_MODE_ENABLE | SL_SI91X_EXT_EMB_MQTT_ENABLE
                        | SL_SI91X_EXT_TCP_IP_WINDOW_SCALING | SL_SI91X_EXT_TCP_IP_TOTAL_SELECTS(10) |
#endif
                        SL_SI91X_CONFIG_FEAT_EXTENTION_VALID),
#if IS_ENABLE_BLE
                    .ble_feature_bit_map =
                    ((SL_SI91X_BLE_MAX_NBR_PERIPHERALS(RSI_BLE_MAX_NBR_PERIPHERALS)
                    | SL_SI91X_BLE_MAX_NBR_CENTRALS(RSI_BLE_MAX_NBR_CENTRALS)
                    | SL_SI91X_BLE_MAX_NBR_ATT_SERV(RSI_BLE_MAX_NBR_ATT_SERV)
                    | SL_SI91X_BLE_MAX_NBR_ATT_REC(RSI_BLE_MAX_NBR_ATT_REC))
                    | SL_SI91X_FEAT_BLE_CUSTOM_FEAT_EXTENTION_VALID | SL_SI91X_BLE_PWR_INX(RSI_BLE_PWR_INX)
                    | SL_SI91X_BLE_PWR_SAVE_OPTIONS(RSI_BLE_PWR_SAVE_OPTIONS) | SL_SI91X_916_BLE_COMPATIBLE_FEAT_ENABLE
#if RSI_BLE_GATT_ASYNC_ENABLE
                    | SL_SI91X_BLE_GATT_ASYNC_ENABLE
#endif
                    ),
               .ble_ext_feature_bit_map =
                    ((SL_SI91X_BLE_NUM_CONN_EVENTS(RSI_BLE_NUM_CONN_EVENTS)
                    | SL_SI91X_BLE_NUM_REC_BYTES(RSI_BLE_NUM_REC_BYTES))
#if RSI_BLE_INDICATE_CONFIRMATION_FROM_HOST
                    | SL_SI91X_BLE_INDICATE_CONFIRMATION_FROM_HOST //indication response from app
#endif
#if RSI_BLE_MTU_EXCHANGE_FROM_HOST
                    | SL_SI91X_BLE_MTU_EXCHANGE_FROM_HOST //MTU Exchange request initiation from app
#endif
#if RSI_BLE_SET_SCAN_RESP_DATA_FROM_HOST
                    | (SL_SI91X_BLE_SET_SCAN_RESP_DATA_FROM_HOST) //Set SCAN Resp Data from app
#endif
#if RSI_BLE_DISABLE_CODED_PHY_FROM_HOST
                    | (SL_SI91X_BLE_DISABLE_CODED_PHY_FROM_HOST) //Disable Coded PHY from app
#endif
#if BLE_SIMPLE_GATT
                    | SL_SI91X_BLE_GATT_INIT
#endif
                    ),
#else
                   .ble_feature_bit_map        = 0,
                   .ble_ext_feature_bit_map    = 0,
#endif
                   .config_feature_bit_map = SL_SI91X_FEAT_SLEEP_GPIO_SEL_BITMAP }
};

/* Factory-burned MAC: applied through sl_wifi_init's boot config — the only
 * FW-sanctioned window (sl_si91x_driver init, right after firmware load and
 * before the radio/opermode configuration). A sl_wifi_set_mac_address issued
 * after the concurrent-mode profile exists is rejected with raw status 0x21
 * and poisons subsequent MAC queries (STA netif_add died with 0x10021).
 * Storage must outlive sl_net_init: the driver dereferences the pointer
 * during init. */
static sl_mac_address_t factory_wifi_mac = { 0 };

/// @brief Point device_configuration at the factory MAC before the first
///        sl_net_init (idempotent; no-op when nothing valid is burned).
static void sl_net_apply_factory_mac(void)
{
    /* "applied" latches BEFORE the NVS read on purpose: if the first init
     * window could not see the burned MAC (e.g. storage not ready yet),
     * the radio boots on its default MAC and a retry from the second
     * interface's init must NOT flip the pointer either — sl_net_init has
     * already run, so the late value would only change the identity
     * derivation while the initialized radio keeps the default address
     * (identity on one MAC, interfaces on the other). All-or-nothing per
     * boot. */
    static bool applied = false;
    if (applied || device_configuration.mac_address != NULL) return;
    applied = true;
    if (factory_mac_get_burned(factory_wifi_mac.octet) == 0)
        device_configuration.mac_address = &factory_wifi_mac;
}

#if IS_SELF_DHCP_SERVER
/// Defined below (line ~399); needed early by sl_net_fw_dhcps_compat_check().
extern struct netif client_netif;
/// Set when the running NWP firmware predates host-side DHCP server support
/// (< 2.16.5): the AP then uses the firmware DHCP server instead of lwip dhcps.
static bool sl_net_fw_dhcps_fallback = false;
/// Set via sl_net_netif_skip_fw_dhcps_compat_check(): STA-only boots (fast
/// wakeup path, no AP) skip the check. The AP init still checks — it needs
/// the fallback, so the skip only defers, never disables.
static bool sl_net_fw_dhcps_check_skip = false;

/// @brief One-shot firmware compatibility check for the host DHCP server.
///        Runs at whichever of AP/STA initializes first. WiFi firmware older
///        than 2.16.5 cannot serve DHCP from the host (lwip dhcps) — AP
///        clients would connect but never obtain an IP. Reboot the NWP with
///        SL_SI91X_TCP_IP_FEAT_DHCPV4_SERVER added, i.e. fall back to the
///        firmware DHCP server like an IS_SELF_DHCP_SERVER==0 build.
/// @param interface Interface currently being initialized
/// @return SL_STATUS_OK when usable (fallback applied or not needed)
static sl_status_t sl_net_fw_dhcps_compat_check(sl_net_interface_t interface)
{
    static bool checked = false;
    sl_wifi_firmware_version_t fw = { 0 };
    sl_status_t status;

    if (checked) return SL_STATUS_OK;
    checked = true;

    status = sl_wifi_get_firmware_version(&fw);
    if (status != SL_STATUS_OK) {
        LOG_DRV_WARN("FW version unavailable (0x%lX), keep host DHCP server\r\n", status);
        return SL_STATUS_OK;
    }
    /* "2.16.5" — the patch number lives in security_version (SDK swaps the
     * field names, see wifi_get_running_version). */
    if (fw.major > 2 || (fw.major == 2 && (fw.minor > 16 || (fw.minor == 16 && fw.security_version >= 5)))) {
        return SL_STATUS_OK;
    }

    LOG_DRV_WARN("Wi-Fi FW %d.%d.%d < 2.16.5, fall back to firmware DHCP server\r\n",
                 fw.major, fw.minor, fw.security_version);
    /* Check deferred to AP init while the STA already brought the device up
     * (fast-wakeup skip): a bare sl_net_deinit(interface) is not effective
     * here — sl_wifi_deinit() resets the whole NWP including the live STA
     * association, and the lwIP client netif would stay registered on a dead
     * link. Tear the client netif down cleanly first (disconnect, device
     * deinit, netif remove — same sequence as the recovery thread in
     * sl_net_thread), reboot the NWP with the server bit, then restore the
     * STA to its previous state (one-shot check → no recursion). */
    bool sta_registered = (netif_get_by_index(client_netif.num + 1) == &client_netif);
    netif_state_t sta_state = sl_net_client_netif_state();
    if (sta_registered) sl_net_client_netif_deinit();
    else sl_net_deinit(interface);

    device_configuration.boot_config.tcp_ip_feature_bit_map |= SL_SI91X_TCP_IP_FEAT_DHCPV4_SERVER;
    sl_net_fw_dhcps_fallback = true;
    /* We just deinit'd the device: anything but a real init here means the
     * deinit failed and the new bitmap was NOT applied — fail loudly instead
     * of keeping a fallback flag that would skip the host DHCP server. */
    status = sl_net_init(interface, &device_configuration, NULL, NULL);
    if (status != SL_STATUS_OK) {
        LOG_DRV_ERROR("Failed to re-init Wi-Fi with firmware DHCP server: 0x%lX\r\n", status);
        return status;
    }

    if (sta_registered) {
        int ret = sl_net_client_netif_init();
        if (ret != SL_STATUS_OK) {
            LOG_DRV_ERROR("Failed to restore Wi-Fi client after DHCP fallback: 0x%X\r\n", ret);
            return ret;
        }
        if (sta_state == NETIF_STATE_UP) {
            ret = sl_net_client_netif_up();
            if (ret != SL_STATUS_OK) {
                LOG_DRV_WARN("Wi-Fi client reconnect after DHCP fallback failed: 0x%X\r\n", ret);
            }
        }
    }
    return SL_STATUS_OK;
}
#endif

/// @brief Skip the fw < 2.16.5 DHCP-server compatibility check for STA-only
///        boots. Call before any netif init on fast-wakeup paths that never
///        start the AP: saves the version query (and on old firmware the NWP
///        deinit/re-init cycle). The check still runs before the AP is
///        initialized, so skipping cannot reintroduce the no-IP problem.
///        No-op in non-self-DHCP-server builds.
void sl_net_netif_skip_fw_dhcps_compat_check(void)
{
#if IS_SELF_DHCP_SERVER
    sl_net_fw_dhcps_check_skip = true;
#endif
}
/// @brief Remote wake-up configuration (wifi mode)
static sl_wifi_device_configuration_t remote_wake_up_wifi_cfg = {
  .boot_option = LOAD_NWP_FW,
  .mac_address = NULL,
  .band        = SL_SI91X_WIFI_BAND_2_4GHZ,
  .region_code = SL_WIFI_REGION_US,
  .boot_config = { .oper_mode = SL_SI91X_CLIENT_MODE,
                   .coex_mode = SL_SI91X_WLAN_ONLY_MODE,
                   .feature_bit_map =
                     (SL_SI91X_FEAT_SECURITY_OPEN | SL_SI91X_FEAT_AGGREGATION | SL_SI91X_FEAT_ULP_GPIO_BASED_HANDSHAKE
#ifdef SLI_SI91X_MCU_INTERFACE
                      | SL_SI91X_FEAT_WPS_DISABLE
#endif
                      ),
                   .tcp_ip_feature_bit_map = (SL_SI91X_TCP_IP_FEAT_DHCPV4_CLIENT | SL_SI91X_TCP_IP_FEAT_EXTENSION_VALID
                                              | SL_SI91X_TCP_IP_FEAT_SSL | SL_SI91X_TCP_IP_FEAT_DNS_CLIENT),
                   .custom_feature_bit_map = (SL_SI91X_CUSTOM_FEAT_EXTENTION_VALID),
                   .ext_custom_feature_bit_map = (SL_SI91X_EXT_FEAT_LOW_POWER_MODE | SL_SI91X_EXT_FEAT_XTAL_CLK
                                                  | MEMORY_CONFIG
#if IS_ENABLE_NWP_DEBUG_PRINTS
                                                  | SL_SI91X_EXT_FEAT_UART_SEL_FOR_DEBUG_PRINTS
#else
                                                  | SL_SI91X_EXT_FEAT_DISABLE_DEBUG_PRINTS

#endif
#if defined(SLI_SI917) || defined(SLI_SI915)
                                                  | SL_SI91X_EXT_FEAT_FRONT_END_SWITCH_PINS_ULP_GPIO_4_5_0
#endif
                                                  ),
                   .bt_feature_bit_map         = 0,
                   .ext_tcp_ip_feature_bit_map = (SL_SI91X_CONFIG_FEAT_EXTENTION_VALID | SL_SI91X_EXT_EMB_MQTT_ENABLE),
                   .ble_feature_bit_map        = 0,
                   .ble_ext_feature_bit_map    = 0,
                   .config_feature_bit_map = (SL_SI91X_FEAT_SLEEP_GPIO_SEL_BITMAP | SL_SI91X_ENABLE_ENHANCED_MAX_PSP) }
};
#if IS_ENABLE_BLE
/// @brief Remote wake-up configuration (ble mode)
static sl_wifi_device_configuration_t remote_wake_up_ble_cfg = {
  .boot_option = LOAD_NWP_FW,
  .mac_address = NULL,
  .band        = SL_SI91X_WIFI_BAND_2_4GHZ,
  .region_code = SL_WIFI_REGION_US,
  .boot_config = { .oper_mode = SL_SI91X_CLIENT_MODE,
                   .coex_mode = SL_SI91X_WLAN_BLE_MODE,
                   .feature_bit_map        = (SL_SI91X_FEAT_WPS_DISABLE | SL_SI91X_FEAT_ULP_GPIO_BASED_HANDSHAKE),
                   .tcp_ip_feature_bit_map = (SL_SI91X_TCP_IP_FEAT_DHCPV4_CLIENT | SL_SI91X_TCP_IP_FEAT_EXTENSION_VALID),
                   .custom_feature_bit_map = (SL_SI91X_CUSTOM_FEAT_EXTENTION_VALID),
                   .ext_custom_feature_bit_map = (SL_SI91X_EXT_FEAT_LOW_POWER_MODE | SL_SI91X_EXT_FEAT_XTAL_CLK
                                                  | SL_SI91X_EXT_FEAT_DISABLE_DEBUG_PRINTS | MEMORY_CONFIG
                                                  | SL_SI91X_EXT_FEAT_FRONT_END_SWITCH_PINS_ULP_GPIO_4_5_0
                                                  | SL_SI91X_EXT_FEAT_BT_CUSTOM_FEAT_ENABLE),
                   .bt_feature_bit_map         = (SL_SI91X_BT_RF_TYPE | SL_SI91X_ENABLE_BLE_PROTOCOL),
                   .ext_tcp_ip_feature_bit_map = (SL_SI91X_CONFIG_FEAT_EXTENTION_VALID | SL_SI91X_EXT_EMB_MQTT_ENABLE),
                   .ble_feature_bit_map =
                    ((SL_SI91X_BLE_MAX_NBR_PERIPHERALS(RSI_BLE_MAX_NBR_PERIPHERALS)
                    | SL_SI91X_BLE_MAX_NBR_CENTRALS(RSI_BLE_MAX_NBR_CENTRALS)
                    | SL_SI91X_BLE_MAX_NBR_ATT_SERV(RSI_BLE_MAX_NBR_ATT_SERV)
                    | SL_SI91X_BLE_MAX_NBR_ATT_REC(RSI_BLE_MAX_NBR_ATT_REC))
                    | SL_SI91X_FEAT_BLE_CUSTOM_FEAT_EXTENTION_VALID | SL_SI91X_BLE_PWR_INX(RSI_BLE_PWR_INX)
                    | SL_SI91X_BLE_PWR_SAVE_OPTIONS(RSI_BLE_PWR_SAVE_OPTIONS) | SL_SI91X_916_BLE_COMPATIBLE_FEAT_ENABLE
#if RSI_BLE_GATT_ASYNC_ENABLE
                    | SL_SI91X_BLE_GATT_ASYNC_ENABLE
#endif
                    ),
                   .ble_ext_feature_bit_map =
                    ((SL_SI91X_BLE_NUM_CONN_EVENTS(RSI_BLE_NUM_CONN_EVENTS)
                    | SL_SI91X_BLE_NUM_REC_BYTES(RSI_BLE_NUM_REC_BYTES))
#if RSI_BLE_INDICATE_CONFIRMATION_FROM_HOST
                    | SL_SI91X_BLE_INDICATE_CONFIRMATION_FROM_HOST //indication response from app
#endif
#if RSI_BLE_MTU_EXCHANGE_FROM_HOST
                    | SL_SI91X_BLE_MTU_EXCHANGE_FROM_HOST //MTU Exchange request initiation from app
#endif
#if RSI_BLE_SET_SCAN_RESP_DATA_FROM_HOST
                    | (SL_SI91X_BLE_SET_SCAN_RESP_DATA_FROM_HOST) //Set SCAN Resp Data from app
#endif
#if RSI_BLE_DISABLE_CODED_PHY_FROM_HOST
                    | (SL_SI91X_BLE_DISABLE_CODED_PHY_FROM_HOST) //Disable Coded PHY from app
#endif
#if BLE_SIMPLE_GATT
                    | SL_SI91X_BLE_GATT_INIT
#endif
                    ),
                   .config_feature_bit_map = (SL_SI91X_FEAT_SLEEP_GPIO_SEL_BITMAP | SL_SI91X_ENABLE_ENHANCED_MAX_PSP) }
};
#endif
#define SL_NET_DEFAULT_DHCP_CONFIG_INIT \
    { .min_discover_retry_interval = 3, .max_discover_retry_interval = 30, \
      .min_request_retry_interval = 3, .max_request_retry_interval = 30, \
      .max_discover_retries = 5, .max_request_retries = 5 }

static void sl_net_ensure_dhcp_config(sl_net_ip_configuration_t *ip)
{
    if (ip == NULL || ip->mode != SL_IP_MANAGEMENT_DHCP) {
        return;
    }
    if (ip->dhcp_config.max_discover_retries != 0 || ip->dhcp_config.max_request_retries != 0) {
        return;
    }
    ip->dhcp_config = (sl_net_dhcp_configuration_t)SL_NET_DEFAULT_DHCP_CONFIG_INIT;
}

/// @brief Default wifi client profile
static sl_net_wifi_client_profile_t wifi_client_profile = {
    .config = {
        .ssid.value = NETIF_WIFI_STA_DEFAULT_SSID,
        .ssid.length = sizeof(NETIF_WIFI_STA_DEFAULT_SSID) - 1,
        .channel.channel = SL_WIFI_AUTO_CHANNEL,
        .channel.band = SL_WIFI_AUTO_BAND,
        .channel.bandwidth = SL_WIFI_AUTO_BANDWIDTH,
        .bssid = {{0}},
        .bss_type = SL_WIFI_BSS_TYPE_INFRASTRUCTURE,
        .security = ((sizeof(NETIF_WIFI_STA_DEFAULT_PW) > 8) ? SL_WIFI_WPA_WPA2_MIXED : SL_WIFI_OPEN),
        .encryption = WIRELESS_DEFAULT_ENCRYPTION,
        .client_options = 0,
        .credential_id = ((sizeof(NETIF_WIFI_STA_DEFAULT_PW) > 8) ? SL_NET_DEFAULT_WIFI_CLIENT_CREDENTIAL_ID : SL_WIFI_NO_CREDENTIAL_ID),
    },
    .ip = {
        .mode = SL_IP_MANAGEMENT_DHCP,
        .type = SL_IPV4,
        .host_name = NULL,
        .ip = {
            .v4.ip_address.value = NETIF_WIFI_STA_DEFAULT_IP,
            .v4.gateway.value = NETIF_WIFI_STA_DEFAULT_GW,
            .v4.netmask.value = NETIF_WIFI_STA_DEFAULT_MASK
        },
        .dhcp_config = SL_NET_DEFAULT_DHCP_CONFIG_INIT,
    }
};
/// @brief Default wifi AP profile
static sl_net_wifi_ap_profile_t wifi_ap_profile = {
    .config = {
        .ssid.value = NETIF_WIFI_AP_DEFAULT_SSID,
        .ssid.length = sizeof(NETIF_WIFI_AP_DEFAULT_SSID) - 1,
        .channel.channel = SL_WIFI_AUTO_CHANNEL,
        .channel.band = SL_WIFI_AUTO_BAND,
        .channel.bandwidth = SL_WIFI_AUTO_BANDWIDTH,
        .security = ((sizeof(NETIF_WIFI_AP_DEFAULT_PW) > 8) ? SL_WIFI_WPA_WPA2_MIXED : SL_WIFI_OPEN),
        .encryption = WIRELESS_DEFAULT_ENCRYPTION,
        .options = 0,
        .credential_id = ((sizeof(NETIF_WIFI_AP_DEFAULT_PW) > 8) ? SL_NET_DEFAULT_WIFI_AP_CREDENTIAL_ID : SL_WIFI_NO_CREDENTIAL_ID),
        .keepalive_type = SL_SI91X_AP_NULL_BASED_KEEP_ALIVE,
        .beacon_interval = 100,
        .client_idle_timeout = 0xFF,
        .dtim_beacon_count = 3,
        .maximum_clients = NETIF_WIFI_AP_DEFAULT_CLIENT_NUM,
        .beacon_stop = 0,
        .is_11n_enabled = 0,
    },
    .ip = {
#if IS_TCP_IP_DUAL_MODE
        .mode = SL_IP_MANAGEMENT_STATIC_IP,
#else
        .mode = SL_IP_MANAGEMENT_LINK_LOCAL,
#endif
        .type = SL_IPV4,
        .host_name = NULL,
        .ip = {
            .v4.ip_address.value = NETIF_WIFI_AP_DEFAULT_IP,
            .v4.gateway.value = NETIF_WIFI_AP_DEFAULT_GW,
            .v4.netmask.value = NETIF_WIFI_AP_DEFAULT_MASK
        },
    }
};
/// @brief Default wifi client credential
static sl_net_wifi_psk_credential_entry_t wifi_client_credential = {    .type        = SL_NET_WIFI_PSK,
                                                                        .data_length = sizeof(NETIF_WIFI_STA_DEFAULT_PW) - 1,
                                                                        .data        = NETIF_WIFI_STA_DEFAULT_PW };
/// @brief Default wifi AP credential
static sl_net_wifi_psk_credential_entry_t wifi_ap_credential = {    .type        = SL_NET_WIFI_PSK,
                                                                    .data_length = sizeof(NETIF_WIFI_AP_DEFAULT_PW) - 1,
                                                                    .data        = NETIF_WIFI_AP_DEFAULT_PW };
/// @brief Default client network interface
struct netif client_netif = {
    .name = {NETIF_NAME_WIFI_STA[0], NETIF_NAME_WIFI_STA[1]},
};
/// @brief Default AP network interface
struct netif ap_netif = {
    .name = {NETIF_NAME_WIFI_AP[0], NETIF_NAME_WIFI_AP[1]},
};

/// @brief Identity MAC for user-visible derivation (default SSID etc.): the
///        burned factory MAC when present; otherwise the AP interface MAC.
///        The FW applies the boot-config MAC to the base (STA) address and
///        derives the concurrent AP as base+1, so ap_netif.hwaddr is NOT the
///        burned value. Uses the factory_wifi_mac RAM copy loaded once before
///        the first sl_net_init (sl_net_apply_factory_mac) — no NVS traffic
///        here; the pointer target doubles as the "burned and loaded" flag.
static void sl_net_identity_mac(uint8_t out[6])
{
    if (device_configuration.mac_address == &factory_wifi_mac)
        memcpy(out, factory_wifi_mac.octet, 6);
    else
        memcpy(out, ap_netif.hwaddr, 6);
}

#define SL_NET_EVENT_FIRMWARE_ERROR         (1 << 24)
#define SL_NET_EVENT_STA_DISCONNECTED       (1 << 23)
#define SL_NET_EVENT_STA_RECONNECTED        (1 << 22)
#define SL_NET_EVENT_CMD(cmd)               (1 << cmd)
#define SL_NET_EVENT_ALL                    (0x7FFFFFFF)
static osMutexId_t sl_net_mutex = NULL;
static osEventFlagsId_t sl_net_events = NULL;
static osThreadId_t sl_net_thread_ID = NULL;
static const osThreadAttr_t attr = {
    .name       = "sl_net_thread",
    .priority   = osPriorityRealtime5,
    .stack_mem  = 0,
    .stack_size = 4096,
    .cb_mem     = 0,
    .cb_size    = 0,
    .attr_bits  = 0u,
    .tz_module  = 0u,
};
static const sl_wifi_advanced_client_configuration_t default_client_configuration = {
    .max_retry_attempts     = 3,
    .scan_interval           = 3,
    .beacon_missed_count     = 40,
    .first_time_retry_enable = 1,
};
static const sl_wifi_scan_configuration_t ap_cnt_scan_cfg = { 
    .type = SL_WIFI_SCAN_TYPE_ADV_SCAN,
    .flags = 0,
    .periodic_scan_interval = 20,
    .channel_bitmap_2g4     = 0xFFFF,
    .channel_bitmap_5g      = { 
        0xFFFFFFFF,
        0xFFFFFFFF,
        0xFFFFFFFF,
        0xFFFFFFFF,
        0xFFFFFFFF,
        0xFFFFFFFF,
        0xFFFFFFFF,
        0xFFFFFFFF 
    }, 
    .lp_mode = 0
};
// #define DEFAULT_SCAN_TYPE SL_WIFI_SCAN_TYPE_ACTIVE
#define DEFAULT_SCAN_TYPE SL_WIFI_SCAN_TYPE_EXTENDED
#if DEFAULT_SCAN_TYPE == SL_WIFI_SCAN_TYPE_EXTENDED
#define DEFAULT_SCAN_RESULT_MAX 64
static sl_wifi_scan_type_t now_scan_type = SL_WIFI_SCAN_TYPE_EXTENDED;
static sl_wifi_extended_scan_result_t default_scan_results[DEFAULT_SCAN_RESULT_MAX] = {0};
static sl_wifi_extended_scan_result_parameters_t default_scan_result_parameters = { 
    .scan_results = default_scan_results,
    .array_length = DEFAULT_SCAN_RESULT_MAX,
    .result_count = NULL,
    .channel_filter = NULL,
    .security_mode_filter = NULL,
    .rssi_filter = NULL,
    .network_type_filter = NULL
};
#endif
static const sl_wifi_scan_configuration_t default_wifi_scan_cfg = { 
    .type  = DEFAULT_SCAN_TYPE,
    .flags = 0,
    .periodic_scan_interval = 0,
    .channel_bitmap_2g4     = 0xFFFF,
    .channel_bitmap_5g      = { 
        0xFFFFFFFF,
        0xFFFFFFFF,
        0xFFFFFFFF,
        0xFFFFFFFF,
        0xFFFFFFFF,
        0xFFFFFFFF,
        0xFFFFFFFF,
        0xFFFFFFFF 
    }, 
    .lp_mode = 0
};
static const sl_wifi_advanced_scan_configuration_t advanced_scan_configuration = {
    .active_channel_time = SL_WIFI_DEFAULT_ACTIVE_CHANNEL_SCAN_TIME,
    .passive_channel_time = SL_WIFI_DEFAULT_PASSIVE_CHANNEL_SCAN_TIME,
    .trigger_level = -40,
    .trigger_level_change = 5,
    .enable_multi_probe = 1,
    .enable_instant_scan = 0
};
static uint8_t sl_net_is_recovering = 0;
static sl_net_wakeup_mode_t remote_wakeup_mode = WAKEUP_MODE_NORMAL;
static int global_scan_result_count = 0;
static osSemaphoreId_t wifi_scan_sem = NULL;
static wireless_scan_result_t wifi_storage_scan_result = {0};
static uint8_t sl_net_async_scan_restore_sta = 0;
static uint8_t sl_net_async_scan_restore_ap = 0;
#define SL_NET_SCAN_DISCONNECT_SETTLE_MS  300
static uint8_t sl_net_get_channel_from_scan_result(const char *ssid, size_t length);

static sl_status_t sl_net_client_scan_callback_handler(sl_wifi_event_t event,
                                                       sl_wifi_scan_result_t *result,
                                                       uint32_t result_length,
                                                       void *arg);

static void sl_net_scan_async_restore_links(void)
{
    uint8_t try_times = 0;
    int tmp_ret = 0;

    if (!sl_net_async_scan_restore_sta && !sl_net_async_scan_restore_ap) {
        return;
    }
    if (sl_net_async_scan_restore_ap) {
        try_times = 0;
        do {
            tmp_ret = sl_net_ap_netif_up();
        } while (tmp_ret != SL_STATUS_OK && try_times++ < 3);
    }
    if (sl_net_async_scan_restore_sta) {
        try_times = 0;
        do {
            tmp_ret = sl_net_client_netif_up();
        } while (tmp_ret != SL_STATUS_OK && try_times++ < 3);
    }
    sl_net_async_scan_restore_sta = 0;
    sl_net_async_scan_restore_ap = 0;
}

static sl_status_t sl_net_prepare_extended_scan(void *scan_arg)
{
    sl_status_t status = sl_wifi_set_advanced_scan_configuration(&advanced_scan_configuration);
    if (status != SL_STATUS_OK) {
        return status;
    }
    sl_wifi_set_scan_callback(sl_net_client_scan_callback_handler, scan_arg);
    if (wifi_scan_sem != NULL) {
        (void)osSemaphoreAcquire(wifi_scan_sem, 0);
    }
    now_scan_type = SL_WIFI_SCAN_TYPE_EXTENDED;
    return sl_wifi_start_scan(SL_WIFI_CLIENT_INTERFACE, NULL, &default_wifi_scan_cfg);
}

static int sl_net_acquire_scan_results(uint32_t timeout_ms)
{
    if (wifi_scan_sem == NULL) {
        return SL_STATUS_FAIL;
    }
    if (osSemaphoreAcquire(wifi_scan_sem, timeout_ms) != osOK) {
        return SL_STATUS_TIMEOUT;
    }
    return (wifi_storage_scan_result.scan_count > 0) ? SL_STATUS_OK : SL_STATUS_FAIL;
}

static void sl_net_pause_links_for_scan(bool sta_link_up, bool ap_link_up)
{
    sl_wifi_channel_t channel = { 0 };

    if (ap_link_up) {
        if (sl_wifi_get_channel(SL_WIFI_AP_2_4GHZ_INTERFACE, &channel) == SL_STATUS_OK) {
            wifi_ap_profile.config.channel.channel = channel.channel;
        }
        sl_net_ap_netif_down();
    }
    /* STA on one channel: full client netif down before multi-channel EXTENDED scan.
     * WC 4.x ADV_SCAN does not return results to host on SI917; use EXTENDED instead. */
    if (sta_link_up) {
        (void)sl_net_client_netif_down();
        osDelay(SL_NET_SCAN_DISCONNECT_SETTLE_MS);
    }
}

static void sl_net_restore_links_after_scan(bool sta_link_up, bool ap_link_up)
{
    uint8_t try_times = 0;
    int tmp_ret = 0;

    if (ap_link_up) {
        try_times = 0;
        do {
            tmp_ret = sl_net_ap_netif_up();
        } while (tmp_ret != SL_STATUS_OK && try_times++ < 3);
    }
    if (sta_link_up) {
        try_times = 0;
        do {
            tmp_ret = sl_net_client_netif_up();
        } while (tmp_ret != SL_STATUS_OK && try_times++ < 3);
    }
}

/// @brief Network interface low-level data input processing function
/// @param netif Network interface
/// @param b Data pointer
/// @param len Length
static void sl_net_low_level_input(struct netif *netif, uint8_t *b, uint16_t len)
{
    struct pbuf *p = NULL, *q = NULL;
    uint32_t bufferoffset = 0;
    err_t ret = ERR_OK;

    if (len <= 0) return;
    if (len < NETIF_LWIP_FRAME_ALIGNMENT) len = NETIF_LWIP_FRAME_ALIGNMENT;

    // Drop packets originated from the same interface and is not destined for the said interface
#if LWIP_IPV6
    const uint8_t *src_mac = b + netif->hwaddr_len;
    const uint8_t *dst_mac = b;
#endif

#if LWIP_IPV6
    if (!(ip6_addr_ispreferred(netif_ip6_addr_state(netif, 0)))
        && (memcmp(netif->hwaddr, src_mac, netif->hwaddr_len) == 0)
        && (memcmp(netif->hwaddr, dst_mac, netif->hwaddr_len) != 0)) {
            LOG_DRV_DEBUG(NETIF_NAME_STR_FMT ": DROP, [" NETIF_MAC_STR_FMT "]<-[" NETIF_MAC_STR_FMT "] type=%02x%02x\r\n", 
                            NETIF_NAME_PARAMETER(netif), NETIF_MAC_PARAMETER(dst_mac), NETIF_MAC_PARAMETER(src_mac), b[12], b[13]);
        return;
    }
#endif

    /* We allocate a pbuf chain of pbufs from the Lwip buffer pool
    * and copy the data to the pbuf chain
    */
    if ((p = pbuf_alloc(PBUF_RAW, len, PBUF_POOL)) != ((struct pbuf *)0)) {
        for (q = p, bufferoffset = 0; q != NULL; q = q->next) {
            memcpy((uint8_t *)q->payload, (uint8_t *)b + bufferoffset, q->len);
            bufferoffset += q->len;
        }
        ret = netif->input(p, netif);
        if (ret != ERR_OK) {
            pbuf_free(p);
            osDelay(5);
            // LOG_DRV_ERROR(NETIF_NAME_STR_FMT ":Input failed(ret = %d)!\r\n", NETIF_NAME_PARAMETER(netif), ret);
        }
    } else {
        LOG_DRV_ERROR(NETIF_NAME_STR_FMT ": Failed to allocate pbuf!\r\n", NETIF_NAME_PARAMETER(netif));
    }
}
/// @brief Network interface low-level data output function
/// @param netif Network interface
/// @param p Data buffer
/// @return Error code
// A wedged host<->NWP pipe fails raw TX with SL_STATUS_ALLOCATION_FAILED
// (0x19): the CE_DATA_POOL never frees, each send waits 1s for a buffer. Unlike
// a dead NWP this never reaches the C1/C2 handshake timeout, so
// sli_firmware_error_callback (the only recovery trigger) never fires and the
// wedge persists until reboot (field log: 14h outage).
// ponytail: the first detector here counted CONSECUTIVE 0x19s and reset on any
// OK — but a half-wedged pool leaks blocks back one at a time (the HAL thread
// frees each TX block right after its bus-write attempt, even when the write
// fails), so interleaved OKs kept the streak under the threshold forever
// (field log 2026_09_01: 128 x 0x19 over ~5 min, zero recovery). The two
// detectors below deliberately use different criteria:
//   - 0x19: DENSITY over a 60s window (OKs ignored — alloc-OK is fake under a
//     wedge). Covers a backed-up pool whatever the cause: write failures, slow
//     writes that still succeed, firmware flow control.
//   - bus-write failures: CONSECUTIVE count with no window, reset by a REAL bus
//     write success. Covers "chip stopped accepting frames" at any traffic
//     rate — a density window would starve on idle traffic (ARP/keepalive only,
//     a few packets per minute). Earliest hard-death signal; fires before the
//     pool has fully backed up.
// Single-writer safe: lwIP calls linkoutput only from tcpip_thread; the bus
// feed arrives only on the SDK hal thread.
#define SL_NET_TX_WEDGE_WINDOW_MS 60000u ///< 0x19 failure-density window
#define SL_NET_TX_WEDGE_THRESHOLD 10     ///< 0x19 (pool alloc) failures per window
static uint32_t sl_net_tx_wedge_count        = 0;
static uint32_t sl_net_tx_wedge_window_start = 0;

/// Density window in ticks (osKernelGetTickCount domain).
static uint32_t sl_net_wedge_window_ticks(void)
{
    return (uint32_t)((SL_NET_TX_WEDGE_WINDOW_MS * osKernelGetTickFreq()) / 1000u);
}

/// Restart the density window when it has expired.
static bool sl_net_wedge_window_expired(uint32_t now, uint32_t window_start)
{
    return (uint32_t)(now - window_start) > sl_net_wedge_window_ticks();
}

/// Fire the firmware-recovery event once a detector has tripped.
/// window_ms == 0 means a consecutive-failure detector (no time window).
static void sl_net_tx_wedge_trigger(const char *source, uint32_t fail_count, uint32_t window_ms)
{
    if (sl_net_events == NULL) return;
    if (remote_wakeup_mode != WAKEUP_MODE_NORMAL) {
        // same guard as sli_firmware_error_callback; log it — a silently
        // swallowed trigger is an investigation dead end.
        LOG_DRV_ERROR("%s: %u TX failures%s, recovery suppressed (wakeup mode %d)\r\n",
                      source, fail_count, window_ms ? " in window" : " in a row",
                      remote_wakeup_mode);
        return;
    }
    LOG_DRV_ERROR("%s: %u TX failures%s, triggering firmware recovery\r\n",
                  source, fail_count, window_ms ? " in window" : " in a row");
    osEventFlagsSet(sl_net_events, SL_NET_EVENT_FIRMWARE_ERROR);
}

static void sl_net_tx_failure_escalate(sl_status_t status)
{
    uint32_t now = osKernelGetTickCount();
    if (status != SL_STATUS_ALLOCATION_FAILED) {
        return; // density signal: successes no longer reset the count
    }
    if (sl_net_wedge_window_expired(now, sl_net_tx_wedge_window_start)) {
        sl_net_tx_wedge_count        = 0;
        sl_net_tx_wedge_window_start = now;
    }
    if (++sl_net_tx_wedge_count < SL_NET_TX_WEDGE_THRESHOLD) return;
    sl_net_tx_wedge_trigger("raw TX pool", sl_net_tx_wedge_count, SL_NET_TX_WEDGE_WINDOW_MS);
    sl_net_tx_wedge_count        = 0;
    sl_net_tx_wedge_window_start = now;
}

/// @brief Real bus-write result for LWIP/transceiver RAW data packets, fed from
///        the SDK DATA-packet TX status handler on the HAL thread
///        (sli_si91x_wifi_command_engine_config.c). A failure here means the
///        chip never received the frame (wakeup failed / BUS_WRITE_ERROR).
// ponytail: CONSECUTIVE count, no density window. A window starves on idle
// traffic — an idle box doing only ARP/keepalive emits a few packets per minute
// and can never reach N-failures/60s even with a dead chip (the field 0x19 log
// only reached density because an MQTT reconnect storm fed it samples). Unlike
// the 0x19 detector, the OK here is REAL (the bus write genuinely succeeded),
// so a success may legitimately prove the pipe alive and reset the streak.
// 5 consecutive write failures = the chip stopped accepting frames, at any
// traffic rate.
#define SL_NET_BUSFAIL_THRESHOLD 5
static uint32_t sl_net_busfail_streak = 0;
void sl_net_notify_bus_tx_failure(sl_status_t status)
{
    if (status == SL_STATUS_OK) {
        sl_net_busfail_streak = 0; // real bus write succeeded — pipe alive
        return;
    }
    if (++sl_net_busfail_streak < SL_NET_BUSFAIL_THRESHOLD) return;
    sl_net_tx_wedge_trigger("bus write", sl_net_busfail_streak, 0);
    sl_net_busfail_streak = 0;
}
static err_t sl_net_low_level_output(struct netif *netif, struct pbuf *p)
{
    struct pbuf *q = NULL;
    uint8_t *out_buf = NULL, *out_ptr = NULL;
    sl_status_t status = SL_STATUS_OK;

    // printf("LWIP TX len : %d / %d\r\n", p->len, p->tot_len);
    if (p->len != p->tot_len) {
        out_buf = hal_mem_alloc_fast(p->tot_len);
        if (out_buf != NULL) {
            out_ptr = out_buf;
            for (q = p; q != NULL; q = q->next) {
                memcpy(out_ptr, q->payload, q->len);
                out_ptr += q->len;
            }
            if (netif == &client_netif) status = sl_wifi_send_raw_data_frame(SL_WIFI_CLIENT_INTERFACE, out_buf, p->tot_len);
            else status = sl_wifi_send_raw_data_frame(SL_WIFI_AP_INTERFACE, out_buf, p->tot_len);
            hal_mem_free(out_buf);
            sl_net_tx_failure_escalate(status);
            if (status != SL_STATUS_OK) {
                LOG_DRV_ERROR(NETIF_NAME_STR_FMT ": Failed to send data frame: 0x%0lX.\r\n", NETIF_NAME_PARAMETER(netif), status);
                return ERR_IF;
            }
            return ERR_OK;
        }
    }
    for (q = p; q != NULL; q = q->next) {
        // printf("LWIP TX len : %d\r\n", q->len);
        if (netif == &client_netif) status = sl_wifi_send_raw_data_frame(SL_WIFI_CLIENT_INTERFACE, (uint8_t *)q->payload, q->len);
        else status = sl_wifi_send_raw_data_frame(SL_WIFI_AP_INTERFACE, (uint8_t *)q->payload, q->len);
        sl_net_tx_failure_escalate(status);
        if (status != SL_STATUS_OK) {
            LOG_DRV_ERROR(NETIF_NAME_STR_FMT ": Failed to send data frame: 0x%0lX.\r\n", NETIF_NAME_PARAMETER(netif), status);
            return ERR_IF;
        }
    }
    return ERR_OK;
}
/// @brief Network interface low-level initialization function
/// @param netif Network interface to initialize
static err_t sl_net_ethernetif_init(struct netif *netif)
{
    sl_status_t status = SL_STATUS_OK;
    sl_mac_address_t mac_addr = {0};
    sl_wifi_interface_t interface = SL_WIFI_CLIENT_INTERFACE;

    if (netif == NULL) return ERR_ARG;
    if (netif == &ap_netif) interface = SL_WIFI_AP_INTERFACE;

    // set netif MAC hardware address length
    netif->hwaddr_len = ETH_HWADDR_LEN;
    // Request MAC address
    status = sl_wifi_get_mac_address(interface, &mac_addr);
    if (status != SL_STATUS_OK) {
        LOG_DRV_ERROR(NETIF_NAME_STR_FMT ": Get MAC address failed(status = 0x%lX)!\r\n", NETIF_NAME_PARAMETER(netif), status);
        return ERR_IF;
    }
    // Config diy mac
    if (NETIF_MAC_IS_UNICAST(netif->hwaddr) && memcmp(netif->hwaddr, mac_addr.octet, netif->hwaddr_len)) {
        memcpy(mac_addr.octet, netif->hwaddr, netif->hwaddr_len);
        status = sl_wifi_set_mac_address(interface, &mac_addr);
        if (status != SL_STATUS_OK) {
            LOG_DRV_ERROR(NETIF_NAME_STR_FMT ": Set MAC address failed(status = 0x%lX)!\r\n", NETIF_NAME_PARAMETER(netif), status);
            return ERR_IF;
        }
    } else memcpy(netif->hwaddr, mac_addr.octet, netif->hwaddr_len);
    LOG_DRV_DEBUG(NETIF_NAME_STR_FMT ": MAC Address: " NETIF_MAC_STR_FMT "\r\n", NETIF_NAME_PARAMETER(netif), NETIF_MAC_PARAMETER(netif->hwaddr));
    
#if LWIP_NETIF_HOSTNAME
    /* Initialize interface hostname */
    if (interface == SL_WIFI_CLIENT_INTERFACE) netif->hostname = wifi_client_profile.ip.host_name;
    else if (interface == SL_WIFI_AP_INTERFACE) netif->hostname = wifi_ap_profile.ip.host_name;
    else netif->hostname = "LWIP_DEV";
#endif /* LWIP_NETIF_HOSTNAME */

    //! Assign handler/function for the interface
#if LWIP_IPV4 && LWIP_ARP
    netif->output = etharp_output;
#endif /* #if LWIP_IPV4 && LWIP_ARP */
#if LWIP_IPV6 && LWIP_ETHERNET
    netif->output_ip6 = ethip6_output;
#endif /* LWIP_IPV6 && LWIP_ETHERNET */
    netif->linkoutput = sl_net_low_level_output;

    // set netif maximum transfer unit
    netif->mtu = NETIF_MAX_TRANSFER_UNIT;

    if (interface == SL_WIFI_CLIENT_INTERFACE) {
        // Accept broadcast address and ARP traffic
        netif->flags = NETIF_FLAG_BROADCAST | NETIF_FLAG_ETHARP | NETIF_FLAG_IGMP;
    } else if (interface == SL_WIFI_AP_INTERFACE) {
        // Accept broadcast address
        netif->flags = NETIF_FLAG_BROADCAST | NETIF_FLAG_ETHARP;
#if IS_SELF_DHCP_SERVER
        netif->flags |= NETIF_FLAG_IGMP;
#endif
    }
#if LWIP_IPV6_MLD
    netif->flags |= NETIF_FLAG_MLD6;
#endif /* LWIP_IPV6_MLD */

    return ERR_OK;
}
/// @brief MACRAW data processing function provided for SL SDK calls
sl_status_t sl_si91x_host_process_data_frame(sl_wifi_interface_t interface, sl_wifi_buffer_t *buffer)
{
    void *packet;
    const uint8_t *dst_mac;
//    struct netif *ifp;
    sl_si91x_packet_t *rsi_pkt;

    packet = sl_si91x_host_get_buffer_data(buffer, 0, NULL);
    if (packet == NULL) return SL_STATUS_FAIL;
    rsi_pkt = (sl_si91x_packet_t *)packet;

    dst_mac = rsi_pkt->data;
    // printf("LWIP RX len : %d\r\n", rsi_pkt->length);
    // printf(NETIF_MAC_STR_FMT" -> "NETIF_MAC_STR_FMT"\r\n", NETIF_MAC_PARAMETER((dst_mac + 6)), NETIF_MAC_PARAMETER(dst_mac));
    if (NETIF_MAC_IS_MULTICAST(dst_mac) || NETIF_MAC_IS_BROADCAST(dst_mac)) {
        if (netif_is_link_up(&client_netif)) sl_net_low_level_input(&client_netif, rsi_pkt->data, rsi_pkt->length);
        if (netif_is_link_up(&ap_netif)) sl_net_low_level_input(&ap_netif, rsi_pkt->data, rsi_pkt->length);
    } else {
        if (memcmp(dst_mac, client_netif.hwaddr, client_netif.hwaddr_len) == 0 && netif_is_link_up(&client_netif)) sl_net_low_level_input(&client_netif, rsi_pkt->data, rsi_pkt->length);
        else if (memcmp(dst_mac, ap_netif.hwaddr, ap_netif.hwaddr_len) == 0 && netif_is_link_up(&ap_netif)) sl_net_low_level_input(&ap_netif, rsi_pkt->data, rsi_pkt->length);
    }
    
    return SL_STATUS_OK;
}

/****************************************************************************************/
/********************************** WIFI CLIENT NETIF ***********************************/
/****************************************************************************************/
/// @brief Client initialization function implementation provided for SL SDK calls
sl_status_t sl_net_wifi_client_init(sl_net_interface_t interface,
                                    const void *configuration,
                                    void *context,
                                    sl_net_event_handler_t event_handler)
{
    sl_status_t status;
#if IS_ENABLE_NWP_DEBUG_PRINTS
    sl_si91x_assertion_t debug_config = { 0 };
#endif

    UNUSED_PARAMETER(interface);
    UNUSED_PARAMETER(event_handler);
    UNUSED_PARAMETER(context);
    if (configuration != NULL) {
        const sl_wifi_device_configuration_t *cfg = (const sl_wifi_device_configuration_t *)configuration;
        dual_mode_enabled   = (cfg->boot_config.ext_tcp_ip_feature_bit_map & SL_SI91X_EXT_TCP_IP_DUAL_MODE_ENABLE) != 0;
        bypass_mode_enabled = (cfg->boot_config.tcp_ip_feature_bit_map & SL_SI91X_TCP_IP_FEAT_BYPASS) != 0;
    }
    status = sl_wifi_init(configuration, NULL, sl_wifi_default_event_handler);
    if (status == SL_STATUS_ALREADY_INITIALIZED
        && configuration != NULL
        && ((const sl_wifi_device_configuration_t *)configuration)->boot_config.oper_mode == SL_SI91X_CONCURRENT_MODE) {
        return SL_STATUS_OK;
    }
#if IS_ENABLE_NWP_DEBUG_PRINTS
    else if (status == SL_STATUS_OK) {
        debug_config.assert_level = SL_SI91X_ASSERTION_LEVEL_MAX;
        debug_config.assert_type = SL_SI91X_ASSERTION_TYPE_ALL; 

        status = sl_si91x_debug_log(&debug_config);
        if (status != SL_STATUS_OK) {
            LOG_DRV_ERROR("Failed to enable debug prints: 0x%lX\r\n", status);
            return status;
        }
        printf("Si91x debug prints enabled\r\n");
    }
#endif
    return status;
}
/// @brief Client deinitialization function implementation provided for SL SDK calls
sl_status_t sl_net_wifi_client_deinit(sl_net_interface_t interface)
{
    UNUSED_PARAMETER(interface);
    return sl_wifi_deinit();
}
/// @brief Activate client link
static int sl_net_set_client_link_up(sl_net_wifi_client_profile_t *profile)
{
    err_t err = ERR_OK;
#if !IS_TCP_IP_DUAL_MODE
    int event_flag = 0;
    uint32_t timeout_ms = 0;
#endif

    err = netifapi_netif_set_up(&client_netif);
    if (err != ERR_OK) return err;
    err = netifapi_netif_set_link_up(&client_netif);
    if (err != ERR_OK) {
        netifapi_netif_set_down(&client_netif);
        return err;
    }

#if IS_TCP_IP_DUAL_MODE
    ip_addr_t ipaddr  = { 0 };
    ip_addr_t gateway = { 0 };
    ip_addr_t netmask = { 0 };
    uint8_t *address = &(profile->ip.ip.v4.ip_address.bytes[0]);
    IP4_ADDR(&ipaddr, address[0], address[1], address[2], address[3]);
    address = &(profile->ip.ip.v4.gateway.bytes[0]);
    IP4_ADDR(&gateway, address[0], address[1], address[2], address[3]);
    address = &(profile->ip.ip.v4.netmask.bytes[0]);
    IP4_ADDR(&netmask, address[0], address[1], address[2], address[3]);
    err = netifapi_netif_set_addr(&client_netif,
                                    &ipaddr,
                                    &netmask,
                                    &gateway);
    LOG_DRV_DEBUG(NETIF_NAME_STR_FMT " ip: %s\r\n", NETIF_NAME_PARAMETER(&client_netif), ip4addr_ntoa((const ip4_addr_t *)&client_netif.ip_addr));
#else
    if (SL_IP_MANAGEMENT_STATIC_IP == profile->ip.mode) {
#if LWIP_IPV4 && LWIP_IPV6
        ip_addr_t ipaddr  = { 0 };
        ip_addr_t gateway = { 0 };
        ip_addr_t netmask = { 0 };

        if ((profile->ip.type & SL_IPV4) == SL_IPV4) {
            uint8_t *address = &(profile->ip.ip.v4.ip_address.bytes[0]);
            IP4_ADDR(&ipaddr, address[0], address[1], address[2], address[3]);
            address = &(profile->ip.ip.v4.gateway.bytes[0]);
            IP4_ADDR(&gateway, address[0], address[1], address[2], address[3]);
            address = &(profile->ip.ip.v4.netmask.bytes[0]);
            IP4_ADDR(&netmask, address[0], address[1], address[2], address[3]);

            err = netifapi_netif_set_addr(&client_netif,
                                    &ipaddr,
                                    &netmask,
                                    &gateway);
        }
        if ((profile->ip.type & SL_IPV6) == SL_IPV6) {
            uint32_t *address = &(profile->ip.ip.v6.link_local_address.value[0]);
            IP6_ADDR(&ipaddr.u_addr.ip6, address[0], address[1], address[2], address[3]);
            address = &(profile->ip.ip.v6.global_address.value[0]);
            IP6_ADDR(&gateway.u_addr.ip6, address[0], address[1], address[2], address[3]);
            address = &(profile->ip.ip.v6.gateway.value[0]);
            IP6_ADDR(&netmask.u_addr.ip6, address[0], address[1], address[2], address[3]);

            netif_ip6_addr_set(&client_netif, 0, &ipaddr.u_addr.ip6);
            netif_ip6_addr_set(&client_netif, 1, &gateway.u_addr.ip6);
            netif_ip6_addr_set(&client_netif, 2, &netmask.u_addr.ip6);
            
            netif_ip6_addr_set_state(&client_netif, 0, IP6_ADDR_PREFERRED);
            netif_ip6_addr_set_state(&client_netif, 1, IP6_ADDR_PREFERRED);
            netif_ip6_addr_set_state(&client_netif, 2, IP6_ADDR_PREFERRED);
        }
#elif LWIP_IPV4
        ip4_addr_t ipaddr  = { 0 };
        ip4_addr_t gateway = { 0 };
        ip4_addr_t netmask = { 0 };
        uint8_t *address   = &(profile->ip.ip.v4.ip_address.bytes[0]);

        IP4_ADDR(&ipaddr, address[0], address[1], address[2], address[3]);
        address = &(profile->ip.ip.v4.gateway.bytes[0]);
        IP4_ADDR(&gateway, address[0], address[1], address[2], address[3]);
        address = &(profile->ip.ip.v4.netmask.bytes[0]);
        IP4_ADDR(&netmask, address[0], address[1], address[2], address[3]);

        err = netifapi_netif_set_addr(&client_netif, &ipaddr, &netmask, &gateway);
        LOG_DRV_DEBUG(NETIF_NAME_STR_FMT " static ip: %s\r\n", NETIF_NAME_PARAMETER(&client_netif), ip4addr_ntoa((const ip4_addr_t *)&client_netif.ip_addr));
#elif LWIP_IPV6
        ip6_addr_t link_local_address = { 0 };
        ip6_addr_t global_address     = { 0 };
        ip6_addr_t gateway            = { 0 };
        uint32_t *address             = &(profile->ip.ip.v6.link_local_address.value[0]);

        IP6_ADDR(&link_local_address, address[0], address[1], address[2], address[3]);
        address = &(profile->ip.ip.v6.global_address.value[0]);
        IP6_ADDR(&global_address, address[0], address[1], address[2], address[3]);
        address = &(profile->ip.ip.v6.gateway.value[0]);
        IP6_ADDR(&gateway, address[0], address[1], address[2], address[3]);
        netif_ip6_addr_set(&client_netif, 0, &link_local_address);
        netif_ip6_addr_set(&client_netif, 1, &global_address);
        netif_ip6_addr_set(&client_netif, 2, &gateway);

        netif_ip6_addr_set_state(&client_netif, 0, IP6_ADDR_PREFERRED);
        netif_ip6_addr_set_state(&client_netif, 1, IP6_ADDR_PREFERRED);
        netif_ip6_addr_set_state(&client_netif, 2, IP6_ADDR_PREFERRED);
#endif /* LWIP_IPV6 */
    } else if (SL_IP_MANAGEMENT_DHCP == profile->ip.mode) {
#if LWIP_IPV4 && LWIP_DHCP
        ip_addr_set_zero_ip4(&(client_netif.ip_addr));
        ip_addr_set_zero_ip4(&(client_netif.netmask));
        ip_addr_set_zero_ip4(&(client_netif.gw));

        osEventFlagsClear(sl_net_events, SL_NET_EVENT_FIRMWARE_ERROR);
        err = netifapi_dhcp_start(&client_netif);
        if (err == ERR_OK) {
            timeout_ms = 0;
            do {
                if (dhcp_supplied_address(&client_netif)) {
                    LOG_DRV_DEBUG(NETIF_NAME_STR_FMT " dhcp ip: %s\r\n", NETIF_NAME_PARAMETER(&client_netif), ip4addr_ntoa((const ip4_addr_t *)&client_netif.ip_addr));
                    break;
                }
                if (timeout_ms < NETIF_WIFI_STA_DEFAULT_DHCP_TIMEOUT) {
                    osDelay(100);
                    timeout_ms += 100;
                } else err = ERR_TIMEOUT;
                event_flag = (int)osEventFlagsWait(sl_net_events, SL_NET_EVENT_FIRMWARE_ERROR, osFlagsWaitAny | osFlagsNoClear, 0);
                if (event_flag > 0 && event_flag & SL_NET_EVENT_FIRMWARE_ERROR) err = ERR_IF;
            } while (err == ERR_OK);
        }
#endif /* LWIP_IPV4 && LWIP_DHCP */
        /*
        * Enable DHCPv6 with IPV6
        */

        // Stateless DHCPv6
#if LWIP_IPV6 && LWIP_IPV6_AUTOCONFIG
        // Automatically configure global addresses from Router Advertisements
        netif_set_ip6_autoconfig_enabled(&client_netif, 1);
        // Create and set the link-local address
        netif_create_ip6_linklocal_address(&client_netif, MAC_48_BIT_SET);
        LOG_DRV_DEBUG("IPv6 Address %s\r\n", ip6addr_ntoa(netif_ip6_addr(&client_netif, 0)));
        
        timeout_ms = 0;
        do {
            if (ip6_addr_ispreferred(netif_ip6_addr_state(&client_netif, 0))) {
                LOG_DRV_DEBUG("IPv6 Address %s\r\n", ip6addr_ntoa(netif_ip6_addr(&client_netif, 0)));
                break;
            }
            if (timeout_ms < NETIF_WIFI_STA_DEFAULT_DHCP_TIMEOUT) {
                osDelay(100);
                timeout_ms += 100;
            } else err = ERR_TIMEOUT;
        } while (err == ERR_OK)
#endif /* LWIP_IPV6 && LWIP_IPV6_AUTOCONFIG */
    }
#endif 

    if (err != ERR_OK) {
#if LWIP_IPV4 && LWIP_DHCP && !IS_TCP_IP_DUAL_MODE
        (void)netifapi_dhcp_stop(&client_netif);
#endif /* LWIP_IPV4 && LWIP_DHCP && !IS_TCP_IP_DUAL_MODE */
        netifapi_netif_set_link_down(&client_netif);
        netifapi_netif_set_down(&client_netif);
        return err;
    }
    return err;
}
/// @brief Client network interface activation provided for SL SDK calls
sl_status_t sl_net_wifi_client_up(sl_net_interface_t interface, sl_net_profile_id_t profile_id)
{
    // uint8_t cnt_try_times = 0;
    err_t err = ERR_OK;
    sl_status_t status = 0;

    // Load profile and connect here
    // sl_net_wifi_client_profile_t profile = { 0 };

    // status = sl_net_get_profile(SL_NET_WIFI_CLIENT_INTERFACE, profile_id, &profile);
    // if (status != SL_STATUS_OK) {
    //     LOG_DRV_DEBUG("Failed to get client profile: 0x%0lX\r\n", status);
    //     return status;
    // }

    status = sl_net_set_profile(SL_NET_WIFI_CLIENT_INTERFACE, profile_id, &wifi_client_profile);
    if (status != SL_STATUS_OK) {
        // sl_net_deinit(SL_NET_WIFI_CLIENT_INTERFACE);
        LOG_DRV_ERROR("Failed to set client profile: 0x%lX\r\n", status);
        return status;
    }

    if (wifi_client_profile.config.security != SL_WIFI_OPEN) {
        status = sl_net_set_credential(SL_NET_DEFAULT_WIFI_CLIENT_CREDENTIAL_ID,
                                        wifi_client_credential.type,
                                        &wifi_client_credential.data,
                                        wifi_client_credential.data_length);
        if (status != SL_STATUS_OK) {
            // sl_net_deinit(SL_NET_WIFI_CLIENT_INTERFACE);
            LOG_DRV_ERROR("Failed to set client credentials: 0x%lX\r\n", status);
            return status;
        }
    }
    
    status = sl_wifi_set_advanced_client_configuration(SL_WIFI_CLIENT_INTERFACE, &default_client_configuration);
    if (status != SL_STATUS_OK) {
        LOG_DRV_ERROR("Failed to set advanced client configuration: 0x%0lX\r\n", status);
        return status;
    }

    /* Set join feature bitmap */
    uint8_t join_feature_bitmap = 0;
    sl_si91x_get_join_configuration(SL_WIFI_CLIENT_INTERFACE, &join_feature_bitmap);
    join_feature_bitmap |= SL_WIFI_JOIN_FEAT_QUICK_JOIN;
    sl_si91x_set_join_configuration(SL_WIFI_CLIENT_INTERFACE, join_feature_bitmap);

    // do {
        status = sl_wifi_connect(SL_WIFI_CLIENT_INTERFACE, &wifi_client_profile.config, 18000);
    // } while (status != SL_STATUS_OK && cnt_try_times++ < 3);
    if (status != SL_STATUS_OK) {
        sl_wifi_disconnect(SL_WIFI_CLIENT_INTERFACE);
        LOG_DRV_ERROR("Failed to connect to Wi-Fi: 0x%0lX\r\n", status);
        return status;
    }

#if IS_TCP_IP_DUAL_MODE
    {
        /* fw-compat diagnostic: a clean 0x07 (SL_STATUS_TIMEOUT, no bit16)
         * here means the HOST-side response wait was aborted — firmware
         * errors always come back as 0x1000X. Elapsed time separates an
         * instant rejection (transport) from a delayed abort (matching). */
        uint32_t ip_cfg_start = osKernelGetTickCount();
        if (interface == SL_NET_WIFI_CLIENT_2_INTERFACE) {
            status = sl_si91x_configure_ip_address(&wifi_client_profile.ip, SL_WIFI_CLIENT_VAP_ID_1);
        } else {
            status = sl_si91x_configure_ip_address(&wifi_client_profile.ip, SL_WIFI_CLIENT_VAP_ID);
        }
        if (status != SL_STATUS_OK) {
            sl_status_t v4_reason = SL_STATUS_OK, v6_reason = SL_STATUS_OK;
            char fw_ver[24] = { 0 };
            sl_wifi_get_ip_config_failure_reason(&v4_reason, &v6_reason);
            wifi_get_running_version(fw_ver, sizeof(fw_ver));
            LOG_DRV_ERROR("Client ip configure failed: 0x%0lX (v4 raw 0x%lX, v6 raw 0x%lX, %lu ms) fw %s\r\n",
                          status, v4_reason, v6_reason,
                          (unsigned long)(osKernelGetTickCount() - ip_cfg_start),
                          fw_ver);
            sl_wifi_disconnect(SL_WIFI_CLIENT_INTERFACE);
            return status;
        }
    }
#endif

    err = sl_net_set_client_link_up(&wifi_client_profile);
    if (err != ERR_OK) {
        sl_wifi_disconnect(SL_WIFI_CLIENT_INTERFACE);
        LOG_DRV_ERROR("Failed to set client link up: %d\r\n", err);
        return err;
    }
#if LWIP_IPV4 && LWIP_IPV6
    if ((wifi_client_profile.ip.type & SL_IPV4) == SL_IPV4) {
        ip_addr_t *addr;
        // Set the IP address of v4 interface
        addr = &client_netif.ip_addr;
        memcpy(wifi_client_profile.ip.ip.v4.ip_address.bytes, &addr->u_addr.ip4.addr, sizeof(addr->u_addr.ip4.addr));

        addr = &client_netif.gw;
        memcpy(wifi_client_profile.ip.ip.v4.gateway.bytes, &addr->u_addr.ip4.addr, sizeof(addr->u_addr.ip4.addr));

        addr = &client_netif.netmask;
        memcpy(wifi_client_profile.ip.ip.v4.netmask.bytes, &addr->u_addr.ip4.addr, sizeof(addr->u_addr.ip4.addr));
    }

    if ((wifi_client_profile.ip.type & SL_IPV6) == SL_IPV6) {
        // Set the IP address of v6 interface
        // Loop through the first 4 elements of the IPv6 address arrays to convert and assign them to the profile structure
        for (int i = 0; i < 4; i++) {
            wifi_client_profile.ip.ip.v6.link_local_address.value[i] = ntohl(client_netif.ip6_addr[0].u_addr.ip6.addr[i]);
            wifi_client_profile.ip.ip.v6.global_address.value[i]     = ntohl(client_netif.ip6_addr[1].u_addr.ip6.addr[i]);
            wifi_client_profile.ip.ip.v6.gateway.value[i]            = ntohl(client_netif.ip6_addr[2].u_addr.ip6.addr[i]);
        }
    }
#else /* LWIP_IPV4 && LWIP_IPV6 */
#if LWIP_IPV4
    u32_t *addr;

    addr = &client_netif.ip_addr.addr;
    memcpy(wifi_client_profile.ip.ip.v4.ip_address.bytes, addr, sizeof(*addr));

    addr = &client_netif.gw.addr;
    memcpy(wifi_client_profile.ip.ip.v4.gateway.bytes, addr, sizeof(*addr));

    addr = &client_netif.netmask.addr;
    memcpy(wifi_client_profile.ip.ip.v4.netmask.bytes, addr, sizeof(*addr));
#elif LWIP_IPV6
    // Loop through the first 4 elements of the IPv6 address arrays to convert and assign them to the profile structure
    for (int i = 0; i < 4; i++) {
        wifi_client_profile.ip.ip.v6.link_local_address.value[i] = ntohl(client_netif.ip6_addr[0].addr[i]);
        wifi_client_profile.ip.ip.v6.global_address.value[i]     = ntohl(client_netif.ip6_addr[1].addr[i]);
        wifi_client_profile.ip.ip.v6.gateway.value[i]            = ntohl(client_netif.ip6_addr[2].addr[i]);
    }
#endif /* LWIP_IPV6 */
#endif /* LWIP_IPV4 && LWIP_IPV6 */
    // Set the client profile
    status = sl_net_set_profile(SL_NET_WIFI_CLIENT_INTERFACE, profile_id, &wifi_client_profile);

    return status;
}
/// @brief Deactivate client link
static void sl_net_set_client_link_down(void)
{
#if LWIP_IPV4 && LWIP_DHCP
    (void)netifapi_dhcp_stop(&client_netif);
#endif /* LWIP_IPV4 && LWIP_DHCP */
    netifapi_netif_set_link_down(&client_netif);
    netifapi_netif_set_down(&client_netif);
}
/// @brief Client network interface deactivation provided for SL SDK calls
sl_status_t sl_net_wifi_client_down(sl_net_interface_t interface)
{
    sl_status_t status;

    UNUSED_PARAMETER(interface);
    sl_net_set_client_link_down();

    status = sl_wifi_disconnect(SL_WIFI_CLIENT_INTERFACE);
    if (status == SL_STATUS_SI91X_UNASSOCIATED || status == SL_STATUS_WIFI_INTERFACE_NOT_UP) {
        return SL_STATUS_OK;
    }
    return status;
}
/// @brief Client network interface initialization function provided externally
/// @param None
/// @return Error code
int sl_net_client_netif_init(void)
{
    // uint8_t init_try_times = 0;
    struct netif *wl0 = NULL;
#if LWIP_IPV4
    ip_addr_t sta_ipaddr;
    ip_addr_t sta_netmask;
    ip_addr_t sta_gw;

    /* Initialize the Station information */
    ip_addr_set_zero_ip4(&sta_ipaddr);
    ip_addr_set_zero_ip4(&sta_netmask);
    ip_addr_set_zero_ip4(&sta_gw);
#endif /* LWIP_IPV4 */
    sl_status_t status;

    wl0 = netif_get_by_index(client_netif.num + 1);
    if (wl0 != NULL && wl0 == &client_netif) return SL_STATUS_INVALID_STATE;

    // Factory-burned MAC rides the boot config (applied once by whichever
    // interface runs sl_net_init first).
    sl_net_apply_factory_mac();

    // do {
        status = sl_net_init(SL_NET_WIFI_CLIENT_INTERFACE, &device_configuration, NULL, NULL);
    // } while (status != SL_STATUS_OK && init_try_times++ < 3);
    if (status != SL_STATUS_OK && status != SL_STATUS_ALREADY_INITIALIZED) {
        if (netif_get_by_index(ap_netif.num + 1) != &ap_netif) {
            sl_net_deinit(SL_NET_WIFI_CLIENT_INTERFACE);
        }
        LOG_DRV_ERROR("Failed to init Wi-Fi Client interface: 0x%lX\r\n", status);
        return status;
    }

#if IS_SELF_DHCP_SERVER
    if (!sl_net_fw_dhcps_check_skip) {
        status = sl_net_fw_dhcps_compat_check(SL_NET_WIFI_CLIENT_INTERFACE);
        if (status != SL_STATUS_OK) {
            if (netif_get_by_index(ap_netif.num + 1) != &ap_netif) {
                sl_net_deinit(SL_NET_WIFI_CLIENT_INTERFACE);
            }
            return status;
        }
    }
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
