camthink-ai/ne302/(commit log)

2026-05-06 feat: add scheduled interval timer mode and fix webhook push service
    - Add scheduled interval mode for timer trigger with start_time,
    supporting continuous 24-hour cycle that wraps past midnight
    - Fix scheduler deadlock by adding register_wakeup_ex_locked() for
    use within callbacks that already hold the scheduler mutex
    - Fix linked list corruption in process_wakeup_jobs() by removing
    REPEAT_ONCE jobs from list before invoking their callback
    - Fix webhook queue creation failure (ThreadX limits queue messages
    to 16 ULONGs) by passing heap-allocated pointers through the queue
    - Fix double-free in system_service by transferring jpeg_buffer
    ownership to webhook on successful enqueue
    - U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
    [aicam_types.h]
2026-05-13 fix: FSBL version verify, 200MHz capture clocks, quick-capture AI to SD, WiFi option paths
    - FSBL: Call verify_fsbl_version(FSBL_VERSION_STRING) after init_system_state so boot/FSBL version can be read and verified.
    - SYSCLK: Adjust PLL1 and AHB / IC1 / IC6 / IC11 dividers for HSE_200MHz; sync PLL3 documentation. Fixes corrupted snapshots above 720p on the 200 MHz profile.
    - Quick capture: Default AI enabled in quick_storage (match application behavior); register codec in driver_core so AI result images and JSON can be written to SD.
    - Si91x: Add optional debug markers on firmware-load vs normal branches in sli_wifi_select_option to analyze intermittent WiFi issues on wake capture.
    - Mis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
    [boot.c, driver_core.c, sysclk.c, sysclk.h]
2026-05-14 feat: ISP profile mode, FSBL sys-clock API, and web hardware tooling
    - Persist image_config.isp_mode (NVS/JSON) and expose via device image/config API; apply indoor/outdoor/custom in device_service and camera pipeline.
    - Extend quick bootstrap snapshot/storage for isp_mode and IQ preset fill helpers.
    - Add GET/POST /api/v1/device/sys-clk/config for FSBL CPU clock profile (reboot to apply).
    - Register ISP config export/import routes; adjust isp_param_conf presets.
    - Web: hardware management + device tool UI, API client, i18n; align Web package and WEB_VERSION_OVERRIDE to 1.3.4.7.
    [api_device_module.c, device_service.c, device_service.h, isp_param_conf.h, quick_snapshot.c]
2026-05-18 fix: resolve scheduled interval timer start_time=0 bug and TLS SNI missing issue
    - Remove `start_time > 0` check in scheduled interval timer callback
    and next-capture-time calculation. start_time=0 (midnight) is a valid
    value that was incorrectly excluded, causing wrong next capture time.
    - Always call mbedtls_ssl_set_hostname() for TLS connections regardless
    of hostname verification setting. Modern servers require SNI extension
    to select the correct certificate; without it the handshake fails
    with a fatal alert (error -19968).
    [ms_network.c]
2026-05-18 fix: resolve RTSP port bind failure, config hot-reload, and webhook wake-up issues
    - Enable SO_REUSE in lwIP to allow immediate port rebinding after stop/restart
    (fixes bind failure on port 554 caused by TIME_WAIT PCBs)
    - Patch lwIP sockets.c select_waiting assertion to reset instead of assert,
    preventing crashes in multi-threaded socket operations
    - Rewrite RTSP service stop/start lifecycle to eliminate double-close bugs:
    server task sets fd to -1 before close, stop function only closes remaining fds
    - Add runtime config change detection in RTSP API: port/auth changes auto-restart
    the service without manual toggle
    - Return actual password from RTSP config GET endpoint instead of mas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
2026-05-18 fix: enforce RTSP auth on all methods and fix webhook wake-up race condition
    RTSP: Add digest auth checks to SETUP/PLAY/TEARDOWN handlers.
    Previously only DESCRIBE required auth, allowing unauthenticated
    streaming by skipping directly to SETUP.
    Webhook: Fix race condition where wait_pending returned immediately
    because the push task consumed the queue message before setting
    push_in_progress=TRUE. Now push_in_progress is set by push_capture
    before enqueuing, ensuring wait_pending blocks until HTTP POST
    completes. Add network readiness wait (10s) for post-wake-up pushes.
    Low power: Mark webhook service as required_in_low_power so it
    starts during button/PIR/RTC wake-up alongside MQTT.
    [api_device_module.c]
2026-05-18 refactor: remove NVS cache layer for direct flash read/write
    Replace all storage_nvs_write_cached/read_cached calls with direct
    storage_nvs_write/read. Remove LRU cache (32 entries), background
    sync thread, and periodic flush timer. NVS writes are now immediately
    persistent, eliminating dirty-data-loss risk on power failure.
    [device_service.c]
2026-05-22 feat: add stream tab preference and fix upload result tracking
    - Add GET/POST /api/v1/device/preference/stream_tab API to persist
    user's preferred stream tab (rtmp/rtsp) across page reloads
    - Fix capture upload result: webhook success now correctly sets
    upload_result=OK and MQTT puback failure only marks error when
    no other upload path succeeded
    - Update graphics management and RTMP config frontend pages
    [api_device_module.c]
2026-05-25 ci: add pack-to-hex step to GitHub Actions build workflow
    Generate combined HEX file after make pkg for STM32CubeProgrammer
    one-click flash. Upload hex artifact and include in releases.
2026-05-25 fix: resolve OTA upgrade system hang caused by XSPI I-cache eviction and service conflicts
    OTA firmware upgrade caused system hang due to multiple issues:
    1. I-cache eviction crash: During XSPI flash erase, memory-mapped mode is disabled
    and CPU fetches instructions from I-cache. When osDelay() yields to other tasks,
    they evict the erase loop from I-cache, causing CPU fault on re-entry.
    Fix: Lock ThreadX preemption during MM-disabled phase for large erases (>=128 blocks),
    with brief 1ms unlock windows between batches for TCP keepalive.
    2. Camera/AI XSPI contention: Camera DMA and AI inference access XSPI flash concurrently
    with OTA erase operations, causing XSPI errors that tr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
    [api_ota_module.c]
2026-05-27 refactor: improve tooltip accessibility and fix ui layout issues
    Replace tooltip trigger div with button element and add aria-label.
    Fix TooltipTrigger container and adjust flex layout in graphics page.
    Clean up inconsistent indentation in trigger-config callbacks.
2026-05-28 fix(nn): lock flash during model pointer access
    Wrap flash-mapped reads/parsing/validation and reloc install with storage_lock/unlock to prevent system stalls when flash is accessed concurrently during model load.
2026-05-28 fix(wakecore): correct standby wakeup flag check and prep stop2
    Fix incorrect bitwise assignment in wakeup flag handling, move UART deinit/IRQ disable earlier in stop2 entry, and bump wakecore version.
    [pwr_manager.c, sys_config.h]
2026-05-28 docs: add verification results to Model/README.md postprocess tables
    Add Verification column with device test results for 7 verified models.
    Add missing pp_od_yolo_v11_uf row (yolo11n). Remove emoji headers.
2026-05-28 fix: correct model JSON configs for verified models
    - ui models: fix output_spec.scale (1.0→0.003921569, 0.0→0.0078125)
    - lower confidence_threshold 0.5/0.6→0.25 for better recall
    - od_meter: lower iou_threshold 0.45→0.3 for digit detection
2026-06-01 feat: add YOLO model weights for inference -已验证
2026-06-01 feat(comm): add halow network support
    - Add HALOW icon and network components
    - Enhance device info with HALOW status
    - Add HALOW API documentation
    - Update i18n for HALOW features
2026-06-01 feat(comm): enhance device info with halow support
    - Update device info to show HALOW status
    - Add HALOW translations to i18n files
    - Link HALOW icon to system settings
2026-06-01 feat(image): add ISP grayscale mode with reboot-to-apply
    Persist grayscale in NVS/JSON/API and Web UI; apply via ISP luma matrix while keeping PIPE1 RGB565. Align Quick Bootstrap fast capture with device_service ISP IQ path. isp_mode and grayscale only save at runtime until reboot or wake; add Web reboot toasts for sys clk, ISP mode, and capture settings.
    [api_device_module.c, device_service.c, quick_snapshot.c]
2026-06-02 Fix: select BCF by regdomain and expose metadata
    Use regulatory_db_domains for HaLow regdomain support/listing, select FCC/CE BCF blob by country code at boot, and add ifconfig hw bcf_info to print BCF metadata.
    [mm_halow_netif.c]
2026-06-02 Add Instance Segmentation (ISEG) support with YOLOv8 model integration
    - Implemented ISEG post-processing in `pp_iseg_yolo_v8_ui.c` to handle raw logits and apply sigmoid for probability filtering.
    - Enhanced drawing service to support ISEG results, including configuration and rendering of masks.
    - Updated AI drawing configuration to include parameters for ISEG visualization.
    - Added JSON serialization for ISEG detection results in `nn.c`.
    - Modified neural network handling to support int8 input conversion for ISEG models.
    - Updated model weights JSON to reflect changes in output dimensions and confidence thresholds.
    - Introduced new TFLite model file for YOLOv8 Nano ISEG.
2026-06-03 feat(halow): add halow integration and improve wake init reliability
    Wire HaLow through config/NVS, comm service, REST API, and web UI.
    BSSID persistence; scan-before-connect on boot; direct connect on wakeup/Web.
    Harden scan/region, HaLow/4G exclusion, and power-on retry after sleep.
2026-06-04 feat(halow): pka crypto offload, ip config persistence, web ui
    - offload mbedtls ecdh/ecdsa/ecp to stm32 pka for wpa performance
    - persist and apply halow dhcp/static ip, country, and quick-join bssid
    - expose comm selection mode and halow network apis; update web settings
2026-06-05 feat(light): add fill light test switch and fix pwm brightness scaling
    Add a web test toggle to control the fill light from hardware management.
    Apply brightness changes in real time while testing.
    Pass 0-100 brightness directly to pwm duty.
    [device_service.c, quick_snapshot.c]
2026-06-05 feat: add auto fill light mode with ambient sensor support
    Implement sensor-based AUTO fill light during capture.
    Expose light threshold and ambient brightness via API.
    Update web UI with four modes, test switch, and tooltip.
2026-06-08 feat(halow): support extended regdomain country codes end-to-end
    Align mmregdb, driver, API, and web region UI with AU_2020/AU_2024/AU_REVMF
    codes and 16-byte regdomain buffers. Fix locale-aware region labels and
    extend HaLow link/MQTT ready timeouts for slower network bring-up.
    [mm_halow_netif.c, netif_manager.h]
2026-06-08 feat: add usb1 cdc virtual console with uart fallback
    Implement USBX CDC ACM on USB1 to serve log and CLI after boot, preferring
    USB when configured and falling back to UART on I/O failure or disconnect.
    Include transfer timeouts, pipe abort on deactivate, and shared USBX memory
    for coexistence with USB2 host stack.
    [console.c, debug.c, debug.h, main.c, usbx_host.c, usbx_platform.c]
2026-06-09 feat(halow): quick connect, runtime radio sync, and reconnect ip fix
    Add saved-network quick connect and scan-before-connect when switching to HaLow.
    Persist tx power, scan dwell, and rate override to NVS and apply them at runtime.
    Poll scan completion in the Web UI, resolve scan conflicts on comm switch, and
    sync IP config to mmipal when saving while disconnected or reconnecting.
    [mm_halow_netif.c, netif_manager.h]
2026-06-23 feat(xspi): auto-adaptive dual-chip nor flash driver (mx66 + gd55)
    Replace single-chip xspim driver with auto-detection that identifies
    the connected NOR Flash (Macronix MX66UM1G45G OctaBus or GigaDevice
    GD55LX01GE JEDEC Xccela) at boot via JEDEC 0x9F Read ID, then selects
    the correct OPI protocol for all subsequent operations.
    Key changes:
    - xspim.h: add MX66 macros, chip-type enum, READ_ID_CMD, detection API
    - xspim.c: DetectChip() reads MFI via SPI 0x9F; all OPI functions branch
    on xspi_nor_chip for InstructionWidth/DTRMode/commands/dummy cycles
    - FSBL main.c: XSPI_NOR_ResetAndDeInit() after NOR use — sends chip-
    specific OPI software reset (GD55: 66h/99h STR; MX66: 0x6699/0x9966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
    [main.c, main.h]
2026-06-23 feat(mem_map): move app to psram, reorganize flash partitions
    Major memory-map rework to support GD25LX512ME (64MB) alongside
    GD55LX01GE (128MB):
    Memory layout:
    - Move APP image from internal SRAM (0x3400_0000) to external PSRAM
    (0x9000_0000), expanding APP from 1664K to 4095K; SRAM repurposed
    as SRAM_POOL (1736K)
    - Reduce UNCACHED region from 384K to 312K to match new boundaries
    - Remove PSRAM_SWAP (was at 0x903F_0000), relocate SWAP into
    PSRAM_REGION
    Flash partitions (NOR):
    - Collapse AI model slots from 4 (AI_DEFAULT 5M + AI_1 5M + AI_2 5M
    + AI_3 8M) into 2 larger slots (AI_1 8M + AI_2 8M)
    - Renumber FIRMWARE enum: drop FIRMWARE_DEFAULT_AI, shift AI_1→AI_2
    - Move WEB to 0x7190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
    [api_device_module.c, api_ota_module.c, cli_cmd.c, device_service.c, main.c, quick_snapshot.c]
2026-06-25 fix: improve debug output, error diagnostics, and flash driver
    - Error_Handler: wrap with macro to print file/line before halting;
    comment out extern declarations replaced by the macro
    - debug/log: replace blocking HAL_UART_Transmit (~0 timeout) with
    printf-based output throughout debug.c; reduce UART timeout to
    200ms in console _write; comment out custom printf/vprintf/puts
    in mm_logging (now using toolchain stdio) and disable mmhal_log_write
    UART output
    - main: detect and log IWDG (watchdog) reset cause on startup
    - xspim: fix GD55 read-status command missing AddressMode =
    HAL_XSPI_ADDRESS_NONE; switch header include from main.h to
    stm32n6xx_hal.h, add main.h to source
    - libm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
    [console.c, debug.c, main.c, main.h]
2026-06-25 feat(file): add web-based file management for flash and sd storage
    - Add generic file operations with mkdir support
    - Add LittleFS and SD directory creation APIs
    - Introduce file management REST APIs (list/upload/download/edit/delete)
    - Add storage information for Flash filesystem
    - Implement file browser UI with preview, edit, upload and download
    - Support Flash and SD browsing in storage management page
    - Fix XSPI_NOR unmapped-mode leak during prog/erase
    - Improve readdir/stat implementations
    - Add i18n strings and modal-based file browser
    [api_device_module.c, cli_cmd.c, device_service.c, device_service.h]
2026-06-25 fix(netif): make halow compile-optional; fix modem init and power mgr
    - netif_manager.h, mm_halow_netif.h: de-guard halow macros and DPP types,
    add static inline stubs so NETIF_WIFI_HALOW_IS_ENABLE=0 compiles
    - communication_service: remove halow dependency from comm_nvs_to_comm_type
    guards; set cellular_first=TRUE when halow disabled so 4G still starts
    - mm_halow_netif.c: add GPIO deinit during stack teardown
    - ms_modem: force power cycle (off→delay→on) at init; log CME errors;
    increase QNWINFO timeout to 1s
    - power_manager: tolerate release with ref_count already 0
    [mm_halow_netif.c, netif_manager.h]
2026-06-26 feat(modem): add manual plmn code setting for 4g operator selection
    - Set PLMN → AT+COPS=1,2,"<PLMN>"; empty → AT+COPS=0 (auto)
    - PLMN change triggers CFUN restart to properly switch modes
    - modem_device_get_operator matches from configured PLMN directly
    - Persist via NVS, expose through API and Web UI
2026-06-30 fix(video): resolve black preview after model upload by invalidating … (#28)
    * fix(video): resolve black preview after model upload by invalidating stale SPS/PPS cache
    Root cause: Video Hub cached SPS/PPS only once (sps_pps_valid set TRUE,
    never reset). When a model reload rebuilds the encoder session, the Hub
    kept serving stale SPS/PPS to the reconnecting MSE player, causing a
    codec mismatch and permanent black preview.
    Fix 1: Add video_hub_invalidate_sps_pps() and call it in
    ai_pipeline_stop() so the next keyframe re-extracts fresh SPS/PPS from
    the rebuilt encoder session and re-delivers them to subscribers.
    Fix 2: ai_reload_model() now conditionally restarts the AI pipeline
    (only whe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
2026-07-01 chore: update web version to 1.3.4.8 and enhance video playback stability
    - Updated WEB_VERSION_OVERRIDE in version.mk and package.json to 1.3.4.8.
    - Introduced new constants for frame timing in constant.ts to improve video playback performance.
    - Refactored h264Player.ts to streamline video stream restart logic and enhance error handling.
    - Added live preview synchronization and playback recovery mechanisms in media.ts to reduce latency and improve user experience.
    - Updated videoWorker.ts to ensure proper handling of video data formats.
    - Modified deviceTool index.tsx to remount the video player after model uploads for a clean state.
2026-07-03 feat(capture): add capture-upload pipeline with web ui and scheduling
    Add a complete capture-upload system with date-partitioned storage,
    multiple upload modes (instant/batch/scheduled/local-only), and a web
    management interface.
    Upload coordinator:
    - Date-partitioned record storage (/captures/<state>/<date>/cap_<ts>_<seq>)
    - MQTT batch-publish pipeline + webhook support
    - WRAP/STOP storage policies with automatic cleanup
    - Retry with configurable max attempts
    - RAM-only seq counter (no per-capture NVS wear)
    Wake scheduling:
    - Merged capture + upload-flush scheduler with alarm override
    - Single-netif wake optimization (only init configured upload netif)
    - Network fail-fast (SERVICE_READY_N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
    [api_device_module.c, debug.c, device_service.c, device_service.h, driver_core.c, main.c, mm_halow_netif.c]
2026-07-04 Add SPE result handling and an overlay_results gate for clean encoded output (#31)
    * Add SPE (single-pose estimation) result handling
    Custom pp_spe_movenet models load and run, but their output is dropped:
    nn_create_ai_result_json() serializes only OD/MPE/ISEG, so SPE results
    (PP_TYPE_SPE) produce an empty poses[] array, and the ai_draw_service
    result switch logs 'Unsupported AI result type: 6' without drawing.
    Rather than duplicating the MPE code paths, the shared parts are factored
    out and reused by both:
    - pp.h: spe_keypoint_t becomes a typedef of the identical keypoint_t
    - nn.c: serialize the SPE pose under poses[] (single instance, no
    bounding box - SPE is detector-free) reusing cr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
2026-07-07 Add metadata-only MQTT report mode (#32)
    * Add metadata-only MQTT report mode
    Add a persisted report_content config (full | metadata_only) to the MQTT
    service and route the capture/report flow accordingly. In metadata_only
    mode the report publishes metadata + AI result as JSON on the data report
    topic via mqtt_service_publish_ai_result(), skipping the base64 image
    encode and the image payload (roughly KB-scale instead of ~66 KB per
    report at 720p). Images remain available on demand over HTTP. Default is
    full; stock behavior is unchanged.
    - report_content persists like the other extended MQTT config fields
    (NVS key mqtt_rpt_ct, missing-key fallback write, JSON config
    import/export) and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
2026-07-07 Add configurable inference cadence and continuous AI-result telemetry (#33)
    * Add configurable inference cadence and continuous AI-result telemetry
    Adds two capabilities to the AI service:
    1. inference_interval_ms (ai/params; 0 = every frame, or any positive ms) paces
    AI-node inference via a sliced sleep in the process callback, applied before
    the pipe2 fetch and anchored to the inference attempt so inference errors keep
    cadence. Persisted through the ai_debug config chain (NVS ai_infer_iv) and
    seeded in both AI config factories so it survives reboot and pipeline re-init.
    The request value is range-checked (0..UINT32_MAX) at the API before the
    uint32 cast.
    2. Continuous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
2026-07-08 Add a compact CBOR format option for AI-result telemetry (#34)
    * Add a compact CBOR format option for AI-result telemetry
    Adds telemetry_format to mqtt/config: "json" (default, existing payload
    unchanged) or "cbor" (RFC 8949 compact binary).
    - Custom/Common/Lib/cbor/cbor_enc.{c,h}: encode-only CBOR writer
    (definite-length maps/arrays, text, uint, null, IEEE 754 half floats;
    bounds-checked with a sticky overflow flag; no dependencies).
    - nn_encode_ai_result_cbor (Custom/Hal/nn.c, beside
    nn_create_ai_result_json): kind-generic result encoder for
    OD/MPE/SPE/ISEG, unknown kinds -> {"type": N}. Values clamped to [0,1]
    and written as half floats; class names truncated on UTF-8 boundari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
2026-07-09 chore(release): bump to v2.3.0 (fsbl 1.0.3, web 1.5.0)
    Bundle of feature/fix work for the 2.3.0 release.
    Web recovery mode:
    - add built-in recovery page (web_recovery) served when the web asset
    firmware fails to load, so a missing/moved web partition no longer
    bricks the web UI; user can reflash web firmware from the page
    - reload web assets from flash after a successful web OTA so the new UI
    is live without a reboot
    Low-power wake path:
    - skip web_service init on low-power essential-only wakes (RTC/PIR/
    button-short/...) via a new skip_init_in_low_power flag, so the ~88KB
    web asset.bin load no longer runs on capture-only wakes (start was
    already gated); tolerate the resulting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
    [api_device_module.c, api_ota_module.c, debug.c, device_service.c, device_service.h, driver_core.c, netif_manager.h]
2026-07-09 fix(halow): address pr #35 review findings; route wifi pool via hal_mem
    PR #35 (Gemini Code Assist) review fixes:
    - sl_utility.c: reject non-hex/non-colon chars in inet_pton6 instead of
    silently skipping them (invalid IPv6 accepted as valid)
    - sl_si91x_socket_utility.h: fully parenthesize SLI_GET_SAFE_MEMCPY_LENGTH
    - pka_p256_alt.c: NULL-check params in ECDH/ECDSA entry points
    - crc.c: use __HAL_CRC_DR_RESET so POLYSIZE/REV_IN/REV_OUT bits survive
    - spi.c: SPI6 prescaler DIV2 -> DIV8 to match the HAL HaLow path comment
    - stm32n6xx_it.c: clarify why EXTI15_IRQHandler stays disabled (owned by
    mmhal_wlan.c MM_HALOW_BUSY_IRQ_HANDLER)
    Route SDK memory through the global hal_mem allocator:
    -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
    [spi.c]
2026-07-10 chore(crypto): drop unused si91x psa crypto; tidy mbedtls pka port
    Remove the unused si91x PSA crypto component tree (aead/aes/ccm/ecdh/
    ecdsa/gcm/hmac/sha/trng/wrap/attestation/multithread/crypto_utility).
    This project uses MbedTLS with the STM32 PKA port, not the Si91x PSA
    crypto driver, so the ~10k lines were dead code.
    MbedTLS PKA port fixes:
    - pka_p256_alt.c: pka_session_end() now early-returns when nothing was
    locked, so it no longer DeInits/disables the PKA clock or calls
    pka_hw_unlock() for a session it never acquired
    - ecp_alt.c: flatten the Q->Z check in mbedtls_internal_ecp_add_mixed
    main.h: wrap Error_Handler() in do { } while(0) for macro hygiene.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
    [main.h]
2026-07-10 revert(netif): re-enable halow netif
    Set NETIF_WIFI_HALOW_IS_ENABLE back to 1.
    [netif_manager.h]
2026-07-13 fix(storage): decouple file_ops registration from lfs mount
    - Register file_ops synchronously in storage_init() instead of after
    lfs_mem_init in the storage thread, so the filesystem handle is
    available immediately — removes lfs mount delay from the fast-
    capture critical path.
    - Add lfs_sem_id semaphore: storageProcess releases it after mount;
    storage_lfs_isready() blocks callers (3s timeout) until mount is
    done, guarding all lfs vfs operations (open/stat/mkdir/remove).
    - Lower storage task priority from Normal to BelowNormal so it yields
    to time-sensitive tasks.
    - xspim: fall back to MX66 chip type on unknown NOR detection instead
    of Error_Handler, for backward compatibilit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
2026-07-14 feat(wifi, ota): add wifi firmware ota, version check, and upgrade ui
    Backend (C):
    - Add WIFI fw_type (0x08) to OTA header/packer/upgrade_manager
    - WiFi flash layout: flash_header_t (32B) + .rps, OTA header for web verify only
    - Streaming OTA: skip OTA header write for WiFi (like FSBL), write to WIFI_FW_BASE
    - upgrade-local handler: set wifi_mode=update on confirm (not during upload)
    - wifi_get_running_version(): query SiWG917 chip firmware version
    - wifi_get_flash_version(): read .rps binary header from flash (no chip needed)
    - wifi_mark_update_pending(): NVS flag without reset, for OTA confirm flow
    - firmware-versions API: return wifi, wifi_running, expected_fsbl, expected_wifi
    - version-c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
    [api_device_module.c, api_ota_module.c, main.c, sl_net_netif.c, u0_module.c]
2026-07-15 fix(capture, jpegc): jpeg buffer aliasing and missing ai upload
    jpegc SET_ENC_PARAM always reuses old enc_output_buffer when capacity is
    sufficient, causing consecutive JPEG encodes (original then AI-overlay) to
    write to the same buffer. The second encode overwrites the first, so both
    the original and inference JPEGs point to identical data.
    Fix: SET_ENC_PARAM now always drops jpegc reference to the previous encode
    buffer (without freeing, since OUTPUT_ENC_BUFFER caller owns it) and
    allocates a new buffer. Also remove double osMutexRelease in OUTPUT paths.
    Also fix: upload_coordinator's upload paths all passed NULL for
    mqtt_ai_result_t, so AI results never appeared in MQTT/webhook payloads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
2026-07-16 docs: rewrite readme and update hardware assets for ne302
    [x3_d_cover.stp, x3_m_cover.stp, x3_top_cover.stp]
2026-07-16 fix(netif): handle eth_wan default and halow init with no cellular
    [netif_manager.h]
2026-07-16 chore: disable optional netifs and revert docker refs
    - Disable ETH_WAN, 4G_CAT1, USB_ECM, and WIFI_HALOW in netif_manager.h
    - Revert CI and model docs docker image references to ne301-dev
    [netif_manager.h]
2026-07-16 chore: rename remaining project refs from ne301 to ne302
    - mmx108 lib: update build flags, comments, and copyright headers
    - mqtt_service: fix telemetry topic prefix
    - Makefile: fix wifi firmware description and package name
    - pack_to_hex.py: fix web and wifi binary patterns
    - Web: fix wiki link in action buttons
    [netif_manager.h]
2026-07-16 docs: add v2.3.0 changelog and ota update guide (cn/en)
    Add bilingual documentation (Chinese/English) for the v2.3.0 release:
    - Change log detailing all changes since v2.1.0 (0198d97)
    - OTA upgrade guide with step-by-step instructions for upgrading
    from v2.1.0 to v2.3.0 due to flash partition table changes
    - Both documents include language switch links between cn/en versions
    - Screenshot placeholders for all OTA guide steps
2026-07-17 feat: unify STEdgeAI 2.2/3.0/4.0 runtime selection at build time (#29)
    Consolidate NPU runtime variants into a single branch with STEDGEAI_VARIANT (default 4.0). Vendor stedgeai-lib-2.2/3.0/4.0, add stedgeai.mk for lib paths and model versioning, and wire Appli/Model/CI/Docker to the selected toolchain.
    - Add build-time toolchain check and stedgeai-use.sh for local variant switching
    - Extend CI/Docker to build matrix images (v2.2/v3.0/v4.0) and default firmware to 4.0
    - Fix version_header.py UTF-8 reads on Windows and 2.2 npu_cache init/MSP for boot stability
2026-07-17 fix(usb_cdc): reduce priority to fix resource contention at boot
    USB CDC initialization was consuming too many CPU resources during early
    boot, causing two issues:
    - Snapshot pipe1 and pipe2 frame IDs desynchronization
    - STA (Wi-Fi station) network initialization probabilistic failure
    Changes:
    - Move debug_switch_to_usb_cdc() to after service_init (Step 5)
    - Lower main task priority to osPriorityLow before USB CDC switch,
    restore original priority after completion
    - Reduce usbCdcRx task priority from osPriorityAboveNormal to osPriorityLow
    - Suppress UART output during USB CDC switch (UART may be unavailable)
    - Fix quick_snapshot log macro: QB_LOGW -> LOG_WARN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
    [debug.c, main.c, quick_snapshot.c]
2026-07-17 fix(build): incremental build — version header dependency tracking
    Stop regenerating version headers on every build and remove transitive
    version.h includes that caused 9 .c files to recompile unnecessarily.
    - Generate Custom/Hal/stedgeai_version.h via Python (like fsbl_version.h/
    version.h) instead of -D flag; nn.h now includes it so -MMD tracks
    MODEL_STEDGEAI_VERSION_SUPPORTED changes correctly.
    - Add write_if_changed() to version_header.py: only overwrite generated
    headers when content actually differs, preserving file timestamps.
    - Remove #include "version.h" from core_init.h and json_config_internal.h.
    These pulled version.h into 9 .c files that do not use any FW_VERSION_*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
    [api_ota_module.c]
2026-07-21 feat(flash): format from file-browser, enforce record-count cap
    - web: format-flash button in file-browser toolbar with password confirmation
    - web: verifyPassword() API (skipErrorToast) for silent auth checks
    - web: i18n for format-ui (zh + en), fix {max} placeholder interpolation
    - upload: per-capture FLASH_MAX_RECORDS enforcement via count_all_records()
    - upload: INSTANT fallback to direct_publish on record-cap or disk-full
    - upload: cleanup empty hour/date dirs after record deletion
    - upload: tombstone-fallback for full-FS deletes; skip rebuild on FS stress
    fix: remove duplicate wait_upload_before_sleep in main sleep path
    fix(isp): move import/export buttons under ISP selector not gray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
    [main.c, quick_snapshot.c, sl_net_netif.c]
2026-07-21 chore: comment out if_mac debug print, disable pir by default
2026-07-21 fix(ap): prevent double-up by moving bring-up into init callback
    - disable auto_up for ap netif, defer up to on_wifi_ap_ready
    - use nm_set_netif_cfg + communication_start_interface instead of
    communication_configure_interface to avoid redundant up call
    chore(logs): add \r\n to netif timing prints, suppress nau881x i2c error
2026-07-21 perf(usb_cdc): async init, dtr-based path switch, remove dead log output
    - main.c: replace blocking debug_switch_to_usb_cdc() with async
    debug_start_usb_cdc_task() running at osPriorityLow, removing
    the priority-lowering hack that tried to work around the stall.
    - usb_cdc_console.c: do NOT enable USB output path at activate;
    switch to USB only when host asserts DTR (port open) or sends
    data. Prevents 200ms write-stall when host enumerates but
    does not open the CDC port.
    - debug.c: remove unreachable debug_uart_log_output / its
    log_add_custom_output registration. log_message() never
    iterates the custom_outputs list because no OUTPUT_CUSTOM
    entry exists in the outputs[] arr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
    [debug.c, debug.h, main.c]
2026-07-21 feat(spi6): dual-mode spi6 config, sensor-ext ci build
    - spi.c: add #if NETIF_WIFI_HALOW_IS_ENABLE blocks for MX_SPI6_Init,
    HAL_SPI_MspInit/DeInit, and ISR callbacks. Halow mode keeps existing
    bidirectional SDIO-over-SPI setup; SensorExt mode switches to TX-only
    with hardware NSS pulse for the sensor extension board (TFT, codec,
    sensors, I2C).
    - driver_core.c: relax sensor board registration guard — now only
    requires !NETIF_WIFI_HALOW_IS_ENABLE (instead of requiring all three
    netifs disabled).
    - Appli/Makefile: add C_DEFS_EXTRA placeholder so CI can inject
    -DNETIF_WIFI_HALOW_IS_ENABLE=0 at build time.
    - CI (main.yml): add Build SensorExt firmware step after the normal
    Ha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
2026-07-21 Fix path for SensorExt hex generation script
2026-07-21 Enhance workflow to include WiFi SensorExt packaging
    Added support for WiFi SensorExt hex generation in the workflow.
2026-07-22 Revert "feat(spi6): dual-mode spi6 config, sensor-ext ci build"
    This reverts commit 8b21a1be4f544e19d5e9022f0b919a44690400c9.
    [driver_core.c, spi.c]
2026-07-22 fix(driver): always register i2c_tool and sensor, reset versions
    Move i2c_tool_register() and sensor_exemple_register_commands() outside
    the NETIF conditional block so they register regardless of which network
    interface is enabled. Keep codec and tft registration gated behind
    !NETIF_WIFI_HALOW_IS_ENABLE.
    Reset all component versions (main, FSBL, Web) to 1.0.0.0 baseline.
    [driver_core.c]
2026-08-24 feat(wifi): adapt halow pin mapping and enable halow netif
    - remap SPI IRQ from PA4/EXTI4 to PG11/EXTI11, WAKE from PB2 to PA13
    - enable GPIOG clock and use MM_HALOW_*_IRQn macros for NVIC setup
    - set NETIF_WIFI_HALOW_IS_ENABLE to 1
2026-08-24 chore(web): replace device image and add small variant for sidebar
2026-08-27 fix(wifi): use internal front-end switch on ne302
    NE302 hardware has no external front-end switch device, so switch
    from ULP GPIO 4/5/0 switch pins to the internal switch.
    [sl_net_netif.c]
2026-09-08 fix(hal): adapt battery scale and light auto mode for ne302 hardware
    Battery: ne302 has no mains-power detection and the sense line measures
    the Type-C 5V rail, so full-scale 6V (NE301 battery pack) read USB power
    as ~58% mid-charge. Lower BATTERY_MAX_VOLTAGE to 5V so USB reads 100%.
    Web: the photoresistor is not exposed through the ne302 enclosure and
    cannot sense real ambient brightness — hide the light "auto" mode
    (ambient threshold) config behind LIGHT_SENSOR_UI_ENABLED=false; the
    code is kept for a future enclosure that exposes the sensor.
2026-09-08 docs: adapt vitepress site and generated api refs to ne302
    - docs site base/title/links/favicon/copyright -> ne302 (deploys to
    camthink-ai.github.io/ne302/)
    - gen_web_api_docs.py source links -> camthink-ai/ne302; regenerate all
    endpoint pages (174 endpoints / 15 modules, en+zh) which also syncs
    the device module to 24 endpoints and adds capture/file module pages
    - package name ne302-docs; README urls; ne302_App.elf in debug guide
    - ne301 references kept only where cross-model (ota changelog/model ids)
2026-09-08 docs: adapt upload config guide and changelog to ne302 hardware
    - rename Docs/NE301_v4.3.1_Upload_Config*.md -> NE302_*, fix titles
    - drop the PE9 revision-strap changelog bullet: ne302 has no strap,
    HaLow wake pin is fixed (PA13)
    - drop the fill-light pwm duty remap note: ne302 led driver needs no
    min-duty remap, duty passes through unchanged
    - vitepress docs entry: 174 endpoints / 15 modules, ne302 http api doc
    names (matches the generated reference in this repo)
2026-09-24 fix: external power reporting, halow 2.13.1 libmorse update
    Power:
    - NE302 hardware cannot distinguish USB input from battery power, so
    u0_module_get_usbin_value now always reports USB-in: the device
    shows as permanently powered instead of a meaningless battery
    percentage
    - power_supply_type renamed "full-power" -> "external_power"; HTTP
    API docs (en/zh) and web locales ("Long Power Supply"/"长供电" ->
    "External Power"/"外接供电") synced
    HaLow:
    - 2.13.1 libmorse.a updated
