camthink-ai/ne302/(notices)

Notices in the files:
Appli/Core/Src/spi.c:
Copyright (c) 2025 STMicroelectronics.
All rights reserved.
This software is licensed under terms that can be found in the LICENSE file
README.md:
License: Proprietary
